tomassasovsky/segno-hardware/hardware/kicad/README.md

<!-- cspell:words Omron -->
# Board generators

<!-- cspell:words XHP SXH -->

SKiDL scripts that emit KiCad netlists. One per board:

| script | board |
|---|---|
| `ring_board.py` | encoder + LED ring + XIAO RP2350, behind the faceplate (4-way link, #987) |
| `console_board.py` | console v3.2 — Pico 2 on the Pi's GPIO (#747); v3 adds the 4-way ring link (#987) and the CTRL ring sense; v3.1 moves MODE from GP5 to GP12 (#1388); v3.2 adds a clamp and a 1 kΩ series resistor to every footswitch input (#1391) |

The ring carrier now uses **white solder mask and black silkscreen** for LED
reflections. See [ring order and assembly notes](RING_ASSEMBLY.md) for the
September 24 hole allowances, order settings and USB programming connection.

Current console CTRL headers J20/J21 connect T / R / S / **RN** to the
Neutrik NJ6FD-V jacks; pin 4 uses ring-normal, leaving tip-normal and
sleeve-normal open. This keeps the presence pull-down off the ADC tip.
R11/R12 use the console Pico's `+3V3_PICO` supply so the AUX-powered ring
UART remains biased high while the Pi is off. See the
[connector wiring](../segno_wiring.md).

## Console connection to the screen-power board

**Revision P** removes two obsolete ground-fill exclusions beside screen-board
mounting hole H1. It retains all routes, pads and placements and uses five-pin XH plugs for all four USB touch/data cable tails.
The fifth contact terminates each shield to PCB GND, so the whole cable
disconnects with one plug. The separate drain solder pads are removed, with
local placement changes for the longer headers. The Omron power relay,
replaceable 8 A input fuse, four soldered branch fuses, AUX-powered USB coils
and independent host detection remain. The board is still two layers and
68 × 76 mm. See the [screen design and wiring](screen_power/README.md).

Use the archives identified by the
[manufacturing record](https://github.com/tomassasovsky/segno/blob/claude/segno-integration/docs/reviews/pcb-finish-all-three-1072/manufacturing-zips.json)
and its matching review evidence. Console copper is unchanged. The white
ring board retains its tracks, pads, rear ground and full-white capacity;
two small dead-end front-ground fingers have been removed. No pre-PCB prototype or additional
owner measurement is required by this change.

Use **J25**, the two-pin through-hole JST XH connector beside the Pi ribbon
connector. It is already included in the console source, routed PCB and BOM
under #1072. The top-side label reads `SCREEN`; the pin map is documented below.
PD J23, RING J6, screen-control J25 and PI PWR J9 share the same horizontal
connector row. J9 sits immediately beside the Pi ribbon connector; it carries
the floating power-button pair, not a supply rail. PWR BTN J8 remains on the
rear-panel connector row.

| Console J25 | Screen-power J2 | Signal |
| --- | --- | --- |
| Pin 1 | Pin 1 | BCM GPIO17, from Pi ribbon J2 physical pin 11 |
| Pin 2 | Pin 2 | Ground |

The connector is JST **B2B-XH-A(LF)(SN)**, 2.50 mm pitch. Use one short
two-wire 22 AWG cable with an XHP-2 housing and two SXH-001T-P0.6 contacts at
each end. Check numbered pin continuity before connecting it; cable colors
and mirrored views do not establish polarity.

The existing Pi-to-console ribbon remains direct. The dedicated AUX buck
feeds screen-power J1 separately; no screen load passes through console J3
or J25. No extra USB or power connector is needed on the console for this
interface. See the [screen-board wiring](screen_power/README.md) and
[console connector verification](https://github.com/tomassasovsky/segno/blob/claude/segno-integration/docs/reviews/console-screen-connector-1072/verification.md).
The latest [placement verification](https://github.com/tomassasovsky/segno/blob/claude/segno-integration/docs/reviews/console-pi-power-placement-1072/verification.md)
covers the PI PWR move and retained PD alignment. The subsequent
[top-label verification](https://github.com/tomassasovsky/segno/blob/claude/segno-integration/docs/reviews/console-screen-label-1072/verification.md)
covers the `SCREEN` text change and current exports.

The screen planning load is **4.25 A shared**, including both main outputs,
both touch outputs. Add 60 mA for the bleeder and 150 mA for coils/control,
for a **4.46 A** screen-board input allowance. The old 6 A expansion allowance is
retired. The 3 A main and 500 mA touch lead ceilings are not additive or
simultaneous guarantees. The selected 35-pixel ring uses a separate direct
AUX branch and does not pass through console power copper or the screen-power relay. See the
[screen-board assessment](screen_power/README.md#circuit-and-limits).

The ring's power is budgeted for **40 LEDs at unrestricted full white**, five
more than the 35 fitted. Follow the
[ring assembly guide](RING_ASSEMBLY.md): console J6 pins 3/4 carry UART only,
with cavities 1/2 empty. Supply strip power and ring J1 pins 1/2 from separate
short pairs at the near-ring AUX split; ring J2 pin 3 carries DIN only, with
pins 1/2/4 unconnected. The budget is 2.4 A for LED channels, 40 mA idle and
200 mA for the ring controller. The retained console/carrier power routes do
not replace this harness's voltage-margin requirement. Genuine XH contacts
use 22 AWG pigtails; do not crimp the 16 AWG trunk into them.
Use one external strip, or one direct-mount 24/16-LED module. A second ring is
outside this budget. See the [JST rating](https://www.jst-mfg.com/product/pdf/eng/eXH.pdf).

## Running them

```bash
python3.12 -m venv .venv && ./.venv/bin/pip install -r requirements.txt
cd hardware/kicad && ./.venv/bin/python console_board.py
```

**Run from `hardware/kicad/`.** `generate_netlist()` writes `<script>.net` into the
current working directory, so running from the repo root silently drops the netlist
in the wrong place while reporting success.

The routing pipelines finish unlocked signal bends with `round_routes.py`
after setting trace widths and before refilling copper. It uses KiCad's native
pad and track geometry to preserve connections and clearance. Locked power
routes and the screen's paired USB traces are rounded by their own generators.
Run `test_round_routes.py` with KiCad's Python to exercise the native contact,
keepout, small-radius and repeat-run regression cases without changing a board.

## Two things that will mislead you

**A netlist diff is not a design change.** SKiDL assigns a *random* `SKiDL Tag` to
every `Part` without an explicit `tag=`, and component `tstamps` derive from it. Two
runs of the **same** version on unchanged source differ by ~190 lines — all tags,
timestamps and the tool version string, with **zero** net changes. Pinning skidl does
not fix this. Judge a run by `0 errors found while running ERC` and the `(net ...)`
blocks, not by `git diff`.

**Prefer upstream footprints.** `segno.pretty/` exists for parts KiCad does not ship
(the NeoPixel Ring 24, the Same Sky ACZ11BR1E-20FD1-20C encoder, the module mount-pad and wire-pad
helpers). It is not a place to re-draw something that already exists. The Pico 2, for instance, is KiCad's own
`Module:RaspberryPi_Pico_Common_THT` — its description explicitly says it supports
Pico 2, and it is maintained upstream.
