tomassasovsky/segno-hardware/hardware/kicad/screen_power/models/README.md

<!-- cspell:words Fuseholder IRLZ NPBF Omron Schurter -->
<!-- cspell:words EEUFR DPDT AXICOM dshapes -->
# Screen-power assembly models

Each populated footprint uses a project-relative STEP model. F1's model
combines the holder and removable cartridge; both are separately listed in
the purchasing BOM. M3 holes have no separate body.
Screws, mating plugs, wire bends and the enclosure are not included.

## Custom models

These eight models are generated by `model_geometry.py` with CadQuery 2.8.
They are simplified original assembly geometry under the repository's
CERN-OHL-S-2.0 licence, not manufacturer CAD. Dimensions are nominal unless marked
maximum. Use the linked drawings and the checked footprint dimensions for
mechanical qualification; a realistic preview does not prove insertion fit.

| File stem | Geometry represented | Source |
| --- | --- | --- |
| Relay_DPDT_AXICOM_IMSeries_Pitch5.08mm | 10 × 6 × 5.65 mm seated envelope; 0.25 mm standoff; eight 0.4 × 0.2 mm leads; 5.08 mm row spacing | [TE IM02TS, drawing 1462037-4](https://www.te.com/en/product-1-1462037-3.html) |
| Relay_Omron_G6C-1117P-US | Maximum 20 × 15 × 10 mm body; 0.3 mm standoff; 0.9 × 0.5 mm terminals with 3.5 mm projection | [Omron G6C](https://components.omron.com/us-en/system/files/2026-03/datasheet_pdf/K018-E1.pdf) |
| Fuseholder_Schurter_OGN_0031.8201 | 25 × 9.6 mm body; 10.8 mm installation width; 22.5 mm terminal pitch; holder plus cartridge reaches 11.5 mm above board | [Schurter OGN](https://www.schurter.com/en/datasheet/typ_ogn.pdf) and [SPT cartridge](https://www.schurter.com/pdf/english/typ_SPT_5x20.pdf) |
| Fuse_Bel_0697H_P5.08mm | Maximum 8.65 × 4.30 × 8.10 mm body; 5.08 mm pitch; maximum 0.70 mm leads | [Bel 0697H](https://www.belfuse.com/media/datasheets/products/circuit-protection/ds-cp-0697h-series.pdf) |
| JST_VH_B2P-VH_1x02_P3.96mm_Vertical | 7.86 × 8.5 × 10.9 mm header; 3.96 mm pitch | [JST VH](https://www.jst-mfg.com/product/pdf/eng/eVH.pdf) |
| Panasonic_EEUFR1A221 | Nominal diameter 6.3 × height 11.2 mm; 2.5 mm pitch; 0.5 mm leads | [Panasonic FR-A](https://industrial.panasonic.com/cdbs/www-data/pdf/RDF0000/ABA0000C1259.pdf) |
| Panasonic_EEUFR1A151 | Nominal diameter 5.0 × height 11.0 mm; 2.0 mm pitch; 0.5 mm leads | [Panasonic FR-A](https://industrial.panasonic.com/cdbs/www-data/pdf/RDF0000/ABA0000C1259.pdf) |
| Vishay_PR01_P10.16mm | Maximum 6.5 mm body, 8.0 mm coating extent, diameter 2.5 mm and 0.63 mm leads; 10.16 mm formed pitch; 0.5 mm standoff | [Vishay PR01](https://www.vishay.com/docs/28729/pr010203.pdf) |

The G6C model and footprint convert the manufacturer's bottom-view pin map
to KiCad top view. Pin 1 is coil negative, pin 8 coil positive, and 3/4 the
normally open contact. The orientation mark is on the pin 1/8 end. The OGN
footprint has only its two electrical terminal holes; no invented center
mounting hole is included. Reserve access above F1 for cartridge removal
with power disconnected. No optional protective cover is selected.

Panasonic models seat the body at the PCB surface, mark negative pin 2 and
show leads trimmed to 3 mm below the top surface. Fit checks must reserve
maximum 6.8 × 12.7 mm (C2) and 5.5 × 12.5 mm (C102/C202), including the
published +0.5 mm diameter and +1.5 mm length tolerances. Bel models use the
maximum body/lead envelope; their stock -02 leads require trimming.

R8's end coating uses the full 2.5 mm diameter as a conservative envelope.
Its separate body/coating solids and simplified lead bends do not represent
an exact manufacturer surface. Relay markings and connector latches are
likewise simplified. Models alone do not qualify plug engagement, latch
access, hand-solder access or worst-case component tolerances.

## KiCad models and attribution

Other STEP files are copied from the KiCad library. Their original headers
and available directory credits remain in `licenses/`. They use CC-BY-SA 4.0
with KiCad's library exception, reproduced in
[LIBRARY_LICENSE.txt](../LIBRARY_LICENSE.txt), except `C_Disc*`, whose header
grants GPL-3.0-or-later. They are not covered by the repository's licence; see
[THIRD_PARTY.md](../../../../THIRD_PARTY.md). Sources are the matching
[KiCad 3D libraries](https://gitlab.com/kicad/libraries/kicad-packages3D).

| File pattern | Upstream library |
| --- | --- |
| C_Disc* | Capacitor_THT.3dshapes |
| D_DO-* | Diode_THT.3dshapes |
| JST_XH* | Connector_JST.3dshapes |
| R_Axial* | Resistor_THT.3dshapes |
| TO-220*, TO-92* | Package_TO_SOT_THT.3dshapes |

Q5 uses a generic TO-220 preview and a project footprint checked against the
selected IRLZ44NPBF lead drawing. The ceramic capacitor preview uses the
selected 7.5 mm diameter / 4.4 mm thickness / 5 mm lead-pitch envelope.
Neither generic model replaces the exact part's insertion-hole review.
Removed charge-pump, optocoupler and film/bipolar capacitor models are not
part of Revision N.

`check.py` rejects missing, disabled, unresolved or incorrectly assigned
models. Native STEP export, populated renders and independent solid parsing
provide further verification. Model-assignment checks alone do not validate
STEP geometry or final enclosure fit.
