tomassasovsky/segno-hardware/hardware/pill_light_mask/simulator.html

# Eight-LED pill simulator

Compare breathing, steady light and off. The middle two LEDs share the peak; the ends taper down. Diffusion is a visual approximation, not a prediction of printed PLA brightness.

8 LEDs · 144/m 6.94 mm pitch · enlarged view

Breathing On Off Pause

Bare strip55.6 mm · relative levels (%)

Eight evenly spaced LEDs.

Through the diffuser60 × 6 mm window

A rounded diffuser blending eight light sources.

Breathing · all 8 LEDs Centre 0% · ends 0%

Peak brightness 75% Breathing cycle 2.4 s

Diffusion Medium Ends relative to centre 15%

LED color
