tomassasovsky/segno-hardware/hardware/enclosure/reference/als_1564/section_A.png

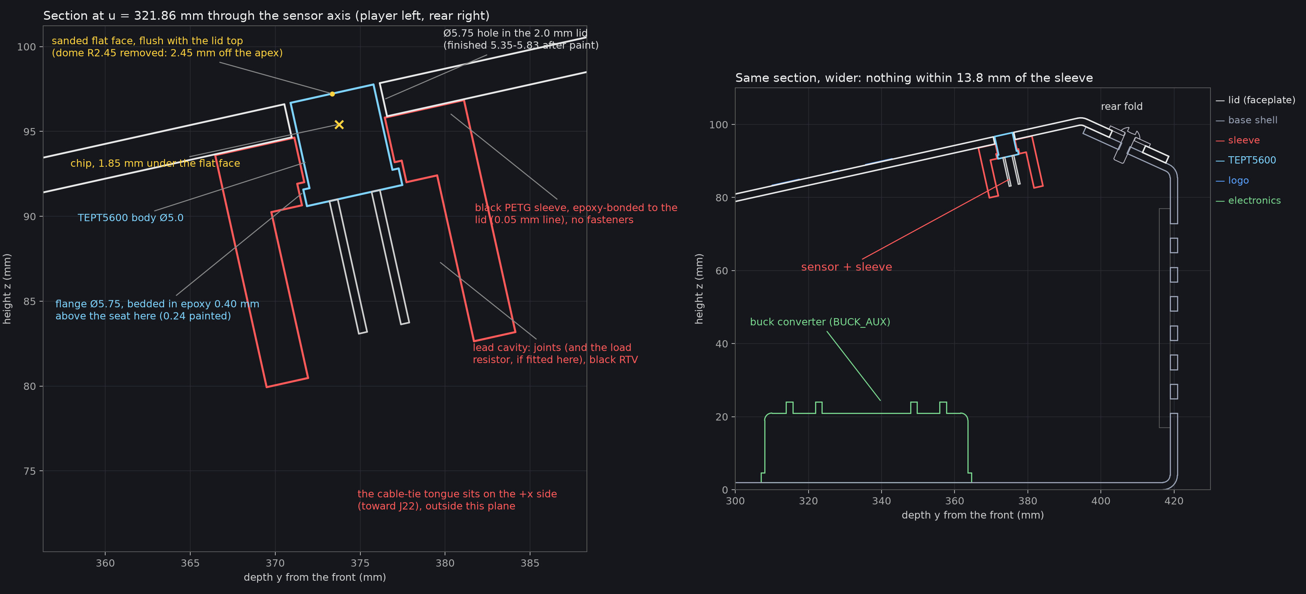
hardware/enclosure/reference/als_1564/section_A.png
