tomassasovsky/segno-hardware/hardware/enclosure/reference/als_1564/sleeve_alone.png

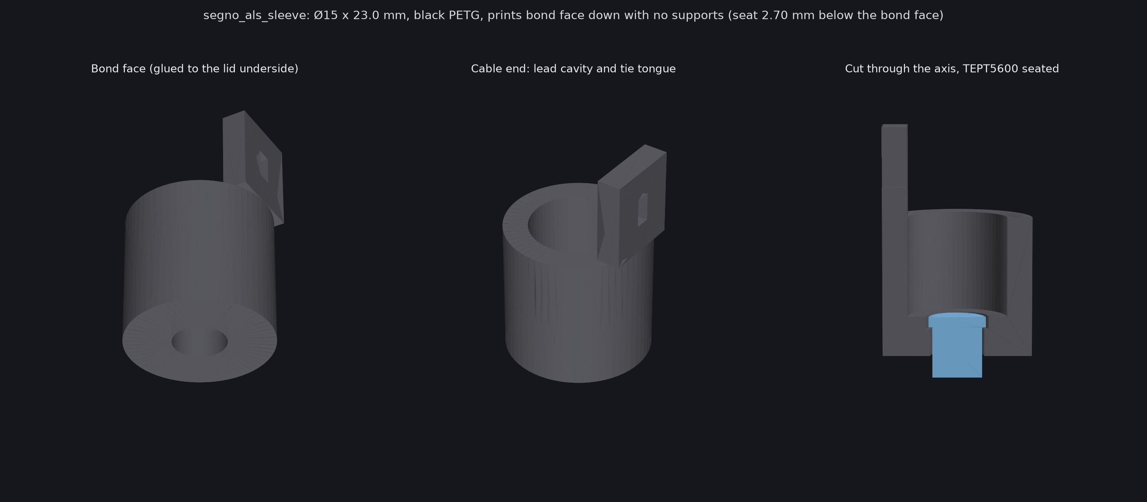
hardware/enclosure/reference/als_1564/sleeve_alone.png
