tomassasovsky/segno-hardware/hardware/enclosure/reference/als_1564/top_view_context.png

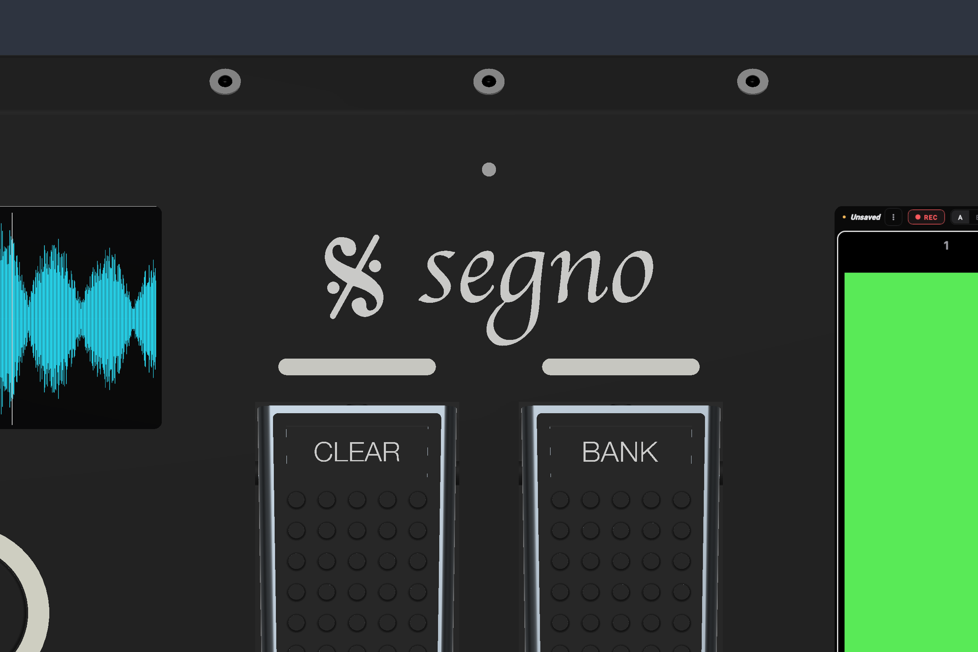
hardware/enclosure/reference/als_1564/top_view_context.png
