tomassasovsky/segno-hardware/hardware/enclosure/reference/buck_dimensions.png

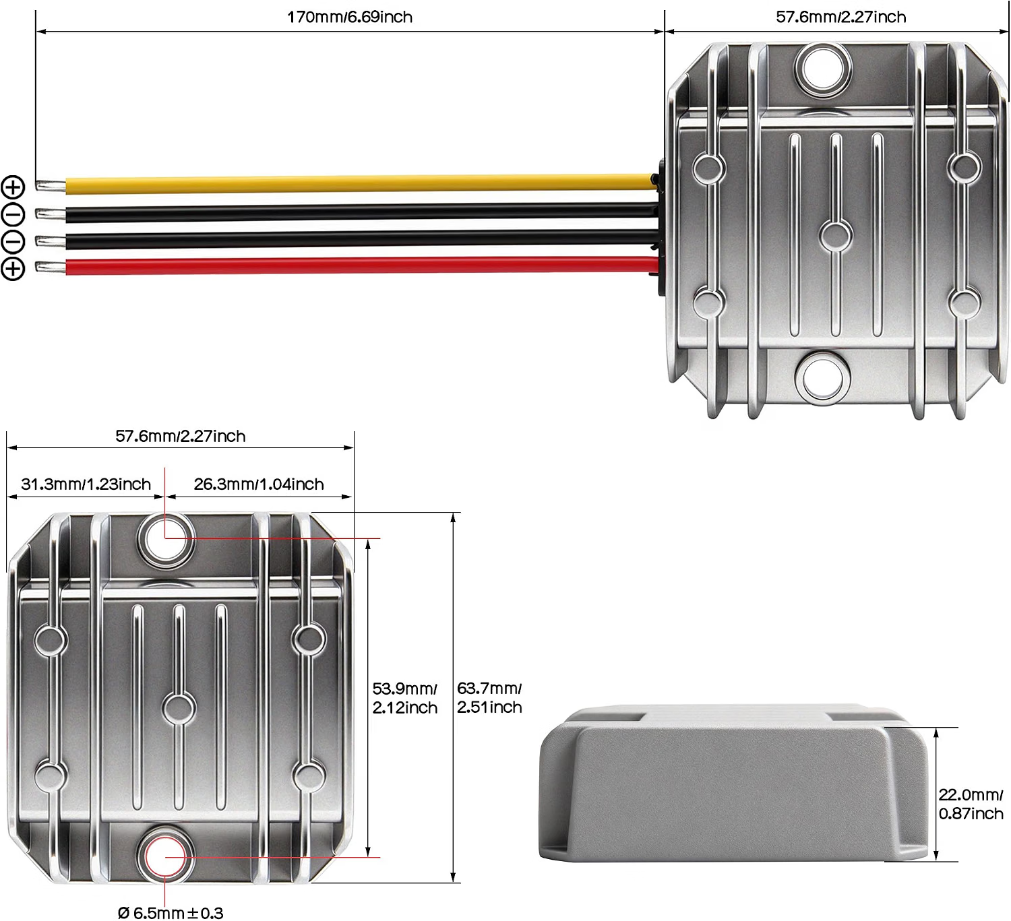
hardware/enclosure/reference/buck_dimensions.png
