tomassasovsky/segno-hardware/hardware/enclosure/reference/usb3_dimensions.png

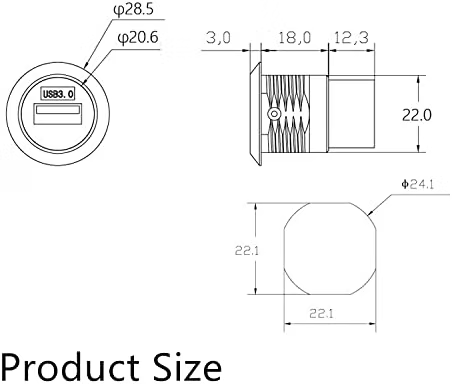
hardware/enclosure/reference/usb3_dimensions.png
