tomassasovsky/segno-hardware/hardware/led_strip/out/board_top.png

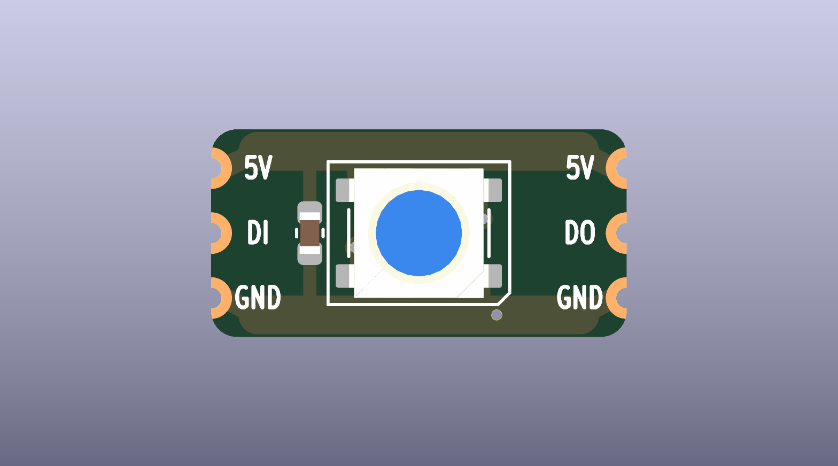
hardware/led_strip/out/board_top.png
