tomassasovsky/segno-hardware/hardware/enclosure/formed/segno_faceplate.step

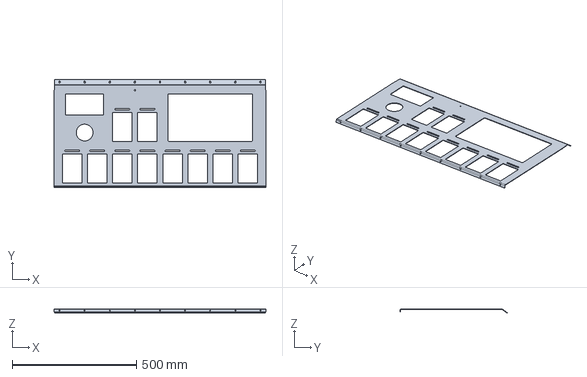
[picture p7: CAD file, 2026-11-03]
hardware/enclosure/formed/segno_faceplate.step
853.8 x 433.3 x 17.2 mm
