tomassasovsky/segno-hardware/hardware/enclosure/out/segno_post.dxf

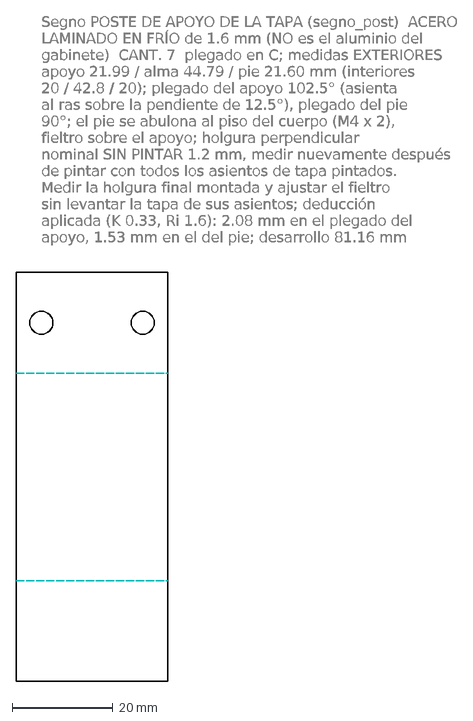
[picture p8: CAD file, 2026-09-10]
hardware/enclosure/out/segno_post.dxf
Segno POSTE DE APOYO DE LA TAPA (segno_post) ACERO
LAMINADO EN FRÍO de 1.6 mm (NO es el aluminio del
gabinete) CANT. 7 plegado en C; medidas EXTERIORES
apoyo 21.99 / alma 44.79 / pie 21.60 mm (interiores
20 / 42.8 / 20); plegado del apoyo 102.5° (asienta
al ras sobre la pendiente de 12.5°), plegado del pie
90°; el pie se abulona al piso del cuerpo (M4 x 2),
fieltro sobre el apoyo; holgura perpendicular
nominal SIN PINTAR 1.2 mm, medir nuevamente después
de pintar con todos los asientos de tapa pintados.
Medir la holgura final montada y ajustar el fieltro
sin levantar la tapa de sus asientos; deducción
aplicada (K 0.33, Ri 1.6): 2.08 mm en el plegado del
apoyo, 1.53 mm en el del pie; desarrollo 81.16 mm
