tomassasovsky/segno-hardware/hardware/enclosure/ref/screen7_module_measured.step

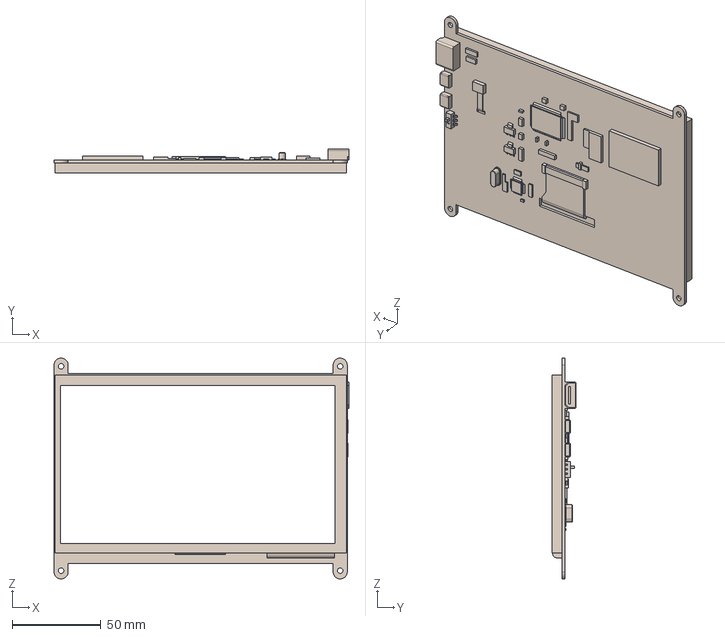
[picture p9: CAD file, 2026-08-20]
hardware/enclosure/ref/screen7_module_measured.step
166.1 x 13.7 x 124.3 mm
