tomassasovsky/segno-hardware/hardware/kicad/out_console/segno_console_board.step

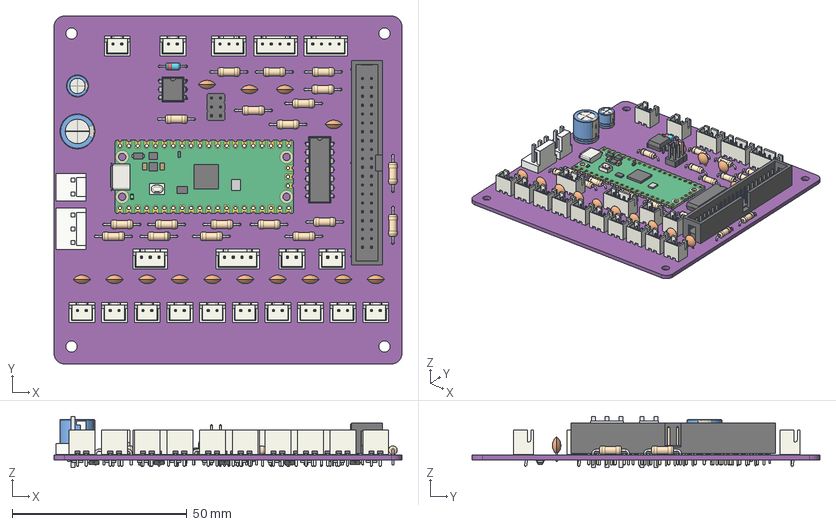
[picture p10: CAD file, 2026-10-26]
hardware/kicad/out_console/segno_console_board.step
99.5 x 99.5 x 14.6 mm
JST_B2B_XH_A x 14
R_Axial_DIN0207_L63mm_D25mm_P1016mm_Horizontal x 19
C_Disc_D50mm_W25mm_P250mm x 14
CP_Radial_D63mm_P250mm
IDC_Header_2x20_P254mm_Vertical
RaspberryPi_Pico_Module_KiCad
JST_B3B_XH_A x 2
JST_B4B_XH_A x 3
DIP-14_W7.62mm
DIP-6_W7.62mm
D_DO-35_SOD27_P7.62mm_Horizontal
PinHeader_2x03_P254mm_Vertical
CP_Radial_D100mm_P500mm
housing x 2
posts x 2
R_1206_3216Metric x 10
SOT-23 x 5
segno_console_board_PCB
