tomassasovsky/segno-hardware/hardware/kicad/out_ring/segno_ring_board.step

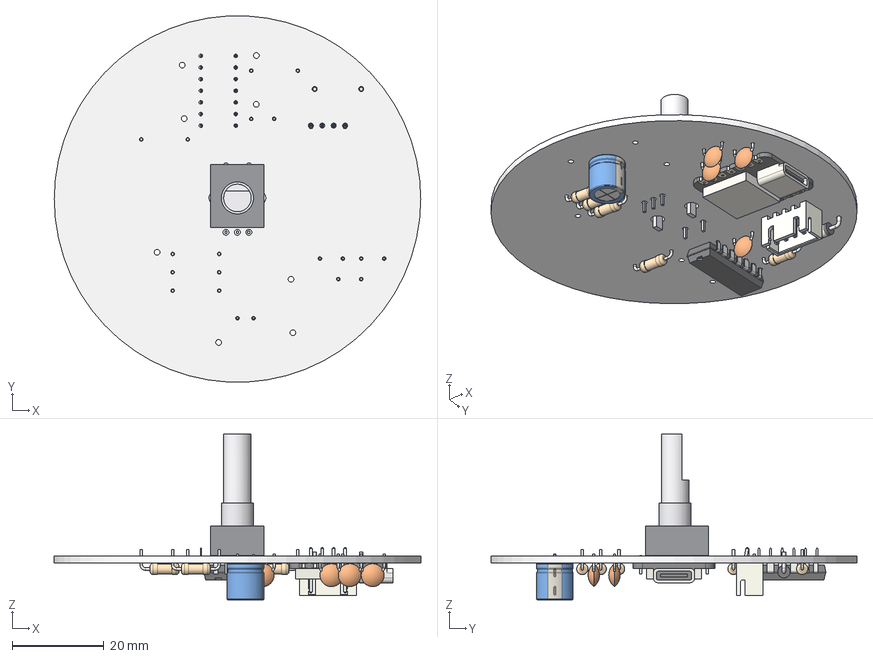
[picture p11: CAD file, 2026-10-20]
hardware/kicad/out_ring/segno_ring_board.step
80.0 x 79.9 x 36.2 mm
body_envelope
M7_bushing_envelope
D_shaft
A
C
B
S1
S2
MP1
MP2
C_Disc_D50mm_W25mm_P500mm x 4
R_Axial_DIN0207_L63mm_D25mm_P1016mm_Horizontal x 5
DIP-14_W7.62mm
CP_Radial_D80mm_P350mm
Seeeduino Xiao v1
JST_B4B_XH_A
D_DO-41_SOD81_P10.16mm_Horizontal
segno_pedal_ring_PCB
