tomassasovsky/segno-hardware/hardware/kicad/screen_power/models/Relay_Omron_G6C-1117P-US.step

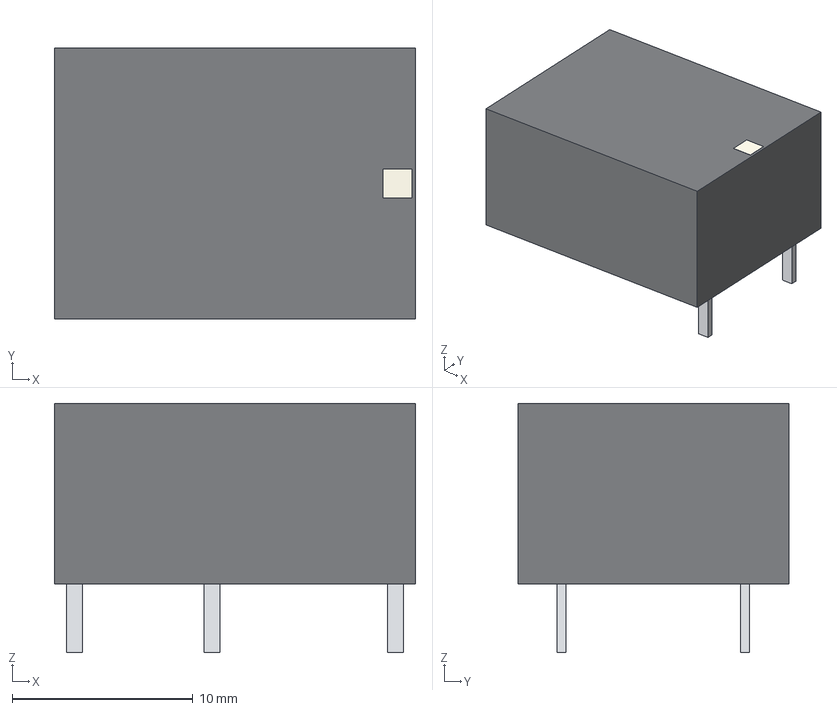
[picture p12: CAD file, 2026-10-20]
hardware/kicad/screen_power/models/Relay_Omron_G6C-1117P-US.step
20.0 x 15.0 x 13.8 mm
orientation_mark
terminal_coil_minus_1
terminal_coil_plus_8
terminal_contact_3
terminal_contact_4
