tomassasovsky/segno-hardware/hardware/pill_light_mask/reference/platform_front.step

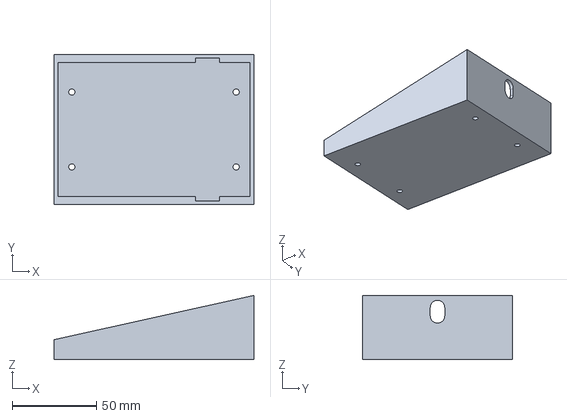
[picture p13: CAD file, 2026-10-20]
hardware/pill_light_mask/reference/platform_front.step
118.5 x 88.8 x 38.0 mm
