tomassasovsky/segno-hardware/hardware/switch_mount/switch_platform.step

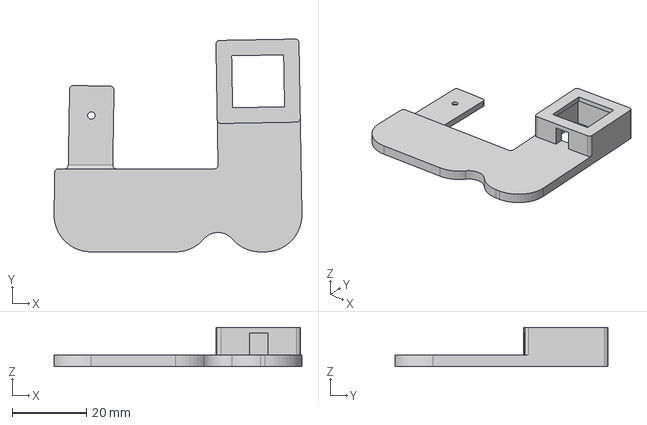
[picture p14: CAD file, 2026-08-21]
hardware/switch_mount/switch_platform.step
66.8 x 57.4 x 10.6 mm
