tomassasovsky/segno-hardware/hardware/enclosure/formed/segno_faceplate_flat.dxf

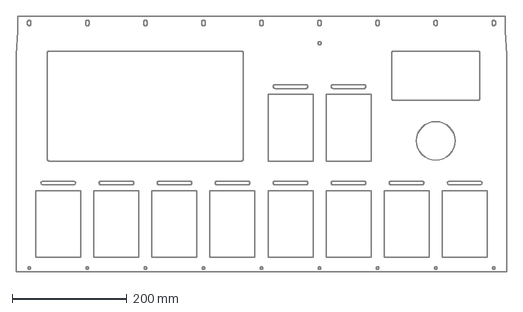
[picture p15: CAD file, 2026-11-03]
hardware/enclosure/formed/segno_faceplate_flat.dxf
853.8 x 445.2 mm
