tomassasovsky/segno-hardware/hardware/kicad/screen_power/models/Fuse_Bel_0697H_P5.08mm.step

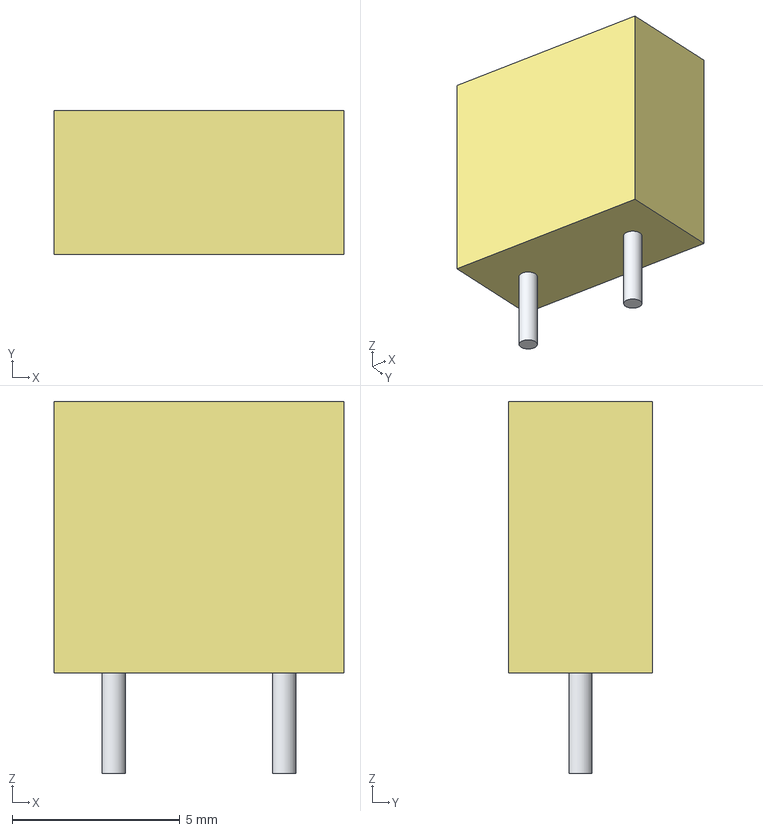
[picture p16: CAD file, 2026-10-20]
hardware/kicad/screen_power/models/Fuse_Bel_0697H_P5.08mm.step
8.65 x 4.30 x 11.1 mm
lead_0
lead_1
