tomassasovsky/segno-hardware/hardware/pill_light_mask/reference/platform_mid.step

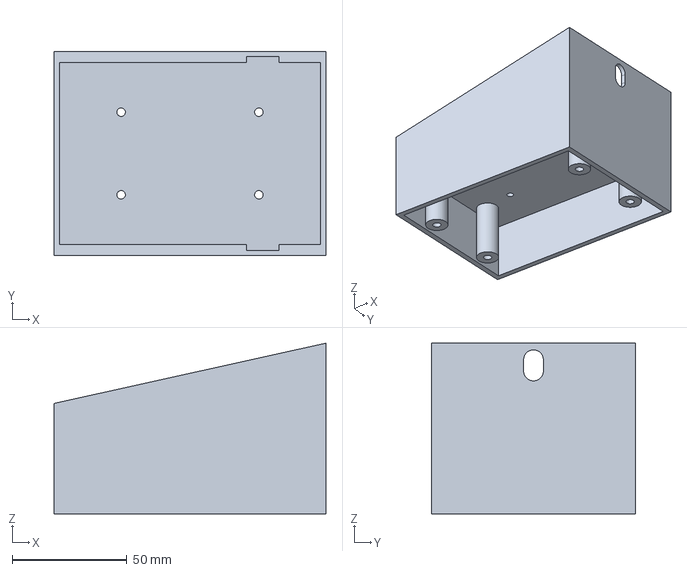
[picture p17: CAD file, 2026-10-20]
hardware/pill_light_mask/reference/platform_mid.step
118.5 x 88.8 x 74.3 mm
