tomassasovsky/segno-hardware/hardware/enclosure/formed/segno_base_flat.dxf

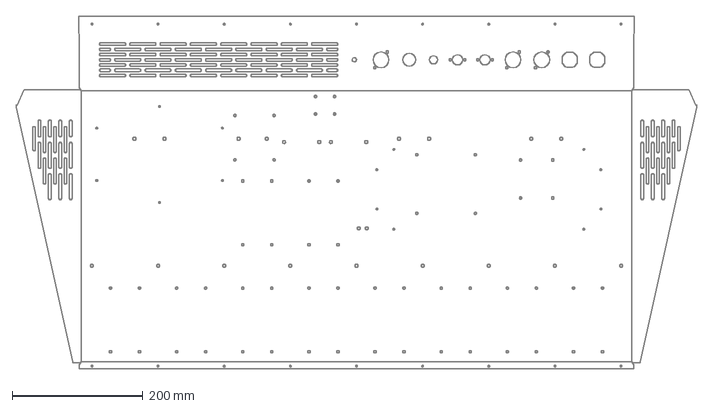
[picture p18: CAD file, 2026-10-08]
hardware/enclosure/formed/segno_base_flat.dxf
1041.3 x 538.6 mm
