tomassasovsky/segno-hardware/hardware/enclosure/out/segno_overlay.dxf

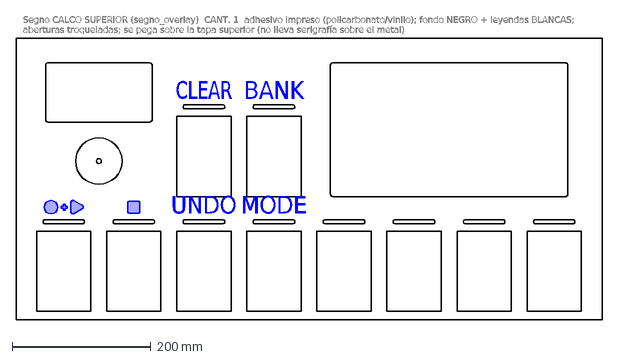
[picture p19: CAD file, 2026-09-04]
hardware/enclosure/out/segno_overlay.dxf
UNDO
MODE
CLEAR
BANK
Segno CALCO SUPERIOR (segno_overlay) CANT. 1 adhesivo impreso (policarbonato/vinilo); fondo NEGRO + leyendas BLANCAS;
aberturas troqueladas; se pega sobre la tapa superior (no lleva serigrafía sobre el metal)
