tomassasovsky/segno-hardware/hardware/kicad/screen_power/models/C_Disc_D7.5mm_W4.4mm_P5.00mm.step

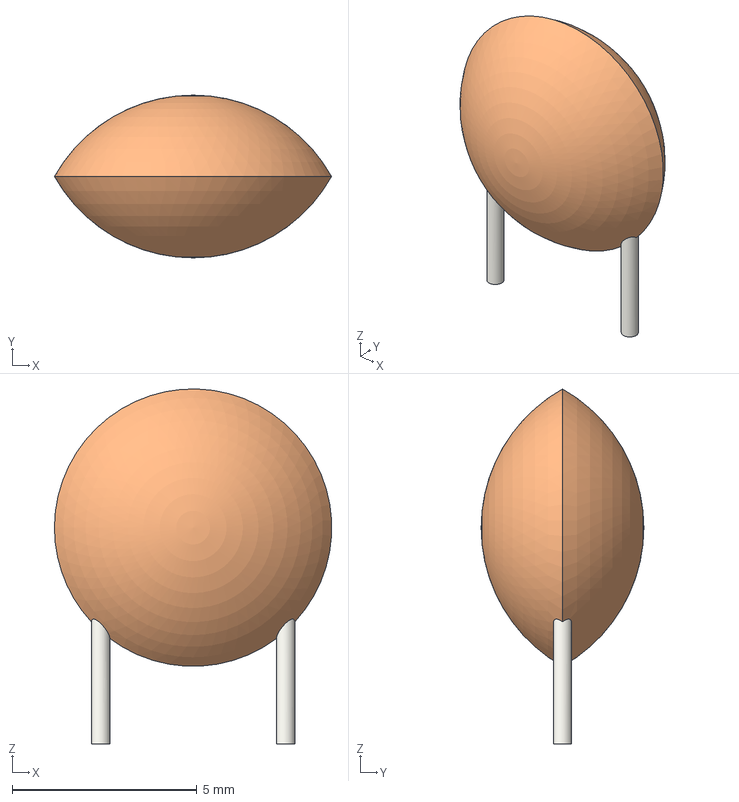
[picture p20: CAD file, 2026-10-20]
hardware/kicad/screen_power/models/C_Disc_D7.5mm_W4.4mm_P5.00mm.step
7.49 x 4.40 x 9.60 mm
