tomassasovsky/segno-hardware/hardware/enclosure/formed/segno_base.step

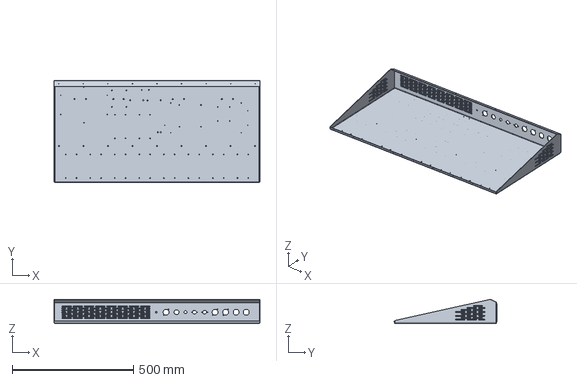
[picture p21: CAD file, 2026-10-08]
hardware/enclosure/formed/segno_base.step
849.8 x 422.8 x 99.5 mm
