tomassasovsky/segno-hardware/hardware/kicad/screen_power/models/TO-220-3_Vertical.step

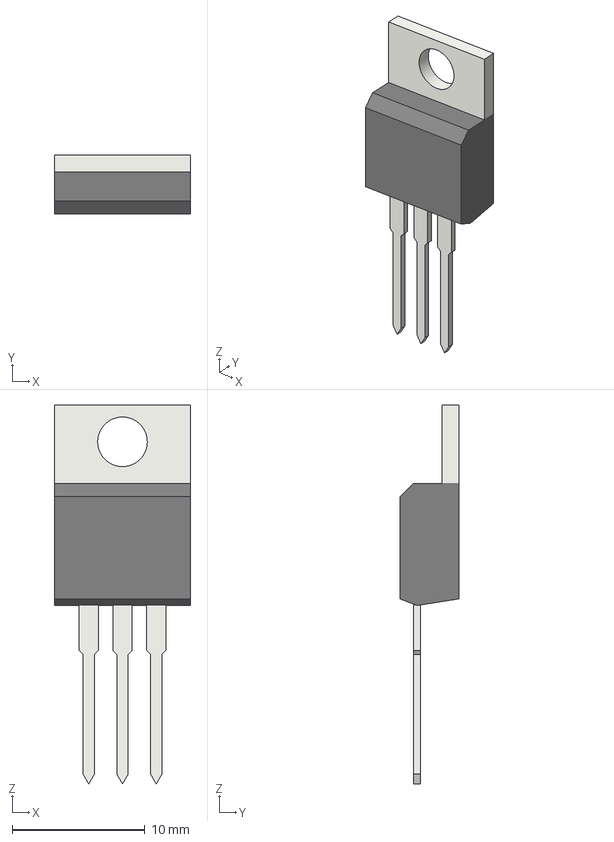
[picture p22: CAD file, 2026-10-20]
hardware/kicad/screen_power/models/TO-220-3_Vertical.step
10.2 x 4.46 x 28.5 mm
