tomassasovsky/segno-hardware/hardware/kicad/screen_power/models/Fuseholder_Schurter_OGN_0031.8201.step

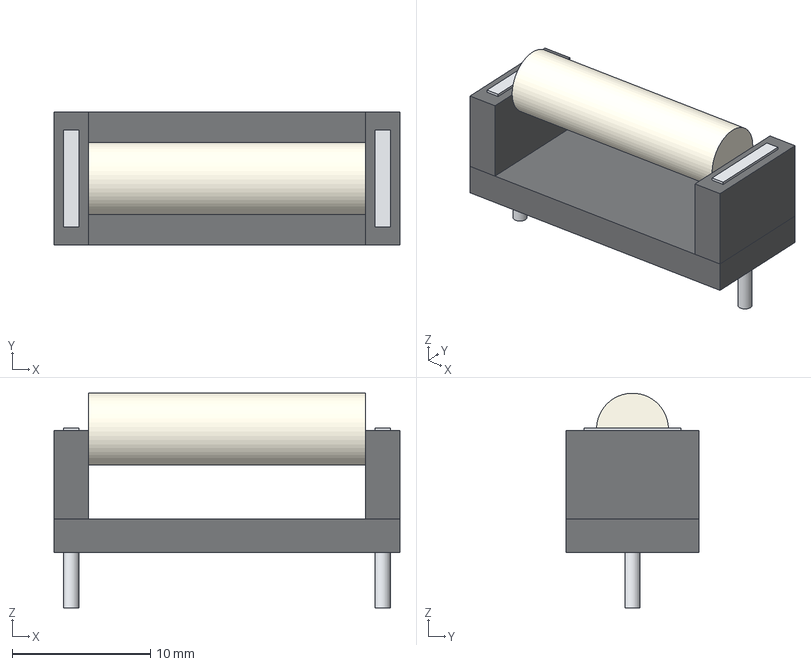
[picture p23: CAD file, 2026-10-20]
hardware/kicad/screen_power/models/Fuseholder_Schurter_OGN_0031.8201.step
25.0 x 9.60 x 15.5 mm
base
end_wall_0
contact_0
lead_0
end_wall_1
contact_1
lead_1
cartridge_body
cartridge_cap_0
cartridge_cap_1
