tomassasovsky/segno-hardware/hardware/kicad/screen_power/models/D_DO-15_P10.16mm_Horizontal.step

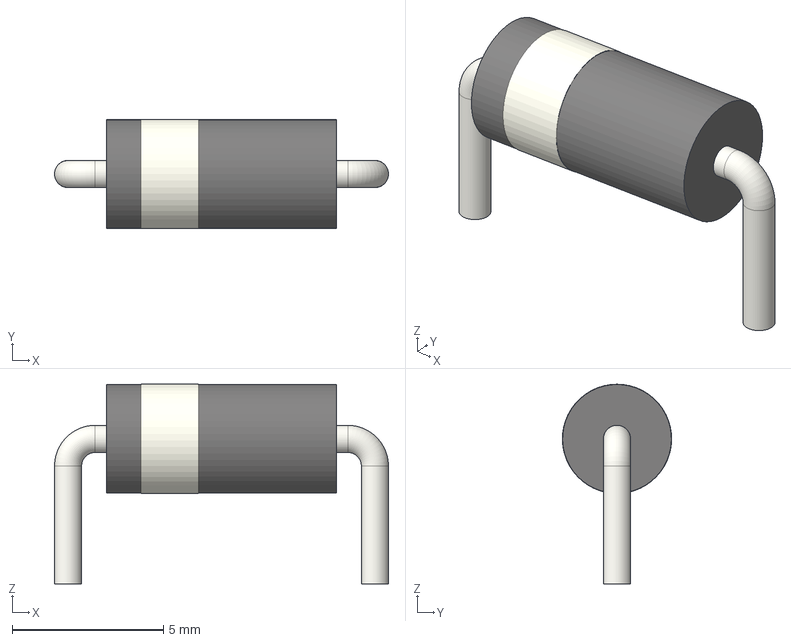
[picture p24: CAD file, 2026-10-20]
hardware/kicad/screen_power/models/D_DO-15_P10.16mm_Horizontal.step
11.1 x 3.62 x 6.61 mm
