tomassasovsky/segno-hardware/hardware/kicad/screen_power/models/TO-92_Inline_Wide.step

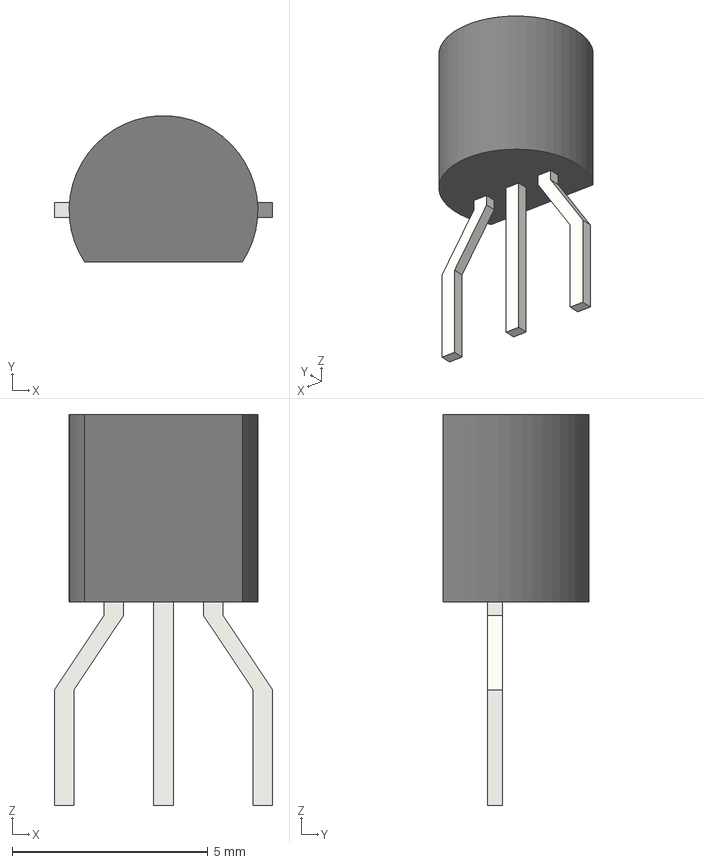
[picture p25: CAD file, 2026-10-20]
hardware/kicad/screen_power/models/TO-92_Inline_Wide.step
5.58 x 3.74 x 10.0 mm
