tomassasovsky/segno-hardware/hardware/kicad/screen_power/models/D_DO-41_SOD81_P10.16mm_Horizontal.step

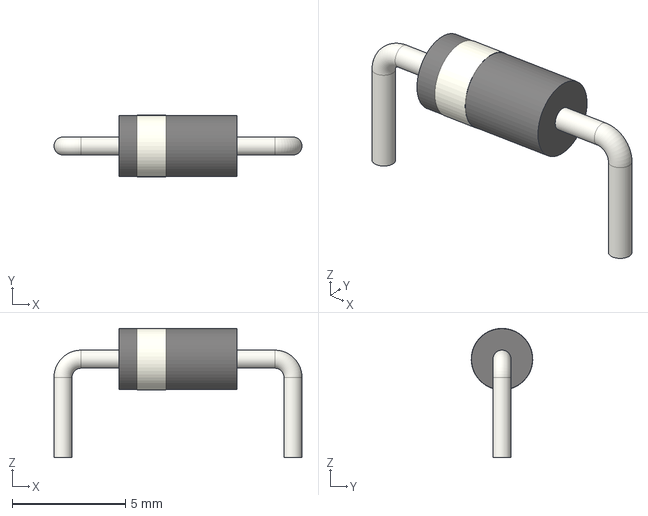
[picture p26: CAD file, 2026-10-20]
hardware/kicad/screen_power/models/D_DO-41_SOD81_P10.16mm_Horizontal.step
11.0 x 2.72 x 5.71 mm
