tomassasovsky/segno-hardware/hardware/kicad/screen_power/models/Vishay_PR01_P10.16mm.step

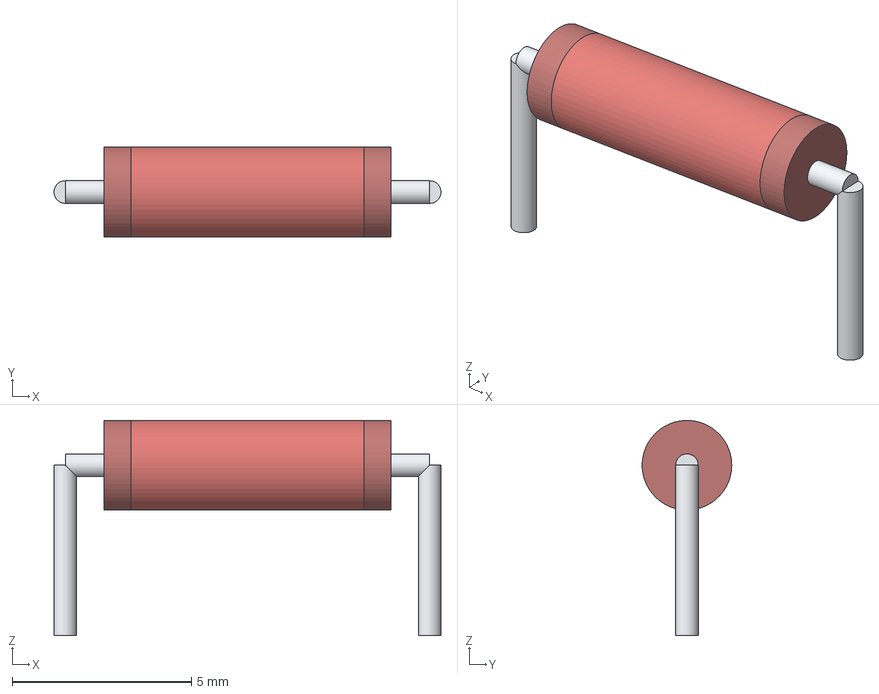
[picture p27: CAD file, 2026-10-20]
hardware/kicad/screen_power/models/Vishay_PR01_P10.16mm.step
10.8 x 2.50 x 6.00 mm
coating_left
main_body
coating_right
wire_0
wire_1
lead_0
lead_1
