tomassasovsky/segno-hardware/hardware/kicad/screen_power/models/JST_XH_B5B-XH-A_1x05_P2.50mm_Vertical.step

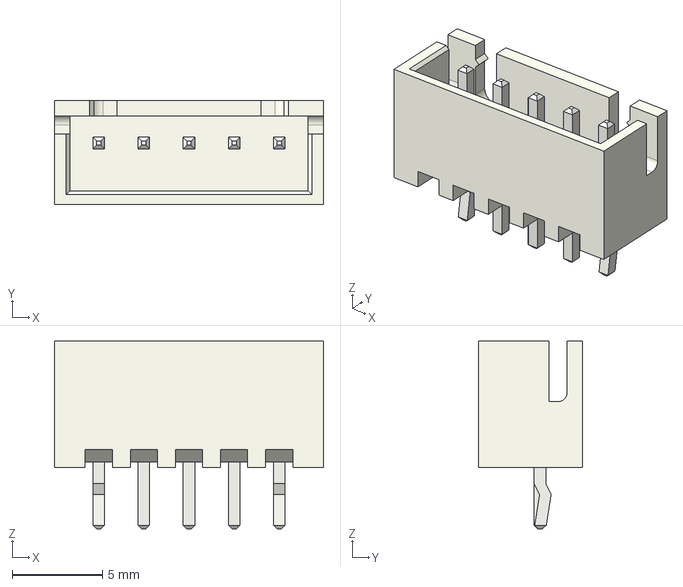
[picture p28: CAD file, 2026-10-20]
hardware/kicad/screen_power/models/JST_XH_B5B-XH-A_1x05_P2.50mm_Vertical.step
14.9 x 5.75 x 10.4 mm
