tomassasovsky/segno-hardware/hardware/kicad/screen_power/models/Relay_DPDT_AXICOM_IMSeries_Pitch5.08mm.step

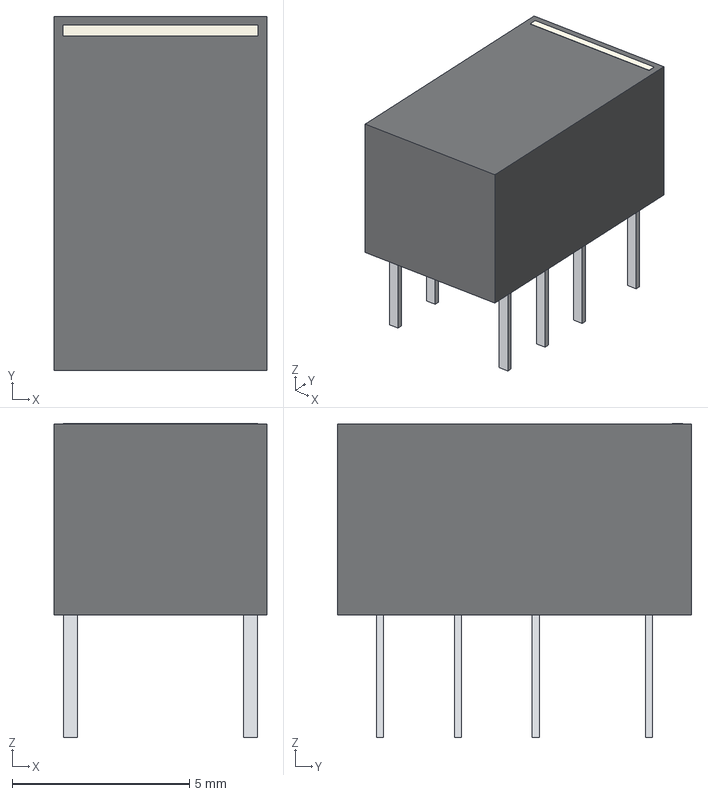
[picture p29: CAD file, 2026-10-20]
hardware/kicad/screen_power/models/Relay_DPDT_AXICOM_IMSeries_Pitch5.08mm.step
6.00 x 10.0 x 8.86 mm
direction_mark
pin_0_0
pin_0_1
pin_0_2
pin_0_3
pin_1_0
pin_1_1
pin_1_2
pin_1_3
