tomassasovsky/segno-hardware/hardware/kicad/screen_power/models/Panasonic_EEUFR1A151.step

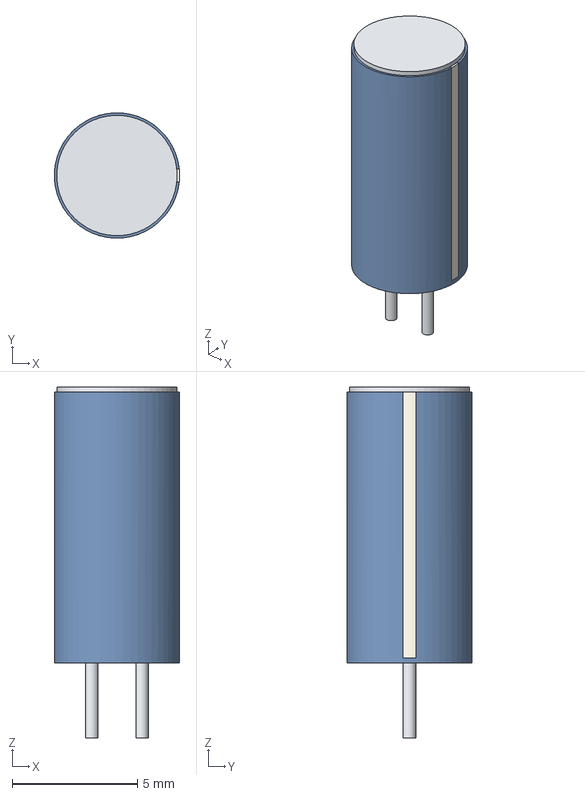
[picture p30: CAD file, 2026-10-20]
hardware/kicad/screen_power/models/Panasonic_EEUFR1A151.step
5.00 x 5.00 x 14.0 mm
sleeve
negative_stripe
top
lead_0
lead_1
