tomassasovsky/segno-hardware/hardware/kicad/screen_power/models/R_Axial_DIN0207_L6.3mm_D2.5mm_P10.16mm_Horizontal.step

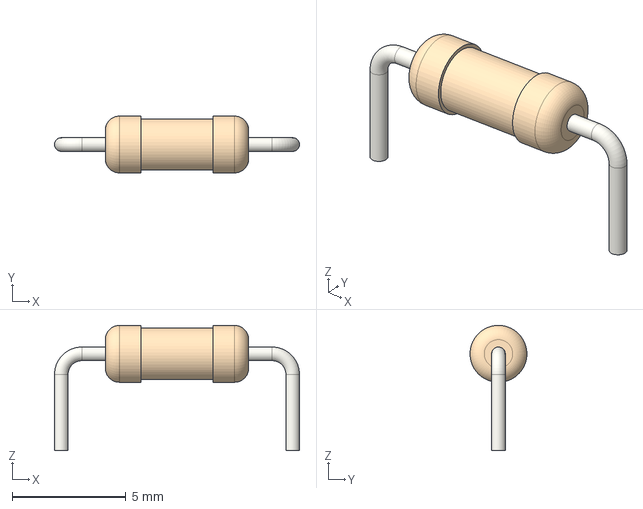
[picture p31: CAD file, 2026-10-20]
hardware/kicad/screen_power/models/R_Axial_DIN0207_L6.3mm_D2.5mm_P10.16mm_Horizontal.step
10.8 x 2.50 x 5.50 mm
