tomassasovsky/segno-hardware/hardware/kicad/screen_power/models/JST_VH_B2P-VH_1x02_P3.96mm_Vertical.step

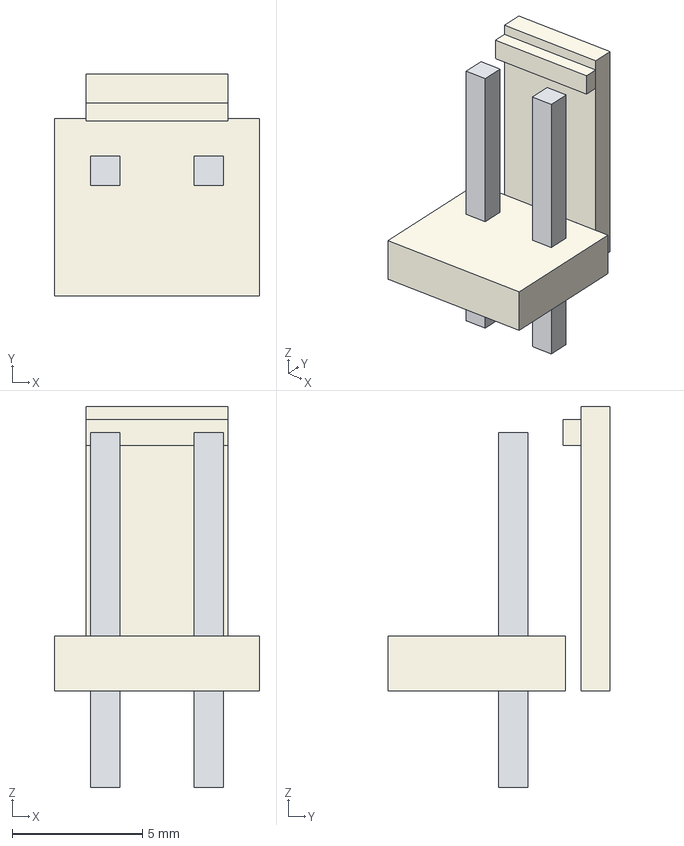
[picture p32: CAD file, 2026-10-20]
hardware/kicad/screen_power/models/JST_VH_B2P-VH_1x02_P3.96mm_Vertical.step
7.86 x 8.50 x 14.6 mm
base
latch
latch_lip
pin_0
pin_1
