tomassasovsky/segno-hardware/hardware/kicad/screen_power/models/Panasonic_EEUFR1A221.step

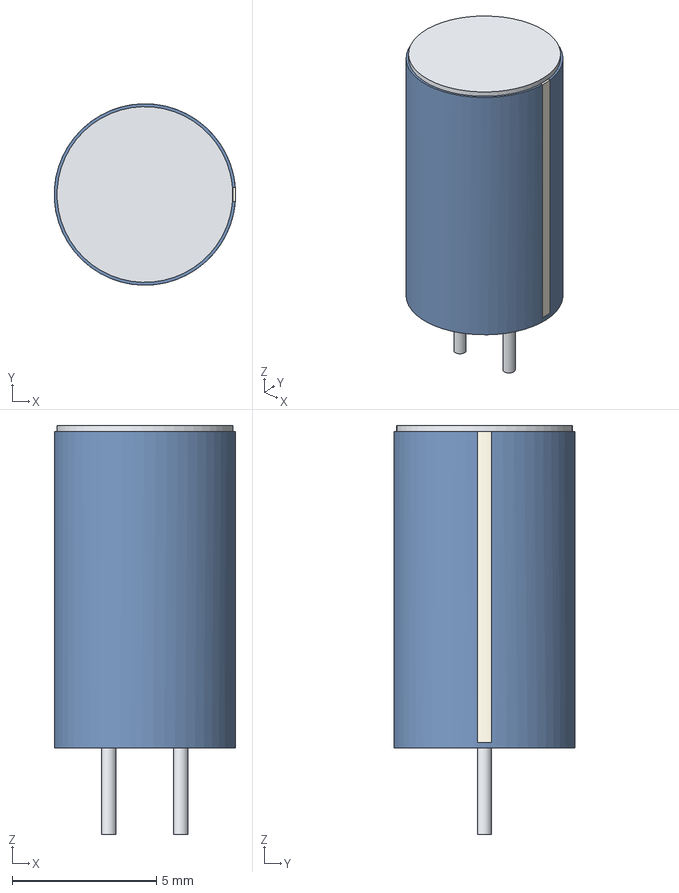
[picture p33: CAD file, 2026-10-20]
hardware/kicad/screen_power/models/Panasonic_EEUFR1A221.step
6.29 x 6.30 x 14.2 mm
sleeve
negative_stripe
top
lead_0
lead_1
