tomassasovsky/segno-hardware/hardware/kicad/screen_power/models/JST_XH_B2B-XH-A_1x02_P2.50mm_Vertical.step

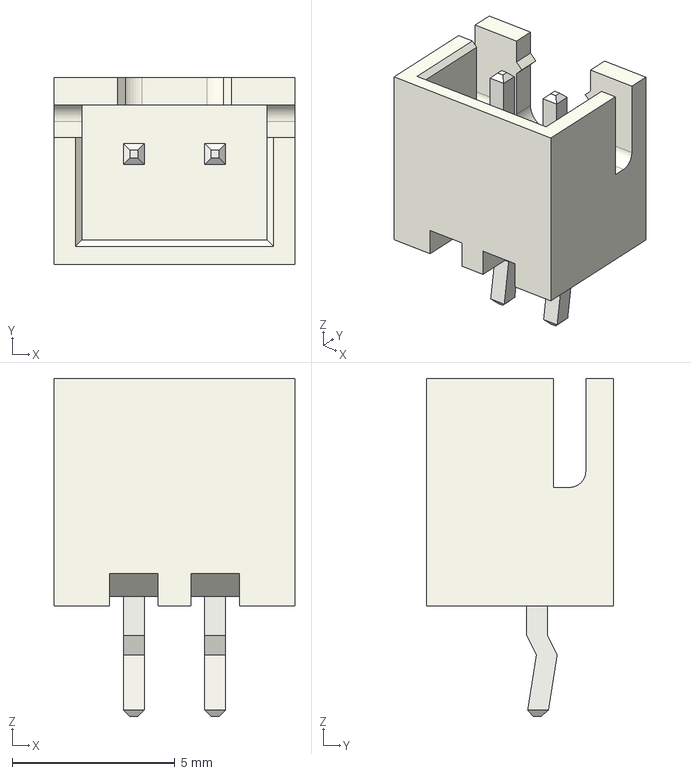
[picture p34: CAD file, 2026-10-20]
hardware/kicad/screen_power/models/JST_XH_B2B-XH-A_1x02_P2.50mm_Vertical.step
7.40 x 5.75 x 10.4 mm
