tomassasovsky/segno-hardware/(list of files, cad)

Other CAD files:
hardware/enclosure/fusion/Segno_console_populated.f3d
hardware/enclosure/out/segno_lid_washer_reference.step
hardware/switch_mount/switch_platform.stl
