tomassasovsky/segno-hardware/hardware/segno_wiring.md

<!-- cspell:words Qwiic VREG EEUFR Schurter -->
<!-- cspell:words fanout -->
<!-- cspell:words derating unswitched Reterminate Littelfuse PXCN FHAC -->
# Segno console — system wiring plan

How the console's subsystems connect: the **console board v3** (Pico 2 / RP2350,
`hardware/kicad/console_board.py`, #747), the **ring board** (`segno_pedal_ring`),
the **Raspberry Pi 5**, the two touchscreens, the external audio interface,
power (#754), and the rear panel.

The console is the only product. It stopped sharing a board with the retired
standalone pedal when #747 gave it a board of its own, so the constraint this file
used to open with ("the main board is in production — it is NOT modified") no
longer applies to anything.

---

## 1. Block diagram

```
   POWER (#754)
     USB-C PD inlet -- rear panel, D punch, QIANRENON coupler (all 24 ways wired)
              |   STUSB4500 trigger: ONE 20 V contract, at the source's full current (3-5 A)
              |   fuse, T5A slow-blow, in series with the 20 V feed
              +--> BUCK_PI  (20->5 V) --> Pi 5 via its USB-C  --> Pi USB + NVMe
              +--> BUCK_AUX (20->5 V) --+--> console J3 --> pills
                                       +--> near-ring split --> strip power + ring J1 power
                                       +--> short 16 AWG pair --> screen-power J1
                                                                  | F1 (8 A) -> K1 -> switched rail
                                                                  +--> J103/J203 --> screen power
                                                                  +--> J102/J202 --> touch VBUS

   DATA / CONTROL
     console board <---- keyed 2x20 ribbon, ~10 cm ----> Pi 40-pin header
        link  Pico uart0 (GP16/17) <-> Pi uart3 (GPIO8/9), TX 10k / RX 6.8k
        MIDI  DIN IN -> H11L1 (at 3V3) -> Pi uart0 RX (GPIO15)
              Pi uart0 TX (GPIO14) -> 74AHCT125 -> 220R loop -> DIN OUT
        SWD   Pi GPIO24/25 -> the Pico's debug pads (cold flashing)
     console board <-- footswitches x10 | ring board (two UART wires) | CTRL TRS x2
     Pi --HDMI x2--> 7" + 15.6" screens
     Pi USB2 x2 --> screen J101/J201 --> relays --> J102/J202 --> screen touch
     Pi GPIO17 --> ribbon --> console J25 --> screen J2 (GPIO17 + GND)
     Pi's other 2 USB --> internal leads to the rear USB couplers
                          (the audio interface plugs in there, outside the box)
     power button --J8 -> board -> J9 flying lead--> the Pi 5's own J2 pads
                          (PMIC wake -- no GPIO can wake a Pi 5)

   GND: single common ground -- the scheme, the earth-stud rules and the bench
        audit are Section 6's
```

---

## 2. Power distribution (#754)

**20 V in, 5 V made next to the loads.** Local bucks keep the high-current
5 V wiring short. The current design allowances total **64.09 W** at their
outputs: 25 W for the Pi rail and 39.09 W for AUX. At an illustrative 85–90%
buck efficiency, that needs approximately **71.2–75.4 W**, or **3.56–3.77 A at
20 V**. These efficiencies are planning assumptions, not measurements of the
retained bucks. The 20 V / 5 A / 100 W contract accommodates this model; it
does not establish enclosed thermal capacity or startup response.

Normal screen-board operation is assessed at **4.75–5.25 V at J1**, before
onboard F1 and its holder, including warm relay pickup. Revision N uses a
power relay and a low-side coil driver; it has no negative gate supply. Use
the existing nominal 5 V buck. This input envelope is a coil-drive condition,
not a guarantee of minimum voltage at either screen. Keep screen leads short
and within the documented wire and connector ratings. The
[relay-drive and startup assessments](kicad/screen_power/README.md#circuit-and-limits)
state the remaining engineering assumptions.

- **Inlet:** panel-mount USB-C coupler on a D punch (QIANRENON B0CQ4VD2N2,
  100 W, 10 Gbps). The 10 Gbps matters only because it means **all 24 ways are
  wired**, so CC reaches the trigger and PD can negotiate — a charge-only
  coupler drops CC and nothing powers up.
- **Trigger:** SparkFun STUSB4500 board, programmed by the console board over
  J23 (`firmware/console_board/pd_trigger.c`, #1352) with two 20 V PDOs, 5 A
  and 3 A, and `REQ_SRC_CURRENT` set: it takes 20 V
  from any source that offers at least 3 A there, and requests all the current
  the source offers at 20 V rather than the matched PDO's own. Without that bit
  a 20 V / 4.7 A brick misses the 5 A PDO, matches the 3 A one, and contracts
  only 3 A (60 W, against the console's ~59 W worst case; measured on the bench
  unit, 2026-10-17). Its shipped default asks 20 V at only 1.0 A (20 W). The
  console board writes the profile at its first boot and the app asks for one
  unplug, after which every power-up negotiates the full current. A trigger
  left unusable (power cut during that write) no longer powers the console;
  reprogram it out of band with `hardware/console/stusb4500_pdo` from an
  Arduino UNO over Qwiic.
- **What did it actually get?** The chip is I2C-readable: its RDO
  (`0x91`–`0x94`) carries the requested operating current, the source's maximum
  and the source PDO it matched, plus a capability mismatch bit; `0x21` holds
  the negotiated voltage in 100 mV steps. Mismatch is set only when no sink PDO
  is met, so on its own it does not flag a short grant: read the operating
  current. A 65 W brick gives 20 V / 3.25 A: everything boots, and the console
  browns out only when 26 WS2812s go white under two lit screens. Console board **v3** has a 3-way
  JST-XH for it, **J23 `PD`** (GND, SDA, SCL on the Pico's GP0/GP1, I2C0),
  under the module's left end next to `5V IN`. Three wires on purpose: leave the
  trigger's external VDD and Qwiic VCC unconnected. Its 2.2 kΩ I2C pull-ups use
  the low-voltage VDD net fed from VREG_2V7 through D4/BAT60A, as shown in the
  [SparkFun schematic](https://cdn.sparkfun.com/assets/9/2/6/8/6/SparkFun_PowerDeliveryBoardSchematic.pdf),
  separate from VIN/VBUS and the STUSB4500 chip's VDD pin. The console's 3V3 is
  downstream of the contract being measured, so it must not feed the trigger. ~250 mm unshielded past two bucks: 100 kHz,
  twisted with the ground wire. On a v2 board the same read works from J22's
  GP20/GP21 (I2C0) unless those pads carry the CTRL ring wires. Console
  firmware 2.3 reads it once a second and reports it up the pedal link
  (`PD_STATUS`); the Controller firmware page shows the contract.
- **Fuse:** 5×20 **T5A slow-blow** in the 20 V feed, ahead of both bucks.
  The revised planning load is approximately 3.6–3.8 A at 20 V before startup
  transients; the PD contract ceiling is 5 A. The exact fuse/holder and its
  ambient derating must support that duty. This existing fuse choice has no
  documented part-specific coordination with buck inrush/current limiting;
  do not treat its 5 A marking as an active current limit or guaranteed clearing
  time for a fault on the 5 V side.
- **Two bucks (B0GGHN97TK ×2), split BY RAIL, never paralleled.** Two outputs
  tied together have no current sharing: one hogs the load until it limits,
  then they hunt.
- **Screen branch fuse:** onboard F1 is a Schurter **0001.2513**, 8 A
  time-delay cartridge, in an **OGN 0031.8201** holder. All screen-board
  loads are downstream of F1. Connect the AUX positive split directly to
  screen J1 pin 1 and ground to pin 2 using a very short 16 AWG pair, with a
  15 cm one-way design target. **F1 does not protect this incoming pair or
  the J1-to-F1 copper**; insulate, secure and protect that section from
  abrasion. No separate inline holder is included. Keep the console/ring
  branch separate. The [current harness specification](kicad/screen_power/README.md#required-aux-branch-protection)
  records protection limits and the retained upstream 20 V fuse.

| Buck | Loads | Design figure |
| --- | --- | --- |
| **BUCK_PI** | Pi 5, its USB devices and NVMe | 5.0 A / 25 W device budget |
| **BUCK_AUX** | Both screens, console, 80 pill LEDs and 40 ring LEDs | 7.818 A / 39.09 W for a full-white ring with normal pill indications and the allowances below |

The selected ring is a **40-pixel strip**, giving 120 LEDs with the ten
8-pixel pills. The updated v3 console/carrier copper supports the ring at
unrestricted RGB white. Its electrical design no longer depends on the ring
firmware's brightness limit. The old v2 console on the current pedal is not
upgraded by changing the new PCB files.

Use 60 mA per RGB-white LED as the conservative planning model from
[Adafruit's power guide](https://learn.adafruit.com/adafruit-neopixel-uberguide/powering-neopixels).
Add 1 mA per pixel as a separate idle allowance. These are design assumptions,
not measurements or a guaranteed rating of a particular LED batch.

The v3 firmware preserved in PR #1082 still uses brightness 128 and the pill
weights `38, 92, 201, 255, 255, 201, 92, 38`. Its normal indications have at most
nine single-channel pills and one amber REC/PLAY pill. With its actual integer
scaling and gamma table, their maximum channel-current estimate is 0.498 A.
This PCB change does not alter those animations or command a full-white mode.

| AUX load allowance | Current |
| --- | ---: |
| Both screen main feeds and both touch feeds | 4.250 A |
| Screen-board bleeder, separately counted | 0.060 A |
| Screen-board relay coils and control circuitry | 0.150 A |
| 40 ring pixels, all RGB channels at 255 | 2.40 A |
| All ten pills displaying their brightest normal indications | 0.498 A |
| Idle allowance for 120 pixels | 0.120 A |
| Console logic | 0.140 A |
| Additional XIAO ring controller and buffer | 0.200 A |
| **Planning total** | **7.818 A** |

The nominal 10 A buck has approximately 2.18 A headroom against this model.
That is not a guarantee of transient response, capacity at high temperature
or screen current; physical validation remains part of the first assembled build.
The 60 mA bleeder allowance is separate from the 4.25 A screen allowance.
Coils/control add 150 mA, making the screen-board input allowance 4.46 A
and the power-contact load 4.31 A. Host USB VBUS
only supplies the low-current presence detectors. The 3 A main and 0.5 A touch branch
ceilings cannot all be used simultaneously: their sum exceeds the shared 4.25 A
planning allowance before the bleeder is counted.

Allowing **all 80 pill LEDs as well as the ring** to display flat unrestricted
white is a different requirement: 7.2 A of LED channels plus the screens and
allowances above totals **12.12 A**. That exceeds the retained 10 A AUX
supply. The ring PCB upgrade does not authorize that simultaneous system load.
Normal pill rendering remains within the modeled budget with a full-white ring.

See the [40-pixel power-path verification](https://github.com/tomassasovsky/segno/blob/claude/segno-integration/docs/reviews/ring40-full-white-1072/verification.md)
for conductor widths, connector limits and the source-pinned runtime arithmetic.

**The old v2 board and new v3 board have different power paths (#1062).** On
v2, the LEDs share the console's 0.6 mm +5 V track, estimated at 1.65 A by the
project's IPC-2221 calculation. That approximately 1.6 A path limit remains
relevant even with a 10 A buck. It is not a measured cutoff or a fuse rating.
V3 sends pill power through a copper bar instead:

- **J3** is a JST VH (~10 A per contact), carrying the LEDs and console logic.
- **J24**, a 3-way JST VH stacked under J3 at the board's left edge, is the pills'
  one connector: pin 1 GND, pin 2 data, pin 3 +5 V. J3's +5 V pad and J24's face
  each other across a bar poured on both copper layers, bypassing the narrow
  routed track. The 80 pill LEDs have a 4.8 A uncapped RGB-white channel
  budget (about 4.88 A including the idle allowance). The data line crosses
  the board to J24 from the buffer, ~87 mm. J7 is gone.
- The retained console ring feed is a dedicated **1.7 mm** route to J6, with four
  parallel 0.5 mm drilled power vias. The carrier has a **1.5 mm** direct feed
  from J1 to J2 and three parallel ground vias at the strip wire pad. Console
  input, pill-output and ring-output ground connections have wider thermal spokes.
  Lower-current logic and alternative 24/16-pixel module branches retain their
  existing tracks. The routing/export guards preserve this separation. For the
  selected full-white strip, use the direct AUX star harness below rather than
  sending LED current through the console and both XH connectors.

The conductor estimates use **IPC-2221, 10 °C rise, 1 oz external copper**,
including a 20% negative width tolerance for the new high-current feeds.
They take no credit for adjacent ground copper as a heat spreader. These
calculations support the design; they are not a measured thermal qualification.

**Testing the existing ten-pill chain on v2:** use a temporary diagnostic that
keeps the ring dark and lights only one eight-pixel pill at a time, with one
colour channel capped at 32/255. Its channel-current estimate is
`8 × 20 mA × 32/255 = 20.1 mA`, plus the already connected pixels' idle draw.
This checks addressing, colours and pixel direction at low current. It does
not qualify maximum brightness or the new v3 board. The diagnostic starts and
finishes dark, then the installed v2 firmware is restored; normal v3 firmware
must not be flashed onto the old board.

- **The Pi is fed through its USB-C, not the header.** Ribbon pins 2/4 are
  deliberately not connected (`PI_POWER` gate): tying them would put BUCK_PI in
  hard parallel with the Pi's PMIC rail and land the WS2812 load on the Pi's
  5 V pin.
- A plain 5 V feed is not a PD source, so the Pi caps its downstream USB at
  600 mA unless **`usb_max_current_enable=1`** is set in `config.txt`. Required
  for the existing peripheral budget: the audio interface and rear USB ports
  use Pi USB power. After the screen switch is fitted, each touch cable draws
  only approximately 50 µA of host-presence sensing load from Pi VBUS;
  relay coils use AUX and screen touch power comes from switched AUX.
- The console board takes 5 V from **BUCK_AUX on J3**, a 2-way **JST VH**
  (~10 A per contact) since #1062; it was a 4-way XH with doubled pins (~6 A). The
  pills' 5 V leaves on **J24**, the JST VH beside it, and their harness is a **5 V
  bus with a tap to each pill**, not a daisy chain through the strips: 4.8 A in
  series through the strip copper would drop enough to shift the far pills'
  colour. Use 16 AWG for the pill bus and **16 AWG for J3's input feed**, with
  SVH-41T-P1.1 contacts for the latter. The selected standard VH connector's
  10 A rating is specified with 16 AWG. The data line and its GND ride the
  same J24 plug (pins 2 and 1). See `kicad/console_board_pcb.py`
  (`_pill_power_bar`, the `PILL_POWER` gate).
- **Screen evidence (owner report, 25 September 2026):** the UPERFECT ran at
  full brightness on a 5 V supply, showing about 1.3–1.4 A and up to 9 W in the
  pattern sweep, with no startup reading above 10 W. APROTII showed about
  0.8 A, up to 4 W at startup and 6 W in the sweep. The current and power fields
  disagree, so they are not a precise simultaneous-current measurement. The
  current fields imply 2.2 A combined; the steady power maxima imply 3.0 A at
  5 V. Using 10 W plus 6 W gives a conservative 3.2 A screen allowance before
  any separately counted touch current. Adding up to 1 A for both touch paths
  gives 4.2 A, rounded up to a **4.25 A shared screen allowance**. A separate
  60 mA bleeder and 150 mA controls/coil allowance bring this board to
  **4.46 A**, or **7.818 A AUX** with a full-white ring and normal pills.
  This does not qualify the buck, actual new-board voltage drop, thermal
  behavior or inrush.

### Screen power and touch harness

Both main-power leads and both touch leads pass through the screen-power
board. Keep the existing HDMI connections. A direct Pi-to-screen touch cable
or unswitched AUX-to-screen power lead would bypass the cutoff and must not
remain connected in parallel.

| Connection | Pin map and harness |
| --- | --- |
| AUX buck → screen J1 → onboard F1 | Positive split directly to J1 pin 1; ground to J1 pin 2. Dedicated 16 AWG pair, 15 cm one-way target, with VHR-2N housing and SVH-41T-P1.1 contacts. The incoming pair is upstream of F1: insulate, secure and protect it from abrasion. Console/ring stay on their separate branch. |
| Console J25 → screen J2 | Pin 1 GPIO17, pin 2 GND, straight pin-for-pin; one short 22 AWG XH2 lead. |
| Pi USB 2.0 ports → J101/J201 | Two USB-A male-to-XH5 leads: 1 VBUS, 2 D−, 3 D+, 4 GND, 5 shield. Host VBUS feeds only its low-current presence detector. |
| J102 → UPERFECT touch | XH5-to-USB-C male: 1 fused switched VBUS, 2 D−, 3 D+, 4 GND, 5 shield. Preserve the source-role CC resistor in the plug. |
| J202 → APROTII touch | XH5-to-Micro-B male, same five-pin map. |
| J103 → UPERFECT power | Pin 1 fused switched +5 V, pin 2 GND; separate main-power lead retaining the working USB-C screen termination. |
| J203 → APROTII power | Pin 1 fused switched +5 V, pin 2 GND; separate main-power lead retaining the working Micro-B connection. Power pads are an alternative only after verifying their polarity and layout. |

The two main-power leads must each be **no more than 30 cm**, with **20 AWG or
larger copper conductors for both positive and return** and **3 A-rated
terminations**. At the PCB use VHR-2N housings and SVH-41T-P1.1 contacts, which
accept 20–16 AWG; match the specified insulation diameter. Reterminate the
source end of the known-working screen power connection, preserving the
screen-side USB-C/Micro-B plug and any CC/attachment electronics. The exact
existing lead gauge has not been recorded: reuse is conditional on these
requirements, not an assertion that any existing cable meets them. An
unspecified charge-only cable or a 28 AWG USB data lead is not a
substitute. [JST VH specifications](https://www.jst-mfg.com/product/pdf/eng/eVH.pdf).

Revision P retains each USB shield drain on pin 5 of its XHP-5 plug, bonded to
PCB GND. There is no separate soldered drain tether: unplugging the housing
disconnects the complete cable. Keep the shield and data-pair twist intact
to a short fanout, insulate the drain termination and provide jacket strain
relief. Select contacts for the actual wire and insulation dimensions. The
[current harness specification](kicad/screen_power/README.md#xh-usb-cable-contract)
defines the donor-cable, pinout and length requirements. The owner confirmed
that the available cables physically reach; donor conductor size, insulation
diameter, shielding and completed USB operation remain to be verified.

The XH5 leads are for touch/data only, with a 500 mA design allocation and
actual donor wire dimensions still to be established. Both screen ports may join
internally, so the 800 mA touch fuse does not force screen current into the
main lead or limit it actively to 500 mA. Keep the main leads connected and
their ground returns intact. Pi USB ground and GPIO ground are signal
references, not substitutes for the screen power-return pair. The board and
all equipment still share ground; it is not galvanically isolated.

The GPIO owner enables the board before Weston starts and requests off before
normal HDMI shutdown, with a provisional five-second discharge wait. A powered
but halted Pi needs those software hooks; the PCB does not detect missing HDMI.
The owner confirmed both screens go fully dark when power and touch are
removed while HDMI stays attached. Actual GPIO-controlled timing, touch
enumeration and warm operation remain first-assembly checks. See the
[connector and power acceptance matrix](https://github.com/tomassasovsky/segno/blob/claude/segno-integration/docs/reviews/screen-power-rev-k-1072/wiring-and-power.md)
and the [board instructions](kicad/screen_power/README.md).

---

## 3. The console board's two internal data cables

### Console board ↔ Pi: the ribbon

One **keyed 2×20 IDC ribbon, ~10 cm** — both boards sit under the 16" screen
and the Pi is ~30 mm from the board (`board_mounts()` in `segno_enclosure.py`).
J2 is rotated so both connectors' pin-1 ends face the front: pin 1 meets pin 1
with no fold in the cable. 17 of the 40 ways carry something;
`console_board.py`'s `PI_HDR` is the authority:

| Pi pins | signal |
|---|---|
| 1, 17 | 3V3 — the board's 3V3 rail (opto + pull-up bias, ~15 mA) |
| 6, 9, 14, 20, 25, 30, 34, 39 | GND |
| 8 / 10 | uart0 TX / RX = MIDI OUT / MIDI IN (GPIO14/15) |
| 11 | GPIO17 = screen-power enable, through J25 pin 1 |
| 21 / 24 | uart3 RX / TX = pedal link (GPIO9/8, `dtoverlay=uart3-pi5`); R17 **10 kΩ** Pico→Pi, R18 **6.8 kΩ** Pi→Pico |
| 18 / 22 | GPIO24/25 = SWD to the Pico's debug pads (flashing only) |
| 2, 4 | 5 V — deliberately **not connected** (`PI_POWER`) |

**J25 is the two-wire screen-power control connector:** pin 1 is GPIO17
(physical pin 11 on J2), and pin 2 is GND. Connect it pin-for-pin to J2 on the
[screen-power board](kicad/screen_power/README.md). The existing Pi ribbon stays
between the Pi and console board. Screen power comes from BUCK_AUX to J1
and then through onboard F1; J25 carries no 5 V. The new board provides
the enable pull-down.

For console Pico USB programming, program the module before fitting it, or
first disconnect console J3 (AUX), J6 (ring) and J24 (pills). Remove the USB
cable before reconnecting those headers. Pico USB can feed its VSYS rail
through the module's diode; the console connects VSYS directly to AUX, so
leaving those loads attached can power them from USB and feed current back into the buck.
Normal in-place programming uses the existing Pi SWD connection. The ring
XIAO has its own [USB isolation rule](kicad/RING_ASSEMBLY.md#programming).

The link needs **no level shifting**: RP2350 and Pi are both 3.3 V. The old
1k8/3k3 divider and the AHCT gate on this path were the retired 5 V board's needs
and died with it. Fit **R17 = 10 kΩ** from Pico TX to Pi RX and **R18 = 6.8 kΩ,
1%** from Pi TX to Pico RX. The lower R18 satisfies the RP2350 A2 E9 maximum
low-drive impedance; the sampled presence-input firmware workaround cannot be
used on hardware UART RX. Both resistors limit fault current. RP1 and these
Pico digital pads are 3.3 V-failsafe when unpowered, so a supply-clamp-induced
UART break is not a valid Pi-off detector. See R17/R18 in `console_board.py` and
[RP2350 E9](https://datasheets.raspberrypi.com/rp2350/rp2350-datasheet.pdf).

The **74AHCT125** drives MIDI OUT's current loop and the indicator chain.
The ring carrier has its own XIAO and level shifter; console gate B is disabled,
and the former ring-data path is removed. **MIDI IN's H11L1 runs at 3.3 V** and
feeds the Pi directly. GPIO4 (pin 7) is reserved for the GeeekPi N07 NVMe board.

### Console board ↔ ring board and the full-white power harness

The ring board carries its own **XIAO RP2350**, which owns the encoder and
generates the WS2812 timing locally. For the selected 40-pixel strip, supply
its LED current directly from AUX through a near-ring split. This avoids the
voltage loss of the long console-to-ring power path while preserving full
white output. The PCB's high-current copper remains unchanged.

| Destination | Connect to |
| --- | --- |
| Near-ring positive/ground split | AUX output posts through a dedicated pair, at most 600 mm one-way, 16 AWG copper or larger |
| Strip +5 V / GND | That split through a separate pair, at most 50 mm one-way, 22 AWG copper or larger |
| Strip-entry bulk capacitor | Panasonic EEUFR1A102, 1000 µF / 10 V, positive to strip +5 V and striped negative to strip GND; short leads with separately sleeved joints |
| Ring J1 pins 1 / 2 | That split through its own pair, at most 50 mm one-way, **22 AWG** with genuine XH contacts |
| Ring J1 pin 3 | Console J6 pin 3: console TX to ring RX |
| Ring J1 pin 4 | Console J6 pin 4: ring TX to console RX |
| Strip DIN | Ring J2 pin 3, at most 100 mm, routed beside the local ground leads |

Leave console J6 cavities **1/2 empty**. Leave ring J2 **1/2/4 unconnected**;
only DIN uses J2 in this selected assembly. J3/J4 remain empty. Do not add a
second console-to-ring power pair or a parallel strip-return wire through
J2. Both boards share ground through their AUX supply returns.

Secure the strip-entry capacitor body beside the harness, outside the optical
area, with its pressure vent clear. Allow its 10 × 16 mm envelope. Leave carrier
C1 fitted as well. This local reservoir buffers load changes; it does not limit
startup current. Wire only with AUX off. The carrier copper guard covers the
retained PCB rail, not the selected external strip's harness or capacitor.

Use insulated, strain-relieved soldered or correctly crimped branch joints.
Do not force 16 AWG into XH contacts: the short 22 AWG pigtails are intentional.
The complete common positive/return termination resistance allocation is
10 mΩ; each branch's complete joint allocation is another 10 mΩ.

At a defined **4.75 V minimum at the loaded AUX output posts**, the 60 °C wire,
aged-contact and hot-copper calculation gives at least **4.632 V at the strip**
and **4.620 V at the AHCT buffer**, above its 4.5 V minimum. The fixed buck is
nominally 5 V; its actual regulation floor is not established by a manufacturer
specification. These are explicit design bounds, not measured assembled
voltages. See the [final voltage review](https://github.com/tomassasovsky/segno/blob/claude/segno-integration/docs/reviews/production-final-1072/ring-voltage-margin.md).

The link is full duplex at 115200 baud. The console uses a PIO UART because
its hardware UART is already assigned to the Pi link on GP16/GP17. This map
applies to the new v3 console and independent ring carrier only.

The PCB pin assignments remain defined by `RING_PINMAP` in
`console_board.py`, checked against `ring_board.net` by `RING_CONTRACT`. The
selected harness above deliberately separates power from the two UART wires.

Notes that are load-bearing:

- Ground is pin 2, between the supply and the two link signals.
- The two 10 kΩ link pull-ups R11/R12 connect J6 pins 3/4 to the console
  Pico's `+3V3_PICO` rail. They retain UART idle high while AUX is powered
  and the Pi's independent rail is off.
  The ring has no link pull-ups to its separate 3V3 rail. `RING_LEVELS` and
  `LINK_BARE` check that boundary.
- Use the console and ring firmware from
  [runtime PR #1082](https://github.com/tomassasovsky/segno/pull/1082), currently
  `53828fc4eae1c18af45abfc3ea7c31f19f9799d7`. It includes the RP2350 A2 E9
  presence-input workaround and PD status reader. The hardware branch's older
  firmware snapshot does not. This runtime is still a separate integration
  draft; board fabrication does not make it deployed or production qualified.
- **The specified star harness supports the 40-pixel strip without a brightness restriction.**
  The design budget is 2.4 A LED channels, 40 mA pixel idle and 200 mA ring
  controller. Only that 200 mA controller allocation passes through J1 in the
  selected harness; the strip current bypasses it. XH remains rated for 3 A
  with 22 AWG. Its 85 °C
  upper operating temperature includes the rise caused by current; it is
  not an 85 °C ambient rating at full current.
  The retained console 1.7 mm feed and carrier J2 1.5 mm feed with three
  ground-return vias serve the alternative module wiring. They do not supply
  the selected strip, whose power follows the direct AUX harness above.
  Firmware still chooses its display brightness, but that setting is not
  the hardware's current limit.
- **Only one ring or strip is supported.** Use J2 for the 40-pixel strip, J3
  for one 24-pixel module, or J4 for one 16-pixel module. Do not populate the
  alternatives together or chain an additional ring from DOUT. Extra LEDs
  require a new connector, copper and whole-system power assessment.

### Console board J22 ↔ the light sensor (#1564)

An optional ambient light sensor lets the app set the pills' and the ring's
brightness from the room. It sits at spot A on the faceplate (plate u 321.9,
v 385.0 mm: on the logo's centreline, 25 mm above it, 21.6 mm in front of the
rear fold), and its lead runs to the board's spare header **J22**. Without it,
or with J22 empty, the console behaves exactly as before: the firmware sees
nothing on the pin and the app offers no automatic brightness.

**Circuit.** A Vishay **TEPT5600** NPN phototransistor, wired as an emitter
follower into a load resistor:

```
J22 pin 1 (+3V3) ── R_S 100 Ω ── collector ─┐
                                            │ TEPT5600   (in the faceplate)
J22 pin 5 (GP28) ──┬─────────── emitter ────┘
                   │   ~520 mm of lead
                  ┌┴┐                         (R_S, R_L, C_F at the J22 end)
             R_L  │ │ 2.2 kΩ    ═╤═ C_F 100 nF
                  └┬┘            │
J22 pin 6 (GND) ───┴─────────────┘
```

The photocurrent through **R_L** is the voltage GP28 (ADC2) reads. **C_F**
sits across R_L, so the RC (0.22 ms with 2.2 kΩ) takes out RF and the 800 kHz
LED data the lead picks up on its way past the strips, and the ADC's sampling
capacitor charges from a stiff node. Mains flicker and LED dimmer PWM are left
to the firmware: it reads at random 7-13 ms intervals, so 100 Hz lamp flicker
(50 Hz mains) is caught at every phase, and averages a second of readings at
a time. **R_S** limits the current if the lead's +3V3 wire or the collector
joint ever touches the chassis-bonded faceplate: J22 pin 1 is the Pi's 3V3
rail, which also feeds the MIDI front end, and 100 Ω holds a short to 33 mA.
It costs the reading nothing: at most about 1.3 mA flows, a 0.13 V drop.

**Why R_S, R_L and C_F are at the board end, not at the sensor.** The
phototransistor is a current source, so the lead's noise behaves the same with
the resistor at either end; what differs is access. At the board end:

- the faceplate end is only the glued sensor, with nothing to fit or protect
  behind the plate;
- the resistor can be swapped after measuring (below) without touching the
  plate;
- a lead unplugged from J22 takes the resistor with it, so J22 is open and the
  firmware reports no sensor. A pin with the resistor on it and no sensor would
  read as a sensor in a dark room.

**The load resistor and where it saturates.** The sensor's gain after its
lens is sanded flat is not known. With its lens the TEPT5600 gives
630 µA at 100 lx (typical) and Vishay's bins span 25-227 µA at 20 lx, about
9x; flattening the dome widens the angle and loses an unmeasured share. The
firmware calls **3500 counts (2.82 V)** the top of the range. The collector
runs from the Pi's 3V3 through R_S while the ADC reads against the Pico's own
3V3, and the transistor needs a few tenths of a volt across it, so a
saturated sensor reads from about 2.9 V up; 2.82 V leaves room for the Pi's
rail to sit 0.1 V low. With **R_L = 2.2 kΩ** that top is 1.28 mA:

| Sensitivity after sanding | Top of the range at | Dark stage, 2 lx |
|---|---|---|
| 6.3 µA/lx (the lensed typical, no loss) | 200 lx | 34 counts |
| 2.1 µA/lx (a third of it) | 610 lx | 11 counts |
| 1.0 µA/lx (a sixth) | 1300 lx | 5 counts |
| 0.63 µA/lx (bin A's minimum, half lost) | 2000 lx | 3 counts |

A bright room is 300-500 lx. 2.2 kΩ is the middle of the plausible range: a
sensor that kept a third of its lensed gain still reaches a bright room, and
one that lost five sixths still resolves a dark stage after the firmware's
averaging. The firmware reports the raw ADC reading (on a log scale, in steps
of about 4 %) and the app calibrates it, so any value from **1 kΩ to 22 kΩ**
works without a code change. Below 1 kΩ the board's "no sensor" probe can
mistake a fitted sensor in the dark for a pin shorted to ground.

**Measure, then keep or swap R_L.** This needs controller firmware 2.7 or
later, which the image carries with the app that has the page. Read the value
on the console, in Settings > Displays > Console LEDs (the Light sensor
panel's Reading row, out of 4095). After the light changes, give it 10 s to
settle; the board moves the reading only after a change of about 19 %.

1. In the brightest room you play in, with the lights on: aim for
   **1500-2500**. Under **500**: fit a larger R_L. Over **3000**: fit a smaller
   one. If the page says the sensor is at the top of its range, the reading
   says nothing about how far over it is: halve R_L and measure again.
2. Otherwise the new value is `R_L × 2000 / reading`, rounded to the nearest
   E12 value (1.0, 1.2, 1.5, 1.8, 2.2, 2.7, 3.3, 3.9, 4.7, 5.6, 6.8, 8.2,
   10 kΩ...). Example: 3000 with 2.2 kΩ → 1.5 kΩ; 400 → 10 kΩ.
3. In a dark room with the lights as on stage, the reading should be clearly
   above zero (5 or more). If the bright room is right and the dark one still
   reads 0-2, the sensor cannot see a stage that dark; the curve then holds
   the LEDs at their dark level there, which is what it would do anyway.

**Calibrate in the app.** On the same page: in the dark room, wait 10 s and
tap **Dark room**; in the bright room, wait and tap **Bright room**. Dark room
is available only at half the Bright room reading or less, and Bright room
only at twice the Dark room reading or more; with a sensor whose dark room
reads above the default bright point, set Bright room first. Then choose
**Automatic**. The app maps brightness between the two readings: about a
third as bright to the eye in the dark (about a tenth of the LEDs' drive),
full in the bright room. The Brighter or darker slider shifts the whole
curve. Calibrate again after swapping R_L.

**Lead.** About 520 mm from spot A to J22 (the enclosure's route plus 150 mm
of lid slack). Three conductors, 26-28 AWG stranded, twisted together:
+3V3 (J22 pin 1, through R_S) to the collector, signal (pin 5) to the
emitter, and GND (pin 6), which carries no current: connect it at J22 only, and cut it back and
insulate it at the sensor. Keep the lead away from the pill data line (J24)
and the ring harness where it can, and do not bundle it with the buck outputs.

**At J22.** Solder the 2×3 header (J22, pin 1 top-left; see the
[solder order](v3_soldering/README.md)). The lead ends in a **2×3 Dupont
housing** with contacts in cavities 1, 5 and 6. Key it: pull **pin 3** out of
the header (it is NC on v3.2) and block **cavity 3** of the housing for good
(a cut-off header pin glued in, or the cavity filled with glue; a loose pin
falls out), so the housing only goes on one way. Turned round, it would put
the collector wire on ground and the signal wire on +5V (pin 2), driving the
sensor backwards from 5 V. Seat it fully over all five pins, with no overhang
past the header's edge. R_S goes in line in the pin 1 wire, and R_L and C_F
both between the pin 5 and pin 6 wires, just behind the housing, soldered and
sleeved with heat shrink, then one larger sleeve over the three wires and the
parts. On a reworked v3 board whose MODE jumper
lands on the J22 pin 3 pad, pulling pin 3 also leaves that wire alone.

**At the sensor.** The enclosure part (#1564) glues it in a Ø5.2 mm hole with
its sanded dome flush and lightly frosted. Solder the lead to its legs,
trimmed short, with heat shrink on each joint so the two cannot touch. Mark
the collector before trimming, from the package drawing in the
[datasheet](https://www.vishay.com/docs/84768/tept5600.pdf), which labels C
and E. Check it before the first power-up. Wired backwards, the reading barely
moves with light, and the sensor sits reverse-biased past its 1.5 V
emitter-collector rating; R_S and R_L hold the current to about 1.4 mA, which
it is likely to survive for a moment, but power it down and swap the two
wires.

**Check.** With controller firmware 2.7 or later and the lead plugged in, the
page's Sensor row reads Fitted within a few seconds of boot (Not reported
means the board's firmware predates the sensor); a hand over the sensor drops the Reading within about
5-10 s, and a phone torch pushes it up. Unplugged, it reads Not fitted within
a few seconds.

---

## 4. Raspberry Pi connections

- **Power** — BUCK_PI into the Pi's USB-C. Not the header, not BUCK_AUX.
- **USB** — the four ports are exactly consumed: 2× screen touch through the
  screen-power board, 2× internal A-to-A leads to the rear-panel couplers.
  No separate hub or HAT is added; the UPERFECT has its own internal USB hub.
  The audio interface
  plugs into a rear coupler from outside the box.
- **Screens** — 2× micro-HDMI out; touch comes back over USB through the
  screen-power board's switched data paths.
- **Storage** — NVMe on the N07 board under the Pi (PCIe — no GPIO use beyond
  the GPIO4 claim noted above).
- **Position** — under the 16" screen (#743, #753). Its own ports face inward
  and are serviceable only with the case open, by intent; everything the build
  needs comes back out through the rear stations.

---

## 5. Rear panel mapping

Nine stations plus the earth stud, on one centreline. The list is generated:
the enclosure writes `rear_io_stations.json` and the board's `REAR_IO_COVER`
gate checks its connector set against it, so this table is commentary, not a
source of truth.

| station | wiring note |
|---|---|
| USB-C PD inlet (`PD_IN`) | D punch; coupler → STUSB4500 → fuse → both bucks. Never touches the console board |
| power button (`POWER`) | momentary, **unlit** → J8, through the board to J9 → the Pi 5's own J2 solder pads. Two wires, and neither end has a polarity: J8 and J9 are wired pin to pin as a floating pair that never touches the board's ground (#1062), so the lead works on the Pi's pads either way round. No 5 V run to the rear panel. The machine has no power indicator — the screens are the indicator |
| fuse (`FUSE`) | 5×20 screw-cap holder — value and placement are §2's (T5A slow-blow, in the 20 V feed) |
| MIDI DIN-5 ×2 (`MIDI_IN`/`MIDI_OUT`) | IN is opto-isolated **on the board** — the socket alone is not enough. IN's pin 2 stays unbonded (that isolation is the point) |
| Neutrik NJ6FD-V ×2 (`CTRL_1`/`CTRL_2`) | 6-pole switching 1/4" jack, fitted in a MEIRIYFA D-size flange plate that screws to the rear wall's D punch (#1088). Vertical PCB pins, no lugs. On v2 connect T / R / S and leave TN / RN / SN open. An expression pedal OR footswitch on the same jack, auto-detected (tip → ADC with pull-up, ring → 3V3 through 1 k). A two-switch pedal on one TRS plug (BOSS FS-6 A&B) puts its B switch on the ring, which firmware ≥ 1.1 reads on GP20/GP21: a trace through 4.7 kΩ on board v3 (R19/R20); on v2 one wire from each jack's ring pin (J20/J21 pin 2) to J22's GP20/GP21 pads. Without either, use the pedal's separate A and B mono jacks, one per CTRL. **v3 jacks are Neutrik NJ6FD-V** (switched): a fourth lead, the **ring-normal (RN)** contact, tells the board whether anything is plugged in (J20/J21 pin 4 → R21/R22 → GP19/GP22). Leave TN and SN open. RN is connected to R while empty and opens on insertion, leaving the ADC tip free of the presence pull-down. Identify RN from the component-side terminal view in [Neutrik's drawing](https://www.neutrik.com/media/8599/download/nj6fd-v-2.pdf?v=1); do not mirror that view |
| USB 3.0 coupler ×2 (`USB3_1`/`USB3_2`) | internal A-to-A leads to two Pi ports |
| M6 earth stud | centred between the vent block and PD_IN; rules in the grounding doc |

---

## 6. Grounding & ventilation

Single common ground; DIN **IN** opto-isolated; exactly **one** hard chassis
bond, at the board's H1. The full scheme — what goes on the earth stud, what
deliberately does not, and the bench audit to run before trusting any of it —
lives in [`console/grounding-and-bonding.md`](console/grounding-and-bonding.md) (#751). Vents: intake
in the bottom plate, exhaust in the rear wall; air crosses the boards and the
Pi's active cooler.
