tomassasovsky/segno-hardware/hardware/MANUFACTURING.md

<!-- cspell:words EEUFR -->
# Segno console — manufacturing package

Current revision: 2026-09-30 integration of #1088 (base, rear I/O in the wall,
power group, rail prints), #1070 (screen mounts) and the #1075 console strip
ring. The digital preparation is complete and matches the parts the owner has
already printed: the mirrored 15.6-inch stands, the closed-deck 7-inch tower
(no reprint: the ring moved down the slope instead, #1090), the 2.4 mm-wall front collars, the solid
CLEAR/BANK collars and the tall eight-LED pills of #1074 (PR #1084).

Matías welds all four base corners and closes all corner reliefs, including the
two indicated upper edges, with his chosen 5356 filler. There is no spot
welding anywhere. Exterior welds finish flush without thinning the parent sheet.

The populated Fusion clone ("VAMP console (populated) - 1067 tabs + seat
flanges") holds this revision; the full generator and 154 enclosure tests pass
against its formed base. Fabrication release remains on hold for Dinacut's
tooling acceptance and the independent #1019 structural/load assessment. Use
[the release review](enclosure/RELEASE_REVIEW.md) for the evidence and the
open items.

[Internal supplier drafts](enclosure/SHOP_REVIEW.md) cover Dinacut, a separate
welder and a separate painter. Dinacut drills every deferred hole after folding
and before welding (owner call 2026-09-30, #1090). No supplier message or cutting authorization is implied here.

CAD, drawings and vendor archives come from
[segno_enclosure.py](enclosure/segno_enclosure.py). For an authorized order,
regenerate and verify the complete package, then freeze the exact files sent
by pushing a `fab-*` tag (for example `fab-2026-10-27-metal`): CI rebuilds the
outputs from that commit and attaches them to a GitHub release, which is the
order's release record. Generated files, ZIPs included, are not tracked source.
A partial run retains earlier metal archives; those are not the new revision.

## 1. Metal fabrication and separate finishing

The metal handoff is **one `enclosure/out/segno_sheetmetal.zip`**, containing
exactly **12 files: STEP, DXF and individual PDF for each of four parts**.
Shipping filenames include material, bare thickness and quantity. They retain
these canonical part stems:

| Part | Qty | Material | Notes |
|---|---|---|---|
| `segno_base` | 1 | 2.0 mm 1100-H14 aluminium | One folded blank; weld all four corners and close all corner reliefs, including the two indicated upper edges, after forming. Every rear connector is cut straight into its rear wall (#1088). |
| `segno_faceplate` | 1 | 2.0 mm 1100-H14 aluminium | Removable sloped lid, 853.8 mm wide (2 mm past each side wall) along the slope; over the last 40 mm before the rear bend it narrows to 849.8 mm, so the rear lap is flush with the rear wall. Nine front clearances (laser pilot, drilled out after folding) and nine rear CUT slots. |
| `segno_ring_disc` | 1 | 2.0 mm 1100-H14 aluminium | Flat centre disc, Ø51.0, coated with the lid; straight laser bore, no chamfer. Since #1090 it is glued on the strip ring's printed centre cap so the centre matches the lid; two Ø8.0 holes over the cap's M3 screws (under the knob) let the cap come out. |
| `segno_beam` | 1 | **1.6 mm cold-rolled steel** | Support beam, 839.8 mm, a plain C with two long folds and square ends about 3 mm short of each side wall (no wall ears since #1090); nine floor fixings on the lid's front screw stations; grade to confirm. |

`PART_SPECS` supplies these quantities and materials to the drawings and
archive manifest. The 2.0 mm material identification follows the Alcast
1100-H14 certificate, lot 26E0269; confirm the job stock. The certificate does
not identify the steel grade. There is no separate rear I/O panel since #1088.

There are no rear corner brackets or their ten base rivet holes. The metal
archive excludes assembly, README, drafts, purchased hardware, printed parts
and removed brackets/posts. Purchased shims and front/rear washer references
remain internal assembly aids. Labels stay on individual pedal tiles.

### Work sequence

1. **Dinacut:** cut, fold (conventional press brake, ±0.7 across a fold),
   drill and deburr, without chamfering, tapping or painting. The nine front
   stations on the lid are cut as Ø1.0 laser pilots only, because they sit
   inside the V12 die zone and a full-size hole would distort in the fold; the
   body's front wall has no pilots. After folding, and before the base goes to
   the welder, Dinacut clamps the body square, seats the lid on it with a 1 mm
   spacer in the front gap, drills Ø2.5 through each lid pilot into the wall,
   and then opens the lid's nine holes to Ø4.5.
   Confirm stock, tool access, inside radii and bend development before final
   files. The source uses K=0.33, R2 for aluminium and R1.6 for the steel beam;
   follow each part's fold order and drawn-face orientation. Confirm tool access,
   fold sequence and the sharp developed profile of the revised angular corner
   reliefs before cutting. Preserve the #1019 beam, rails, prop and fixing layout.
2. **Matías, separate welder:** weld all four base corners and close all their
   reliefs, including the two indicated upper edges, using the accepted 5356
   filler. Finish the exterior flush without reducing parent-sheet thickness;
   retain squareness and free lid seating. The lid remains removable and is
   not welded. The former 0.00–0.10 mm riveted-seam requirement is retired.
   This accepted scope does not constitute a qualified weld procedure or load
   assessment.
3. **Bare fit check after welding (owner, before paint):** seat the lid
   freely on the welded base and check face alignment, the 0.70–1.50 mm front
   gap and that all nine front screws start without forcing. Correct the metal
   before coating; nothing is drilled at this step. Run the #1019 first-article
   proof test (release review) at the same time.
4. **Separate painter:** coat the welded base and the other parts separately,
   smooth matte black RAL 9005, without texture. Coat all faces, seats, edges,
   holes and slots, with 0.06–0.10 mm local film per face. Protect only identified
   electrical-bond contacts. Remove electronics, printed parts, shims, felt and
   adhesives before treatment.
5. **Owner after coating:** clean paint-narrowed body pilots back to their
   existing Ø2.5 metal bore without moving the axes, then tap **32 M3 threads:
   18 lid and 14 screen-support threads**. Fit shims, felt and hardware to the
   measured coated assembly. No new drilling, clearance enlargement or
   corrective seat machining is planned after paint.

### Four-corner preparation being synchronized

Follow the supplied joint example: 0.5 mm nominal bare joint gap, 1.0 mm overlap
and angular corner relief, developed with Ri2 mm and K0.33. These are joint
geometry targets, not a new tight production tolerance. The rear web width is
847.821682 mm; the return width remains 849.8 mm. Confine their transition to
the bend band, retaining the return's full width outside that band. Verify the
actual folded result and lid seating in both native models and the resulting
flat-pattern parity; a nominal sketch alone does not establish the preparation.

The welding scope and filler choice are settled. Dinacut's acceptance of tool
access, fold sequence and the sharp developed profile remains pending before
cutting. Do not issue the previous two-corner archive as this four-corner revision.

### Drawings and tolerances

Shop-facing instructions and title blocks are Spanish. Part stems and layer
names remain the identifiers used in the matching files. `CUT` and `VENT` both
cut through; the floor has no vents, while side/rear openings remain. `DRILL`
is the finished diameter, drilled after folding and before welding; on the lid
the laser cuts only the Ø1.0 pilot at the same centre, on `CUT`, and the body's
front-wall `DRILL` circles have no pilot (drilled through the lid). `BEND` is reference only: do not
cut, score or engrave it. `MASK` identifies electrical-bond coating protection,
never a cutting contour.

The general block is Dinacut's stated capability and nothing tighter (owner
call 2026-09-30, #1090: tighter tolerances cost far more): hole position and
hole or slot size ±0.20 mm, bend angle ±1°, flat exterior size ±0.30 mm and
dimensions across one fold ±0.70 mm. That last row is their **conventional**
bending (owner call 2026-10-08, quote 4470): the ±0.50 the drawings asked for
before was priced as precision forming, at more than twice the July quote
(4462: US$375 against 4470: US$171). Every fit that crosses a fold absorbs
±0.7: the lid's rear slots, the felt-selected beam and prop, the welded
corners, and the front holes, which are drilled through the seated lid. The design carries the margin instead:
every opening below still passes its part at −0.20 with the full coating, and
the generator gates that. Fuse and MIDI were opened and the D flanges trimmed
to Ø24.20 for it; at +0.20 on both holes the D-flange web to its M3 pair is
still 1.20 mm.

### Lid fit and front drilling

The source uses **1.10 mm nominal bare front clearance**. The **0.70–1.50 mm
bare acceptance band is measured after welding and any metal correction**;
it includes forming/fixture effects and is not guaranteed by generic bend
limits. Check one common, freely seated lid pose across all nine stations.
Correct face alignment before coating: parallel shim packs cannot correct a
wedge between the lip and wall.

Only the **nine front lid clearances and nine matching body holes** are
`DRILL`. Each lid station has a Ø1.0 laser pilot on `CUT` at its centre; the
body's front wall has none. The drawing stations (A at the bare floor
underside, B at the bare left-wall interior) are for checking. Nominal front
axis height is 6.455 mm above A. After folding and before welding, the parts
are drilled **as a fitted pair**: body clamped square, lid seated with a 1 mm
spacer in the front gap, Ø2.5 through each lid pilot into the wall, then the
lid's nine passages opened to **Ø4.50 ±0.20**. Drilled separately, three
conventional folds (wall, side-wall seat, lid lip) could put the two holes
~1.2–2 mm apart, beyond what the 12 mm lip has room for. The Ø4.5 is still
needed after the pair is drilled: coating the seats lifts the lid 0.3–0.5 mm
and it re-seats within its rear slots each time it goes back on.
Leave all body pilots untapped. The nine rear body pilots remain CUT; the
lid's rear openings are **10 ×6 mm CUT slots, length along lap depth**, each
dimension ±0.20 mm. Do not transfer-drill the retired rear round-hole pattern.

Use nine front M3 OD7 washers. The rear reference is nine **OD12 / ID3.2 /
1.0 mm M3 washers**, with procurement limits and actual seating still to
confirm. The [fit calculation](https://github.com/tomassasovsky/segno/blob/claude/segno-integration/docs/reviews/dinacut-fit-calculations.md)
checks slot passage under simultaneous axial/transverse offsets and coating;
it does not qualify angular washer bearing, clamp torque or screw engagement.
The rear washer may leave part of the slot visible. Verify the actual bearing
and lid removal before releasing this fastening detail.

From the accepted bare band, coating alone predicts **0.357–1.488 mm** front
shim space. Fit nine deburred solid stainless packs, OD6.90–7.00 / ID4.0–4.2 mm,
to the actual cured gaps without pulling the faces together. The nominal
1.10 mm STEP pack is not an order thickness. Verify bearing and parallelism,
number packs 1–9 and retain only outside their bearing faces and bores. Fit
felt/seals to measured gaps without lifting the lid off its seats. No shim or
adhesive enters the coating oven.

### Functional openings

All dimensions are mm. Finished ranges assume the stated local film on each
opposed wall. They do not establish positional fit of a complete screw pattern.
Keep connector centres and purchased fixing pitches fixed. Retained functional callouts override the general block.

| Opening | Before painting (all ±0.20) | Predicted finished range | Must pass |
|---|---:|---:|---|
| Metal M3 clearances, except front lid | Ø3.60 | 3.20–3.68 | M3 3.0 |
| Nine front lid clearances (drilled) | Ø4.50 | 4.10–4.58 | M3 3.0 |
| Nine rear lid slots, length ×width | 10.00 ×6.00 | 9.60–10.08 ×5.60–6.08 | M3 + float |
| Metal M4 clearances | Ø4.60 | 4.20–4.68 | M4 4.0 |
| Ø4.80 floor clearances where called out | Ø4.80 | 4.40–4.88 | M4 4.0 |
| Pill lens apertures | 60.40 ×6.40, R3.20 | 60.00–60.48 ×6.00–6.48 | lens 59.80 ×5.80 |
| Ring lens aperture | Ø67.40 | 67.00–67.48 | lens Ø66.80 |
| Fuse | Ø12.50 | 12.10–12.58 | 12.0 aperture |
| Power switch | Ø19.80 | 19.40–19.88 | M19 thread |
| MIDI NYS325 | Ø15.70 | 15.30–15.78 | 15.1 body |
| PD coupler and two CTRL D-flange sockets | Ø24.20 | 23.80–24.28 | 23.6 barrel |
| USB four flats | 22.80 ×22.80 | 22.40–22.88 across each pair | 22.1 flats |
| Same USB concentric circle | Ø24.80 | 24.40–24.88 | 24.1 thread circle |
| Disc outside diameter | Ø51.00 | 50.92–51.40 | lens bore Ø51.70 |
| Disc straight bore | Ø8.70 | 8.30–8.78 | shaft/bushing |
| Ambient light sensor window (#1564) | Ø5.75 | 5.35–5.83 | TEPT5600 body 5.15 max |

The USB contour is the intersection of the four flats and concentric circle.
PD/CTRL/MIDI local ligaments must measure at least **1.20 mm bare**, including
actual hole-position error; qualify the complete barrel/fixing pattern and local
cutting process on the 2.0 mm rear wall. Check these connector fits with the
actual parts and a representative painted coupon. This is not an
electronics-equipped enclosure trial.

All connectors are cut straight into the 2.0 mm rear wall (#1088); there is no
separate I/O panel. The two CTRL jacks stay Neutrik NJ6FD-V, each fitted in the
D-size zinc flange plate from the MEIRIYFA listing (Amazon B0G5FZNH49): Ø24
hole, flange 26 × 31 mm, two Ø3.4 fixings at ±9.5 / ±12 mm, top-left and
bottom-right seen from the front. The wall is cut to that diagonal, and the PD
coupler takes the same one (owner check against the part, 2026-09-30). The plate screws on from outside, so
the 2.0 mm wall does not limit the NJ6FD-V's 1.20–1.50 mm clamp range.
Verify the selected power/fuse hardware and all complete M3/M4 mounting
patterns after coating; a screw fitting one bare hole is insufficient.

The disc is laser-cut and deburred without a chamfer, coated on every surface;
its bore centre has ±0.20 mm X/Y tolerance relative to the outside-circle
centre. The owner's EC11 washer measures ID7.25 / OD11.85 mm. Let the disc
settle in the printed holder before tightening the original washer/nut, and
verify actual printed clearance, retention, push-button action and knob rotation.
The bore is a clearance fit, not a locating feature.

The steel beam retains its 1.2 mm nominal normal bare lid gap, nine
depth-slotted floor fixings (the lid's front screw stations, #1090). It has no
wall ears (#1090): its square ends stop about 3 mm short of each side wall, so
it drops in at any tolerance stack, and nothing fixes to the side walls.
Fit it after separate coating, then select felt from the measured finished gap.
Preserve the #1019 rails, central prop and support heights; earlier numerical
load estimates are not a rating of the current welded assembly.

### Digital package checks

Follow [FUSION_MODELS.md](enclosure/FUSION_MODELS.md) for both native documents.
Base and lid formed exports must match the current complete CUT/VENT/DRILL
geometry, with saved/reopened geometry and occurrence checks. The beam, rear
panel and disc also need source/native agreement. Run the full generator and
applicable tests, inspect changed PDFs, and verify exact archive membership
and file contents before recording completion. The packager requires both
STEP and PDF output and rejects missing, empty or stale artifacts; failed
staging preserves the previous archive. Old metal archives are retired only
after the complete replacement succeeds.

`segno_assembly.step` and purchased shim/front-washer/rear-washer STEPs are
internal references. Printing, pedal-tile and painting archives remain separate.
The painter's handoff is `enclosure/out/segno_pintura.zip`; do not send a closed
assembly to the coating process. Digital checks do not release the outstanding
stock/tooling, welded-fit, coating, hardware or #1019 structural gates.

## 2. 3D printing (FDM)

Send **`enclosure/out/segno_3dprint.zip`** (STEP + STL for each part).

The fully coated console uses 0.15 mm normal relief on the collar hard rims
and the sled's outer rim, plus 0.20 mm additional screen setback. Floor fixing
axes remain fixed. Print the revised collars and matching sled variants,
seven-inch tower and both large-screen stands from one matching revision;
previous bare-fit prints are
not qualified against the newly coated seats. The separate mini-console is
unchanged by these console paint allowances.

**Every printed part is BLACK PETG at ≥40% infill.** One filament, so a reprint of any part matches the rest; ASA is no longer offered as an alternative. Three parts are exceptions and all three are optical, not a second material preference: the ten pedal-LED diffusers and the encoder ring diffuser are WHITE translucent because they are the lenses the LEDs shine through, and the ten pedal tiles are a black body with white lettering printed in one filament change, because an all-black tile has no legend.

| Part | Qty | Material | Notes |
|---|---|---|---|
| `segno_platform_front_ring` | 8 | **BLACK PETG**, ≥40% infill | Front-row collar, paired with the separate sled below. Four chassis screws clamp collar, sled and base together. |
| `segno_platform_mid_ring` | 2 | **BLACK PETG**, ≥40% infill | Taller CLEAR/BANK collar. Four bottom inserts anchor it to the base; four separate deck screws retain its dedicated mid sled. |
| `segno_platform_sled` | 8 | **BLACK PETG**, ≥40% infill | Front-row sled. Bolt the pedal to it on the bench, then lower the complete unit into the front collar. |
| `segno_platform_mid_sled` | 2 | **BLACK PETG**, ≥40% infill | CLEAR/BANK sled with a separate 60 ×36 mm lower insert pattern; use only with the matching short-screw mid collar. |
| `tall_pill_base` + `tall_pill_diffuser` (#1074, PR #1084, `hardware/pill_light_mask/`) | 10 each | carrier **BLACK PLA**, lens **WHITE PLA** | The pill diffusers the owner printed: an eight-LED 144/m strip on a full 2 mm glue bed, 5 mm of air, a 0.8 mm white roof. The lens nose enters the unchanged 60 × 6 mm faceplate slot from inside and ends flush; four 0.2 mm pads set the glue line under the sheet; the carrier reaches 8.13 mm below the sheet underside. Checked in the populated Fusion clone at all ten stations: nothing touches the beam, its felt or the collars. Remove the temporary bench collar before fitting under the metal. The older `segno_led_diffuser` is superseded; do not mix parts from the two sets. |
| `segno_pedal_tile_*` | 10 | **BLACK PETG body + WHITE lettering**, one filament change (exception to the all-black rule: an all-black tile has no legend) | Pedal name tiles, one per pedal, dropping into the WTB-006 top pad's window. **TRAPEZOID**, 54.36 (back) / 53.76 (toe) × 19.90 × 2.20 — the pad is a wedge in plan, and the window keeps a 5 mm wall each side at every station, so the tile's sides run parallel to the pad's. Both widths are derived from the pad measured in the Cherub Fusion doc (window 54.46 / 53.86, less 0.05/side). **Fit the WIDE edge toward the cable end**; it carries the top of the glyphs, so the wrong way round reads upside down. The pad is a uniform 2.2 slab on a case top tilted to match, so the window is a parallel-sided pocket in depth and the tile is flat in Z. **Print FACE-DOWN with a filament change at z = 0.4**: the glyphs stand proud of the body, so face-down they are the first 0.4 mm off the bed — print that in white, swap to black, flip. One extruder. The letters finish flush with the pad and the black field sits 0.4 mm below it, out of the scuff line. Text is generated from the same `PEDALS`/`SILK_SYMBOLS` pedal-label schedule, so REC/PLAY and STOP carry the dot+plus+triangle and square rather than words. |
| `segno_floor_rail_front_a_*` / `segno_floor_rail_front_b_*` | 8 | **BLACK PETG**, ≥40% infill | Front floor rails (issue #1019), 201.79 mm, four screws. **Every segment of a rail is the same part** — eight of this one; the rear rail has two exceptions, below — because the rail span comes from the pedal pitch, so each segment is exactly two pedals wide and the screw pattern repeats. **Print flat, channel side up**: the channel needs no support and the floor face is the bed face. Each carries a 19.05 × 3.2 mm self-adhesive SOLID neoprene strip (3/4" × 1/8") pressed into its 18.85 × 1.5 mm channel — 0.2 mm under size on purpose, so the walls hold it and the adhesive is not in the load path. **Not grit tape**: this gets dragged across floors. The strip stands 1.7 mm proud and is the only thing touching the ground. Ends are **square** with a 1 mm corner break and the segments **butt**, so the strip is a plain scissors cut that fills the channel corner to corner. **Fit the rails first, then press the strip in** — the M3 heads sink into counterbores inside the PETG, above the channel roof, so the strip runs over them unbroken and never needs punching. 2,385 mm of strip for the set. |
| `segno_floor_rail_rear_1` / `_4` | 2 | as above | Rear floor rails, 201.79 mm, two screws at 64.75 and 110.75 mm from the low-u end, so both go on the same way round. The rail sits at v 343.25; at 21 mm wide it clears the screen-stand pilots by 3.5 mm each side. |
| `segno_floor_rail_rear_2` / `_3` | 1 each | as above | **Their own prints** (#1088): the power group stands on the rail between them. Segment 2 has its screws at 21.75 and 64.75 mm from the low-u end, ahead of BUCK_AUX, and three blind Ø8.4 × 2.6 mm pockets in its floor face at 91.24, 145.14 and 162.94 mm; segment 3 keeps the standard screws and has one pocket at 14.55 mm. The pockets take the buck bolts' M4 button heads. **Bolt the bucks before fitting these two segments**, heads from below. Print floor face down, like the others; the pockets need no support. |
| `segno_lid_prop` | 1 | **BLACK PETG**, ≥40% infill | Mid-field lid prop (issue #1019). A pure compression column, which is why it is printed rather than another shop part number. It stands in the one clear lane between BANK's pedestal and the 16in module body — 31.5 mm wide, so the 24 mm column has 3.7 mm each side and there is no room to improvise on the bench. Two M4 into the floor through the tongue; the top face is already cut to the 12.5° slope, so print it **tongue-down, flat on the bed** and let the sloped face be the top surface. Fit felt on that face to the measured gap after coating, the same rule as the steel beam. Its load qualification remains part of the independent #1019 hold. |
| `segno_als_sleeve` | 1 | **BLACK PETG**, ≥40% infill | Ambient light sensor sleeve (#1564): a Ø15 body, 17 mm across its cable-tie tongue, 23.0 mm long. It is bonded to the lid underside around the sensor window and the TEPT5600's flange beds in epoxy on a seat 2.70 mm below its bond face (bores Ø5.45 and Ø6.3; ream to these if the sensor does not slide in). Its bore hides the sensor body from the LED strips and screen backlights inside the console, and a 2.5 mm cable tie through its tongue holds the lead. **Print it bond face down** with no supports: every bore steps outward going up, and the tie hole is a 1.6 mm bridge. The print check passes on every count (98% bed contact). |
| `segno_ring_diffuser` | 1 | **WHITE translucent** (exception to the all-black rule: it is a lens) | Ø67-window lens and disc holder for the selected PR #990 Ring 24 on its 2.54 mm pin strip. The open-bottom cavity has eight 1.2 mm ribs in verified component gaps, a 0.25 mm shelf and a 1.05 mm lens roof. Nominal minimum PCB clearance is **0.135 mm**, LED clearance 0.332 mm; qualify one actual print and its light diffusion before ordering a set. Orient and dry-fit it as described below before gluing. |
| `console_ring_{diffuser,cup,encoder_retainer,encoder_spacer,centre_cap}` (#1075, `hardware/strip_ring/out_console/`) | 1 each | diffuser and cup **WHITE PLA**, the rest **BLACK** | **The selected ring** (owner, 2026-10-13; final count 35 LEDs, 2026-10-19, #1075), replacing `segno_ring_diffuser`. A 35-LED strip on the cup wall, LEDs facing in; the cup's roof is glued to the faceplate underside and the lens sits flush in the unchanged Ø67 window. Three snap arms on the cup click under the Ø80 carrier's edge (0.6 mm overlap, 0.3 mm play; the encoder nut still sets its height), so the carrier needs no screws (#1090). The cup prints roof-down, so the arms stand up with their layers across the way they bend; the first print's thin arms snapped coming off the bed. The arms are now 8 mm wide and taper from 1.8 mm at the root to 1.0 mm at the catch, with a chamfered root, and a full flex strains the root about 0.45 %. Release the part by flexing the bed, not by levering against the arms. A 0.48 mm-deep relief pocket behind each arm keeps it from printing fused to the wall; fully flexed, the arms stay 17 mm clear of the printed 7-inch tower. The v3 carrier hangs 7 mm deeper than with the Ring 24 (J3 unfitted, strip on J2); since the ring moved to v 215.0 (#1090) it clears the printed 7-inch tower with 1.5 mm of air. The aluminium `segno_ring_disc` is glued on its printed centre cap (the cap sits 2 mm lower for it), so the centre matches the lid's coating; order the disc. The carrier hangs from its Same Sky ACZ11 encoder, whose shoulder measured 6.39 mm above the board, so the encoder spacer is 1.695 mm thick (the 3.5 mm one assumed an EC11). Push the knob on until its underside is 1.0 mm above the face, so a full press of the switch (0.8 mm) never bottoms it; the shaft then enters 9.4 mm of the knob's bore. The cup is drawn for 34 LEDs (`COUNT` in `console_ring.py`), and a 35-LED strip fits it as printed: the first and last LEDs overlap slightly at the seam (owner, bench fit, 2026-10-23), so the cup stays as drawn. |
| `segno_screen7_tower` | 1 | **BLACK PETG**, ≥40% infill | 7-inch screen support tower (#762, closed deck #1070). One piece, closed wedge box, six M3 to the floor through Ø5.5 float holes. The deck is closed: four internal front-to-back ribs carry it, and each cell's ceiling is a 45° gable, so **print it flange-down with no support** (there is no way to get support out of a closed box). The openings are the connector notch on the edge facing the console centre, where the module's HDMI, micro-USB and backlight switch are. The strip-ring notch of #1075 is gone again: the ring moved 14.16 mm down the slope (#1090), so **the tower already printed is the current part**; a generator gate keeps the carrier clear of it. |
| `segno_screen16_stand_L` | 1 | **BLACK PETG**, ≥40% infill | Left 15.6-inch stand (#1070). |
| `segno_screen16_stand_R` | 1 | **BLACK PETG**, ≥40% infill | Right 15.6-inch stand: **the exact mirror of `_L`** (either print `_R`, or print `_L` mirrored in the slicer). The halves butt at the screen centre and the splice below joins them. |
| `segno_screen16_splice` | 1 | **BLACK PETG**, ≥40% infill | Flat plate between the deck ribs at the 15.6-inch screen centre. Four M3×12 up into heat-set inserts, two in each half. |
| `segno_screen7_shim_{0p2,0p4,0p8,1p6}` | 1 each | **BLACK PETG**, 100% infill | Height shims under the 7-inch tower: the tower's whole underside (flange ring and rib feet) with the same float holes. The kit is binary, so any stack from 0 to 3.0 mm in 0.2 mm steps is available. **Nominal is 0.2 + 0.8 = 1.0 mm**: the tower is built 1.0 mm short of the lid, so the stack trims it -1.0 to +2.0 mm. Print the 0.2 as a single first layer and check it with calipers; a first layer squashed to 0.15 is a 0.05 mm height error. |
| `segno_screen16_shim_{0p2,0p4,0p8,1p6}` | 2 each | **BLACK PETG**, 100% infill | The same kit for the 15.6-inch stands, one set per stand. The flange outline is not symmetric; for the right stand **turn each shim over**. |

**Ambient light sensor (#1564).** A Vishay TEPT5600 sits in the Ø5.75
window at lid (u 321.86, v 385.0), on the logo's centre line 25 mm above it.
Its dome is sanded off flat and the flat face is the window: there is no light
pipe. The sensor goes in after painting.

1. **Sand only the dome.** The dome is an R2.45 sphere on the Ø5.0 body, and
   the chip sits 4.3 mm below its apex. Measure the apex to the flange's top
   face with calipers first (7.45–7.75 mm). Sand on a flat sheet with the body
   held square, check the face for flatness as you go, and stop as soon as the
   face reaches the cylinder's full Ø5.0, about 2.45 mm down. **Accept the
   part only if the flat face to the flange's top face measures 4.95 mm or
   more**. Below that the sleeve no longer lets the face reach flush, and the
   epoxy over the chip (about the face height minus 3.3 mm, 1.85 mm when the
   face is 5.15) gets thin. Finish with fine grit so the face stays lightly
   frosted, not polished.
2. **Check the sleeve and wire the sensor.** The sensor must slide into the
   printed sleeve freely, flat face first, until the flange meets the seat; if
   it does not, ream the bore to Ø5.45 and the flange pocket to Ø6.3. Cut the
   sensor's leads to about 6 mm below the flange so the joints sit inside the
   lead cavity, solder the lead and sleeve the joints. The load resistor goes
   where the wiring puts it: at the board end of the lead, or here at the
   sensor, where the cavity (Ø10 × 10 mm) also takes a sleeved 0207 resistor
   beside the joints.
3. **Bond it face down.** Lay the painted lid face down on a flat sheet
   covered with release film (packing tape on glass works), weighted near the
   window so it lies flat there. Put black epoxy on the sleeve's seat and on
   the outer half of its bond face only, keeping it away from the bore so none
   reaches the window. Seat the sensor in the sleeve, lower the sleeve onto the
   lid with the sensor through the window, and drop an M5 nut over the leads
   onto the back of the flange so the face stays pressed on the film while the
   epoxy cures. The face lands on the sheet, which sets it flush, and the
   sleeve lands on the lid. The seat is sized for the shortest accepted sensor
   in the thickest painted lid, so the flange never holds the face off the
   sheet: it stands 0–0.45 mm above the seat (0.24 nominal), bedded in the
   epoxy there.
4. Once cured, take the nut off, pull a 2.5 mm cable tie through the tongue
   around the lead, and fill the lead cavity with black neutral-cure RTV (not
   acetoxy, which corrodes the joints). The RTV backs the flange and stops
   light reaching the sensor from behind. Then turn the lid face up, put a
   5 mm tape dot on the sensor face, and fill the 0.1–0.5 mm ring between the
   body and the window with black epoxy from a fine needle; pull the tape
   before the epoxy cures.
5. **Lead route, about 520 mm to J22 on console board v3.** The lead has two
   or three wires, depending on where the load resistor sits. J22's pin map is
   pin 1 +3V3, pin 5 GP28, pin 6 GND (#1564); keep the sensor off pin 2, which
   is +5 V. The resistor value comes with the board-side change for #1564 in
   [`segno_wiring.md`](segno_wiring.md). J22 is unpopulated by default and its
   header is not keyed: fit the 2×3 header first, and mark pin 1 on both the
   header and the plug. Leave about 150 mm of free lead between the tongue and
   the first tie point so the lid can be lifted and set down before J22 is
   unplugged. Then drop the lead behind the rear edge of the BUCK_AUX
   converter (it sits under the sensor, ahead of the PD board) and run it
   along the floor beside the BUCK_AUX feed to the console board.

**Setting the screen height.** Fit each stand on the nominal 0.2 + 0.8 stack,
close the lid and check the glass against the lid underside around the aperture.
Add shims under a stand whose glass sits low, and take them out under one that
holds the lid off its seats. The 15.6-inch stand has one stack per tower, so
left and right can be set separately to level the panel. In-plane, every floor
screw has ±1.25 mm of float (M3 in a Ø5.5 hole under a Ø9 washer): centre
the image in the aperture before torquing. The 15.6-inch monitor is screwed
FIXED to its stands (Ø4.8 clearance for M4); join the two halves with the splice
first, then move the whole platform.

**Ring-holder orientation and fit.** The ribs make this part rotationally
indexed. Use the [top-view alignment reference](enclosure/reference/ring24_orientation.svg):
holder +X points toward the 15.6-inch screen, with the PCB/encoder in the
selected Fusion orientation. The view from underneath is mirrored. Present the
complete Ring 24 board upward from below before gluing the holder; all eight
ribs must enter unoccupied gaps between LEDs and small components. Do not glue
the holder at an arbitrary rotation or force the PCB against its shelf. Fit the
finished 50.62–51.10 mm disc, verify the real header stack and unobstructed
insertion/removal, then check nut clamping, holder retention and light diffusion.
The minimum nominal PCB gap is small enough that printer and purchased-part
variation must be checked on the actual assembly; CAD alone does not qualify it.

Console collar update, September 9: the front and rear light-baffle walls are
2.4 mm thick, growing outward to an overall depth of 118.47 mm. The sled bore,
pedal seating heights and metal-base fixing positions retain their previous
dimensions. The front collar and front sled keep their existing mounting.
The tall CLEAR/BANK collar now has four blind Ø4.5 ×6 mm insert pockets opening
at its bottom face, at local X = ±48.685 mm, Y = ±22.1875 mm. Four
separate Ø3.7 mm deck holes at X = ±30 mm, Y = ±18 mm connect it to the dedicated
mid sled. The metal holes and mini-console are unchanged.

Console collar update, September 12 (issue #1037), integrated September 15:
the CLEAR/BANK collar is solid between its floor and its deck. It replaces
the 3 mm shell and open underside cavity with material that the slicer fills
at the selected infill. Four Ø12 mm driver bores remain, open at the floor
and ending at the deck underside. Each accepts the Ø6 ×3 mm screw head and
Ø8 mm straight driver. CAD volume increases from 165.9 to 420.9 cm³ per
collar; use the slicer's estimate for filament consumption.

Console cable-slot update, September 9: the measured cable feature is
7.6 mm wide ×11.45 mm high. The rear opening is centred and 8.6 mm wide,
with 0.5 mm clearance on each side. Its lower edge sits 6.95 mm above the
bare pedal underside (the sled top). The approximate 6 mm top and 8.5 mm
bottom measurements imply positions 1.05 mm apart on the 24.9 mm case;
the hole clears both with at least 0.5 mm around an assumed stadium-shaped
fitting. The opening is a closed vertical stadium, 8.6 ×13.5 mm overall,
with R4.3 mm ends and 4.9 mm straight sides. Thread the cable end through
before lowering the pedal/sled. Square fitting corners are not qualified by
this profile; check the actual cable/strain relief in the first print before
batching. The mini retains its existing cable notch.

Conditional connector check: a standard JST XHP-2 female housing envelope
7.3 ×5.7 mm, centred while threaded through the hole, clears by 0.628 mm in
both collars. Dimensions come from [JST's XH drawing](https://www.jst-mfg.com/product/pdf/eng/eXH.pdf#page=4).
The owner's description does not uniquely identify the housing; check the
actual plug, latch and cable routing before printing a batch.

PETG starting profile for these collars and sleds: 0.20 mm layers, 40% gyroid,
six perimeters with a 0.4 mm nozzle, and six top/bottom solid layers. Print
collars base-down and sleds flat-bottom-down. The tall CLEAR/BANK collar has
four Ø12 mm driver-bore roofs to bridge instead of a large underside ceiling.
Inspect and avoid unnecessary support inside those bores and the collars'
or sleds' blind insert pockets. Keep a brim optional
according to actual corner adhesion. The first-print archive,
`enclosure/out/segno_first_prints_STL.zip`, contains four STLs: one front collar,
one mid collar, one front sled and one mid sled. Print one of each at 100% scale
and test both assemblies with the actual M3 Ø5 ×5 mm inserts, screws and cable
before batching. These settings and CAD clearance checks do not establish an
assembled stomp-load rating.

For CLEAR/BANK, install the inserts, bolt the pedal to its sled on the bench
and close the pedal case. Thread the cable through the closed stadium opening,
seat the sled, then drive four M3×12 screws upward through the 8 mm deck via
the four Ø12 mm driver bores. Use a straight driver long enough to reach
through the 30.3 mm bores, with the screw held on its tip. Mount that complete
module to the bottom metal base with four separate M3 screws, using the
confirmed rail-inclusive length from the hardware schedule below. To service
the sled joint, release the base screws and remove the complete module first;
the deck screws are not
accessible while the module is attached to the base. This replaces the long
through-screw arrangement without adding faceplate fixings.

The Cherub WTB-006 uses side through-screws. Install these on the bench before
putting the pedal/sled assembly in the collar; the enclosure does not provide
clearance to withdraw the full-width screw sideways after assembly.

FDM tiles stay the prototype / fit-check path. Production nameplates are the
2-ply pack in the next section.

## 2b. 2-ply engraved plastic (pedal name tiles)

Send **`enclosure/out/segno_pedal_tiles.pdf`** to a 2-ply laser shop
(1:1, red cut / black fill). The zip also carries the DXF if they ask for
CAM. **Not metal, not vinyl, not a 3D print.**

| Part | Qty | Material | Notes |
|---|---|---|---|
| `segno_pedal_tiles` | 10 | **2.0 mm 2-ply** (black cap / white core) | Same trapezoid as the FDM tiles: 54.36 (back) / 53.76 (toe) × 19.90. 2.0 mm is the closest standard stock to the 2.2 mm pad pocket — the tile sits 0.2 mm recessed. **CUT** = outline (through-cut). **ENGRAVE** = filled glyphs (burns the black cap so the white core reads). Glyphs are geometry, never TEXT — do not substitute a font. **Fit the WIDE edge toward the cable end**; it carries the top of the glyphs. REC/PLAY and STOP use the transport symbols engraved on the pedal tiles. Dimensions are nominal: the 0.05 mm per-side clearance is already in the part; the shop applies kerf compensation and must not enlarge the outline. |

Regenerate with `segno_enclosure.py` (or `--tiles-only`). The zip is a
per-quote artifact, same freshness gate as the other vendor packs (#236).

## 2c. Transfer-cut vinyl decals

Send **`decals/out/segno_decals_cut_sheet.pdf`** (or its `.dxf`/`.svg`) to a
vinyl-cutting shop: **white matte cast vinyl** (e.g. Oracal 851/951), one
colour, cut 1:1, weeded, on clear transfer tape. Generated by
`decals/decals.py`; every outline stays a curve end to end (Beziers in PDF/SVG, splines in the DXF) and every stroke and gap is checked at ≥ 0.6 mm. A 15 KB `segno_decals_cut_sheet_compact.pdf` exists for email.

| Decal | Size | Where | Notes |
|---|---|---|---|
| `segno_decal_logo` | 125.9 × 42.6 mm | Lid, above CLEAR/BANK (lid u 258.9–384.8, v 317.4–360.0) | The segno glyph and wordmark as true curves from the type itself (the brand glyph SVG and Apple Chancery), each part placed exactly on the Fusion clone's `segno_logo` body (`decals/reference/segno_logo_lid.json`) and checked against it. Place with `segno_decal_logo_placement.pdf` printed 1:1 on A4: line its red outlines up with the CLEAR/BANK light slots. |
| `segno_decal_rear` | 382.8 × 10.0 mm, one strip | Rear wall, labels on one row (baseline 63 mm above the floor top), above every connector's flange | USB-C PD IN, POWER, FUSE T5A, MIDI IN, MIDI OUT, CTRL 1, CTRL 2, USB, USB, and the protective-earth symbol over the earth stud. Helvetica Neue Bold, 4.5 mm caps (the tiles' Light would be too thin to cut). Laid out as seen from behind; positions follow `rear_io_layout()`. Place with `segno_decal_rear_placement.pdf` (1:1, 404 mm long: A3 or two A4 taped). |

Apply after the powder coat has fully cured, on a clean, degreased surface.
The rear labels can go on with the connectors fitted: they clear every flange
by 2 mm.

## 3. PCBs

| Board | Files | Qty | Notes |
|---|---|---|---|
| **Console board v3.2** | `kicad/fab/segno_console_v3_2_gerbers.zip` + `kicad/fab/segno_console_board_bom.csv` | 1 | **Owner review required before ordering (#1388, #1391).** 99.5 × 99.5 mm, two layers, 1.6 mm FR4, 1 oz, purple mask / white silk, lead-free HASL. Solder Pico 2 by its castellations as specified in the assembly guide. Hand-solder the 15 surface-mount protection parts on the back (D2–D6, R23–R32) first. Use the runtime that reads MODE on GP12. |
| **Encoder ring carrier** | `kicad/fab/segno_pedal_ring_gerbers.zip` + `kicad/fab/segno_combined_bom_lcsc.csv` | 1 | Ø80 mm with the Same Sky ACZ11BR1E-20FD1-20C encoder (measured on the assembled board, 2026-10-16), two layers, 1.6 mm FR4, 1 oz, white mask / black silk, lead-free HASL. Selected assembly: the #1075 console strip ring, one 35-LED strip with DIN at J2.3 and direct AUX power; J3/J4 empty (owner, 2026-10-19). The Ring 24 (J3) and 24/16-module footprints remain on the board as alternatives. The populated Fusion console carries this board (`ring_board_v3`). See [assembly](kicad/RING_ASSEMBLY.md). |
| **Screen power Rev P** | `kicad/fab/segno_screen_power_rev_p_gerbers.zip` + `kicad/screen_power/hand/bom.csv` + `kicad/screen_power/external_bom.csv` | 1 | 68 × 76 mm, R3 corners, two layers, 1.6 mm FR4, 1 oz, purple mask / white silk, ENIG. Hand-soldered components. Four five-pin XH USB plugs include the shield on pin 5. F1 uses one replaceable 8 A cartridge in its onboard holder; four branch fuses are soldered. See [wiring and assembly](kicad/screen_power/README.md). |
| LED puck (single WS2812B) | `led_strip/segno_led_strip_gerbers.zip` | 0 | **NOT ORDERED for the console.** Owner call 2026-08-28: the indicators are eight-LED segments cut from a **144 LEDs/m bare IP20 strip**, and the diffuser channel is sized for that (**12 mm wide, 0.53 thick**, 56.96 long), not for this 16×8 board. The design is kept because it is finished and the footprint may suit another build — but ordering it will not fit the current diffuser. |

The quantities above are the one-unit assembly need; JLCPCB's order is five
individual copies of each board. Use only the ZIP hashes in the
[current manufacturing record](https://github.com/tomassasovsky/segno/blob/claude/segno-integration/docs/reviews/pcb-finish-all-three-1072/manufacturing-zips.json).
Older exports in other directories are superseded. The
[current adversarial review](https://github.com/tomassasovsky/segno/blob/claude/segno-integration/docs/reviews/screen-power-ground-cleanup-1072/review.md)
records the completed corrections, review coverage and verification. No stencil or factory
component assembly is required. The selected 35-LED strip uses the direct AUX
star harness in [the ring assembly guide](kicad/RING_ASSEMBLY.md); J2 carries
DIN only. Do not reuse the superseded straight-through console/ring power wiring.

### Console v3.2: MODE on GP12 and protected footswitch inputs

Console v3.2 is v3 with two changes. Neither has been fabricated yet.

**MODE on GP12 (#1388).** The MODE footswitch moved from GP5 (Pico pin 7) to
GP12 (Pico pin 16). The first v3 console's Pico 2 has a dead GP5, and the
firmware now reads MODE on GP12 on every board. The MODE header J13 is the
rightmost footswitch header, J22 pin 3 (GP12 on v3) is unconnected, and GP5 is
not brought out.

**Protected footswitch inputs (#1391).** On v3 each footswitch header's pin 1
ran straight to its GPIO. GP5 most likely died from something arriving down
the MODE cable: ESD from a foot on the pedal, or a supply rail touching the
line. The RP2350's footswitch pins are rated 4 kV HBM, a component-handling
rating far below what a cable can deliver. Each input is now, from the cable
in: a clamp to GND at the connector, a 1 kΩ series resistor, then the existing
100 nF cap at the Pico pin.

- **Clamp, D2–D6:** Nexperia PESD5V2S2UT (LCSC C18441), two unidirectional
  TVS diodes with a common anode in SOT-23, so each part covers two
  neighbouring footswitches. Stand-off 5.2 V, leakage 1 µA maximum, IEC
  61000-4-2 level 4 (8 kV contact, 15 kV air), 330 W at 8/20 µs. A
  general-purpose 5 V TVS such as SMAJ5.0A leaks up to 800 µA and would hold
  a line low against the Pico's 32–86 kΩ pull-up, so do not substitute one.
- **Series resistor, R23–R32:** 1 kΩ 1206. With the cap on the Pico side it
  forms a 100 µs low-pass behind the clamp, so the clamp's residual moves the
  pin by about 20 mV.
- **Timing is unchanged.** A press reaches the pin in 0.14 ms and holds it at
  0.10 V or less. A release crosses the input-high threshold after 3–8 ms, as
  on v3. The firmware's 8 ms stable-edge debounce is unchanged.
- **What it covers.** ESD and a 5 V rail touching a line (the pins tolerate
  5.5 V while powered; the resistor limits current when they are not). A
  sustained short to the 20 V PD rail drives the clamp past its rating; it
  normally fails short, so that input reads pressed, while the resistor limits
  the pin's current to about 15 mA. Keep the 20 V wiring away from the
  footswitch harness.

The fifteen protection parts are surface-mount, on the back, between each
debounce cap's pin 1 and its header's pin 1. They are the only SMD parts on
the board, sized for an iron (1206 and SOT-23 on hand-solder pads). Fit them
before the through-hole parts, while the board lies flat. The silk reads
`SEGNO CONSOLE v3.2`.

The board was re-routed in full by `kicad/route_console_board.sh`, so every
track differs from v3. The 40-LED ring supply's hand-routed back path now
runs straight down the left edge and changes layer between the TRK1 and TRK2
columns (x 39.4 instead of 41.8), clear of the new parts. Its archive,
`kicad/fab/segno_console_v3_2_gerbers.zip` (SHA-256 `4ee0091d5773fc834b965d0adbf15a9e7c4e2c51a483da941e84e53d29fd0b90`), is not in
the manufacturing record above, and it needs the owner's review before anyone
orders it. It replaces the v3.1 archive of #1388, which was never ordered. The
v3 archive that record names, `kicad/fab/segno_console_v3_gerbers.zip`, stays
unchanged as the record of the built v3 boards; do not order it again. Built
v3 boards keep unprotected inputs; the MODE rework below is still required.

**Rework for a built v3 board** (silk `SEGNO CONSOLE v3`). Do this before
running the firmware that reads MODE on GP12, or MODE never registers. Every
built v3 board needs it, not only one with a dead GP5, because the firmware
reads MODE on GP12 on every board. It is the rework done on the owner's unit.

1. Power off and unplug the console. If the Pico 2 is socketed, lift it out.
2. Isolate Pico pin 7 (GP5) from the board. On a socketed module, clip that
   pin's header pin flush with the module, or pull the matching contact out of
   the socket strip, so pin 7 no longer reaches the board. On a module
   soldered by its castellations, unsolder pad 7 and keep it lifted with
   Kapton tape.
3. On the underside, solder an insulated jumper (30 AWG wire-wrap wire is
   enough) from socket pin 7 to socket pin 16. Pin 7 is SW_MODE (J13 pin 1
   and C4); pin 16 is GP12.
4. Leave J22 pin 3 unconnected. On v3 it is wired to GP12, so after the
   rework it carries MODE.
5. Keep C4 fitted. The owner's unit had one C4 lead cut during the
   diagnosis; MODE works without it but loses its 100 nF debounce, so
   resolder it.
6. Check before refitting the Pico. Console off: J13 pin 1 to socket pin 16
   is continuous; J13 pin 1 to ground is open. Refit the Pico, then confirm
   module pin 7 has no continuity to J13 pin 1. With the GP12 firmware
   installed and the console on, MODE released: socket pin 16 reads about
   3.3 V. Pressed: 0 V.

Console CTRL J20/J21 use four wires: T / R / S / **RN**, with the Neutrik
NJ6FD-V's ring-normal terminal on pin 4. Leave TN/SN unconnected. This leaves
the ADC tip unloaded while the jack is empty. R11/R12 bias the UART pair from
the console Pico's own `+3V3_PICO`, retaining idle high with the Pi off. Follow
the [current jack and ring wiring](segno_wiring.md).

The new console and carrier runtime is in
[PR #1082](https://github.com/tomassasovsky/segno/pull/1082), published at
`53828fc4eae1c18af45abfc3ea7c31f19f9799d7`. It includes the A2 Pico E9 workaround,
ring link and PD reader; the hardware branch's old firmware snapshot does not.
Program the Pico before fitting it, or disconnect console J3/J6/J24 before
connecting its USB cable; remove USB before reconnecting those headers. Use
SWD for normal in-place programming. For XIAO USB programming, turn AUX off
and unplug ring J1; keep the strip off until USB is removed and J1 is restored.

The runtime remains an integration draft. Fabricating these boards does not complete
runtime integration, device qualification or the enclosure work below.

The enclosure (#1088) places this board behind CLEAR/BANK on M3 × 10
standoffs at its four Revision P holes; see
[the enclosure release review](enclosure/RELEASE_REVIEW.md). The original
placement proposal is in
[the enclosure clearance assessment](https://github.com/tomassasovsky/segno/blob/claude/segno-integration/docs/reviews/pcb-completion-1072/screen-power-placement.md).
The bare PCB outline and mounting centers are fixed.

## 4. Pedal labels

The individual pedal tiles carry every pedal label. No full-face adhesive
overlay or separate overlay supplier package is required; the only decals are
the logo and the rear connector labels (section 2c).

## 5. Purchased parts

Full list with links: **`segno_console_shopping_list.md`**; the console board's
parts are `kicad/fab/segno_console_board_bom.csv`. Headlines:

- 10× Cherub WTB-006 footswitches; 15.6" 5V USB-C touch panel; APROTII 7" monitor
- Raspberry Pi 5 + Active Cooler
- Same Sky **ACZ11BR1E-20FD1-20C** encoder and separately sourced
  **SJ5-43502PM-nut**, no washer; [ring fit contract](kicad/RING_ENCODER.md)
- 5V bucks: **eleUniverse 8–36V→5V 10A IP67** (Amazon B0GGHN97TK) **×2** —
  BUCK_PI + BUCK_AUX, fed 20 V from the USB-C PD inlet (#754); the 9 V brick
  is gone
- 1× **encoder knob, Ø50 × 18, Ø6 bore, black aluminium, plain (un-knurled) barrel** —
  the ring window and `segno_ring_diffuser` are sized around this Ø50. `out/segno_encoder_knob.step`
  is a REFERENCE model of it for the assembly, deliberately **not** in the 3D-print pack.
  Check one thing with calipers before the faceplate is cut: the model assumes a Ø22 × 4.5
  underside relief clearing the encoder's M7 nut. If the real knob's underside is solid it will sit
  ~3 mm proud of where the model puts it.
- 1× fitted **35-LED WS2812B strip** (owner, 2026-10-19, #1075), connected to
  carrier J2 in its separate
  [strip housing design](https://github.com/tomassasovsky/segno/pull/1083).
  The older `segno_ring_diffuser` and enclosure window described above are the
  24-LED alternative, not the selected strip ring.
- 1× **Panasonic EEUFR1A102**, 1000 µF / 10 V, fitted across the strip's
  own power entry with insulated lead joints; allow its 10 × 16 mm body
  beside the harness. See [polarity and assembly](kicad/RING_ASSEMBLY.md).
- Ambient light sensor (#1564): 1× **Vishay TEPT5600** (genuine; Amazon
  B06X3VS2HS, pack of 10); the J22 2×3 header (Würth 61300621121, optional
  in the shopping list, required here) and a matching 2×3 2.54 mm socket
  housing with crimp contacts; about 520 mm of two- or three-core lead; one
  2.5 mm cable tie; one M5 nut as a curing weight; black two-part epoxy; and
  black **neutral-cure** RTV silicone (acetoxy corrodes the joints). The load
  resistor comes with the board-side change in `segno_wiring.md`.
- Cabling per **`segno_wiring.md`** (HDMI ×2, USB, the 20 V PD feed + 5 V buck
  runs, the 2×20 keyed ribbon, JST looms)

### Console hardware schedule — one ten-pedal console

Quantities below cover the current collar-and-sled assembly. Screw lengths are
measured under the head. A nominal length is not a substitute for checking the
finished stack, actual insert depth and screw-tip clearance. Rows marked
**measure before ordering** have no released screw length.

| Joint | Quantity and hardware | Length / assembly requirement |
|---|---|---|
| Pedal sled inserts | **80 M3 heat-set inserts**, 5.0 mm long ×5.0 mm OD | Eight front sleds and two dedicated mid sleds, each with four inserts from above and four from below. Printed pilots are Ø4.5 ×6.0 mm deep; fit-test the selected insert in the printed material. The two sled variants have different lower patterns. |
| CLEAR/BANK collar inserts | **8 M3 heat-set inserts**, 5.0 mm long ×5.0 mm OD | Four from below per tall collar, in Ø4.5 ×6.0 mm blind pockets in its solid floor. These are additional to the 80 sled inserts, giving 88 inserts across the console's pedal platforms and sleds. |
| Front-row collars and sleds → base | **32 M3 screws; confirm length before ordering** | Four per pedal, driven upward from under the base. Include any shared floor-rail bearing stack, coating, washer and insert recess in the length check. The earlier M3×8 estimate excluded the rail stack; verify engagement and head clearance on the current assembly. |
| CLEAR/BANK collars → base | **8 M3 screws; confirm length before ordering** | Four per collar into its bottom inserts. Include the actual floor-rail/metal/coating stack where present. The earlier M3×6 estimate is not a released length for the revised support arrangement; check engagement and blind screw-tip clearance. |
| CLEAR/BANK sleds → collars | **8 M3×12 screws**, nominal | Four per sled on a 60 ×36 mm pattern, driven upward through the 8 mm deck before mounting the module to the base. Nominal insertion is 4.0 mm before any washer or insert recess. Each screw head and straight driver fit inside a Ø12 mm bore, 30.3 mm deep; use a long driver with the screw held on its tip. Check the actual hardware and remove the complete module for service. |
| Pedals → sleds | **40 M3 screws; measure before ordering** | Four per pedal, driven from inside the opened pedal into the sled's top inserts. Remove the lower rubber pad. Measure the real pedal base thickness, head-bearing surface and permitted insertion; close the supplied pedal case on the bench before lowering it into the collar. Reuse the pedal's original case fasteners. |
| Lid → base | **18 M3 ISO 7380-1 button-head screws, 9 front OD7 washers and 9 rear OD12 / ID3.2 / 1 mm washer references** | Nine front plus nine rear, into owner-tapped M3 pilots. M3×8 is a nominal reference; confirm length, engagement and screw-tip clearance against the revised shim/washer stack. Rear washer procurement and angular seating remain conditional. No clinch nuts. |
| Front lid lip → base, between painted bearing faces | **9 fitted solid-metal shim packs**, layer quantity depends on finished gaps | Stainless, OD6.90–7.00 / ID4.0–4.2 mm. Fit after coating with the lid freely seated; nominal 1.10 mm STEP thickness is reference only. Check face alignment and bearing, then record thicknesses and stations 1–9. Use edge-only retention, without coating removal or adhesive in the bearing stack. |
| Support-beam foot → base | **9 M4 screws, 9 nuts and washer sets; measure before ordering** | The beam's foot, through depth-slotted holes, one at each of the lid's nine front screw stations (#1090): each interior pedal gap plus one outboard of each end pedal. Bare metal stack is **3.6 mm**; add both parts' coating, washers and the selected nut. Nuts are under the floor. Check that the ends and hardware remain above the neoprene floor-contact plane. |
| Screen stands → base | **14 M3 screws and 14 M3 DIN 9021 washers (Ø9); confirm length before ordering** | Six for the 7-inch tower and four for each 15.6-inch stand. Each passes a Ø9 washer, **5 mm of printed flange, 0–3.0 mm of shims** (1.0 nominal) and the 2 mm base's M3 threads. The flange holes are Ø5.5 float holes, so the washer is what bears. M3×10 covers the full shim range; verify engagement and tip clearance after coating. |
| 15.6-inch stand splice | **4 M3×12 screws and 4 M3 heat-set inserts** (the sleds' 5.0 mm long ×5.0 mm OD) | Two per half, up through the 6 mm splice plate into Ø4.5 ×6.0 mm blind pilots in the 10 mm deck. Blind from below on purpose: the deck's top face sits 0.3 mm off the monitor, with no room for a head. |
| 15.6-inch monitor → stands | **2 M4×16 screws and 2 M4 DIN 125 washers (4.3 × 9 × 0.8); measure the thread depth before ordering** | One horizontal pair at 75 mm pitch, up from under the deck. The holes are **fixed** Ø4.8 clearance (#1070); the monitor no longer adjusts on the stand. The spliced stand pair moves as one platform on its ±1.25 mm floor float holes instead. Stack under the monitor: washer 0.8 + deck 10 + gap 0.3 = 11.1 mm, so M4×16 engages about 4.9 mm. The reference model's 6 mm blind holes were not measured, so check the monitor's real thread depth first. |
| 7-inch monitor → tower | **4 M3×8 screws and 4 M3 heat-set inserts** (5.0 mm long ×5.0 mm OD, the sleds' insert) | One per tab, through the module's Ø3.1 tabs (1.7 mm) into Ø4.5 ×6.0 mm pilots in Ø10.5 bosses (#1070). Below the insert there is a Ø3.4 clearance, so a longer screw passes rather than self-tapping. Set each insert flush with the boss top: a proud insert holds the glass off the lid. |
| Console board → base | **4 M3 female/female standoffs, 15 mm body length, plus 8 M3 screws; measure screw lengths before ordering** | Four floor-side and four board-side screws. Include any washers in the length check and preserve the specified H1 electrical bond. If the supplied standoffs are male/female, replace the four floor-side screws with the matching nuts instead; the installed height stays 15 mm. |
| N07 / Raspberry Pi → base | **4 M2.5 female/female standoffs, 12 mm body length; 4 M2.5 male/female extenders, 6 mm body length; 8 M2.5 screws** | Four screws secure the lower standoffs from below and four secure the Pi from above. The extenders pass through the N07 board into the lower standoffs. Confirm the supplied kit's thread lengths and avoid bottoming in its blind threads. **35.3 mm risers are not used.** Retain the N07 kit's separate SSD-retaining hardware. |
| Buck converters → base | **4 M4 ISO 7380 button-head screws (in from below), 4 nuts, 4 Ø12 mm ear washers; measure before ordering** | Two fixing points per converter, through its Ø6.5 ±0.3 ears. The heads sit under the floor inside the rear rail's pockets (#1088), so nothing else may stack under them. Measure actual ear thickness, washer-bearing area, insulation if required and tool access. The approximate housing STEP does not qualify these washers. Check the completed underside stack against the fitted rails and neoprene. |
| PD, CTRL and MIDI connectors → rear wall | **10 M3 fixing sets**, each screw plus matching nut as required by the purchased part | Two for the PD coupler, two for each CTRL D-flange socket and two for each MIDI socket, through the 2.0 mm painted rear wall. Confirm the real flange thickness, screw-head style, washers and whether matching fasteners are supplied before choosing lengths. |
| Other rear connectors | **2 USB bulkhead retaining nuts; 1 power-button nut; 1 fuse-holder nut** | Use the matching hardware supplied for each purchased connector. The USB apertures must follow the owner's verified four-flat profile; verify all finished openings against the purchased parts. |
| Floor rails → base | **Fixings for 12 printed rail segments; lengths and bearing stacks to confirm** | Preserve shared pedestal fixing stations and the rear rail's eight dedicated anchors from the matching source/native revision. Keep heads within the printed counterbores and all hardware above the neoprene floor-contact plane. Fit rails before the strips; check actual fastener retention and access. The former 15 rubber feet are not ordered. |
| Central lid prop → base | **2 M4 fixing sets; measure before ordering** | Use the existing two floor stations. Include printed tongue thickness, coating, washers and nut in the stack; verify underside clearance. Fit top felt after measuring the finished lid gap. |
| Encoder / ring assembly | **1 matching EC11 bushing nut and washer; supplied knob retaining hardware** | The EC11 nut clamps the centre disc into the holder; the holder's outer land is glued to the faceplate underside. Verify this assembled retention and the knob's underside relief. Fusion deliberately uses the owner's PR #990 Ø80 board without mounting holes, as recorded in `enclosure/FUSION_MODELS.md`; the checked-in Ø68/three-hole PCB is a different revision. Reconcile the electronics order with that chosen revision; no three-M3-screw set is implied for the native assembly. |
| Chassis bonding | **1 M6 stud fixing set**, with the nuts, locking washers, lugs and straps required by the agreed bonding arrangement | Select the complete stack and its length against the actual lug arrangement and verify continuity. The connector shells sit on the painted rear wall and reach chassis ground through the board (H1); there is no rear-panel bond since #1088. Do not add parallel grounding connections by assumption. |

The split CLEAR/BANK joints add eight screws and eight inserts to the previous
console mounting arrangement. No long through-screws are required.

Before releasing the remaining lengths, measure the front chassis, mid chassis
and mid deck screw stacks, pedal bases, monitor threads, 7-inch tower insert
fit, converter ears, floor rails and
selected standoff threads. Confirm the ring-board retention and chassis-bonding
hardware as assembled. All hardware below the base must clear the supporting
surface with the actual rails and neoprene fitted.

**Mini-console hardware is a separate order.** None of its inserts, sled
retention screws or lid screws is included in the ten-pedal console quantities
above. Derive that order from its own current tray/sled/lid revision; the old
combined “8 pedestal inserts +3 lid inserts” allowance is not a console BOM.

For the current two-pedal mini, print **one tray, one lid and two sleds** from
the same revision. Each sled now has **two retention screws**, 60 mm apart on
its depth centre-line; an old central-hole tray does not match the new sled.
The assembled reference includes both sleds. Keep its order separate:

| Mini joint | Quantity | Fit requirement |
|---|---|---|
| Pedal → sled | **8 M3 screws and 8 M3 heat-set inserts** | Four from above per pedal. Remove the lower pad; confirm the actual pedal-base thickness and screw-head clearance before ordering screw length. |
| Sled → tray | **4 M3 retention screws and 4 M3 heat-set inserts** | Two from below per sled at local depth ±30 mm, width 0. Printed insert pilots are Ø4.5 ×6.0 mm, leaving a 1.0 mm roof. Use/test 5.0 mm-long ×5.0 mm-OD inserts. M3×10 is nominal: the 6.176 mm head-seat stack leaves 3.824 mm insertion without an extra washer; measure actual grip and blind clearance. |
| Lid → tray | **3 M3 screws and 3 M3 heat-set inserts** | Two rear and one front anchor. Confirm each actual screw reach and the tilted insert fit; do not use the sled screw length for the taller lid anchors. |

That is **15 inserts total** for the mini, with its screw lengths qualified
by joint. Its two Ø8.5 recessed head/driver pockets per sled remain accessible
from below and keep the screw heads above the table. Remove both retention
screws before lifting a sled; do not force a rod into its blind insert. Verify
simultaneous screw fit, seating, anti-rotation and repeated removal on one
printed pair before printing or ordering the full mini set.
The sled's toe relief is required to clear the sloped lid; retain all six blind
insert pilots and their opposite-face roofs. The current lid has its two rear
registration tabs between the diffusers and 8.5 mm-wide rear insert bosses at
the unchanged anchor axes. A Ø5 insert leaves 1.75 mm of material on each side
of those bosses: qualify insertion and tightening in the chosen print material.
Check both pill diffusers against the lid tabs/bosses and the actual electronics
before gluing. The old lid and unrelieved sled are not interchangeable with this
verified assembly.

## 6. Reference (do not send to vendors)

- `enclosure/out/segno_assembly.step` — full folded assembly
- `segno_enclosure_design.md`, `segno_wiring.md` — design + wiring
- Fusion cloud docs: "VAMP sheet metal" (native sheet-metal validation) and
  "VAMP console (populated)" (full visual assembly)
