tomassasovsky/segno-hardware/hardware/kicad/RING_ASSEMBLY.md

<!-- cspell:words EEUFR -->
<!-- cspell:words XIAO NeoPixel Seeed VBUS castellations HASL UF2 Taiyo -->
# Ring carrier — first fabrication

This is the new XIAO ring/encoder carrier. J3 and J4 are alternative direct
footprints for purchased 24-LED and 16-LED modules; J2 exposes +5 V, GND, DIN
and DOUT for the selected external 35-LED strip in its own housing. The current
old console drives its strip through a passive encoder assembly instead.
Keep those hardware generations and their firmware pin maps separate.

The ring carrier is an 80 mm circular, two-layer FR4 board, 1.6 mm thick with
1 oz copper. Order **white solder mask and black silkscreen**, lead-free HASL,
tented vias and five individual boards. No stencil, assembly, controlled
impedance, edge plating or castellated-hole service is needed.

White replaces the earlier purple finish to reduce coloured reflections
around the LEDs. The purchased NeoPixel module retains its own board colour.
See [Taiyo's discussion of white masks for LEDs](https://www.taiyo-america.com/index.php/media-resources/news/solder-mask-led-applications-formulation-101/).

The September 25 export supersedes the September 24 ZIP. It adds
a retained 1.5 mm power feed to J2 and three parallel ground-return vias,
retaining the two-layer, 1 oz construction and all component positions.
The console feed was upgraded with it. This carrier copper supports the
module alternatives; the selected 40-pixel strip now uses the direct AUX
harness below, so passing carrier power checks does not verify that harness. See the
[40-pixel verification](https://github.com/tomassasovsky/segno/blob/claude/segno-integration/docs/reviews/ring40-full-white-1072/verification.md).

The September 26 copper-finish export supersedes those earlier ZIPs.
It rounds the main feed and signal bends while retaining the two straight
C5/U2 power taps with rounded bases. The 1.5 mm feed, three ground-return
vias and component positions remain. Use the archive in the
[current manufacturing record](https://github.com/tomassasovsky/segno/blob/claude/segno-integration/docs/reviews/pcb-finish-all-three-1072/manufacturing-zips.json),
verified by the [three-board audit](https://github.com/tomassasovsky/segno/blob/claude/segno-integration/docs/reviews/pcb-finish-all-three-1072/audit.md).
The retained hole allowances include 1.10 mm
holes for J1's JST XH pins and 1.25 mm holes at J3/J4 for the loose module
support pins. Keep these allowances when updating footprints.

## Assembly

- Connect the selected 35-LED strip **DIN to J2 pin 3 only**. Leave J2
  pins 1/2/4 unconnected. Feed strip +5 V/GND directly from the near-ring AUX
  split described below; this preserves full-white voltage margin.
  Alternatively fit one 24-LED module at J3 or one 16-LED module at J4, with
  firmware matching that LED count. Populate only one LED option.
- Match the loose support pins to the purchased ring's own holes. Its holes
  still constrain the pin stock even though the carrier now has more allowance.
- Solder the XIAO RP2350 module to U1's castellated pads. Discrete parts are
  through-hole. The encoder is **Same Sky ACZ11BR1E-20FD1-20C**, with a 20 mm D shaft,
  M7×0.75 threaded bushing, push switch and 20 detents. Use this exact part:
  similarly named EC11 parts have different mounting tabs and detent phases.
  Hand solder its terminals at at most 350 °C for at most 3 seconds. See the
  [encoder drawing and fit contract](RING_ENCODER.md). Clamp the 2 mm disc
  with the separately sourced SJ5-43502PM-nut and no washer. The level shifter is a
  74AHCT125 in DIP-14. Observe diode and electrolytic polarity.
- Ring J1 pins 1/2 take +5 V/GND from the same near-ring AUX split through
  their own short 22 AWG pair. J1 pins 3/4 connect to console J6 pins 3/4.
  Leave console J6 cavities 1/2 empty. This is **not a straight-through power
  cable** in the selected 40-pixel assembly.
- Run at most 600 mm of 16 AWG copper supply/return from AUX to the insulated
  split, then separate pairs at most 50 mm long to the strip and J1. Use
  22 AWG XH pigtails; do not crimp the thicker trunk into XH. Keep DIN at most
  100 mm and beside the local ground leads. Add strain relief. See the exact
  [wiring and voltage bounds](../segno_wiring.md#console-board--ring-board-and-the-full-white-power-harness).
- Fit a separate **Panasonic EEUFR1A102, 1000 µF / 10 V** radial capacitor
  directly across the strip's power entry: positive lead to +5 V and striped
  negative lead to GND. Keep leads short, sleeve each soldered joint separately
  and secure the body with strain relief outside the optical area, leaving its
  pressure vent unobstructed. The part is 10 mm diameter × 16 mm long; allow
  this space in the harness, not on the carrier. Its
  [manufacturer specification](https://industrial.panasonic.com/ww/products/pt/aluminum-cap-lead/models/EEUFR1A102)
  gives at most 28 mΩ impedance at 100 kHz. Carrier C1 remains fitted but
  is not the local strip-entry capacitor. This follows the
  [NeoPixel supply-entry recommendation](https://learn.adafruit.com/adafruit-neopixel-uberguide/best-practices).
  Assemble with power disconnected; the capacitor buffers load changes and
  is not an inrush limiter or permission to hot-plug the strip.
- Fit C2/C3/C4 as **10 nF Vishay K103K10X7RF53H5**. C5 remains 100 nF.
  Both ground pours now use through-hole thermal relief for hand soldering;
  observe the encoder's 350 °C / 3 s terminal limit.
- The carrier snap-mounts; it has no screw mounting holes.

The 40-pixel full-white design budget is 2.4 A for LED channels plus a 40 mA
idle allowance. The ring controller has a further 200 mA allowance, supplied separately
from the same local split. The long console power route carries none of the
selected strip current. Existing firmware brightness and animations are unchanged; the PCB
does not depend on their limit. The shared 10 A AUX supply is not sized for
all 120 LEDs and both screens at their simultaneous maximum. See the
[system power budget](../segno_wiring.md).

## Programming

**Turn AUX power off**, then unplug **J1 before connecting the XIAO USB cable**.
Keep the separately powered strip off while programming, so its DIN input is
not left floating on a powered strip. Remove USB and reconnect J1 before
restoring AUX power. D1 prevents USB from powering the AUX harness, but it does not prevent live
AUX power from reaching a connected USB host. See the
[Seeed schematic](https://files.seeedstudio.com/wiki/XIAO-RP2350/res/Seeed-Studio-XIAO-RP2350-v1.0.pdf).

Install the separate ring UF2 using XIAO BOOTSEL. Use `firmware/ring_board` from
[runtime PR #1082](https://github.com/tomassasovsky/segno/pull/1082), published
at `53828fc4eae1c18af45abfc3ea7c31f19f9799d7`, together with its matching console
firmware. The firmware snapshot on the hardware branch is not the completed
v3 runtime. The console's SWD updater does not program this module.
No USB cable is needed on the ring during normal operation.

The electrical checks, firmware pin map and KiCad DRC pass. Actual encoder,
LED and assembled-system behavior will be checked on the first assembled board.
No further owner measurements are required before bare-PCB fabrication.
