tomassasovsky/segno-hardware/hardware/kicad/screen_power/hand/screen_power_hand.kicad_pcb

## KiCad design hardware/kicad/screen_power/hand/screen_power_hand.kicad_pcb (2026-10-20)

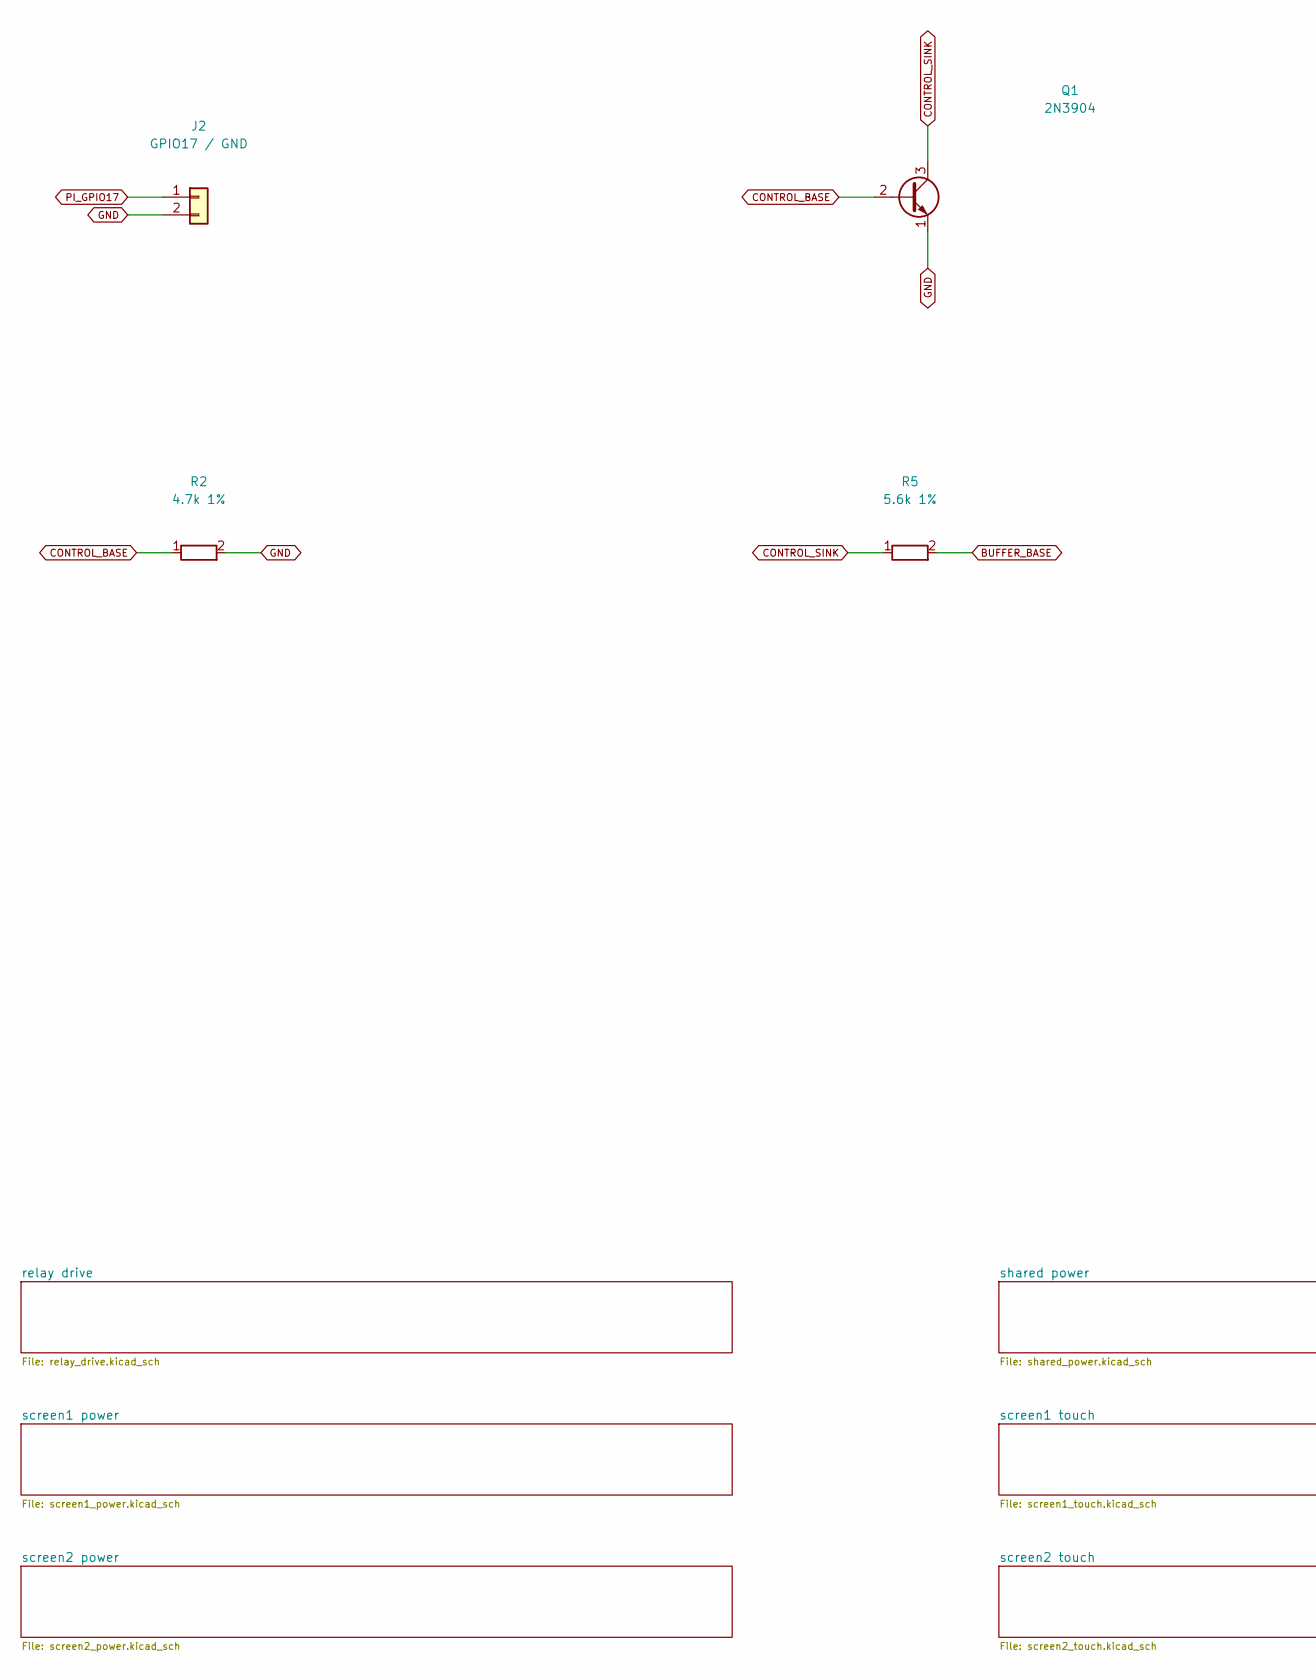
[picture p45: schematic screen_power_hand.kicad_sch, Segno screen power / hand / control, part in row 1, column 1]

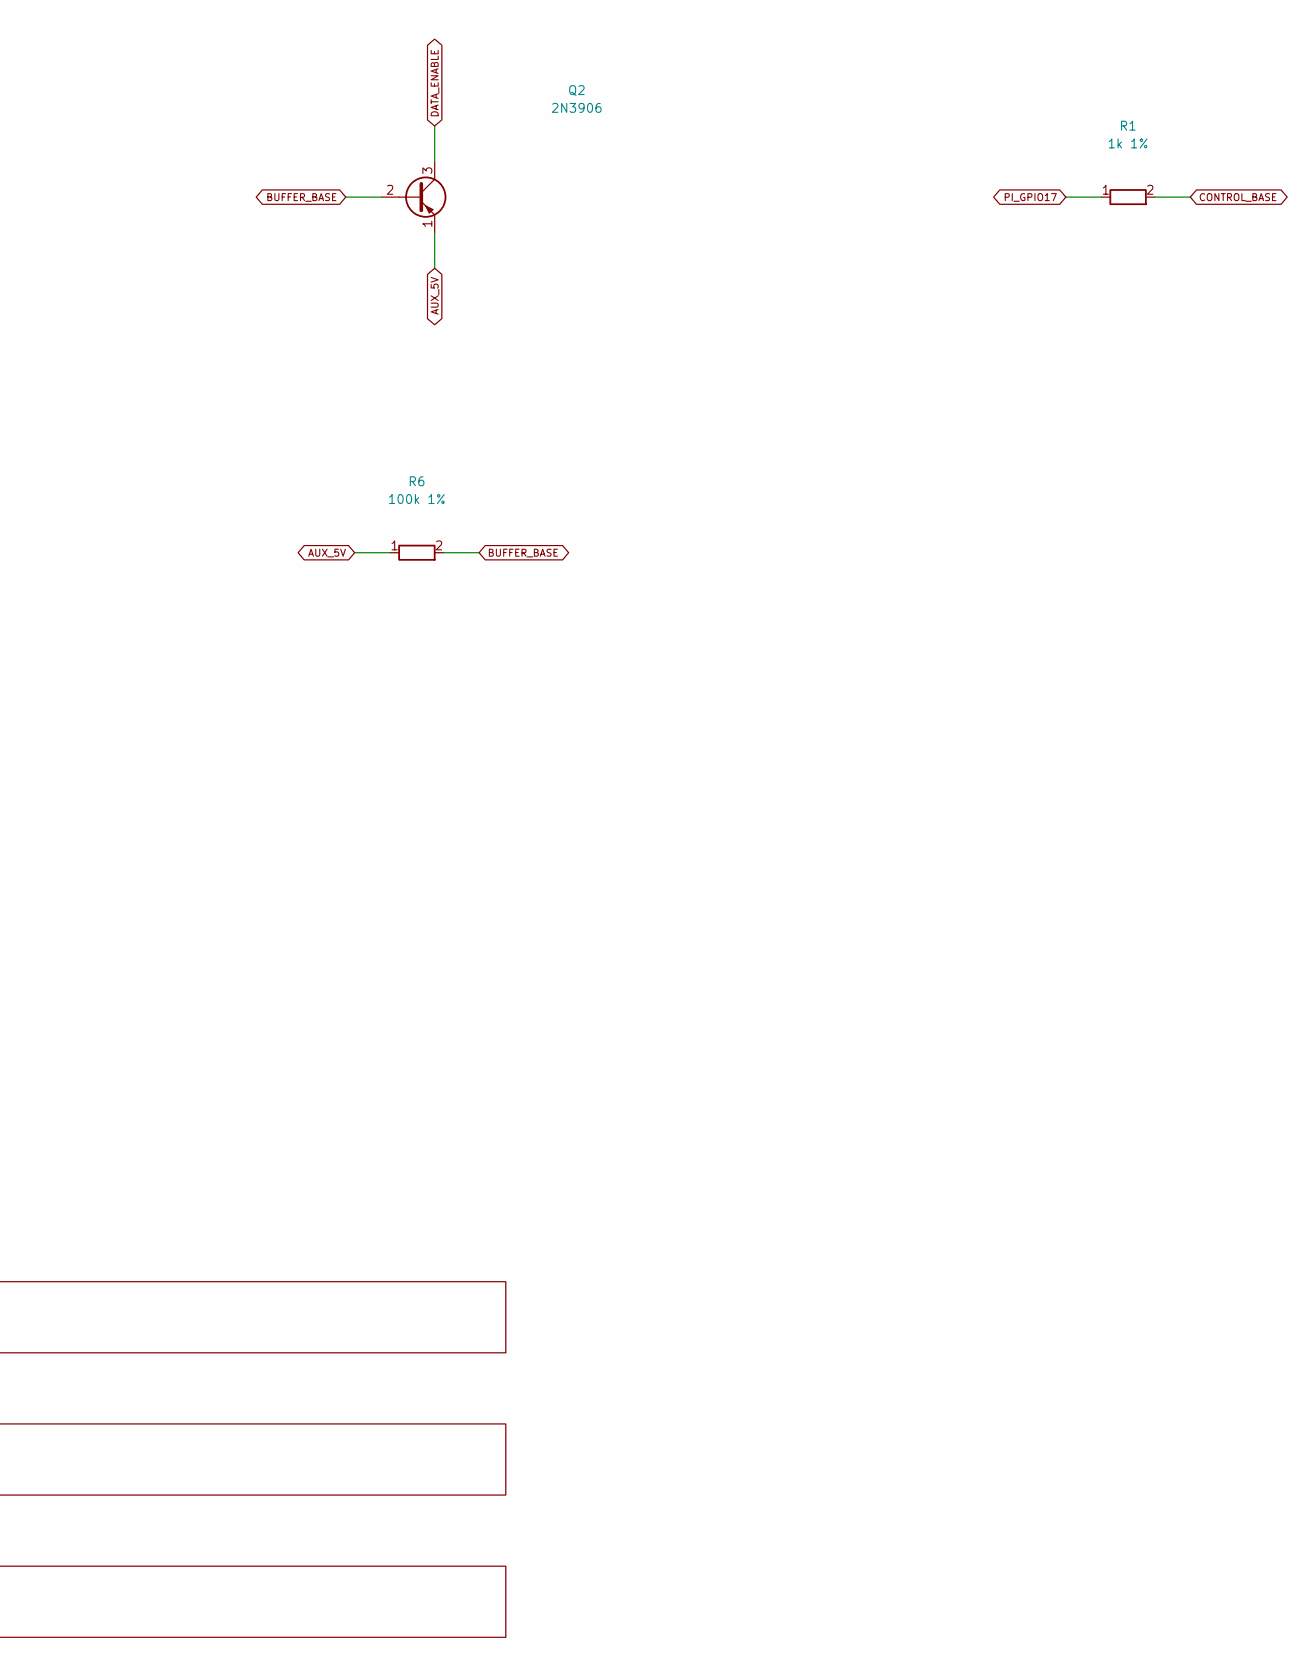
[picture p46: schematic screen_power_hand.kicad_sch, Segno screen power / hand / control, part in row 1, column 2]

Parts:
J2: GPIO17 / GND; JST_XH_B2B-XH-A_1x02_P2.50mm_Vertical; MPN B2B-XH-A(LF)(SN)
Q1: 2N3904; TO-92_Inline_Wide; MPN 2N3904BU
Q2: 2N3906; TO-92_Inline_Wide; MPN 2N3906BU
R1: 1k 1%; R_Axial_DIN0207_L6.3mm_D2.5mm_P10.16mm_Horizontal; MPN MFR-25FBF52-1K
R2: 4.7k 1%; R_Axial_DIN0207_L6.3mm_D2.5mm_P10.16mm_Horizontal; MPN MFR-25FBF52-4K7
R5: 5.6k 1%; R_Axial_DIN0207_L6.3mm_D2.5mm_P10.16mm_Horizontal; MPN MFR-25FBF52-5K6
R6: 100k 1%; R_Axial_DIN0207_L6.3mm_D2.5mm_P10.16mm_Horizontal; MPN MFR-25FBF52-100K

Connections:
AUX_5V: Q2.1 (E), R6.1; also elsewhere on the board
BUFFER_BASE: Q2.2 (B), R5.2, R6.2
CONTROL_BASE: Q1.2 (B), R1.2, R2.1
CONTROL_SINK: Q1.3 (C), R5.1
DATA_ENABLE: Q2.3 (C); also elsewhere on the board
GND: J2.2, Q1.1 (E), R2.2; also elsewhere on the board
PI_GPIO17: J2.1, R1.1

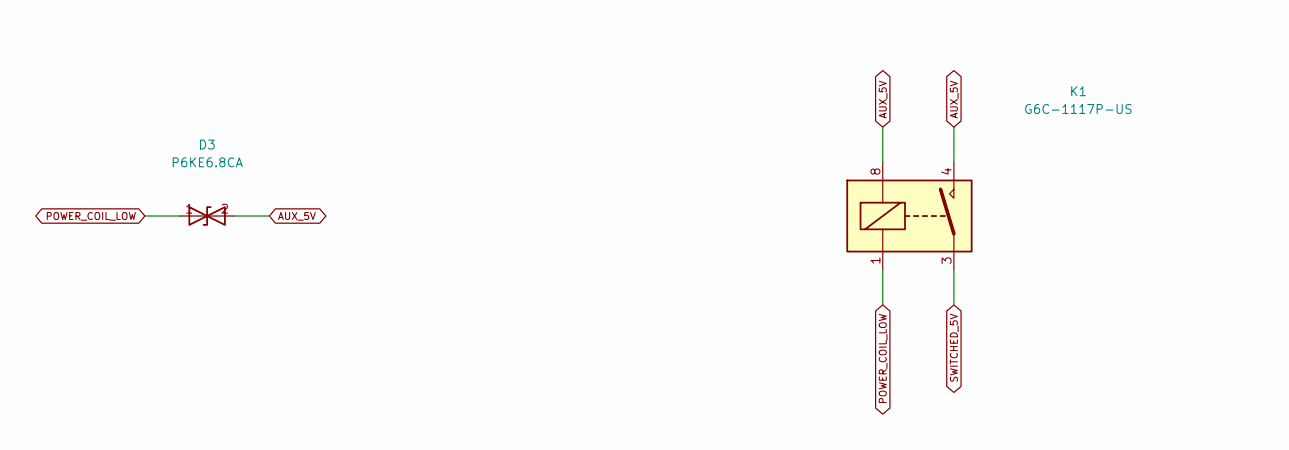
[picture p47: schematic relay_drive.kicad_sch, Segno screen power / hand / relay drive, part in row 1, column 1]

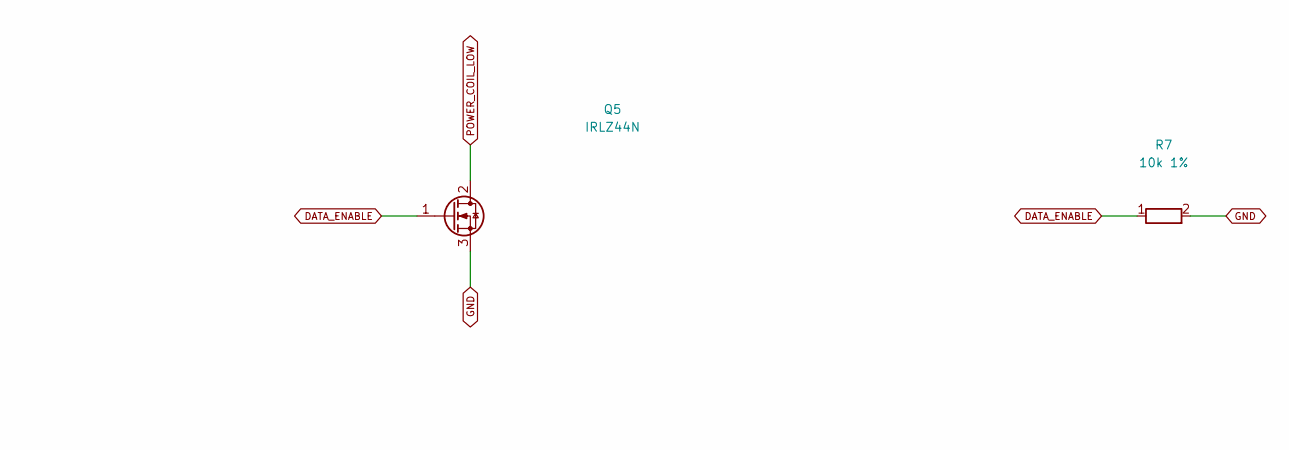
[picture p48: schematic relay_drive.kicad_sch, Segno screen power / hand / relay drive, part in row 1, column 2]

Parts:
D3: P6KE6.8CA; D_DO-15_P10.16mm_Horizontal; MPN P6KE6.8CA
K1: G6C-1117P-US; Relay_Omron_G6C-1117P-US; MPN G6C-1117P-US DC5
Q5: IRLZ44N; TO-220-3_IRLZ44N; MPN IRLZ44NPBF
R7: 10k 1%; R_Axial_DIN0207_L6.3mm_D2.5mm_P10.16mm_Horizontal; MPN MFR-25FBF52-10K

Connections:
AUX_5V: D3.2 (A2), K1.4 (NO), K1.8 (COIL+); also elsewhere on the board
DATA_ENABLE: Q5.1 (G), R7.1; also elsewhere on the board
GND: Q5.3 (S), R7.2; also elsewhere on the board
POWER_COIL_LOW: D3.1 (A1), K1.1 (COIL-), Q5.2 (D)
SWITCHED_5V: K1.3 (NO); also elsewhere on the board

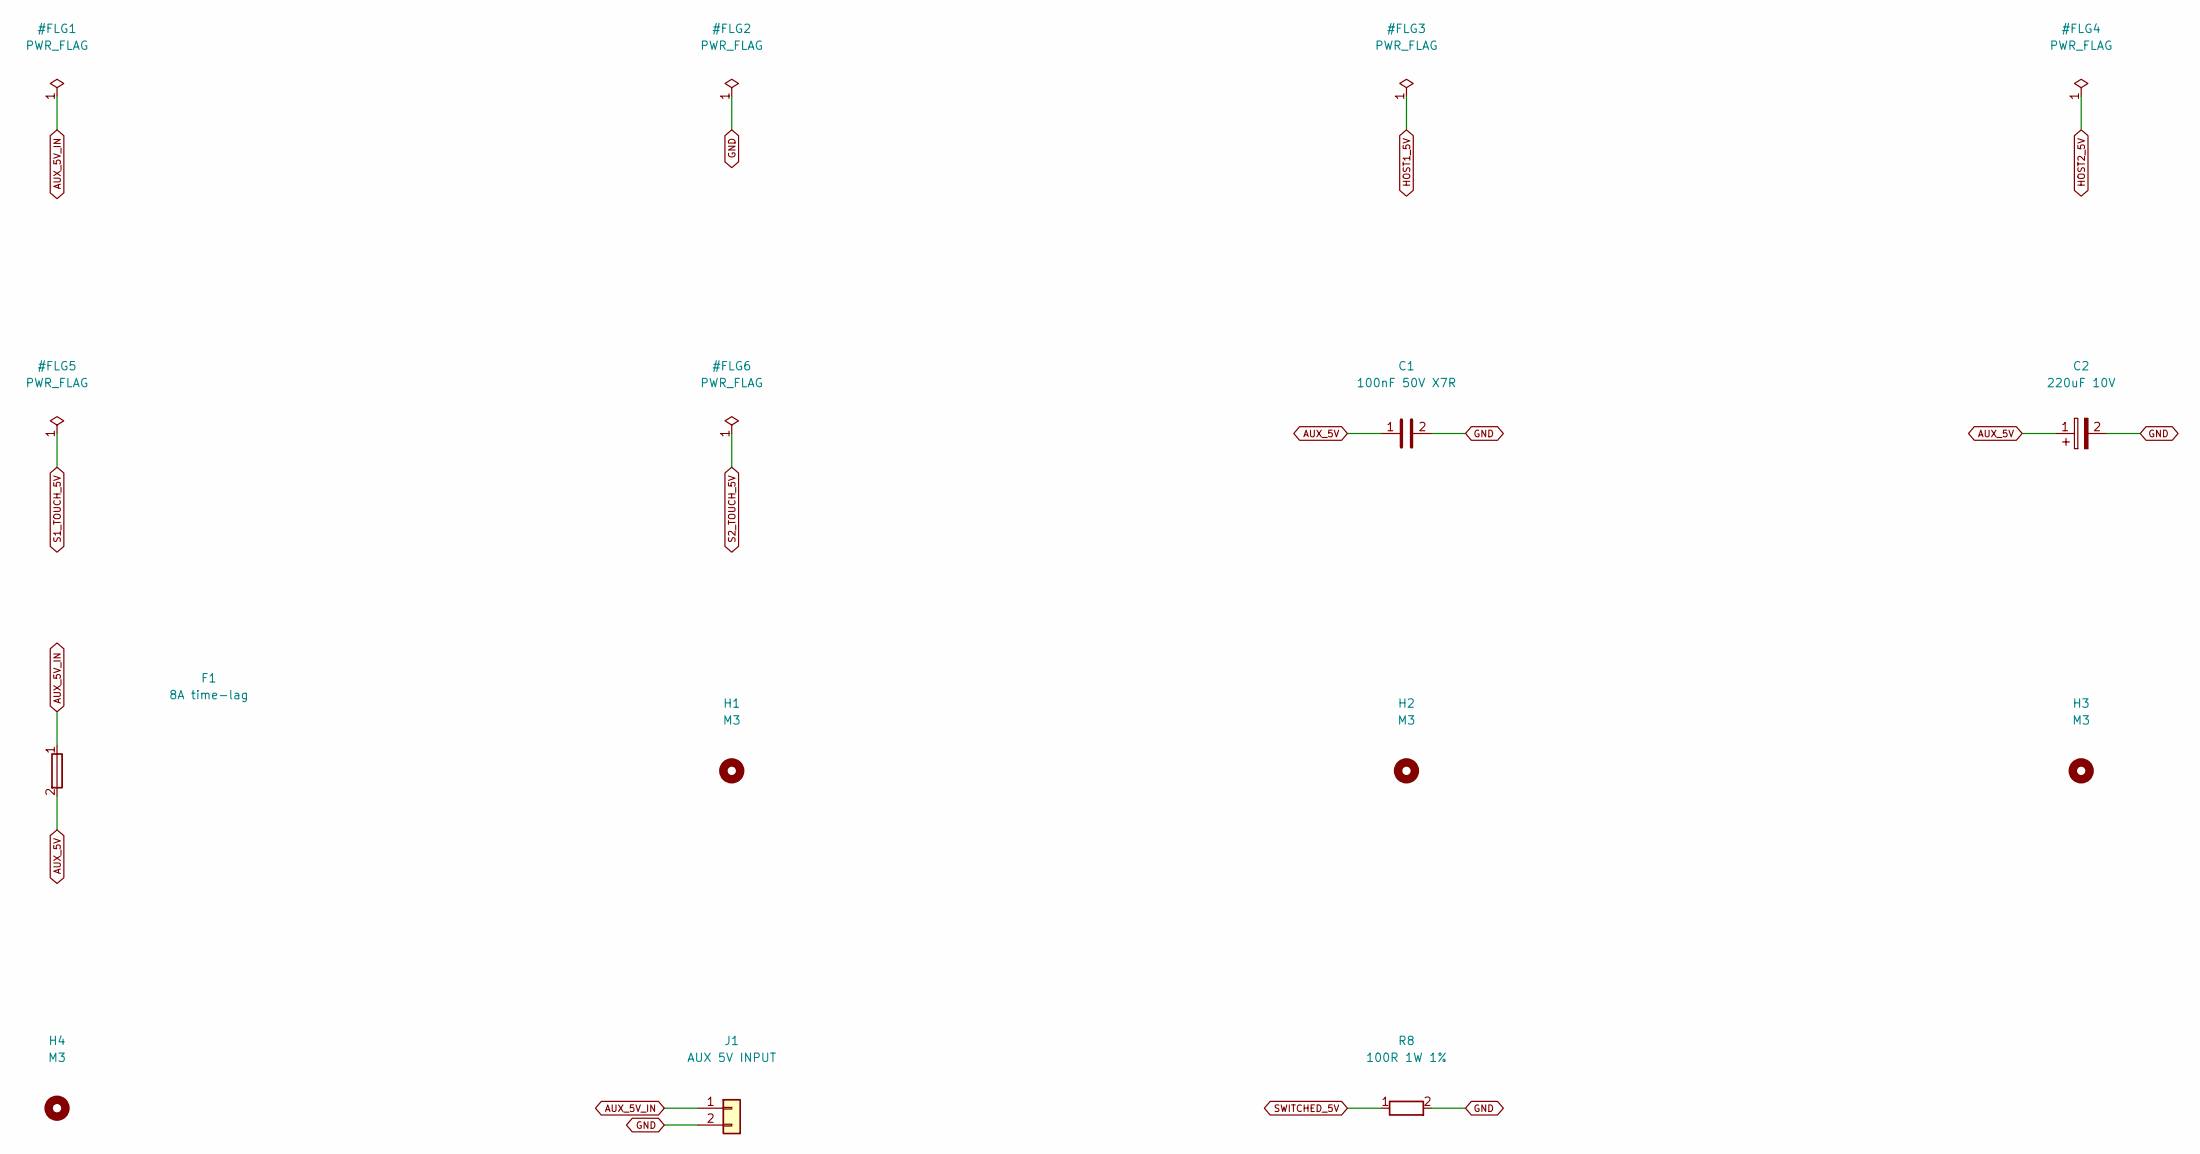
[picture p49: schematic shared_power.kicad_sch, Segno screen power / hand / shared power]

Parts:
C1: 100nF 50V X7R; C_Disc_D7.5mm_W4.4mm_P5.00mm; MPN K104K10X7RF53H5
C2: 220uF 10V; CP_Radial_D6.3mm_P2.50mm; MPN EEU-FR1A221
F1: 8A time-lag; Fuseholder_Schurter_OGN_0031.8201; MPN 0001.2513
H1, H2, H3, H4: M3; MountingHole_3.5mm; MPN NPTH
J1: AUX 5V INPUT; JST_VH_B2P-VH_1x02_P3.96mm_Vertical; MPN B2P-VH(LF)(SN)
R8: 100R 1W 1%; R_Axial_DIN0207_L6.3mm_D2.5mm_P10.16mm_Horizontal; MPN PR01000101000FA100

Connections:
AUX_5V: C1.1, C2.1, F1.2; also elsewhere on the board
AUX_5V_IN: F1.1, J1.1
GND: C1.2, C2.2, J1.2, R8.2; also elsewhere on the board
SWITCHED_5V: R8.1; also elsewhere on the board

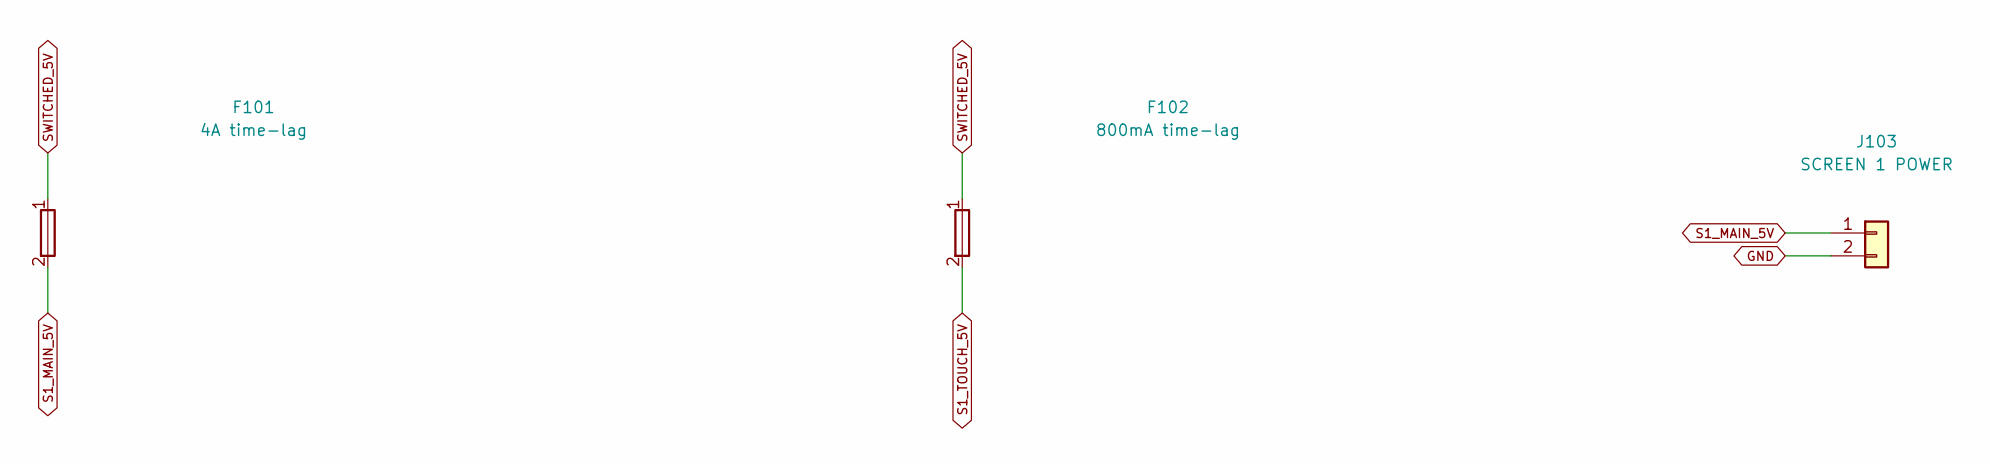
[picture p50: schematic screen1_power.kicad_sch, Segno screen power / hand / screen1 power]

Parts:
F101: 4A time-lag; Fuse_Bel_0697H_P5.08mm; MPN 0697H4000-02
F102: 800mA time-lag; Fuse_Bel_0697H_P5.08mm; MPN 0697H0800-02
J103: SCREEN 1 POWER; JST_VH_B2P-VH_1x02_P3.96mm_Vertical; MPN B2P-VH(LF)(SN)

Connections:
GND: J103.2; also elsewhere on the board
S1_MAIN_5V: F101.2, J103.1
S1_TOUCH_5V: F102.2; also elsewhere on the board
SWITCHED_5V: F101.1, F102.1; also elsewhere on the board

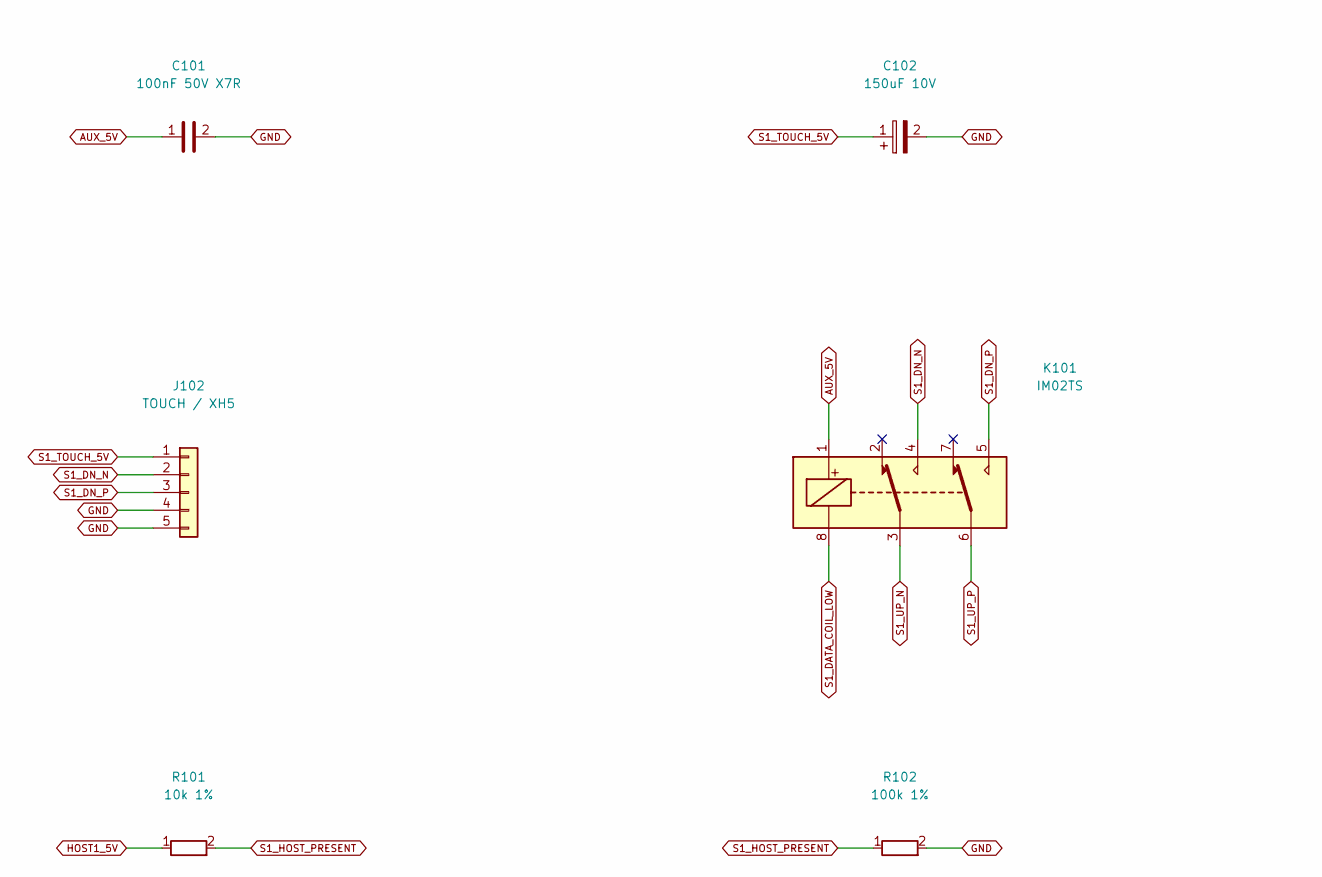
[picture p51: schematic screen1_touch.kicad_sch, Segno screen power / hand / screen1 touch, part in row 1, column 1]

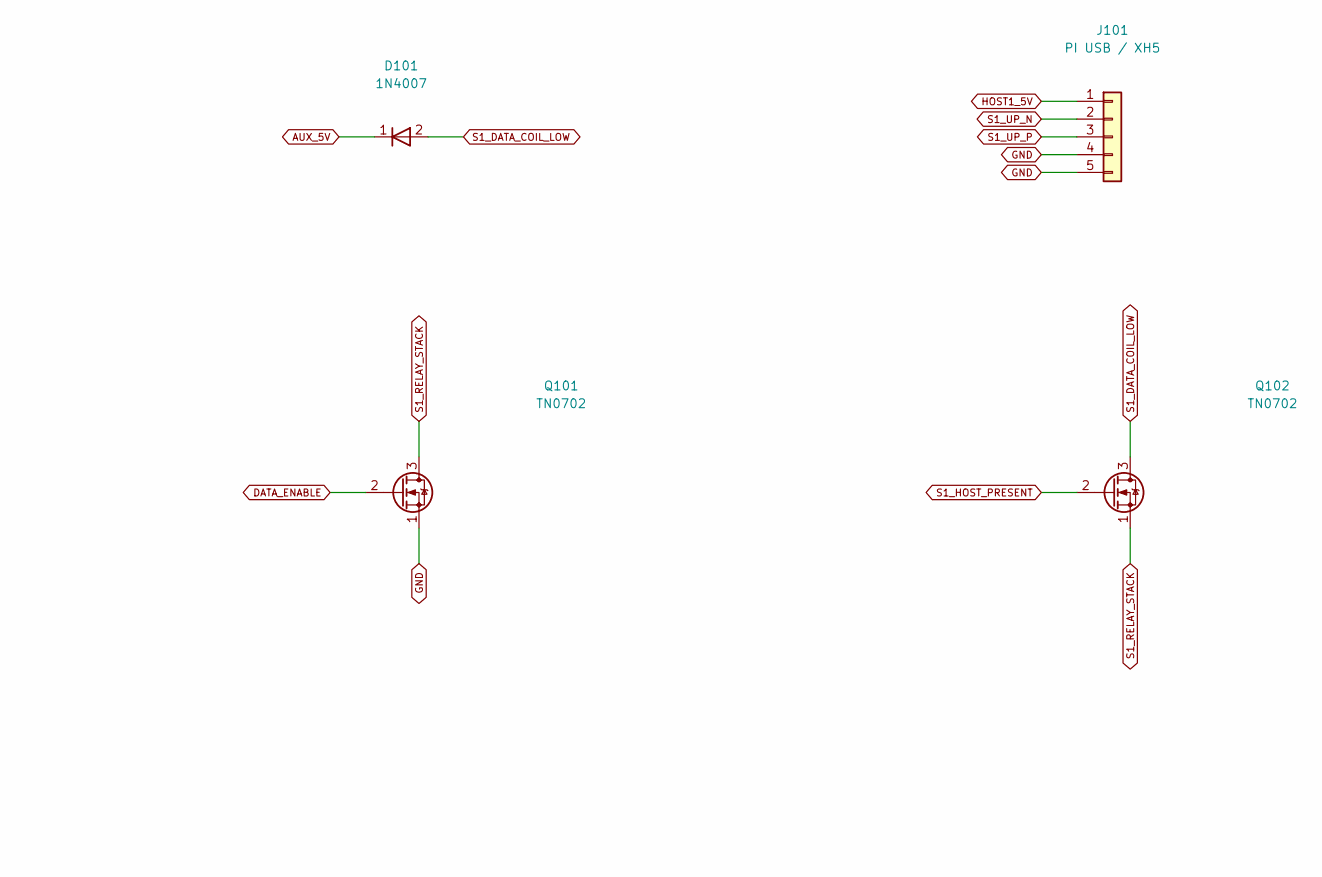
[picture p52: schematic screen1_touch.kicad_sch, Segno screen power / hand / screen1 touch, part in row 1, column 2]

Parts:
C101: 100nF 50V X7R; C_Disc_D7.5mm_W4.4mm_P5.00mm; MPN K104K10X7RF53H5
C102: 150uF 10V; CP_Radial_D5.0mm_P2.00mm; MPN EEU-FR1A151
D101: 1N4007; D_DO-41_SOD81_P10.16mm_Horizontal; MPN 1N4007G
J101: PI USB / XH5; JST_XH_B5B-XH-A_1x05_P2.50mm_Vertical; MPN B5B-XH-A(LF)(SN)
J102: TOUCH / XH5; JST_XH_B5B-XH-A_1x05_P2.50mm_Vertical; MPN B5B-XH-A(LF)(SN)
K101: IM02TS; Relay_DPDT_AXICOM_IMSeries_Pitch5.08mm_D0.90mm; MPN 1-1462037-3
Q101, Q102: TN0702; TO-92_Inline_Wide; MPN TN0702N3-G
R101: 10k 1%; R_Axial_DIN0207_L6.3mm_D2.5mm_P10.16mm_Horizontal; MPN MFR-25FBF52-10K
R102: 100k 1%; R_Axial_DIN0207_L6.3mm_D2.5mm_P10.16mm_Horizontal; MPN MFR-25FBF52-100K

Connections:
AUX_5V: C101.1, D101.1 (K), K101.1; also elsewhere on the board
DATA_ENABLE: Q101.2 (G); also elsewhere on the board
GND: C101.2, C102.2, J101.4, J101.5, J102.4, J102.5, Q101.1 (S), R102.2; also elsewhere on the board
HOST1_5V: J101.1, R101.1
S1_DATA_COIL_LOW: D101.2 (A), K101.8, Q102.3 (D)
S1_DN_N: J102.2, K101.4
S1_DN_P: J102.3, K101.5
S1_HOST_PRESENT: Q102.2 (G), R101.2, R102.1
S1_RELAY_STACK: Q101.3 (D), Q102.1 (S)
S1_TOUCH_5V: C102.1, J102.1; also elsewhere on the board
S1_UP_N: J101.2, K101.3
S1_UP_P: J101.3, K101.6

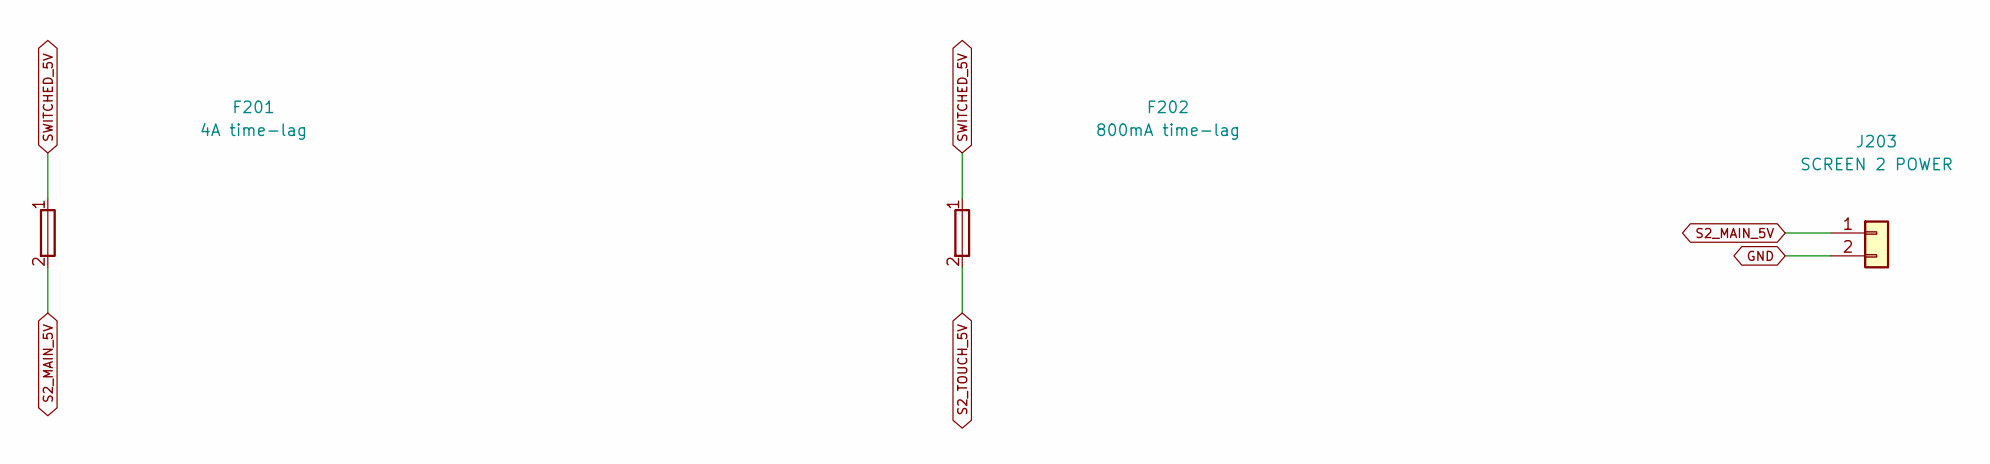
[picture p53: schematic screen2_power.kicad_sch, Segno screen power / hand / screen2 power]

Parts:
F201: 4A time-lag; Fuse_Bel_0697H_P5.08mm; MPN 0697H4000-02
F202: 800mA time-lag; Fuse_Bel_0697H_P5.08mm; MPN 0697H0800-02
J203: SCREEN 2 POWER; JST_VH_B2P-VH_1x02_P3.96mm_Vertical; MPN B2P-VH(LF)(SN)

Connections:
GND: J203.2; also elsewhere on the board
S2_MAIN_5V: F201.2, J203.1
S2_TOUCH_5V: F202.2; also elsewhere on the board
SWITCHED_5V: F201.1, F202.1; also elsewhere on the board

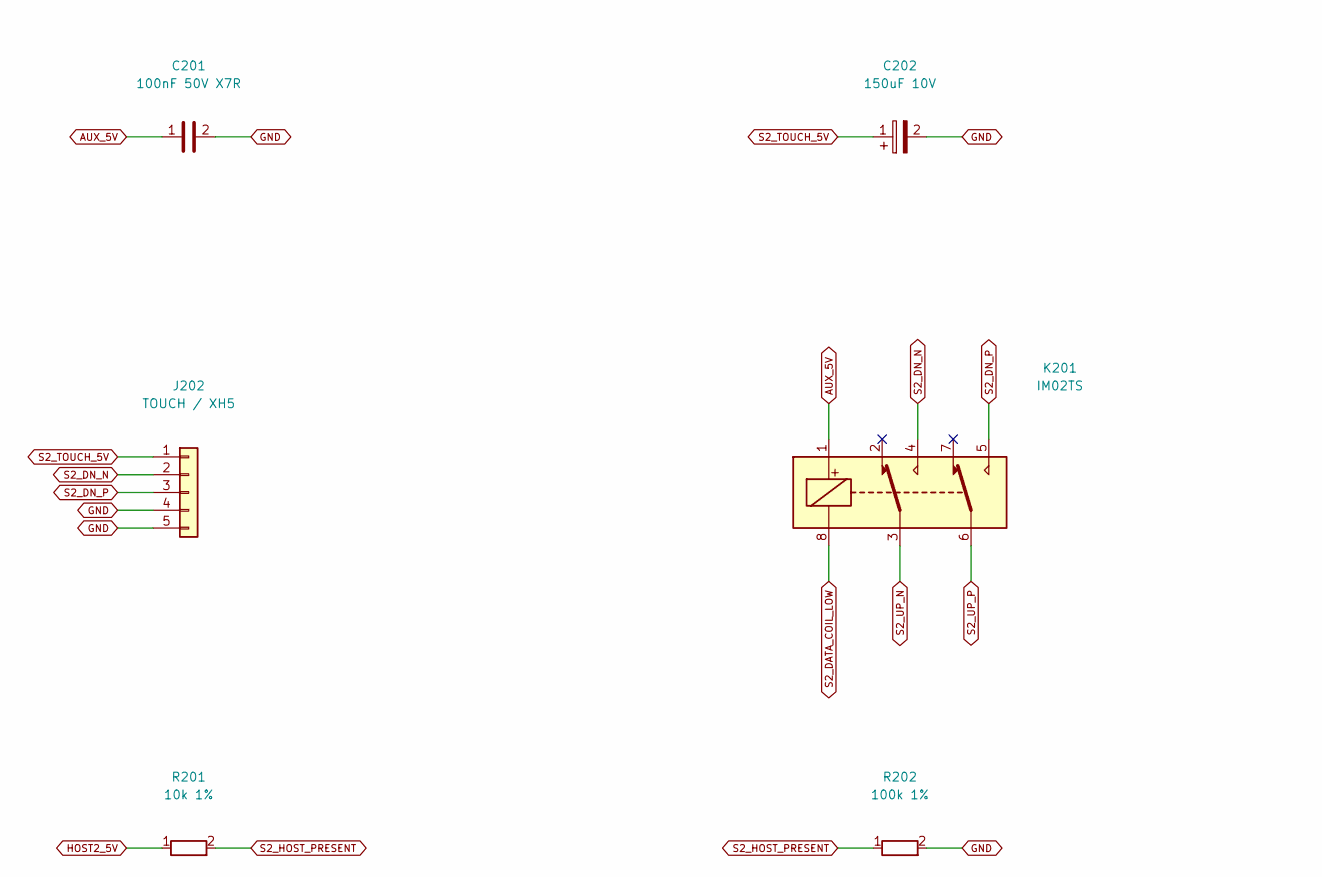
[picture p54: schematic screen2_touch.kicad_sch, Segno screen power / hand / screen2 touch, part in row 1, column 1]

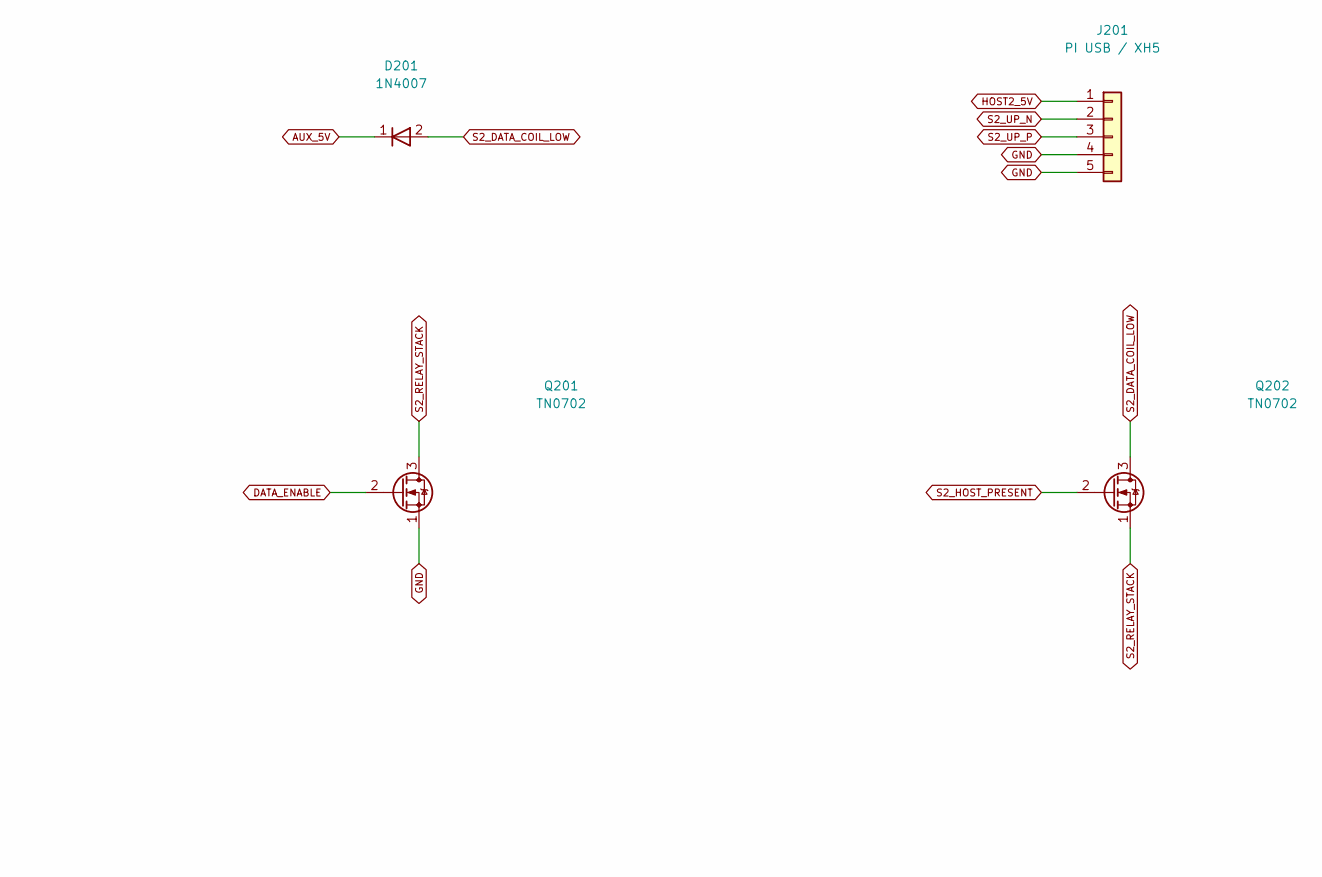
[picture p55: schematic screen2_touch.kicad_sch, Segno screen power / hand / screen2 touch, part in row 1, column 2]

Parts:
C201: 100nF 50V X7R; C_Disc_D7.5mm_W4.4mm_P5.00mm; MPN K104K10X7RF53H5
C202: 150uF 10V; CP_Radial_D5.0mm_P2.00mm; MPN EEU-FR1A151
D201: 1N4007; D_DO-41_SOD81_P10.16mm_Horizontal; MPN 1N4007G
J201: PI USB / XH5; JST_XH_B5B-XH-A_1x05_P2.50mm_Vertical; MPN B5B-XH-A(LF)(SN)
J202: TOUCH / XH5; JST_XH_B5B-XH-A_1x05_P2.50mm_Vertical; MPN B5B-XH-A(LF)(SN)
K201: IM02TS; Relay_DPDT_AXICOM_IMSeries_Pitch5.08mm_D0.90mm; MPN 1-1462037-3
Q201, Q202: TN0702; TO-92_Inline_Wide; MPN TN0702N3-G
R201: 10k 1%; R_Axial_DIN0207_L6.3mm_D2.5mm_P10.16mm_Horizontal; MPN MFR-25FBF52-10K
R202: 100k 1%; R_Axial_DIN0207_L6.3mm_D2.5mm_P10.16mm_Horizontal; MPN MFR-25FBF52-100K

Connections:
AUX_5V: C201.1, D201.1 (K), K201.1; also elsewhere on the board
DATA_ENABLE: Q201.2 (G); also elsewhere on the board
GND: C201.2, C202.2, J201.4, J201.5, J202.4, J202.5, Q201.1 (S), R202.2; also elsewhere on the board
HOST2_5V: J201.1, R201.1
S2_DATA_COIL_LOW: D201.2 (A), K201.8, Q202.3 (D)
S2_DN_N: J202.2, K201.4
S2_DN_P: J202.3, K201.5
S2_HOST_PRESENT: Q202.2 (G), R201.2, R202.1
S2_RELAY_STACK: Q201.3 (D), Q202.1 (S)
S2_TOUCH_5V: C202.1, J202.1; also elsewhere on the board
S2_UP_N: J201.2, K201.3
S2_UP_P: J201.3, K201.6

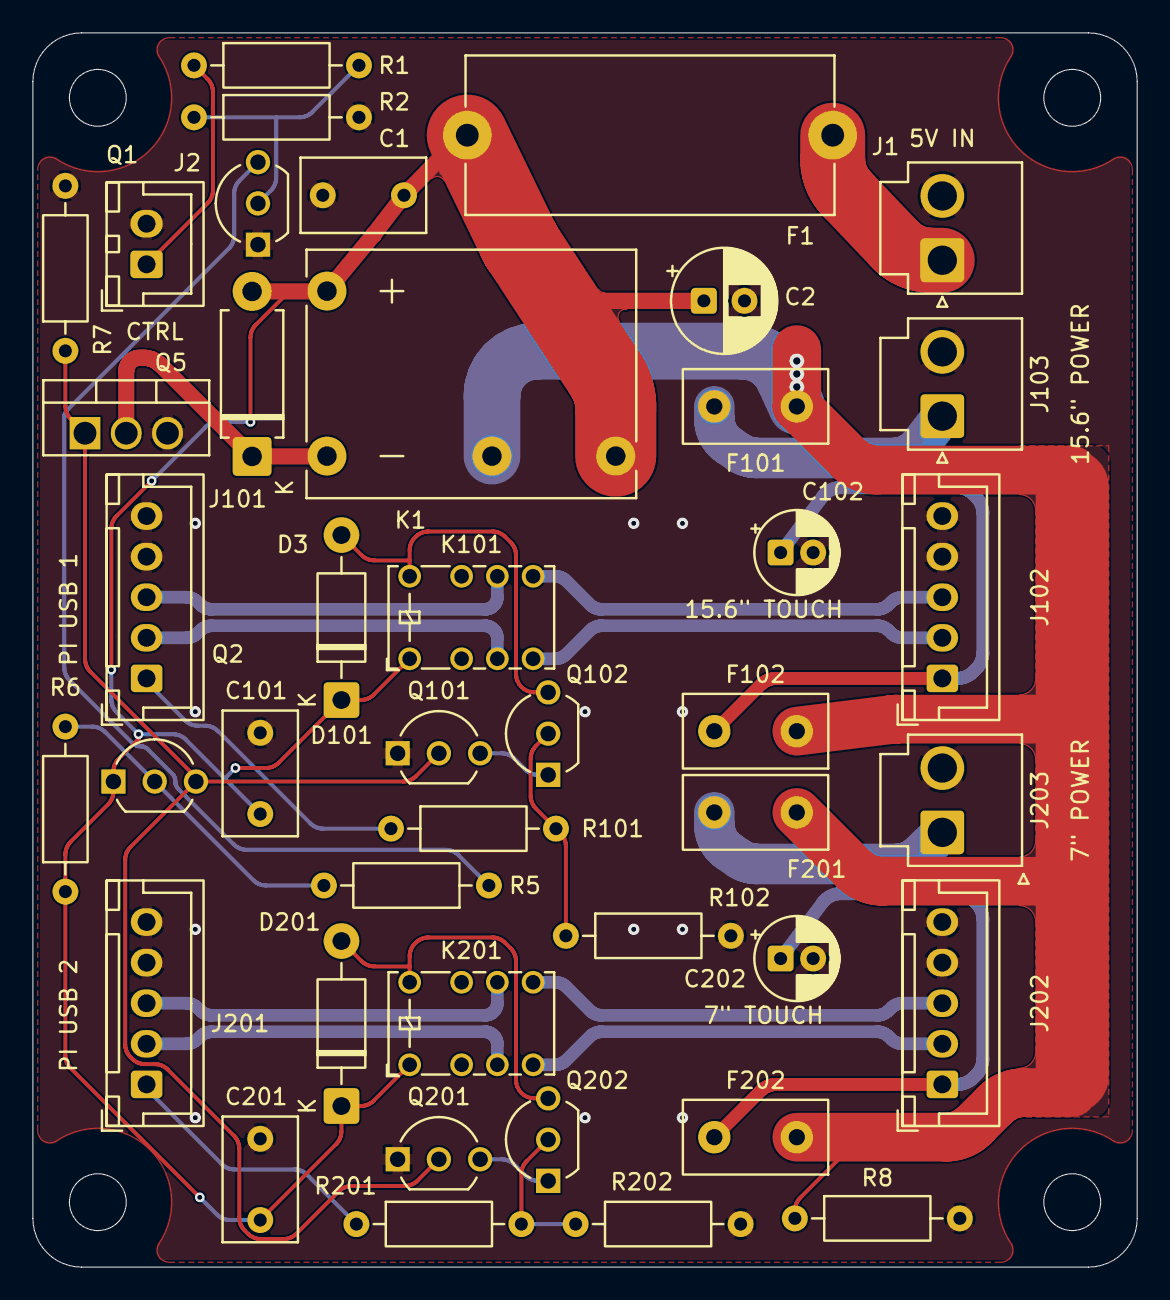
[picture p56: board screen_power_hand.kicad_pcb from above]

Board: 2 copper layers, 68.0 x 76.0 mm, 46 parts (0 on the bottom side), 30 nets.
