tomassasovsky/segno-hardware/hardware/kicad/out_console/segno_console_board.kicad_pcb

## KiCad design hardware/kicad/out_console/segno_console_board.kicad_pcb (2026-10-26)

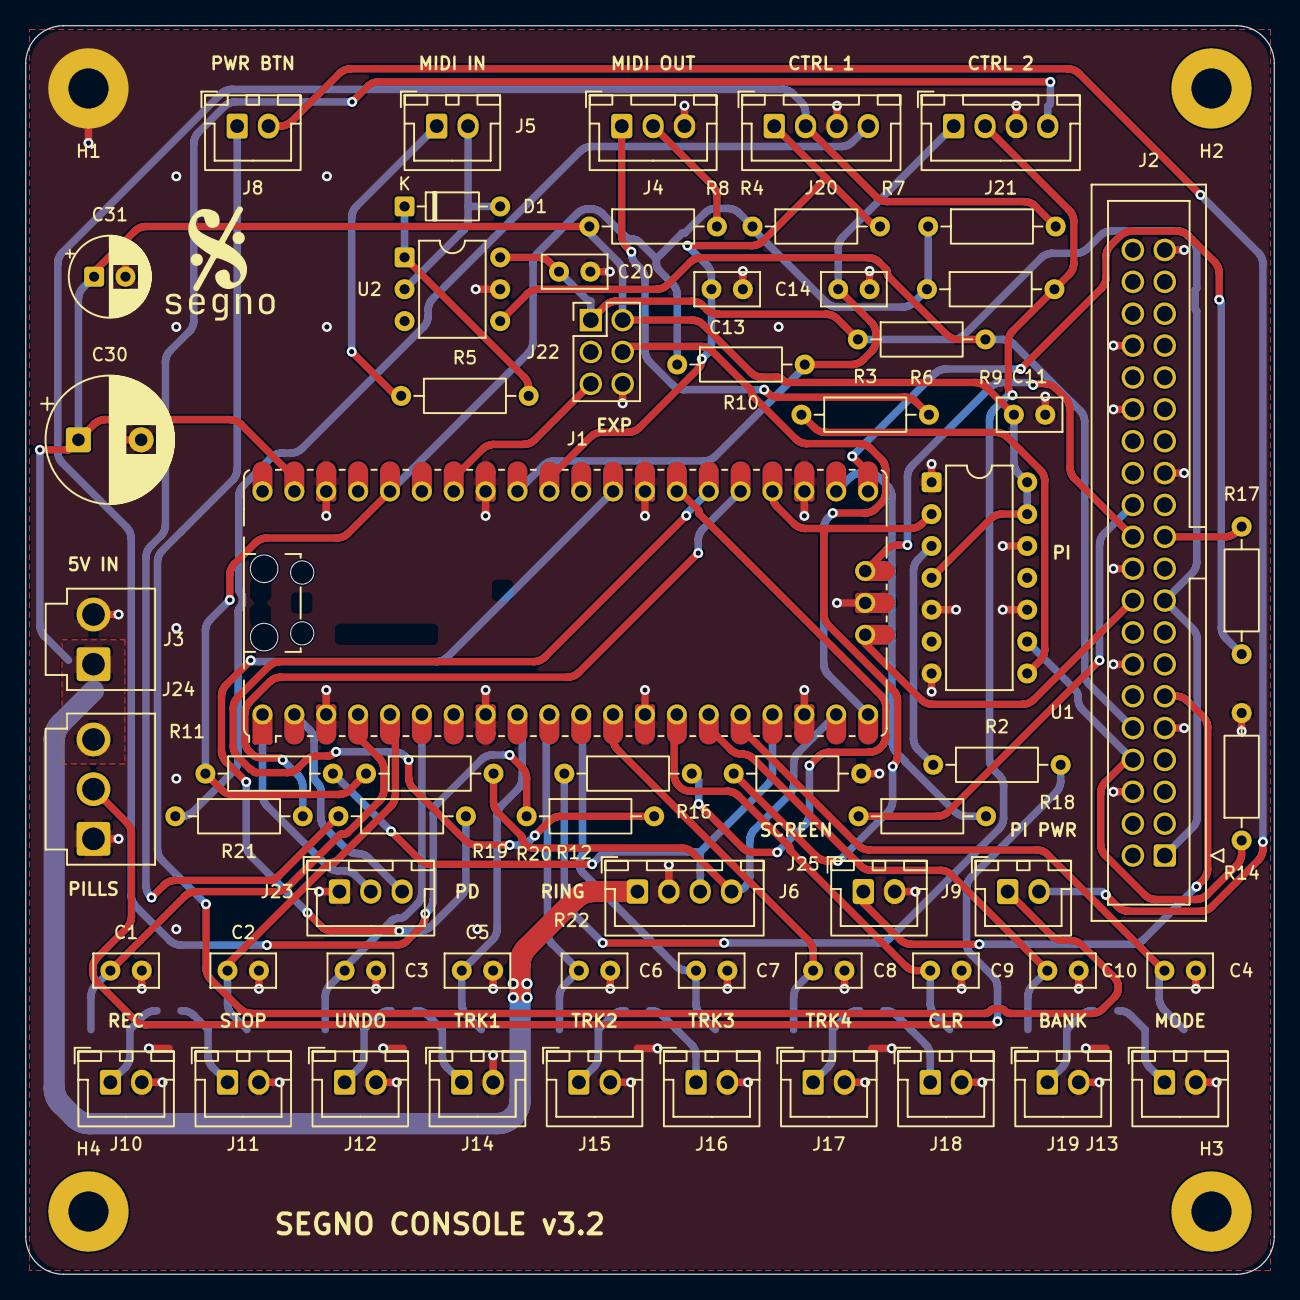
[picture p57: board segno_console_board.kicad_pcb from above]

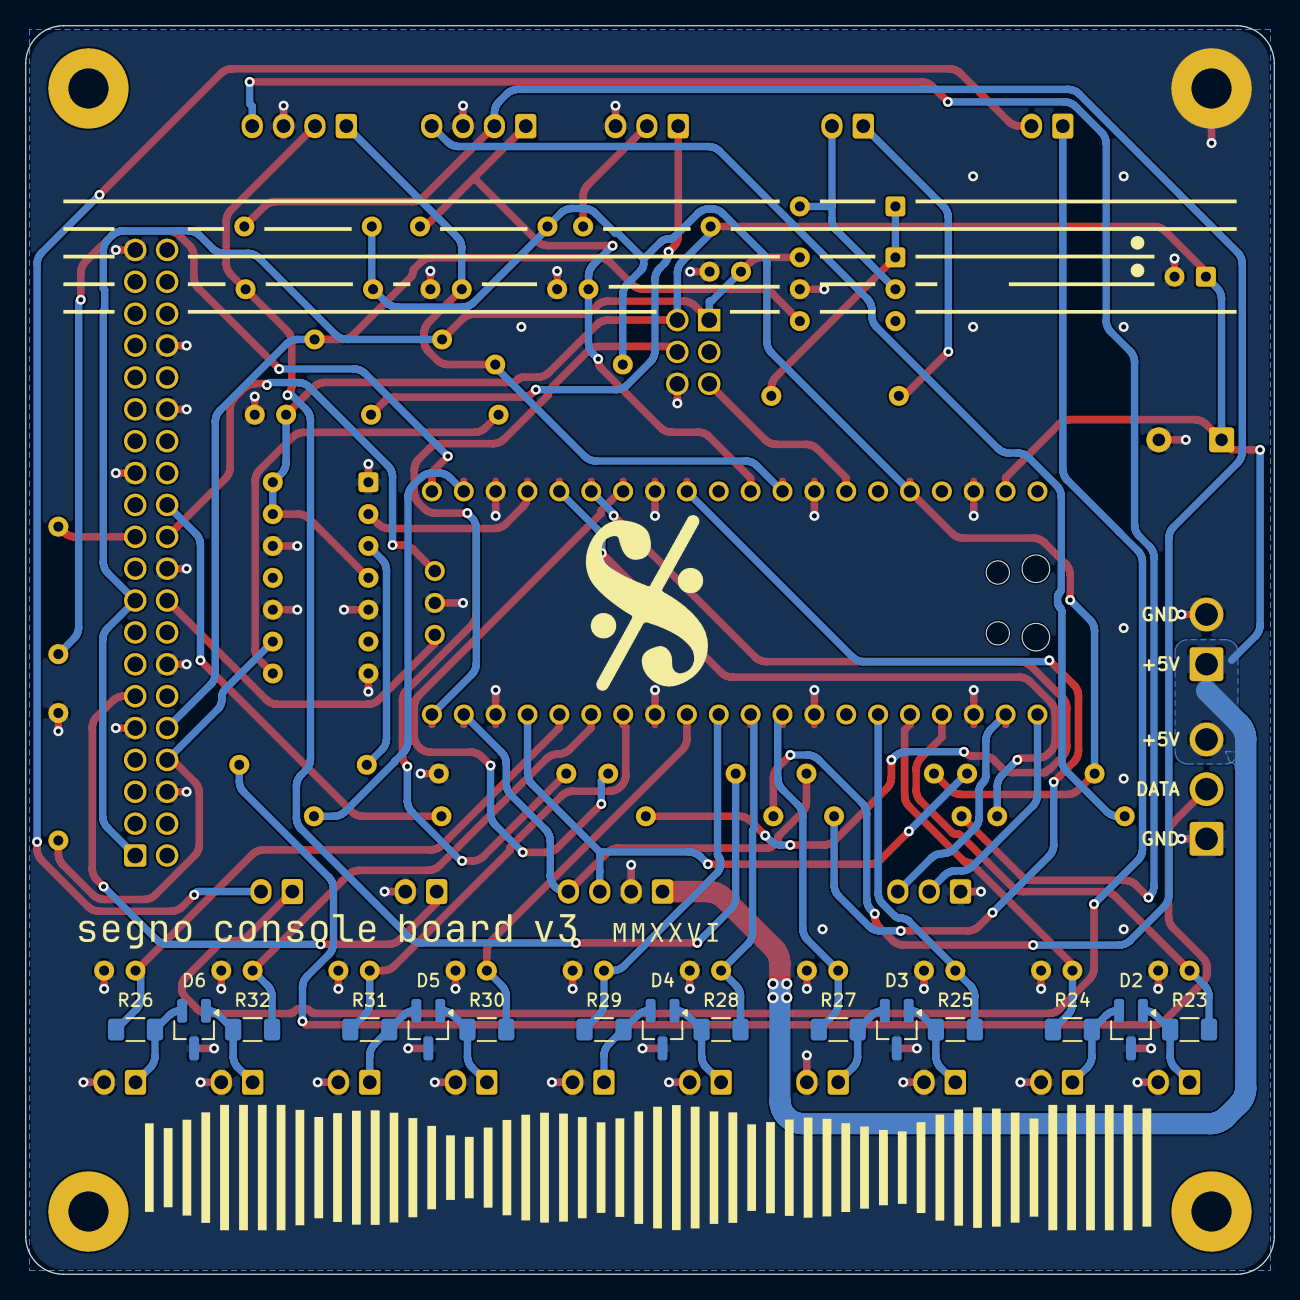
[picture p58: board segno_console_board.kicad_pcb from below]

Board: 2 copper layers, 99.5 x 99.5 mm, 81 parts (15 on the bottom side), 60 nets.

Parts:
C1, C2, C3, C4, C5, C6, C7, C8, C9, C10, C11, C13, C14, C20: C_Disc_D5.0mm_W2.5mm_P2.50mm
C30: CP_Radial_D10.0mm_P5.00mm
C31: CP_Radial_D6.3mm_P2.50mm
D1: D_DO-35_SOD27_P7.62mm_Horizontal
D2, D3, D4, D5, D6: SOT-23_Handsoldering
H1, H2, H3, H4: MountingHole_3.2mm_M3_Pad
J1: RaspberryPi_Pico_SMD_HandSolder; RaspberryPi_Pico_SMD_or_THT_Debug
J2: IDC-Header_2x20_P2.54mm_Vertical
J3: JST_VH_B2P-VH_1x02_P3.96mm_Vertical
J4, J23: JST_XH_B3B-XH-A_1x03_P2.50mm_Vertical
J5, J8, J9, J10, J11, J12, J13, J14, J15, J16, J17, J18, J19, J25: JST_XH_B2B-XH-A_1x02_P2.50mm_Vertical
J6, J20, J21: JST_XH_B4B-XH-A_1x04_P2.50mm_Vertical
J22: PinHeader_2x03_P2.54mm_Vertical
J24: JST_VH_B3P-VH_1x03_P3.96mm_Vertical
R2, R3, R4, R5, R6, R7, R8, R9, R10, R11, R12, R14, R16, R17, R19, R20, R21, R22: R_Axial_DIN0207_L6.3mm_D2.5mm_P10.16mm_Horizontal
R18: 6.8k; R_Axial_DIN0207_L6.3mm_D2.5mm_P10.16mm_Horizontal
R23, R24, R25, R26, R27, R28, R29, R30, R31, R32: R_1206_3216Metric_Pad1.30x1.75mm_HandSolder
U1: DIP-14_W7.62mm
U2: DIP-6_W7.62mm

Connections:
+3V3: C20.1, J2.1, J2.17, J22.1, R6.1, U2.6
+3V3_PICO: J1.36, R7.1, R8.1, R9.1, R10.1, R11.1, R12.1
+5V: C11.1, C30.1, C31.1, J1.39, J3.1, J6.1, J22.2, J24.3, R4.1, U1.4, U1.13, U1.14
CTRL1_PRESENT: J1.25, R21.2
CTRL1_RING: J1.26, R19.2
CTRL1_TIP: C13.1, J1.31, J20.1, R8.2
CTRL2_PRESENT: J1.29, R22.2
CTRL2_RING: J1.27, R20.2
CTRL2_TIP: C14.1, J1.32, J21.1, R10.2
EXP_GP15: J1.20, J22.4
EXP_GP28: J1.34, J22.5
GND: C1.2, C2.2, C3.2, C4.2, C5.2, C6.2, C7.2, C8.2, C9.2, C10.2, C11.2, C13.2, C14.2, C20.2, C30.2, C31.2, D2.3, D3.3, D4.3, D5.3, D6.3, H1.1, J1.3, J1.8, J1.13, J1.18, J1.23, J1.28, J1.33, J1.38, J1.D2, J2.6, J2.9, J2.14, J2.20, J2.25, J2.30, J2.34, J2.39, J3.2, J4.3, J6.2, J10.2, J11.2, J12.2, J13.2, J14.2, J15.2, J16.2, J17.2, J18.2, J19.2, J20.3, J21.3, J22.6, J23.1, J24.1, J25.2, R14.2, R16.2, U1.1, U1.5, U1.7, U1.10, U1.12, U2.5
IND_DATA: J1.24, R16.1, U1.2
IND_DATA_BUF: R2.1, U1.3
IND_DATA_OUT: J24.2, R2.2
J20_REF: J20.2, R7.2, R19.1
J20_RN: J20.4, R21.1
J21_REF: J21.2, R9.2, R20.1
J21_RN: J21.4, R22.1
LINK_RX: J1.22, R18.2
LINK_RX_PI: J2.24, R18.1
LINK_TO_CONSOLE: J1.19, J6.4, R12.2
LINK_TO_RING: J1.17, J6.3, R11.2
LINK_TX: J1.21, R17.1
LINK_TX_PI: J2.21, R17.2
MIDI_OUT_BUF: R3.1, U1.8
MIDI_RX: J2.10, R6.2, U2.4
MIDI_TX: J2.8, R14.1, U1.9
unnamed: J4.1, R3.2
unnamed: J4.2, R4.2
unnamed: J5.1, R5.1
unnamed: D1.1, R5.2, U2.1
unnamed: D1.2, J5.2, U2.2
PD_SCL: J1.2, J23.3
PD_SDA: J1.1, J23.2
PI_GPIO17: J2.11, J25.1
PWR_BTN: J8.1, J9.1
PWR_BTN_RET: J8.2, J9.2
SWCLK: J1.D1, J2.18
SWDIO: J1.D3, J2.22
SW_BANK: C10.1, J1.15, R32.2
SW_BANK_EXT: D6.1, J19.1, R32.1
SW_CLEAR: C9.1, J1.14, R31.2
SW_CLEAR_EXT: D5.2, J18.1, R31.1
SW_MODE: C4.1, J1.16, R26.2
SW_MODE_EXT: D6.2, J13.1, R26.1
SW_RECPLAY: C1.1, J1.4, R23.2
SW_RECPLAY_EXT: D2.1, J10.1, R23.1
SW_STOP: C2.1, J1.5, R24.2
SW_STOP_EXT: D2.2, J11.1, R24.1
SW_TRACK1: C5.1, J1.9, R27.2
SW_TRACK1_EXT: D3.2, J14.1, R27.1
SW_TRACK2: C6.1, J1.10, R28.2
SW_TRACK2_EXT: D4.1, J15.1, R28.1
SW_TRACK3: C7.1, J1.11, R29.2
SW_TRACK3_EXT: D4.2, J16.1, R29.1
SW_TRACK4: C8.1, J1.12, R30.2
SW_TRACK4_EXT: D5.1, J17.1, R30.1
SW_UNDO: C3.1, J1.6, R25.2
SW_UNDO_EXT: D3.1, J12.1, R25.1
