tomassasovsky/segno-hardware/hardware/kicad/segno_pedal_ring.kicad_pcb

## KiCad design hardware/kicad/segno_pedal_ring.kicad_pcb (2026-10-20)

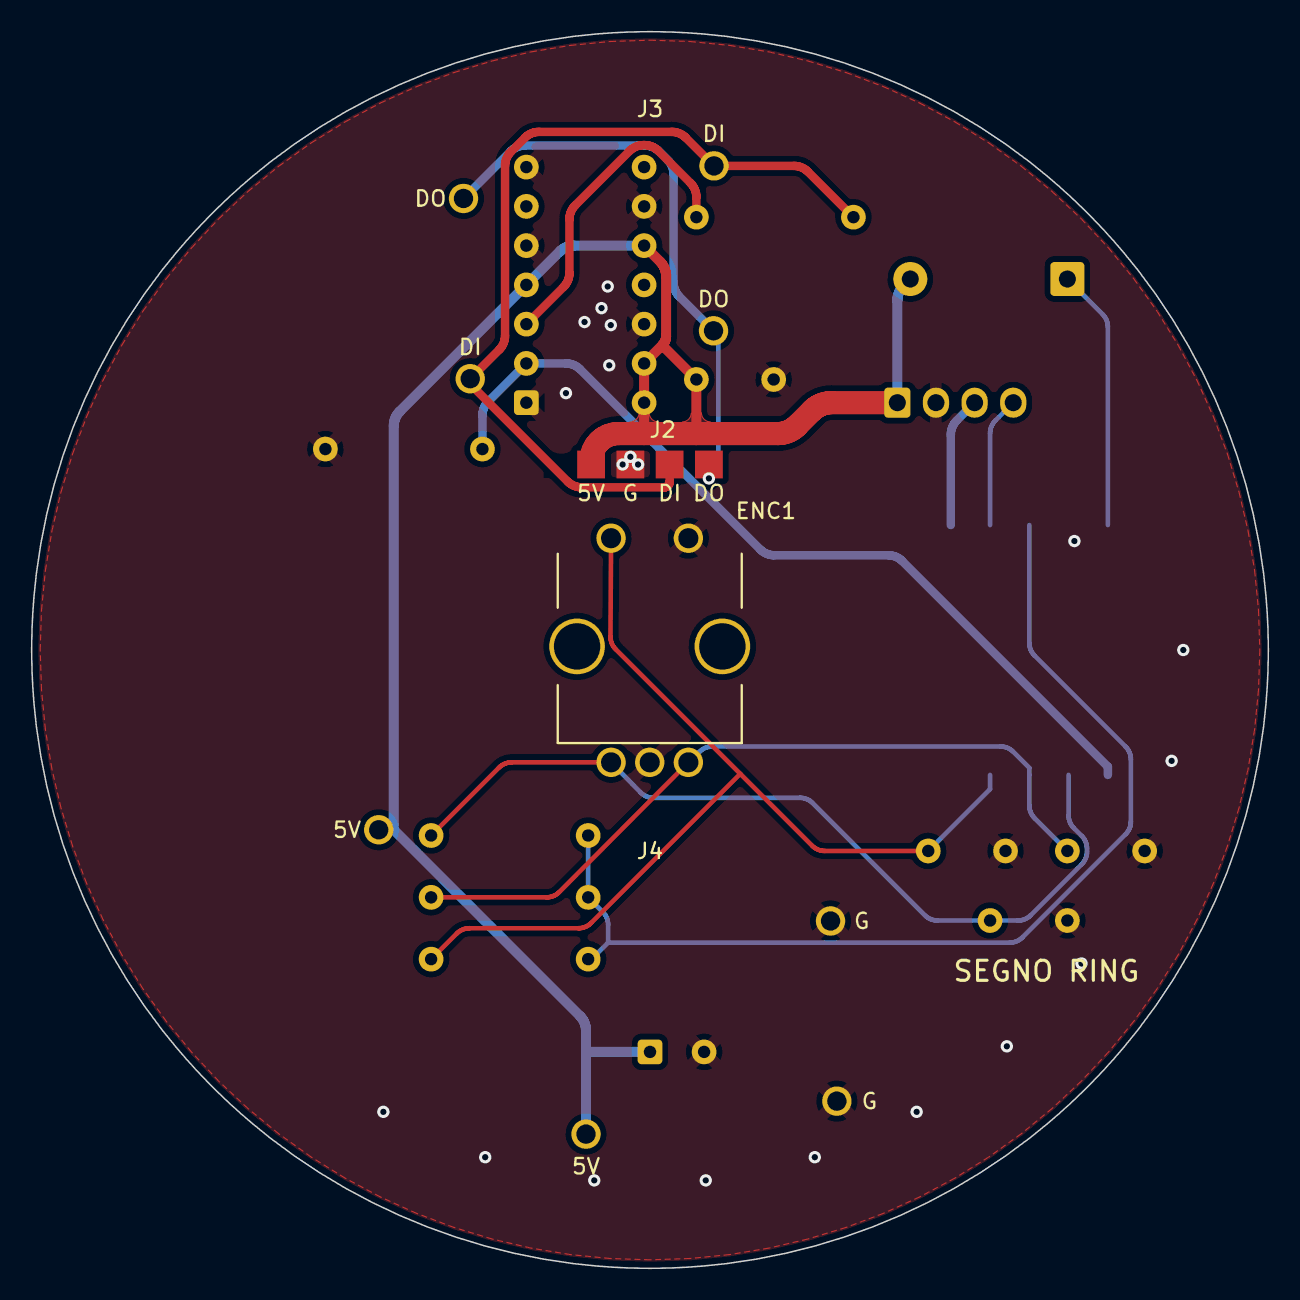
[picture p59: board segno_pedal_ring.kicad_pcb from above]

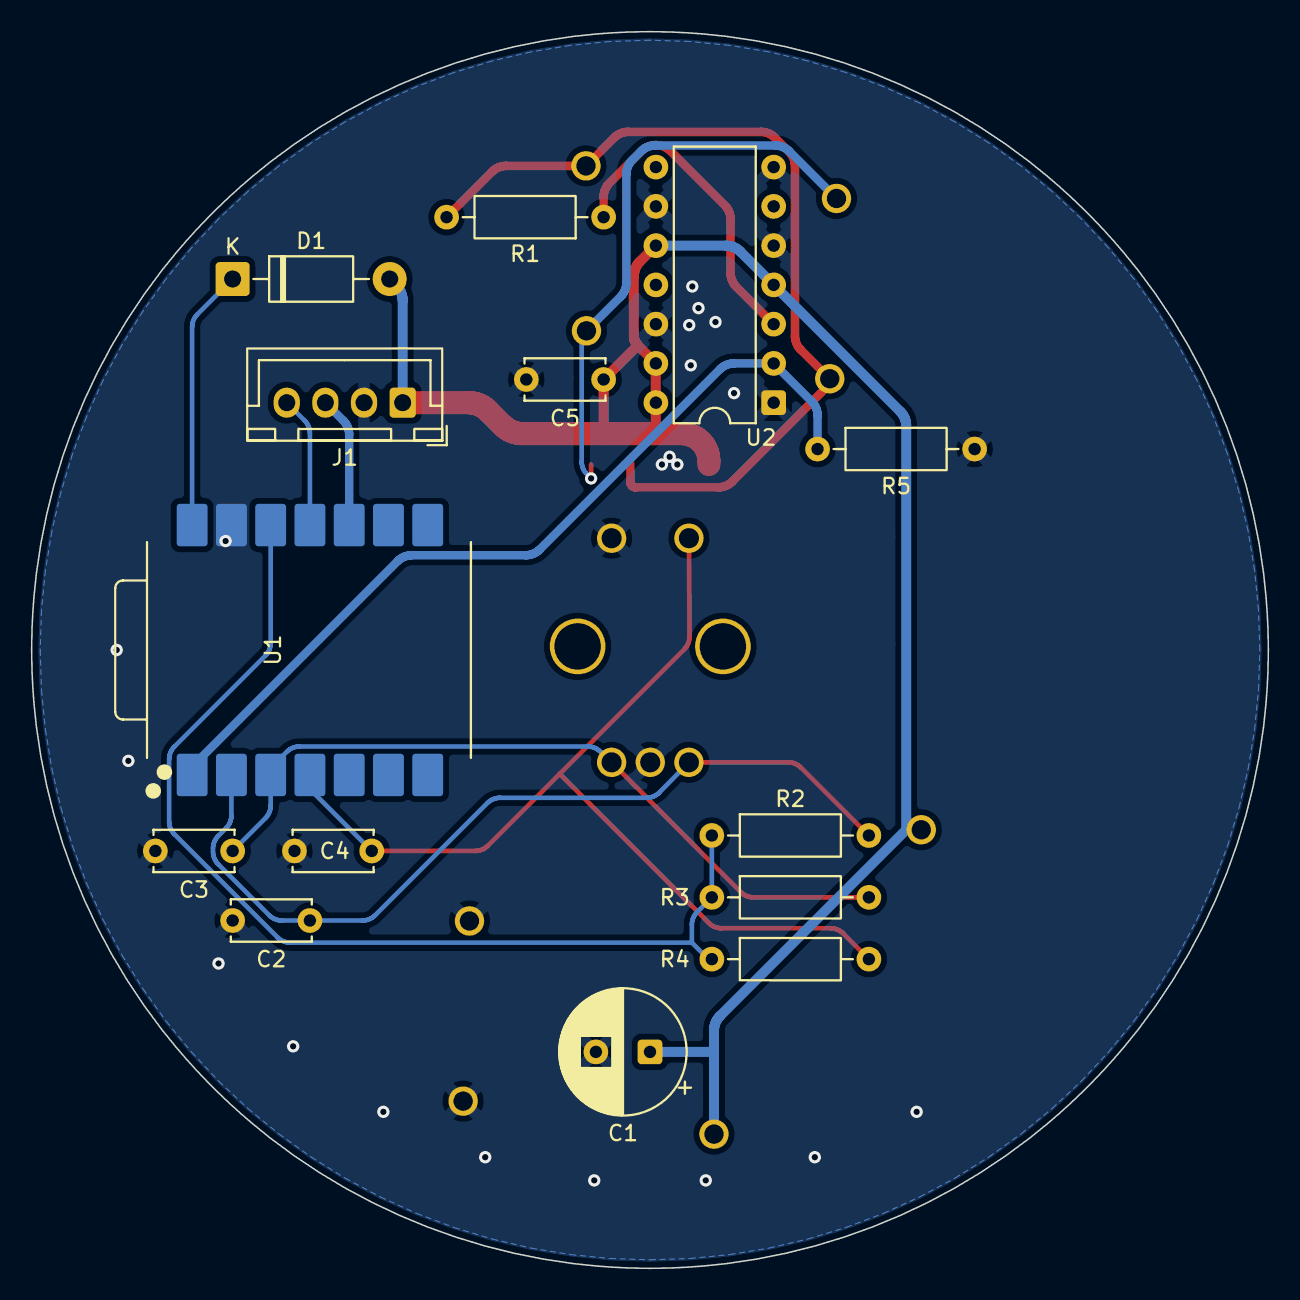
[picture p60: board segno_pedal_ring.kicad_pcb from below]

Board: 2 copper layers, 80.0 x 80.0 mm, 19 parts (14 on the bottom side), 13 nets.

Parts:
C1: 470uF 16V low-ESR <=0.15R; CP_Radial_D8.0mm_P3.50mm
C2, C3, C4: 10nF; C_Disc_D5.0mm_W2.5mm_P5.00mm
C5: 100nF; C_Disc_D5.0mm_W2.5mm_P5.00mm
D1: 1N5819; D_DO-41_SOD81_P10.16mm_Horizontal
ENC1: ACZ11BR1E-20FD1-20C; RotaryEncoder_SameSky_ACZ11BR1E-20FD1-20C
J1: Conn_01x04; JST_XH_B4B-XH-A_1x04_P2.50mm_Vertical
J2: NEOPIXEL; WirePads_1x04
J3: RINGPINS24; ModuleMountPads_Ring24
J4: RINGPINS16; ModuleMountPads_4
R1: 330; R_Axial_DIN0207_L6.3mm_D2.5mm_P10.16mm_Horizontal
R2, R3, R4: 10k; R_Axial_DIN0207_L6.3mm_D2.5mm_P10.16mm_Horizontal
R5: 100k; R_Axial_DIN0207_L6.3mm_D2.5mm_P10.16mm_Horizontal
RING1: NeoPixel24; NeoPixel_Ring24
U1: XIAO-RP2350; XIAO_RP2350_SMD
U2: 74AHCT125N; DIP-14_W7.62mm

Connections:
+3V3: R2.1, R3.1, R4.1, U1.12
+5V_LED: C1.1, C5.1, D1.2, J1.1, J2.1, J3.2, J4.2, U2.4, U2.10, U2.13, U2.14
+5V_MCU: D1.1, U1.14
ENC_A: C2.1, ENC1.A, R2.2, U1.2
ENC_B: C3.1, ENC1.B, R3.2, U1.3
ENC_SW: C4.1, ENC1.S1, R4.2, U1.4
GND: C1.2, C2.2, C3.2, C4.2, C5.2, ENC1.C, ENC1.S2, J1.2, J2.2, J3.3, J4.3, R5.2, U1.13, U2.1, U2.5, U2.7, U2.9, U2.12
LINK_TO_CONSOLE: J1.4, U1.11
LINK_TO_RING: J1.3, U1.10
RING_DATA: J2.3, J3.1, J4.1, R1.2
RING_DATA_3V3: R5.1, U1.1, U2.2
RING_DATA_5V: R1.1, U2.3
RING_DOUT: J2.4, J3.4, J4.4
