tomassasovsky/segno-hardware/hardware/led_strip/out/segno_led_strip.kicad_pcb

## KiCad design hardware/led_strip/out/segno_led_strip.kicad_pcb (2026-07-22)

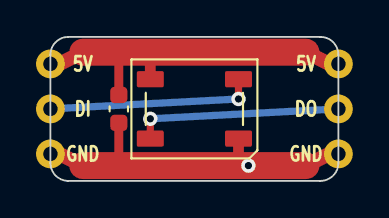
[picture p61: board segno_led_strip.kicad_pcb from above]

Board: 2 copper layers, 16.0 x 8.0 mm, 4 parts (0 on the bottom side), 4 nets.

Parts:
C1: C_0603_1608Metric
D1: LED_WS2812B_PLCC4_5.0x5.0mm_P3.2mm
J1, J2: castellated_edge

Connections:
+5V: C1.2, D1.1, J1.1, J2.1
DIN: D1.4, J1.2
DOUT: D1.2, J2.2
GND: C1.1, D1.3, J1.3, J2.3
