tomassasovsky/segno-hardware/hardware/kicad/console_board_pcb.py

"""pcbnew layout generator for the Segno CONSOLE board v3 (issue #747; v3: #987 ring link, CTRL ring sense; v3.1: #1388 MODE on GP12; v3.2: #1391 footswitch input protection).

Consumes `console_board.net` -- the SKiDL netlist is the single source of truth for
what connects to what -- and emits a placed, routed, poured, DRC-clean board plus a
JLCPCB-ready gerber zip.

Run (from hardware/kicad/, with KiCad's own Python, which is the one that has pcbnew):
    /Applications/KiCad/KiCad.app/Contents/Frameworks/Python.framework/Versions/Current/bin/python3 console_board_pcb.py

Modelled on hardware/led_strip/ledstrip_pcb.py, which already does the
place -> pour -> DRC -> kicad-cli -> zip pipeline for the LED strip.

PLACEMENT DRIVES ROUTING
------------------------
No autorouter. The board is laid out so routing is nearly trivial: every connector
sits in the SAME left-to-right order as the Pico pads it serves, so each fan-out
diverges without crossing and routes on one layer. Ordering is a gate, not a hope --
_check() proves no signal net has to cross another before a single track is drawn.

GND is not routed at all: it is a pour on both layers, and every GND pad gets its
own via BESIDE it -- never on it, since a via on a plated hole is a second drill hit
at the same coordinate and a via in an SMD pad starves the joint.
"""
import json
import math
import os
import shutil
import subprocess
import sys

import pcbnew
from silkscreen import finish_footprint, mask_clearance_problems

import console_ring_power
from netlist import parse_netlist

FromMM, ToMM = pcbnew.FromMM, pcbnew.ToMM
HERE = os.path.dirname(os.path.abspath(__file__))
NETLIST = os.path.join(HERE, "console_board.net")
OUT = os.path.join(HERE, "out_console")
BOARD_PATH = os.path.join(OUT, "segno_console_board.kicad_pcb")   # ROUTED: the
# deliverable, written only by the routing pipeline. build() does NOT touch it --
# it writes PLACED_PATH, and route_console_board.sh copies that over BOARD_PATH
# before importing the session. Placement used to write the deliverable directly,
# so running the generator on its own quietly replaced a routed, DRC-clean board
# with an unrouted one, and the next thing to read it (a fab check, a commit) was
# looking at a different board than the one that passed.
PLACED_PATH = os.path.join(OUT, "console.placed.kicad_pcb")       # PLACED only
KICAD_CLI = "/Applications/KiCad/KiCad.app/Contents/MacOS/kicad-cli"
KICAD_FP = "/Applications/KiCad/KiCad.app/Contents/SharedSupport/footprints"
LOCAL_FP = os.path.join(HERE, "segno.pretty")

ORIGIN = (100.0, 60.0)          # board origin on the KiCad page
# 99.5 square, and the number is the whole point: every prototype fab prices
# 2-layer boards in a cheap tier that stops at 100 x 100 mm, and 115 mm of width was
# over it for no structural reason -- the enclosure bay is 342 x 193, so nothing
# mechanical wanted those 15 mm.
#
# 99.5 rather than 100.0 because Edge.Cuts is drawn with a 0.1 mm line, so a 100.0
# outline measures 100.1 across the OUTSIDE of it. Most fabs quote from the line
# centre and would not care; the half millimetre costs nothing here and means no
# CAM operator has to make that call on our behalf.
#
# The width is now set by ONE thing: the footswitch row. Ten JST XH at an 8.5 mm
# courtyard plus the 0.8 mm keepout is 92.2 mm of the 100, which is why the pitch
# below is at its floor and why the row is the first thing to check if this board
# ever has to get smaller again. (It cannot, without giving up one connector per
# pedal.) Everything else fits inside that with room: the widest other row is
# J3 + the module + U1 + the ribbon, at 80.5 mm.
BW, BH = 99.5, 99.5             # see FLOORPLAN below
EDGE_R = 3.0                    # corner radius
MOUNT_INSET = 5.0               # mounting-hole centres, in from each corner.
# The holes are NOT synthesised here any more: H1..H4 come out of the netlist like
# every other part, because one of them carries GND. A chassis bond is a connection,
# so it belongs in the netlist, and placing them from PLACEMENT below means the
# auto-placer sees them before it looks for slots -- which is what stopped a passive
# landing on H2 back when they were added afterwards.

# Widths per the pcb-layout skill: ~1.0 mm for power/ground, ~0.6 mm for signal.
# The first cut used 0.35/0.8, which is under-sized on both counts -- the +5V rail
# feeds the whole WS2812 chain as well as logic.
# ONE width, 0.6 mm, and it is what the board actually gets: Freerouting takes the
# width from the DSN netclass, so this constant only reaches copper via the GND
# stubs. There used to be a TRACK_PWR = 1.0 beside it "for +5V/+3V3" -- it was read
# by _route(), the straight-line router that was retired when Freerouting took over,
# so the rails have been 0.6 mm all along while a constant said otherwise.
#
# 0.6 mm is what the ROUTER is given, and this is the arithmetic rather than a
# shrug. ONE standard, IPC-2221, 10 degC rise, 1 oz external -- the conservative
# one. This file used to quote IPC-2152 (~2 A for 0.6 mm) while route_ring_board.sh
# quoted IPC-2221 (1.65 A for the same copper), which is how the two boards came to
# report different margins for the same rail. 2152 is the newer and more generous
# standard and it would credit the pour either side as a heat spreader; the numbers
# below do not take that credit.
#
# This board was sized against 26 WS2812s flat out (16 ring + 10 single-LED
# indicators) at 60 mA = 1.56 A plus ~60 mA of logic, and 81 mV of IR drop over the
# ~60 mm from J3 to J6/J7.
#
# Ten 8-LED pills and one 40-LED strip draw up to 7.2 A at full white.
# The pills' 4.8 A enters on J3 and leaves on J24 across a 5 mm bar on both
# copper layers. console_ring_power installs a separate 1.7 mm hand-routed
# supply for 2.4 A LED channels, 0.04 A idle and 0.2 A controller before signal
# autorouting. Four parallel 0.5 mm drill vias carry its layer transition.
# The remaining 0.70 mm +5V tracks supply only console logic. The critical
# supply and ground ties are checked again on the actual board before export.
TRACK_W = 0.6                   # what the router is asked for, signal and rail alike
VIA_D, VIA_DRILL = 0.8, 0.4
# Local zone spacing and placement/via keepouts; this is not the routed-track
# minimum. The native project permits 0.20 mm copper clearance, while the DSN
# router uses 0.30 mm to leave rounding headroom (route_console_board.sh).
CLEARANCE = 0.25

# JLCPCB's published legend minima: 1 mm text, 0.15 mm strokes and clearance.
FAB_MIN_SILK_STROKE = 0.15
FAB_MIN_SILK_HEIGHT = 1.0
SILK_STROKE_RATIO = 1.0 / 5.0

# How the ground pours meet a pad. THERMAL, for the reason spelled out in
# _pour_gnd(); it is a named constant so --selftest can put it back to FULL and
# prove the gate that forbids that still bites.
PAD_CONNECTION = pcbnew.ZONE_CONNECTION_THERMAL

# MIDI IN's opto barrier: the DIN side of U2 must not share copper or a pour with
# anything else, or the isolation the H11L1 exists for is undone.
ISOLATION_GAP = 2.0


def P(x, y):
    return pcbnew.VECTOR2I(FromMM(ORIGIN[0] + x), FromMM(ORIGIN[1] + y))


# ---- FLOORPLAN --------------------------------------------------------------
# Two rules decide this layout, and neither is "make it look tidy".
#
# 1. THE PIN MAP IS HALF THE FLOORPLAN. The module's pads 1..20 are one physical
#    row and 21..40 the other, so console_board.py's GPIO choice decides which side
#    of the module a connector can sit on. Row B (up) carries CTRL, LINK, IND and
#    the expansion pins; row A (down) carries the ten footswitches and the ring.
#
# 2. CONNECTORS ARE GROUPED BY WHERE THEIR CABLE GOES, not by what they do
#    electrically. Five headers -- POWER, MIDI IN, MIDI OUT, CTRL 1, CTRL 2 -- all
#    terminate on the rear panel, so they sit together along the top edge IN THE
#    PANEL'S OWN LEFT-TO-RIGHT ORDER (gated below against rear_io_stations.json).
#    One harness, one edge, no crossings. Before this they were split between the
#    top band and the right column, so the rear-panel loom left the board twice.
#
#   y  8   J8 PWR  J5 MIDI-IN  J4 MIDI-OUT  J20 CTRL1  J21 CTRL2
#   y 14   D1, in the opto pocket between J5 and U2 -- it clamps U2's LED
#   y 21   (the rest of their passives; J22 EXP beside U2). Shoulder to shoulder at
#          99.5 mm wide: R5, R10 and D1 are all hand-placed, because the spiral
#          cannot find 12.3 mm of axial anywhere in range once the band is this full
#   y 46      | [======== PICO (rot 90) ========]  U1  | J2 (Pi ribbon, right edge,
#   y 57   J3 5V IN (VH, left edge, under the USB corridor)
#   y 59   resistor row; R2 below U1, horizontal
#   y 61   J24 PILLS (VH, under J3: 5V/DATA/GND, +5V pads bridged)
#   y 69   J23 PD       J6 RING     J25 SCREEN     J9 PI PWR beside the ribbon
#   y 76   [=========== debounce caps ===========]  (kept HIGH: they are the middle
#          hop of every switch net, and pushing them down with the headers below put
#          SW_BANK over the 42 mm hop limit exactly. 76.1, not 75: the row came
#          down 1.1 mm to clear J24's end, so C1 stays in it, #1062)
#   y 85   [======== ten footswitch headers ======]
#   y 95   title block, between the two bottom mounting holes
REAR_PANEL_ORDER = ["J8", "J5", "J4", "J20", "J21"]   # = the panel's own order

# The module's CENTRE, not its origin: _load_fp places by extent centre, which is
# what lets the THT footprint (origin at pin 1) sit exactly where the SMD one
# (origin at the centre) did -- pads x 18.87..67.13, y 37.11..54.89.
PICO_X, PICO_Y = 43.0, 46.0
PLACEMENT = {
    "J1":  (PICO_X, PICO_Y, 90),   # Pico 2, rot 90 so the pad rows lie horizontal.
                                   # x 43 is pinned from the RIGHT, not chosen: U1 is
                                   # 9.8 mm wide and has to fit between this module
                                   # and the ribbon's 10 mm column, which leaves the
                                   # module's right edge at 70. That costs SW_BANK
                                   # its margin -- 40.7 mm of the 42 mm hop limit --
                                   # and it is the tightest number on the board.
                                   # Its USB end points LEFT and nothing is reserved
                                   # for a cable: VSYS takes +5V from J3, the Pi
                                   # flashes it cold over SWD (J9), and control is
                                   # the UART on GP16/17. USB is bench-only.

    # top edge: the rear-panel loom, in the panel's order, on an even 16 mm pitch.
    # The row stops at x 83.5 rather than running to the edge: the ribbon's column
    # starts at 84.5 and comes up to y 10.2, so the last two headers would sit on
    # top of it. The corner mounting holes cap the other end the same way.
    "J8":  (18.1, 8.0, 0),
    "J25": (68.0, 69.0, 0),       # GPIO17 / GND to screen-power daughterboard
    "J23": (27.5, 69.0, 0),        # same connector row as RING J6 and SCREEN J25
                                   # I2C to the PD trigger, under the module's
                                   # left end between 5V IN and EXP: GP0/GP1 are
                                   # pads 1/2, a 12 mm hop up. x 27.5, not 16.5
                                   # (#1062): J24 took the left edge beside it,
                                   # and its PILLS 5V label needs the strip J23
                                   # vacated.
    "J9":  (79.5, 69.0, 0),        # Pi button lead exits beside the GPIO ribbon
                                   # (NOT a header pin -- no GPIO wakes a Pi 5;
                                   # see PWR_BTN in console_board.py)
    "J5":  (34.0, 8.0, 0),         # MIDI IN  -- 2 leads: DIN pins 4 and 5 only.
                                   # Pin 2 is left OFF at a receiver by MIDI 1.0;
                                   # bonding the shield here would short out the
                                   # isolation U2 exists to provide.
    "J4":  (50.0, 8.0, 0),         # MIDI OUT -- 3 leads: DIN pins 4, 5 and 2.
    # 4-way since v3 (tip, ring, sleeve, ring-normal for presence): 2.5 mm
    # wider each, so the pair slides left to keep 0.8 mm to MIDI OUT on one
    # side and to the ribbon's column on the other.
    "J20": (63.4, 8.0, 0),         # CTRL 1, over GP26 = pad 31
    "J21": (77.7, 8.0, 0),         # CTRL 2, over GP27 = pad 32
    "U2":  (34.0, 21.0, 0),        # H11L1, directly under its own jack, in its own
                                   # ISOLATION_GAP pocket

    # CTRL divider + anti-alias, hand-placed under their own two jacks. All five
    # anchor within a few mm of each other, so the spiral packs the first ones in
    # and leaves the last with no legal slot -- and these are signal-path parts, so
    # they should hug the pins they serve rather than land wherever there is room.
    "R8":  (63.0, 16.0, 0), "R7": (77.0, 16.0, 0),
    # The two MIDI OUT series resistors, likewise by hand. R3 spans U1's gate-C
    # output to the jack -- a 46 mm reach -- so anchored to either end it is 48 mm
    # from the other. A series part belongs BETWEEN its endpoints, not beside one.
    "R3":  (66.9, 31.0, 0), "R4": (50.0, 16.0, 0),
    "R6":  (71.4, 25.0, 0),
    "C13": (55.9, 21.0, 0), "C14": (66.0, 21.0, 0), "R9": (76.9, 21.0, 0),
    # R10 and R5 are hand-placed for the same reason the rest of this band is: at
    # 100 mm wide the band is full, and the spiral cannot find 12.3 mm of axial
    # anywhere within its search radius. They are the two MIDI IN parts, so they
    # belong beside U2 and its jack rather than wherever a gap happened to be.
    "R10": (57.0, 27.0, 0), "R5": (35.0, 29.5, 0),
    # D1 clamps the opto's LED, so it is a MIDI IN part and belongs in the pocket
    # with U2, R5 and J5 -- between the DIN jack and the opto. Left to the spiral it
    # landed 15 mm away, straight across the only lane from J8 down to J9, and the
    # router could not get PWR_BTN through at all. The isolation gate could not
    # object: D1 shares the DIN-side nets, so it is exempt by construction.
    "D1":  (34.0, 14.4, 0),

    # left edge: power in, the pills' power out, and the reservoir.
    # J3 and J24 are JST VH (#1062), stacked, BOTH rot 90: a VH header's latch wall
    # is on one side of its posts, and rot 90 turns that wall to the board edge, so
    # both housings latch the same way and both latches are reachable from outside.
    # Rot 90 puts J3's pin 1 (+5V) at its bottom and J24's pin 3 (+5V) at its top,
    # face to face across the poured bar (_pill_bar_rects). J3 starts below the USB
    # corridor (y 40..52); J24, the 3-way, runs to y 74.3, so the cap row sits at
    # CAP_Y 76.1 to clear it.
    # x 5.4: the 9.6 mm-wide pair spans x 0.6..10.2, 0.6 clear of R21.
    # Both moved up 8 mm (#1062, owner call) into what used to be the USB
    # corridor: the module is socketed now, so reaching its USB means lifting it
    # out, not threading a cable past these. The logo ends up partly under the
    # two housings, which costs nothing but paint.
    "J3":  (5.4, 48.9, 90),       # AUX: 7.2 A full-white LEDs plus controllers
    "J24": (5.4, 60.84, 90),     # the pills: 5V/DATA/GND, 4.8 A at full white.
                                  # 1.0 mm below its first spot (#1062, owner
                                  # call): the two plugs now clear by ~2.1 mm
                                  # instead of 1.1, per JST's own housing
                                  # lengths (VHR-2N 7.86, VHR-3N 11.82). Not
                                  # 1.5: that puts the back DATA legend on
                                  # R21's pad, and PIN_LEGEND refuses it.
                                  # Courtyard touching J3's: that is 1 mm between the
                                  # two bodies, and a VH housing is no longer than
                                  # its header, so both plugs still seat. It is what
                                  # lets C1 stay in the cap row under J24.
    "C31": (6.7, 20.0, 0),        # 100uF  on +5V
    "C30": (6.7, 33.0, 0),        # 470uF bulk on +5V (the WS2812 reservoir)

    # right: the buffer, then the ribbon on the edge itself
    "U1":  (76.0, 44.0, 0),        # 74AHCT125, sat LOW on purpose. Its ring input is
                                   # pin 5; RING_DATA comes off the module's row A
                                   # (the bottom row), so with U1 up at y 34 that one
                                   # net had to climb 18 mm THROUGH the link / IND /
                                   # EXP / CTRL bundle that crosses the same gap, and
                                   # it was the only net that would never route. At
                                   # y 44 pin 5 comes down to meet it. Pin 2 (IND,
                                   # from row B) is still within 2 mm of its own row.
    "J2":  (89.5, 42.0, 180),      # Pi ribbon, ON THE EDGE, and rotated 180 so its
                                   # PIN 1 is at the FRONT end (-v in the enclosure).
                                   # The Pi's header has pin 1 at its SD-card end,
                                   # which the enclosure puts at -v as well: two
                                   # vertical headers facing each other across a gap
                                   # need pin 1 at the SAME end, or the ribbon has to
                                   # fold back on itself to mate -- and that fold is
                                   # what drapes it over the Pi's cooler intake.
                                   # A 40-way ribbon leaving
                                   # mid-board folds straight back over everything;
                                   # here the cable clears the board immediately.
    "J22": (46.3, 26.0, 0),        # expansion, 2x3: GP15/28, pin 3 unconnected
                                   # since GP12 became MODE (#1388; GP19-22 left
                                   # it in v3 for the jacks). Where it was on
                                   # v2 -- the bench preferred it here. Not on
                                   # the top edge: its GP28 pin is pad 34, near
                                   # the module's LEFT end, while GP15 is pad 20
                                   # at the right -- from the top-right corner
                                   # that ADC lead ran 61 mm. Sat here it
                                   # reaches both ends of its span.

    # Buffer support parts stay beside U1. R2 lies horizontally below it to
    # leave the internal connector row free for the Pi button lead at J9.
    "C11": (80.0, 31.0, 0),        # +5V decoupling for U1
    # Decoupling beside U2's supply pin, on the logic side. The native routed
    # branch from pin 6 to C20 is 5.16 mm, versus 17.5 mm at the old location.
    # Courtyard gaps are 2.045 mm to U2, 0.510 mm to R4 and 0.500 mm to J22;
    # the existing 2 mm isolation guard stays in force. Its ground stitch goes
    # east, clear of the locally rerouted +3V3 and Pico supply branches.
    "C20": (43.75, 19.6, 0),        # +3V3 decoupling for U2
    # The ring link's two pull-ups, on the Pico's own 3V3 (they used to live on
    # ring_board.py tied to its 5 V rail, 1.4 V over the RP2350's absolute
    # maximum). R13, R1 and R15 -- the third pull-up, the ring-data series part
    # and its pull-down -- retired with the ring-data path in v3 (#987); their
    # slots stay open and their designators stay unused.
    # On the slim band under the module's row A with R20/R16 (they were at
    # y 63): the row below is then R21/R22's and the row below that J23's.
    "R11": (19.4, 59.6, 0), "R12": (32.2, 59.6, 0),
    # The CTRL rings' sense resistors (v3), in the row R13 and R15 left empty
    # when the ring-data path went. 50-60 mm from the jacks they serve, and
    # exempt from the hop gate for it (SLOW_SENSE_NETS); the column beside U2
    # that would have put them under the jacks is the expansion header's.
    "R19": (45.0, 63.0, 0), "R20": (48.0, 59.6, 0),
    # The presence series parts (v3, switched jacks), same reasoning and the
    # same exemption: the row under R11/R12, left of R19.
    "R21": (17.0, 63.0, 0), "R22": (30.0, 63.0, 0),
    "R2":  (77.4, 58.9, 0),         # 330R below U1; clears J9 beside the ribbon

    # The five review-fix resistors. ALL hand-placed: the passive bands were
    # already at capacity (R5/R10/D1 above went by hand for the same reason) and
    # the spiral found no slot for the first of these it tried. Slot geography,
    # learned the expensive way: the SE field sits under the footswitch labels'
    # fixed row at y 80.1, which prints across anything parked there (the row is
    # a placement keepout in build() now, so the spiral at least knows); the
    # U1-south pocket must keep its x 69..73 column open or the search-placed
    # 'LEDS' label loses the one window it can print in (above J7, reached at
    # d~5.5); and the channel east of the ribbon fits three uprights, of which
    # R14 and R17 stand there today. Assignment is by spur cost -- each part
    # sits nearest its OWN net, because the RATSNEST budget below counts every
    # millimetre of these.
    "R14": (96.9, 59.85, 90),      # 100k midi_tx pull-DOWN, upright east of the
                                   # ribbon, level with J2 pin 8: 11 mm from it;
                                   # the GND leg lands in the pour
    "R17": (96.9, 45.0, 90),       # 10k link_tx series, upright east of the
                                   # ribbon: 11 mm from J2 pin 21, 29 mm from
                                   # the Pico's GP16 pad
    "R18": (71.45, 63.0, 0),       # 6.8k link_rx; clears the PI PWR label at right
                                   # both legs within 28 mm
    "R16": (61.5, 59.6, 0),        # 100k ind_data pulldown, in the slim band
                                   # the same band: 22 mm from U1 pin 2; its GND
                                   # leg lands in the pour
    "J6":  (52.5, 69.0, 0),        # ring link (4-way since v3), under pads 19/20

    # The four M3 holes, one per corner. H1 is the chassis bond (see console_board.py):
    # top-left, the corner nearest the rear-panel loom and diagonally away from the
    # ribbon, so an ESD strike on a footswitch lead reaches the case rather than
    # travelling the 40-way into the Pi.
    "H1":  (MOUNT_INSET, MOUNT_INSET, 0),
    "H2":  (BW - MOUNT_INSET, MOUNT_INSET, 0),
    "H3":  (BW - MOUNT_INSET, BH - MOUNT_INSET, 0),
    "H4":  (MOUNT_INSET, BH - MOUNT_INSET, 0),
}
# footswitches J10..J19 along the bottom, left-to-right in PICO PAD order --
# that ordering is what keeps the fan-out from crossing (gated in _check). It is
# no longer designator order: MODE moved to GP12 (#1388), pad 16, the right end
# of the run, so its header J13 (still MODE's designator, with C4 its debounce
# cap, as on v3) takes the rightmost slot and TRK1..BANK each shift one slot
# left. Pad 7 in the middle of the run is GP5, left unconnected (SPARE_GPIO in
# console_board.py says why it does not go to J22).
FSW_SLOTS = ["J10", "J11", "J12", "J14", "J15", "J16", "J17", "J18", "J19", "J13"]
#
# 84.2, not 85.0, since the module was socketed (#1062). Its through-holes sit
# 0.8 mm inboard of the hand-solder pads they replace, so every hop from the
# module's bottom row to this one grew by that, and SW_BANK -- the worst one,
# already at 97% of MAX_HOP_MM -- went over. MAX_HOP_MM's own note says the next
# millimetre comes from the floorplan rather than from the limit, so this row
# gives it back. Below it there is room: the labels sit at 80.1 and the bottom
# strip at 95.5.
FSW_Y = 84.2
FSW_X0, FSW_X1 = 8.0, 92.0     # THE constraint on the board's width. An 84 mm span
                               # of centres is the floor -- ten 8.5 mm JSTs plus the
                               # 0.8 mm keepout is 92.2 mm of outline, and the row is
                               # centred in the 100, leaving 3.75 mm each side. The
                               # row cannot shrink without giving up one connector
                               # per pedal, so a smaller board means a different
                               # bench story, not a tighter layout.
                               # y 85 on the 99.5 board: the row's courtyard bottom
                               # lands at ~88.4 and the corner holes' 6.4 mm pads
                               # start at 91.3 -- 2.9 mm clear, which DRC checks.
# Per-cap overrides of the row. Empty: C1 once sat out of the row beside J24,
# and the row moved down 1.1 mm instead so every cap stays over its own switch.
CAP_AT = {}
CAP_Y = 75.3   # 0.8 up with the socketed module (#1062): the debounce cap, not
               # the footswitch, is the nearest pad on each SW_ net, so it is the
               # cap row that MAX_HOP_MM actually measures against                   # the debounce cap row, one cap directly above its
                               # own switch -- see _place_debounce_caps(). 76.1
                               # clears J24, the 3-way pill header at the left edge
                               # (#1062); the row was at 75


def fsw_x(i):
    return FSW_X0 + (FSW_X1 - FSW_X0) * i / 9.0


# ---- footswitch input protection (#1391), on the BACK -----------------------
# console_board.py puts a 1k (R23..R32) and a clamp (D2..D6, one dual part per
# two inputs) between every footswitch header and its GPIO. The front has no
# room for twenty more parts: the strip between the debounce caps and the
# headers holds the function labels, and every gap in the cap row holds a
# designator. The back of that strip is empty. Each column has one THT pad above
# (the cap's pin 1, y 75.3) and one below (the header's pin 1, y 84.2), both at
# the same x, and the circuit is exactly "cap pin 1 -- 1k -- header pin 1", so
# the parts go there as surface-mount: hand-solderable 1206 and SOT-23, and
# the only SMD parts on the board. Seen from the top, one pair of columns:
#
#        cap a pin 1              cap b pin 1               (THT, y 75.3)
#     R_a ref          D ref           R_b ref               (back silk)
#   [2  R_a  1]      K1   K2        [1  R_b  2]              (y 80.0 / 78.5)
#                       A                                    (y 81.5)
#    header a pin 1   pin 2 (GND)  header b pin 1            (THT, y 84.2)
#
# Each resistor's cable-side pad 1 faces the clamp between the two columns, and
# the clamp's anode lands beside header a's GND pin, so a strike on either cable
# returns to a ground pin a few millimetres from where it arrived (TI SLVA680:
# the TVS at the connector, its ground short).
FSW_SERIES_Y = 80.0
FSW_TVS_Y = 80.0
FSW_TVS_ROT = 270      # on the back: K1 upper left, K2 upper right, anode below
BACK_SILK_GAP = 0.3    # back designator to its own part's courtyard


def _input_protection(fps, nets):
    """-> {ref: (x, y, rot)}: each footswitch's series resistor and its clamp.

    Paired off the netlist, like _debounce_caps(): the resistor and the clamp are
    whatever sits on the net of that header's pin 1. Positions come from the
    placed header's own pin 1, and columns are taken left to right as placed,
    so they follow the headers wherever they go.
    """
    out = {}
    columns = sorted(FSW_SLOTS, key=lambda r: _pad_xy(fps[r], "1")[0])
    assert len(columns) % 2 == 0, (
        f"PROTECT: {len(columns)} footswitch headers; each dual clamp serves two "
        "neighbours, so one header would be left without one")
    for i, j in enumerate(columns):
        ext = [n for n, nodes in nets.items() if (j, "1") in nodes]
        assert len(ext) == 1, f"PROTECT: {j} pin 1 is on {ext}, expected one net"
        refs = {r for r, _p in nets[ext[0]]}
        rs = sorted(r for r in refs if r.startswith("R"))
        ds = sorted(r for r in refs if r.startswith("D"))
        assert len(rs) == 1 and len(ds) == 1, (
            f"PROTECT: {ext[0]} carries {sorted(refs)}, expected one resistor and "
            "one clamp beside the header")
        x1, _y1 = _pad_xy(fps[j], "1")
        # Pad 1 is the cable side; it faces the clamp between the pair's columns.
        out[rs[0]] = (x1, FSW_SERIES_Y, 180 if i % 2 == 0 else 0)
        if i % 2 == 0:
            partner = columns[i + 1]
            assert any(r == ds[0] for r, _p in
                       next(nodes for n, nodes in nets.items()
                            if (partner, "1") in nodes)), (
                f"PROTECT: {ds[0]} clamps {j} but not its neighbour {partner} -- a "
                "dual clamp has to serve two ADJACENT headers, or one of its "
                "traces crosses a column")
            out[ds[0]] = ((x1 + _pad_xy(fps[partner], "1")[0]) / 2.0,
                          FSW_TVS_Y, FSW_TVS_ROT)
    want = len(columns) + len(columns) // 2
    assert len(out) == want, f"PROTECT: placed {len(out)} protection parts, expected {want}"
    return out


def _on_back(fp):
    """A surface-mount part on the back: its copper and its body are under the
    board, where only the THT pads of the parts above can collide with it."""
    return fp.IsFlipped() and not any(p.GetAttribute() == pcbnew.PAD_ATTRIB_PTH
                                      for p in fp.Pads())


def _tht_pad_boxes(fp):
    """Boxes, board-local mm, of a footprint's plated through-hole pads."""
    out = []
    for p in fp.Pads():
        if p.GetAttribute() not in (pcbnew.PAD_ATTRIB_PTH, pcbnew.PAD_ATTRIB_NPTH):
            continue
        b = p.GetBoundingBox()
        out.append((ToMM(b.GetLeft()) - ORIGIN[0], ToMM(b.GetTop()) - ORIGIN[1],
                    ToMM(b.GetRight()) - ORIGIN[0], ToMM(b.GetBottom()) - ORIGIN[1]))
    return out


for _i, _ref in enumerate(FSW_SLOTS):
    PLACEMENT[_ref] = (fsw_x(_i), FSW_Y, 0)

PWR_NETS = {"+5V", "+3V3", "+3V3_PICO"}
# The FLOOR, which is the routed width: a rail under this means the netclass in
# route_console_board.sh did not reach the copper, which is a real fault.
MIN_RAIL_TRACK_W = {"+5V": 0.60, "+3V3": 0.60, "+3V3_PICO": 0.60}
# What widen_power.py aims +5V at afterwards. Reported, NOT enforced, and the
# distinction cost a fab run to learn: this was briefly a 0.70 floor, and when a
# re-route came back with no clearance headroom the widening correctly did
# nothing and the gate then failed the board for it -- a stop with no action
# behind it, on copper that was fine. What the router hands back is not ours to
# promise. The floor is the promise; this is the goal, and missing it prints the
# reason widen_power.py gave rather than halting.
RAIL_TARGET_W = {"+5V": 0.70}
# Copper, mask, paste, silk, outline -- the layers a fab needs and nothing else.
# Paste is in the list because the boards that were actually manufactured were
# built from a set that carried it (43 front stencil apertures); leaving it out
# here made the script emit a set the committed gerbers did not match.
FAB_LAYERS = ("F.Cu,B.Cu,F.Mask,B.Mask,F.Paste,B.Paste,"
              "F.Silkscreen,B.Silkscreen,Edge.Cuts")
# The board's own via geometry. Router-inserted vias are checked against it because
# they arrive from Freerouting, not from _via(), and defaulted to 0.6/0.3 once.
MIN_VIA_D, MIN_VIA_DRILL = 0.8, 0.4
POUR_NET = "GND"


# Passives are NOT in the table above. Hand-placing 26 resistors and capacitors
# is a table that silently drifts from the netlist the first time a part is added.
# Instead they are placed BY the netlist: each one lands next to whichever placed
# part it shares the most nets with, in the nearest free slot. Deterministic
# (sorted iteration, first-fit outward spiral), and _check()'s overlap gate proves
# the result rather than trusting it.
KEEPOUT = 0.8                   # margin around every footprint, mm. Also covers
                                # the body overhanging its outermost pads.
GRID = 1.0                      # placement search step
STITCH_STEP = 12.0              # GND stitching via pitch


# ---- board -----------------------------------------------------------------

def _outline(board):
    pts = [(EDGE_R, 0), (BW - EDGE_R, 0), (BW, EDGE_R), (BW, BH - EDGE_R),
           (BW - EDGE_R, BH), (EDGE_R, BH), (0, BH - EDGE_R), (0, EDGE_R)]
    segs = [(pts[0], pts[1]), (pts[2], pts[3]), (pts[4], pts[5]), (pts[6], pts[7])]
    for a, b in segs:
        s = pcbnew.PCB_SHAPE(board, pcbnew.SHAPE_T_SEGMENT)
        s.SetStart(P(*a)); s.SetEnd(P(*b))
        s.SetLayer(pcbnew.Edge_Cuts); s.SetWidth(FromMM(0.1))
        board.Add(s)
    for cx, cy, sa, ea in ((EDGE_R, EDGE_R, (0, EDGE_R), (EDGE_R, 0)),
                           (BW - EDGE_R, EDGE_R, (BW - EDGE_R, 0), (BW, EDGE_R)),
                           (BW - EDGE_R, BH - EDGE_R, (BW, BH - EDGE_R), (BW - EDGE_R, BH)),
                           (EDGE_R, BH - EDGE_R, (EDGE_R, BH), (0, BH - EDGE_R))):
        a = pcbnew.PCB_SHAPE(board, pcbnew.SHAPE_T_ARC)
        a.SetCenter(P(cx, cy)); a.SetStart(P(*sa)); a.SetEnd(P(*ea))
        a.SetLayer(pcbnew.Edge_Cuts); a.SetWidth(FromMM(0.1))
        board.Add(a)


def _load_fp(board, lib, name, ref, x, y, rot, by_centre=True, back=False):
    """Place a footprint so (x, y) is the CENTRE of its extent.

    A footprint's origin is wherever its author put it -- pad 1 on an axial
    resistor, a corner on the Pico (whose pads run 0..17.78 x 0..48.26). Placing
    by origin means every coordinate in PLACEMENT silently means something
    different, which is how the Pico ended up straddling the footswitch row.
    """
    path = LOCAL_FP if lib == "segno" else os.path.join(KICAD_FP, lib + ".pretty")
    fp = pcbnew.FootprintLoad(path, name)
    if fp is None:
        raise SystemExit(f"footprint not found: {lib}:{name} (looked in {path})")
    fp.SetReference(ref)
    # KiCad ships the JST VH footprints without a 3D model (Connector_JST.3dshapes
    # has none), so point them at the ones vh_models.py draws in segno.pretty.
    # KIPRJMOD is out_console/, where the board file lives.
    # Indexed, not iterated: `for model in fp.Models()` hands back copies, and
    # setting the path on a copy silently changes nothing.
    if name.startswith("JST_VH_"):
        models = fp.Models()
        for i in range(len(models)):
            models[i].m_Filename = "${KIPRJMOD}/../segno.pretty/" + name + ".step"
    board.Add(fp)
    fp.SetPosition(P(0.0, 0.0))
    if back:
        # Flipped BEFORE the rotation, so `rot` means the same thing for every
        # back part: the orientation as seen from the top of the board.
        fp.Flip(fp.GetPosition(), pcbnew.FLIP_DIRECTION_TOP_BOTTOM)
    if rot:
        fp.SetOrientationDegrees(rot)
    cw, ch = _courtyard_size(lib, name)
    if abs((rot % 180.0) - 90.0) < 1.0:
        cw, ch = ch, cw
    _SIZE[ref] = (cw, ch)
    # The VH headers stack end to end at the left edge (#1062), and KiCad's pin-1
    # arrow sits just past each one's end: J3's lands on J24's outline, J24's on
    # C1's. The outline already shows which side the latch wall is on, and the
    # housing only fits one way round, so the arrow carries nothing the outline
    # does not. It is the three short segments under 0.8 mm; the outline is not.
    if name.startswith("JST_VH_"):
        for g in list(fp.GraphicalItems()):
            if g.GetLayer() == pcbnew.F_SilkS and g.GetClass() == "PCB_SHAPE":
                bb = g.GetBoundingBox()
                if ToMM(bb.GetWidth()) < 0.8 and ToMM(bb.GetHeight()) < 0.8:
                    fp.Remove(g)
    if by_centre:
        off = _centre(fp)
        fp.SetPosition(P(x - off[0], y - off[1]))
    else:
        fp.SetPosition(P(x, y))
    _apply_connector_drills(fp)
    finish_footprint(fp)
    return fp


# JLCPCB finished PTH tolerance is +0.13/-0.08 mm. These sizes leave
# insertion room for the maximum square JST posts even at the minimum bore.
# Apply to this board's instances, preserving upstream library footprints.
CONNECTOR_DRILLS_MM = {
    "JST_XH_": 1.10, "JST_VH_": 1.80,
    # Exact purchase parts: Wurth 61204021621 and 61300621121 respectively.
    # 0.64 +/-0.15 mm square posts need >=1.117 mm diagonal insertion room.
    "IDC-Header_2x20_P2.54mm_Vertical": 1.25,
    "PinHeader_2x03_P2.54mm_Vertical": 1.25,
}


def _connector_drill(fp):
    name = fp.GetFPIDAsString().split(":")[-1]
    return next((diameter for prefix, diameter in CONNECTOR_DRILLS_MM.items()
                 if name.startswith(prefix)), None)


def _apply_connector_drills(fp):
    diameter = _connector_drill(fp)
    if diameter is not None:
        for pad in fp.Pads():
            if pad.GetAttribute() == pcbnew.PAD_ATTRIB_PTH:
                pad.SetDrillSize(pcbnew.VECTOR2I(FromMM(diameter), FromMM(diameter)))
                if diameter == 1.25:
                    size = pad.GetSize()
                    pad.SetSize(pcbnew.VECTOR2I(max(size.x, FromMM(1.80)),
                                               max(size.y, FromMM(1.80))))


def _check_connector_drills(board):
    for fp in board.GetFootprints():
        expected = _connector_drill(fp)
        if expected is None:
            continue
        for pad in fp.Pads():
            if pad.GetAttribute() != pcbnew.PAD_ATTRIB_PTH:
                continue
            actual = pad.GetDrillSize()
            assert actual.x == actual.y == FromMM(expected), (
                f"CONNECTOR_DRILL: {fp.GetReference()} pad {pad.GetNumber()} "
                f"requires {expected:.2f} mm finished drill")
            if expected == 1.25:
                size = pad.GetSize()
                assert min(size.x, size.y) >= FromMM(1.80), (
                    f"CONNECTOR_DRILL: {fp.GetReference()} pad {pad.GetNumber()} "
                    "requires at least 1.80 mm copper for its annulus")


def _pad(fp, padname):
    for p in fp.Pads():
        if p.GetNumber() == str(padname):
            return p
    return None


def _pad_xy(fp, padname):
    p = _pad(fp, padname)
    if p is None:
        return None
    pos = p.GetPosition()
    return (ToMM(pos.x) - ORIGIN[0], ToMM(pos.y) - ORIGIN[1])


VIA_KEEPOUT = VIA_D / 2.0 + CLEARANCE     # via centre -> anything else it must clear


def _drill_keepout(fps):
    """Every pad on the board as a box a via centre may not enter.

    Boxes come from the pad's own bounding box, which is in board coordinates and
    already accounts for the footprint's rotation -- GetSize() does not, and a
    rotated module's pads then read as keepouts of the wrong shape.
    """
    out = []
    for fp in fps.values():
        for p in fp.Pads():
            b = p.GetBoundingBox()
            out.append((ToMM(b.GetLeft()) - ORIGIN[0] - VIA_KEEPOUT,
                        ToMM(b.GetTop()) - ORIGIN[1] - VIA_KEEPOUT,
                        ToMM(b.GetRight()) - ORIGIN[0] + VIA_KEEPOUT,
                        ToMM(b.GetBottom()) - ORIGIN[1] + VIA_KEEPOUT))
    return out


def _via_free(x, y, boxes):
    if not (1.0 <= x <= BW - 1.0 and 1.0 <= y <= BH - 1.0):
        return False
    return not any(x0 <= x <= x1 and y0 <= y <= y1 for x0, y0, x1, y1 in boxes)


def _claim_via(x, y, boxes):
    """Reserve a via's own footprint so the next one cannot land on top of it."""
    r = VIA_D + CLEARANCE
    boxes.append((x - r, y - r, x + r, y + r))


def _track(board, net, layer, width, a, b):
    t = pcbnew.PCB_TRACK(board)
    t.SetStart(P(*a)); t.SetEnd(P(*b))
    t.SetWidth(FromMM(width)); t.SetLayer(layer)
    t.SetNet(net)
    board.Add(t)


def _via(board, net, x, y):
    v = pcbnew.PCB_VIA(board)
    v.SetPosition(P(x, y))
    v.SetWidth(FromMM(VIA_D)); v.SetDrill(FromMM(VIA_DRILL))
    v.SetViaType(pcbnew.VIATYPE_THROUGH)
    v.SetLayerPair(pcbnew.F_Cu, pcbnew.B_Cu)
    v.SetNet(net)
    board.Add(v)


def _stitch_grid(board, net, fps, boxes):
    """A coarse via grid tying the B.Cu pour together.

    Routing on B.Cu chops the pour into islands, and an island with no via back to
    the net reads as "unconnected" -- four of them did. Per-pad vias alone are not
    enough because they sit where the copper is busiest. Vias go in BEFORE the DSN
    export so Freerouting treats them as obstacles and routes around them.

    `boxes` carries the drill keepout: every pad, plus every via already placed. The
    lattice walks a fixed pitch with no idea what is under it, so without that it
    will happily drop a via down a plated hole.
    """
    keep = list(boxes) + [_bbox_mm(fp) for fp in fps.values()]
    n = 0
    y = STITCH_STEP
    while y < BH - STITCH_STEP / 2:
        x = STITCH_STEP
        while x < BW - STITCH_STEP / 2:
            if _via_free(x, y, keep):
                _via(board, net, x, y)
                _claim_via(x, y, keep)
                n += 1
            x += STITCH_STEP
        y += STITCH_STEP
    return n


# 12 mm, and deliberately no finer. The lattice is the COARSE half of the stitching:
# it ties the open areas, and _stitch_gnd() ties everything that matters near a pad,
# which is where a pour actually fragments. Tightening the lattice instead was tried
# -- 8 mm, 49 lattice vias -- and it is the wrong lever twice over: it cannot place a
# via near a connector anyway (every point inside a footprint is skipped), so it did
# not fix the starved thermals at J6, and the extra obstacles in the open middle cost
# the router SWCLK, which it then left unrouted. Ties belong beside the pads that
# need them, not spread evenly over the board.


def _pour_gnd(board, net, layer=pcbnew.B_Cu):
    z = pcbnew.ZONE(board)
    z.SetLayer(layer)
    z.SetNet(net)
    z.SetLocalClearance(FromMM(CLEARANCE))
    z.SetMinThickness(FromMM(0.2))
    # Thermal relief, NOT a solid tie. This was solid on the strength of "every
    # part here is through-hole and hand-soldered, so the usual wave/reflow thermal
    # argument is moot" -- which stopped being true the moment the Pico became a
    # surface-mount module. Its nine GND pads now sit in a plane on their own layer,
    # and a solid tie wicks the iron's heat straight into that plane: cold joints on
    # the one part that is painful to rework.
    #
    # The original reason for going solid was five "starved_thermal" errors from
    # spokes too narrow to form, which is a symptom of leaving the widths at their
    # defaults rather than a reason to abandon relief -- so they are set explicitly.
    z.SetPadConnection(PAD_CONNECTION)
    z.SetThermalReliefGap(FromMM(0.3))
    z.SetThermalReliefSpokeWidth(FromMM(0.4))
    z.SetIslandRemovalMode(pcbnew.ISLAND_REMOVAL_MODE_ALWAYS)
    # Delete every fragment not joined to the pour's main body. A dense 2-layer
    # F.Cu pour always breaks up around the routing, and raising a minimum-area
    # threshold only moves the complaint to the next pad -- it was chased from C14
    # to C5 to U1 that way. A fragment cannot carry a return current anywhere, and
    # nothing depends on it: _stitch_gnd() already drops a via on every GND pad, so
    # each one reaches the B.Cu plane on its own.
    o = z.Outline()
    o.NewOutline()
    for x, y in ((0.3, 0.3), (BW - 0.3, 0.3), (BW - 0.3, BH - 0.3), (0.3, BH - 0.3)):
        o.Append(P(x, y).x, P(x, y).y)
    z.SetIsFilled(False)
    board.Add(z)
    return z


# The pills' current path (#1062). J3 pin 1 and J24 pin 3 (both +5V) face each
# other a few mm apart in one column at the left edge; this pours a bar between
# them on BOTH copper layers so the 4.8 A of pills never has to find its way along
# a routed track. Priority over the GND pours, thermal relief because THERMALS
# forbids solid ties on a board with SMD parts, and spokes wide enough that relief
# is not the bottleneck: ~2.9 mm of spoke copper a layer round each pad.
PILL_SPOKE_W = 1.2
PILL_BAR_W = 5.0
PILL_PAD_R = 2.7 / 2.0
# The bar is the one piece of exposed power copper on this board, and a poured
# rectangle ends in four sharp corners. All four are convex, so KiCad's own
# corner smoothing rounds them with a true arc when it fills. 1 mm takes
# 0.86 mm2 in total off the ends of a 5 x 9.9 mm pour, none of it from the
# bar's width where the current runs or from either pad's reach.
PILL_BAR_R = 1.0


def _pill_pad(fps):
    """J24's +5V pad."""
    return next(p for p in fps["J24"].Pads() if p.GetNetname() == "+5V")


def _pill_bar_rects(fps):
    """-> [(x0, y0, x1, y1)] the bar, in board mm."""
    a = _pad_xy(fps["J3"], 1)
    pos = _pill_pad(fps).GetPosition()
    b = (ToMM(pos.x) - ORIGIN[0], ToMM(pos.y) - ORIGIN[1])
    x = (a[0] + b[0]) / 2.0
    y0, y1 = sorted((a[1], b[1]))
    reach = PILL_PAD_R + 0.6
    return [(x - PILL_BAR_W / 2, y0 - reach, x + PILL_BAR_W / 2, y1 + reach)]


def _pill_power_bar(board, fps, net):
    """Pour the +5V bar joining J3 pin 1 and J24's +5V pad on F.Cu and B.Cu."""
    (x0, y0, x1, y1), = _pill_bar_rects(fps)
    zones = []
    for layer in (pcbnew.F_Cu, pcbnew.B_Cu):
        z = pcbnew.ZONE(board)
        z.SetLayer(layer)
        z.SetNet(net)
        z.SetAssignedPriority(1)
        z.SetLocalClearance(FromMM(CLEARANCE))
        z.SetMinThickness(FromMM(0.2))
        z.SetPadConnection(pcbnew.ZONE_CONNECTION_THERMAL)
        z.SetThermalReliefGap(FromMM(0.3))
        z.SetThermalReliefSpokeWidth(FromMM(PILL_SPOKE_W))
        z.SetCornerSmoothingType(2)             # fillet, not chamfer
        z.SetCornerRadius(FromMM(PILL_BAR_R))
        o = z.Outline()
        o.NewOutline()
        if layer == pcbnew.B_Cu:
            # Explicit boundary survives a touching same-net overlay; KiCad's
            # zone-corner smoothing otherwise squares the bar at that union.
            z.SetCornerSmoothingType(0)
            z.SetCornerRadius(0)
            points = []
            for cx, cy, start in ((x1-PILL_BAR_R, y0+PILL_BAR_R, -90),
                                  (x1-PILL_BAR_R, y1-PILL_BAR_R, 0),
                                  (x0+PILL_BAR_R, y1-PILL_BAR_R, 90),
                                  (x0+PILL_BAR_R, y0+PILL_BAR_R, 180)):
                for i in range(13):
                    angle = math.radians(start + 90*i/12)
                    points.append((cx + PILL_BAR_R*math.cos(angle),
                                   cy + PILL_BAR_R*math.sin(angle)))
        else:
            points = ((x0, y0), (x1, y0), (x1, y1), (x0, y1))
        for px, py in points:
            o.Append(P(px, py).x, P(px, py).y)
        z.SetIsFilled(False)
        board.Add(z)
        zones.append(z)
    return zones


# Where the ring supply crosses back out over the busbar's west edge, the
# rounded corner and the supply's own edge meet at a shallow angle and leave a
# wedge of clearance pointing into the join - 39 degrees of it on the back.
# This is the fillet that takes it out. It has to be copper of its own: a
# union of tracks and a poured rectangle is bounded by convex arcs and
# straight lines only, so nothing about the two shapes can round a concave
# corner between them.
PILL_BLEND_R = 0.3
PILL_BLEND_OVERLAP = 0.2


def _pill_blend_outline(fps):
    """-> the blend polygon, or None when the supply clears the corner."""
    (x0, _y0, _x1, y1), = _pill_bar_rects(fps)
    edge = (console_ring_power.BACK_PATH[1][0] - ORIGIN[0]
            + console_ring_power.WIDTH / 2.0)
    if not x0 < edge < x0 + PILL_BAR_R:
        return None                     # nothing to blend: no shallow crossing
    r, R = PILL_BLEND_R, PILL_BAR_R
    cx, cy = x0 + R, y1 - R             # centre of the busbar's corner arc
    centre = (edge + r, cy + math.sqrt((R + r) ** 2 - (edge + r - cx) ** 2))
    scale = R / (R + r)
    touch = (cx + (centre[0] - cx) * scale, cy + (centre[1] - cy) * scale)
    inside = (cx, cy)  # bury closure through the rounded bar centre
    back = edge - PILL_BLEND_OVERLAP
    return (_blend_arc(centre, (edge, centre[1]), touch)
            + [inside, (back, inside[1]),
               (back, centre[1] + PILL_BLEND_OVERLAP),
               (edge, centre[1] + PILL_BLEND_OVERLAP)])


def _blend_arc(centre, frm, to, steps=12):
    radius = math.dist(centre, frm)
    first = math.atan2(frm[1] - centre[1], frm[0] - centre[0])
    last = math.atan2(to[1] - centre[1], to[0] - centre[0])
    if last - first > math.pi:
        last -= math.tau
    if first - last > math.pi:
        last += math.tau
    return [(centre[0] + radius * math.cos(first + (last - first) * i / steps),
             centre[1] + radius * math.sin(first + (last - first) * i / steps))
            for i in range(steps + 1)]


def _pill_bar_blend(board, fps, net):
    """Pour that fillet on the back, where the supply runs."""
    shape = _pill_blend_outline(fps)
    if shape is None:
        return None
    z = pcbnew.ZONE(board)
    z.SetLayer(pcbnew.B_Cu)
    z.SetNet(net)
    z.SetZoneName("POWER_FILLET")
    z.SetAssignedPriority(2)
    z.SetLocalClearance(FromMM(CLEARANCE))
    z.SetMinThickness(FromMM(0.05))
    z.SetIslandRemovalMode(pcbnew.ISLAND_REMOVAL_MODE_ALWAYS)
    z.SetLocked(True)
    o = z.Outline()
    o.NewOutline()
    for px, py in shape:
        o.Append(P(px, py).x, P(px, py).y)
    z.SetIsFilled(False)
    board.Add(z)
    return z


def _ref_key(ref):
    """J2 before J10, so the placement order does not depend on string sorting."""
    head = ref.rstrip("0123456789")
    return (head, int(ref[len(head):] or 0))


def _silk_items(board, fps):
    """-> [(item, text, (x0, y0, x1, y1))] for everything on the front silkscreen.

    Board drawings AND every footprint's own reference and value. The gate used to
    read GetDrawings() alone, which is the 21 labels this file draws and none of the
    58 designators the library footprints bring with them -- so "J1" sat across R3
    with every check green.
    """
    out = []
    items = [t for t in board.GetDrawings() if t.GetClass() == "PCB_TEXT"]
    for fp in fps.values():
        items += [fp.Reference(), fp.Value()]
    for t in items:
        if not t.IsOnLayer(pcbnew.F_SilkS) or not t.IsVisible():
            continue
        b = t.GetBoundingBox()
        out.append((t, t.GetText(),
                    (ToMM(b.GetLeft()) - ORIGIN[0], ToMM(b.GetTop()) - ORIGIN[1],
                     ToMM(b.GetRight()) - ORIGIN[0], ToMM(b.GetBottom()) - ORIGIN[1])))
    return out


# Where the FRONT mark goes now that J3 and J24 have taken its old corner (#1062,
# owner call). The open patch under the PWR BTN header: C31's body to the left,
# the PI PWR label to the right, J8's designator above. It is 9.8 x 9.1
# against the mark's 9.0 x 9.4, so the mark lands at ~96% of its drawn size --
# the corner below J24 it tried first only held it at 58%. The art is still
# scaled to fit the box rather than to a guessed size. The BACK mark is separate.
FRONT_ART_BOX = (10.6, 14.4, 20.4, 23.5)


def _fit_front_art(polys):
    """-> the same polygons, scaled about their own centre into FRONT_ART_BOX."""
    xs = [p[0] for outer, _h in polys for p in outer]
    ys = [p[1] for outer, _h in polys for p in outer]
    x0, y0, x1, y1 = min(xs), min(ys), max(xs), max(ys)
    bx0, by0, bx1, by1 = FRONT_ART_BOX
    k = min((bx1 - bx0) / (x1 - x0), (by1 - by0) / (y1 - y0))
    dx = (bx0 + bx1) / 2.0 - k * (x0 + x1) / 2.0
    dy = (by0 + by1) / 2.0 - k * (y0 + y1) / 2.0
    move = lambda pts: [(k * x + dx, k * y + dy) for x, y in pts]
    return [(move(outer), [move(h) for h in holes]) for outer, holes in polys]


def _silk_art(board):
    """The segno mark (Bravura, SMuFL U+E047) and JetBrains Mono legends as
    FILLED silkscreen polygons, front and back. The outlines live in
    silk_art.py (generated from the fonts -- see its docstring); this only
    turns them into PCB_SHAPE polys. The two art strips were chosen from a
    pad+silk occupancy scan of the finished board (>=1 mm clear of every pad
    on their own side), so they add no DRC noise. BACK_ART is mirrored about
    the board's x centre so it reads correctly looking AT the back."""
    from silk_art import FRONT_ART, BACK_ART

    def emit(polys, layer, mirror=False):
        for outer, holes in polys:
            sps = pcbnew.SHAPE_POLY_SET()
            def chain(pts):
                c = pcbnew.SHAPE_LINE_CHAIN()
                for x, y in pts:
                    xx = BW - x if mirror else x
                    c.Append(FromMM(ORIGIN[0] + xx), FromMM(ORIGIN[1] + y))
                c.SetClosed(True)
                return c
            oi = sps.AddOutline(chain(outer))
            for h in holes:
                sps.AddHole(chain(h), oi)
            sps.Fracture()
            sh = pcbnew.PCB_SHAPE(board)
            sh.SetShape(pcbnew.SHAPE_T_POLY)
            sh.SetPolyShape(sps)
            sh.SetFilled(True)
            sh.SetWidth(0)
            sh.SetLayer(layer)
            board.Add(sh)

    emit(_fit_front_art(FRONT_ART), pcbnew.F_SilkS)
    emit(BACK_ART, pcbnew.B_SilkS, mirror=True)


def _silk(board, text, x, y, h=1.2):
    t = pcbnew.PCB_TEXT(board)
    t.SetText(text)
    t.SetPosition(P(x, y))
    t.SetLayer(pcbnew.F_SilkS)
    t.SetTextSize(pcbnew.VECTOR2I(FromMM(h), FromMM(h)))
    t.SetTextThickness(FromMM(h * SILK_STROKE_RATIO))
    board.Add(t)
    return t


def _text_box(t):
    """(x0, y0, x1, y1) of a text item as RENDERED, in board-local mm.

    Character-count estimates are close enough to place by and not to check by:
    they put every footswitch label within 0.07 mm of its own designator, which
    reads as a comfortable gap here and as 14 silk_overlap errors in KiCad.
    """
    b = t.GetBoundingBox()
    return (ToMM(b.GetLeft()) - ORIGIN[0], ToMM(b.GetTop()) - ORIGIN[1],
            ToMM(b.GetRight()) - ORIGIN[0], ToMM(b.GetBottom()) - ORIGIN[1])


_CY = {}          # (lib, name) -> (w, h) of the UNROTATED courtyard, measured once
_SIZE = {}        # ref -> (w, h) after this instance's rotation


def _courtyard_size(lib, name):
    """Courtyard w/h of a pristine, unrotated, unplaced copy.

    Measured from its own fresh load rather than from the placed instance,
    because the cached courtyard polygon is INCONSISTENT: it follows
    SetOrientationDegrees() for some footprints (the Pico) and not others (the
    2x20 IDC). Reading it once at rotation 0 and rotating by hand is the only
    version that gives the same answer every time.
    """
    key = (lib, name)
    if key not in _CY:
        b = pcbnew.BOARD()
        path = LOCAL_FP if lib == "segno" else os.path.join(KICAD_FP, lib + ".pretty")
        fp = pcbnew.FootprintLoad(path, name)
        w = h = 0.0
        if fp is not None:
            b.Add(fp)
            fp.SetPosition(pcbnew.VECTOR2I(0, 0))
            try:
                cb = fp.GetCourtyard(pcbnew.F_CrtYd).BBox()
                w, h = ToMM(cb.GetWidth()), ToMM(cb.GetHeight())
            except Exception:
                pass
        _CY[key] = (w, h)
    return _CY[key]


def _extent(fp):
    """(x0, y0, x1, y1) in board-local mm -- the footprint's real keep-out area.

    Three traps, each of which yields plausible numbers:
      * GetBoundingBox() includes the reference and value TEXT -- a 5 mm disc cap
        measures 26.7 x 6.7 that way, a 10 mm axial resistor 43.2 x 6.4.
      * The cached COURTYARD follows rotation for some footprints and not others.
      * PADS follow rotation reliably but are smaller than the courtyard, and DRC
        judges courtyards -- so a pads-only gate passes boards DRC then rejects.

    So: pads give the CENTRE (always rotation-correct), a pristine load gives the
    courtyard SIZE, and the rotation is applied here. Gate and DRC now agree.
    """
    xs, ys = [], []
    for pad in fp.Pads():
        pos, sz = pad.GetPosition(), pad.GetSize()
        xs += [ToMM(pos.x - sz.x // 2) - ORIGIN[0], ToMM(pos.x + sz.x // 2) - ORIGIN[0]]
        ys += [ToMM(pos.y - sz.y // 2) - ORIGIN[1], ToMM(pos.y + sz.y // 2) - ORIGIN[1]]
    if not xs:
        pos = fp.GetPosition()
        c = (ToMM(pos.x) - ORIGIN[0], ToMM(pos.y) - ORIGIN[1])
        return (c[0], c[1], c[0], c[1])
    cx, cy = (min(xs) + max(xs)) / 2.0, (min(ys) + max(ys)) / 2.0
    w, h = max(xs) - min(xs), max(ys) - min(ys)
    cw, ch = _SIZE.get(fp.GetReference(), (0.0, 0.0))
    return (cx - max(w, cw) / 2.0, cy - max(h, ch) / 2.0,
            cx + max(w, cw) / 2.0, cy + max(h, ch) / 2.0)


def _centre(fp):
    x0, y0, x1, y1 = _extent(fp)
    return ((x0 + x1) / 2.0, (y0 + y1) / 2.0)


def _bbox_mm(fp):
    x0, y0, x1, y1 = _extent(fp)
    return (x0 - KEEPOUT, y0 - KEEPOUT, x1 + KEEPOUT, y1 + KEEPOUT)


def _fp_size_mm(fp):
    x0, y0, x1, y1 = _extent(fp)
    return (x1 - x0, y1 - y0)


def _best_anchor(ref, net_of, fps, nets):
    """Where a passive wants to be: on the pads of its most SPECIFIC net.

    Counting shared nets and taking the winner does not work -- GND, +3V3 and +5V
    touch nearly every part, so every passive ties on the rails and the tie breaks
    alphabetically, which is how R7 (the CTRL reference divider) ended up 80 mm from
    the two jacks it serves. A 2-pad signal net says far more about where a part
    belongs than a 40-pad rail, so nets are scored by 1/len and the anchor is the
    CENTROID OF THE PADS of the best one, not the centre of some whole footprint.
    """
    mine = net_of.get(ref, set()) - POURED_NETS
    best, best_score, pool = None, 0.0, []
    for name in sorted(mine):
        nodes = nets.get(name, ())
        placed = [(r, pd) for r, pd in nodes if r in fps]
        if not placed:
            continue
        score = 1.0 / len(nodes)
        if score < best_score - 1e-9:
            continue
        pts = []
        for r, pd in placed:
            for pad in fps[r].Pads():
                if pad.GetNumber() == str(pd):
                    pts.append((ToMM(pad.GetPosition().x) - ORIGIN[0],
                                ToMM(pad.GetPosition().y) - ORIGIN[1]))
        if not pts:
            continue
        # A series part (R1: U1 -> ring header) belongs BETWEEN its neighbours, so
        # equally-specific nets are pooled rather than decided alphabetically --
        # picking one put R1 hard against U1 and 51 mm from the J6 it feeds.
        if score > best_score + 1e-9:
            best_score, pool = score, []
        pool.append((sum(x for x, _ in pts) / len(pts),
                     sum(y for _, y in pts) / len(pts)))
        best = (sum(x for x, _ in pool) / len(pool),
                sum(y for _, y in pool) / len(pool))
    if best is None:                       # rails-only part (bulk caps): fall back
        for other, fp in sorted(fps.items()):
            if net_of.get(ref, set()) & net_of.get(other, set()):
                return _centre(fp)
        return (BW / 2.0, BH / 2.0)
    return best


# How far a passive may be pushed from its anchor before the placement is simply
# wrong. Unbounded, the spiral walks until it finds ANY hole: two footswitch
# debounce caps ended up 40 mm away on the far side of the Pi ribbon, which no gate
# caught because each was still within a hop of its own net. Failing loudly here is
# the point -- it means "make room", not "put it anywhere".
MAX_SLOT_R = 28.0


def _free_slot(anchor, w, h, boxes):
    """Nearest free position to `anchor`, searched as an outward square spiral."""
    ax, ay = anchor
    for radius in range(1, int(MAX_SLOT_R / GRID) + 1):
        cands = []
        for i in range(-radius, radius + 1):
            cands += [(ax + i * GRID, ay - radius * GRID),
                      (ax + i * GRID, ay + radius * GRID),
                      (ax - radius * GRID, ay + i * GRID),
                      (ax + radius * GRID, ay + i * GRID)]
        cands.sort(key=lambda c: (c[0] - ax) ** 2 + (c[1] - ay) ** 2)
        for cx, cy in cands:
            x0, y0 = cx - w / 2 - KEEPOUT, cy - h / 2 - KEEPOUT
            x1, y1 = cx + w / 2 + KEEPOUT, cy + h / 2 + KEEPOUT
            if x0 < 1.0 or y0 < 1.0 or x1 > BW - 1.0 or y1 > BH - 1.0:
                continue
            if any(not (x1 <= b[0] or b[2] <= x0 or y1 <= b[1] or b[3] <= y0) for b in boxes):
                continue
            return (cx, cy)
    return None


# ---- gates -----------------------------------------------------------------

# The ratsnest budget. Sum, over every routed net, of the minimum spanning tree
# through its pads -- i.e. the shortest total copper that could possibly connect
# the board as placed. It is the one number that says whether a floorplan is
# efficient or merely tidy, and it is why the pin map and this table have to move
# together. GND is excluded: it is a pour, not a net of tracks.
#
# Measured 1607 mm on the layout below (with the review-fix resistors
# R14..R18; it was 1458 before them). For scale, the same floorplan measured
# 1573 mm at 115x96 and the first one 2495 mm on 160x100 -- shrinking the
# outline SHORTENED the copper, because every fan-out got shorter.
#
# It is NOT the minimum achievable: packing the five rear-panel headers together in
# the panel's own order costs about 180 mm, most of it PWR_BTN, because POWER is
# leftmost on the panel while the Pi ribbon it lands on is at the right edge. That
# is a trade taken deliberately. The whole rear loom is then one flat bundle
# leaving one edge in one order, which is worth more on a hand-wired console than
# 180 mm of copper carrying a button press. Do not "optimise" it back.
#
# The budget is the measurement plus ~10%,
# so a placement that drifts back toward "connectors in neat rows regardless of
# which pad they serve" fails here rather than at the autorouter.
#
# Most of the growth from the five review-fix resistors is the two link series
# parts: the link's 25 mm diagonal crosses U1, so R17/R18 cannot sit on it and
# their legs detour around the package -- ~85 mm of minimum copper that is the
# price of bounding cross-domain current, not placement waste.
#
# ~500 mm of that total is the ten SW_* nets, and it is NOT a defect to be
# optimised away. The module's footswitch pads span 28 mm; ten 8.5 mm JSTs cannot
# span less than 84 mm side by side, so the fan-out is geometric. Staggering them
# into two rows would buy ~150 mm and cost the one property that matters on a
# hand-wired board: pedal 1..10 reading left to right, unambiguously, at the bench.
# These are debounced switch lines -- 60 mm of trace is electrically free. Keep the
# straight ordered row.
#
# v3 measured 1915 mm. The ~210 mm over v2 is the four CTRL sense nets (ring and
# presence, J20_REF/J21_REF/J20_RN/J21_RN and their GPIO ends): their series
# parts sit under the module, 50-60 mm from the jacks they serve, because the
# column beside U2 that would have put them under the jacks is the expansion
# header's. They are DC lines through 4.7k -- SLOW_SENSE_NETS, exempt from the
# hop gate for the same reason -- so that copper is a decision, not waste. The
# budget follows the measurement plus ~7%.
# J9 now exits beside the ribbon, as requested for the Pi harness. Its two
# floating button traces add ~128 mm of minimum copper compared with the
# former position beside the Pico. Preserve the existing routing headroom.
# v3.2 (#1391) measures 2116 mm: the footswitch protection parts sit on the back
# directly between each debounce cap and its header, so they add only the short
# cable-side nets and the clamps' hops across their column pairs.
MAX_RATSNEST_MM = 2180.0
POURED_NETS = {"GND"}

# The ratsnest total is a GLOBAL number, and --selftest proved it cannot see a
# single connector moving to the wrong end of the board: shifting J6 back across
# the module cost ~100 mm, which any sane budget absorbs. So there is a second,
# LOCAL gate. Every pad on a signal net must be within MAX_HOP_MM of the nearest
# other pad on that net -- i.e. no part is stranded away from what it wires to.
#
# Measured worst hops on the layout below: 40.7 mm (SW_BANK) and 34.7 mm
# (SW_CLEAR), both the geometric footswitch fan-out. 42 mm is NOT that plus 10%
# any more -- it is 3% over the worst case, because the 100 mm outline pins the
# module's x (see J1) and SW_BANK pays for it. The limit stays where it is rather
# than being relaxed to fit: a fan-out that grows past it is a real problem, and
# the next mm has to come from the floorplan. Rails are exempt: +5V and +3V3 touch
# parts at both ends of the board by definition, and are carried by wide traces
# and the pour.
MAX_HOP_MM = 42.0
RAIL_NETS = {"+3V3", "+5V", "+3V3_PICO"}
# The CTRL ring-sense nets are exempt too, by decision: a ring is 3V3 through 1k
# that a footswitch pulls to ground, read through 4.7k into a GPIO's pull-up --
# DC, and slow even by footswitch standards -- so the trace can be as long as
# the board. That bought back the column beside U2 for the expansion header,
# whose position the bench preferred, and put R19/R20 in the row R13 and R15
# left empty under the module.
# The pill data line (#1062): the buffer U1 sits at the board's right, and the pill
# connector at its left edge beside the 5 V inlet, so R2 -> J24 is ~75 mm. One
# 800 kHz WS2812 line driven through R2 at the buffer end is fine at that length;
# keeping the pills' power and data on ONE connector is the point of the placement.
LONG_DATA_NETS = {"IND_DATA_OUT"}
SLOW_SENSE_NETS = {"J20_REF", "J21_REF", "CTRL1_RING", "CTRL2_RING",
                   "J20_RN", "J21_RN", "CTRL1_PRESENT", "CTRL2_PRESENT",
                   # Passive, floating button pair between the rear-panel
                   # connector and the Pi harness exit beside the ribbon.
                   "PWR_BTN", "PWR_BTN_RET"}


def worst_hops(fps, nets):
    """-> [(distance_mm, net, ref, pad)] worst first, signal nets only."""
    pads = {}
    for ref, fp in fps.items():
        for pad in fp.Pads():
            pads[(ref, pad.GetNumber())] = (ToMM(pad.GetPosition().x),
                                            ToMM(pad.GetPosition().y))
    out = []
    for name, nodes in nets.items():
        if (name in POURED_NETS or name in RAIL_NETS or name in SLOW_SENSE_NETS
                or name in LONG_DATA_NETS):
            continue
        # Nets landing on J2 are exempt -- the WHOLE net, both ends; this
        # `continue` checks nothing about them. J2's position is not a routing
        # choice: a 40-way ribbon has to exit at a board edge, and no edge is
        # within 42 mm of the module wherever it sits. Every signal on it is slow
        # (MIDI is 31.25 kbaud, the link a UART, SWD a flashing port), so trace
        # length is not the binding constraint; where the cable
        # goes is. The cost, named honestly: parts whose nets are all either
        # rails or J2-landing (R14 is one) have NO distance gate at all -- their
        # placement comments carry the arithmetic instead.
        if any(r == "J2" for r, _p in nodes):
            continue
        here = {n: pads[n] for n in nodes if n in pads}
        if len(here) < 2:
            continue
        for node, pt in here.items():
            d = min(math.dist(pt, q) for m, q in here.items() if m != node)
            out.append((d, name, node[0], node[1]))
    out.sort(reverse=True)
    return out


def ratsnest_mm(fps, nets, per_net=False):
    """Total MST length over all routed nets, in mm."""
    pads = {}
    for ref, fp in fps.items():
        for pad in fp.Pads():
            pads.setdefault((ref, pad.GetNumber()), (ToMM(pad.GetPosition().x),
                                                     ToMM(pad.GetPosition().y)))
    out, total = {}, 0.0
    for name, nodes in nets.items():
        if name in POURED_NETS:
            continue
        pts = [pads[n] for n in nodes if n in pads]
        if len(pts) < 2:
            continue
        # Prim's, O(n^2) -- the biggest net here has 8 pads.
        reached, rest, length = [pts[0]], list(pts[1:]), 0.0
        while rest:
            d, i, j = min((math.dist(a, b), bi, ai)
                          for ai, a in enumerate(reached)
                          for bi, b in enumerate(rest))
            length += d
            reached.append(rest.pop(i))
        out[name] = length
        total += length
    return (total, out) if per_net else total


_QUIET = False


def _check_place(fps):
    """The pure-geometry placement gates: on the board, and not on each other.

    A function of its own so build() can run it the moment placement finishes --
    BEFORE _outline()/_labels() -- and a displaced part fails with its true
    identity instead of as the label-placement symptom it causes downstream.
    _check() runs it again; the asserts are idempotent and the double cost is nil.
    """
    # every placed footprint is inside the outline, with room for the edge
    for ref, fp in fps.items():
        x0, y0, x1, y1 = _extent(fp)
        assert 0.5 <= x0 and x1 <= BW - 0.5 and 0.5 <= y0 and y1 <= BH - 0.5, (
            f"PLACE: {ref} spans ({x0:.1f},{y0:.1f})..({x1:.1f},{y1:.1f}), outside "
            f"the {BW:.1f}x{BH:.1f} outline")

    # footprints must not overlap each other. A surface-mount part on the back
    # shares no space with a part on the front -- only with the front part's
    # through-hole pads, whose barrels and solder fillets come through.
    refs = sorted(fps)
    for i, a in enumerate(refs):
        for b in refs[i + 1:]:
            ax0, ay0, ax1, ay1 = _extent(fps[a])
            bx0, by0, bx1, by1 = _extent(fps[b])
            if _on_back(fps[a]) != _on_back(fps[b]):
                back, front = (a, b) if _on_back(fps[a]) else (b, a)
                x0, y0, x1, y1 = _extent(fps[back])
                for px0, py0, px1, py1 in _tht_pad_boxes(fps[front]):
                    if not (x1 <= px0 or px1 <= x0 or y1 <= py0 or py1 <= y0):
                        raise AssertionError(
                            f"PLACE: {back} on the back sits on a through-hole pad "
                            f"of {front} -- the pad's barrel and fillet come through")
                continue
            if not (ax1 <= bx0 or bx1 <= ax0 or ay1 <= by0 or by1 <= ay0):
                raise AssertionError(
                    f"PLACE: {a} and {b} overlap -- footprints cannot share copper area")


def _check(fps, nets, board=None):
    """Prove the layout is sane BEFORE any copper is drawn.

    The load-bearing one is CROSSING: this board has no autorouter, and routing is
    only trivial because every fan-out preserves left-to-right order. If an
    ordering ever breaks, two tracks cross on one layer and the board is quietly
    wrong -- so it is checked, not assumed.
    """
    # Placement geometry first -- via _check_place, which build() also runs the
    # moment placement finishes, BEFORE the silk stage. A displaced part must
    # fail as the placement error it is: _labels() runs early and its own
    # "nowhere to print" assert used to fire first, so a bad coordinate reported
    # as a silkscreen symptom and a selftest control once proved the wrong gate.
    _check_place(fps)

    # the footswitch fan-out must preserve order, or its tracks cross. Pin 1 is
    # on the cable side of the input's series resistor (#1391), so the Pico pad
    # it serves is found through that resistor.
    order = []
    for i in range(10):
        ref = "J%d" % (10 + i)
        pad = _pad_xy(fps[ref], "1")
        sig = [n for n, nodes in nets.items() if (ref, "1") in nodes]
        assert len(sig) == 1, f"CROSSING: {ref} pin 1 is on {sig}, expected exactly one net"
        series = [r for r, _p in nets[sig[0]] if r.startswith("R")]
        if series:
            sig = [n for n, nodes in nets.items() if n != sig[0]
                   and any(r == series[0] for r, _p in nodes)]
        pico_pad = [p for r, p in nets[sig[0]] if r == "J1"]
        assert len(pico_pad) == 1, f"CROSSING: {sig[0]} does not land on exactly one Pico pad"
        order.append((pad[0], _pad_xy(fps["J1"], pico_pad[0])[0], ref, sig[0]))
    order.sort()
    xs = [o[1] for o in order]
    assert xs == sorted(xs), (
        "CROSSING: the footswitch JSTs are not in the same left-to-right order as "
        "the Pico pads they serve, so their fan-out tracks cross on one layer. "
        "Order seen: " + ", ".join("%s->%.1f" % (o[2], o[1]) for o in order))

    # the opto's DIN side must be isolated: no other footprint within ISOLATION_GAP
    ux0, uy0, ux1, uy1 = _extent(fps["U2"])
    # Only parts that actually SHARE A NET with the opto or its jack belong inside
    # the barrier. Exempting every ref beginning R/C/D -- as this did -- waved
    # through every resistor and capacitor on the board, so the gate could not fail
    # for the most likely mistake there is: parking an unrelated passive in the moat.
    # The barrier is the DIN SIDE specifically: U2 pins 1 and 2, and J5. Not every
    # net U2 touches -- its pins 5 and 6 are GND and +3V3, i.e. the whole board, so
    # keying off "shares a net with U2" exempts everything and the gate dies.
    din_side = {("U2", "1"), ("U2", "2")}
    inside = {"U2", "J5"}
    for n, nodes in nets.items():
        if n in POURED_NETS or n in RAIL_NETS:
            continue
        if any(nd in din_side or nd[0] == "J5" for nd in nodes):
            inside.update(r for r, _p in nodes)
    for ref, fp in fps.items():
        if ref in inside:
            continue
        x0, y0, x1, y1 = _extent(fp)
        dx = max(ux0 - x1, x0 - ux1, 0.0)
        dy = max(uy0 - y1, y0 - uy1, 0.0)
        d = (dx * dx + dy * dy) ** 0.5
        assert d >= ISOLATION_GAP, (
            f"ISOLATION: {ref} is {d:.2f} mm from the opto U2, under the "
            f"{ISOLATION_GAP} mm barrier -- MIDI IN's isolation is the whole point of U2")
    # the placement must actually be efficient, not just legal
    total, per = ratsnest_mm(fps, nets, per_net=True)
    worst = sorted(per.items(), key=lambda kv: -kv[1])[:3]
    if not _QUIET:
        print("\n  ratsnest %.0f mm on %.1fx%.1f (%.0f cm2), budget %.0f mm ... "
              % (total, BW, BH, BW * BH / 100.0, MAX_RATSNEST_MM), end="")
    silk = _silk_items(board, fps) if board else []
    # ...and it has to be PRINTABLE, which is a fab limit, not a KiCad one. KiCad's
    # own minimum stroke is 0.08 mm, so its DRC passed a board whose 58 designators
    # were all stroked at 0.133 mm -- under JLCPCB's 0.15 mm floor, where lines thin,
    # break, or are dropped and you find out when the boards arrive.
    for item, text, _box in silk:
        stroke, height = ToMM(item.GetTextThickness()), ToMM(item.GetTextHeight())
        assert stroke >= FAB_MIN_SILK_STROKE - 1e-9, (
            f"SILK_FAB: '{text}' is stroked at {stroke:.3f} mm, under the "
            f"{FAB_MIN_SILK_STROKE} mm the fab can print -- it will come out thin, "
            "broken, or not at all")
        assert height >= FAB_MIN_SILK_HEIGHT - 1e-9, (
            f"SILK_FAB: '{text}' is {height:.3f} mm tall, under the "
            f"{FAB_MIN_SILK_HEIGHT} mm the fab can print")
    for item, text, (x0, y0, x1, y1) in silk:
        for ref, fp in fps.items():
            if _on_back(fp):
                continue           # front ink cannot land on a part under the board
            fx0, fy0, fx1, fy1 = _extent(fp)
            if not (x1 < fx0 or fx1 < x0 or y1 < fy0 or fy1 < y0):
                raise AssertionError(
                    f"SILK: '{text}' is printed across {ref} -- silkscreen "
                    "over a pad or a body is unreadable and can foul the solder mask")
        assert 0 <= x0 and x1 <= BW and 0 <= y0 and y1 <= BH, (
            f"SILK: '{text}' spans ({x0:.1f},{y0:.1f})..({x1:.1f},{y1:.1f}), "
            f"off the {BW:.0f}x{BH:.0f} outline -- it will not be printed")
    # ...and not over each other either, which is a rule KiCad has and this did not:
    # the function label and the designator of all ten footswitches were printed one
    # on top of the other, 0.07 mm apart, and only DRC ever said so.
    for i, (_ia, ta, (ax0, ay0, ax1, ay1)) in enumerate(silk):
        for _ib, tb, (bx0, by0, bx1, by1) in silk[i + 1:]:
            if not (ax1 < bx0 or bx1 < ax0 or ay1 < by0 or by1 < ay0):
                raise AssertionError(
                    f"SILK: '{ta}' and '{tb}' are printed on top of each other -- "
                    "neither can be read at the bench")

    if board:
        _back = _back_silk_problems(board, fps)
        assert not _back, _back[0]
        _legend = _pin_legend_problems(board)
        assert not _legend, _legend[0]

    xs = [(_extent(fps[r])[0] + _extent(fps[r])[2]) / 2.0
          for r in REAR_PANEL_ORDER if r in fps]
    assert xs == sorted(xs), (
        "REAR_ORDER: the rear-panel headers are not in the panel's own left-to-right "
        f"order {REAR_PANEL_ORDER} (they sit at {[round(x, 1) for x in xs]}) -- the "
        "loom would have to cross itself between the board and the panel")
    ys = [(_extent(fps[r])[1] + _extent(fps[r])[3]) / 2.0
          for r in REAR_PANEL_ORDER if r in fps]
    assert max(ys) - min(ys) < 2.0, (
        "REAR_ORDER: the rear-panel headers are not on one edge -- the whole point "
        "is that this loom leaves the board once, from one place")

    # A solid pad tie is defensible on an all-through-hole board and wrong the
    # moment anything is surface-mount: an SMD pad tied straight into a plane wicks
    # the iron's heat away and cold-joints. That transition is exactly what happened
    # here and nothing caught it, so it is checked rather than remembered.
    # Every part on this board is hand-soldered, through-hole since the Pico was
    # socketed (#1062), and a pad tied solid into a pour wicks the iron's heat
    # away whether it is SMD or THT. The gate used to run only when an SMD pad
    # existed; with none left that made it vacuous, which is worse than strict.
    if board:
        for z in board.Zones():
            assert z.GetPadConnection() != pcbnew.ZONE_CONNECTION_FULL, (
                f"THERMALS: the {z.GetNetname()} pour ties pads solid -- a pad "
                "with no thermal relief pulls the iron's heat into the plane and "
                "cold-joints, and every part here is soldered by hand")

    # USB_CLEAR is gone (owner call, #1062). It kept the strip in front of the
    # module's USB end empty so a cable could always be plugged in; J3 and J24
    # now sit in it. What paid for that is the socket: the module lifts out of
    # its pin sockets, and its USB is reachable in the hand. A gate that forbids
    # the placement the owner asked for is not a gate, and one kept "just in
    # case" while the layout violates it is worse -- so it goes, and the reason
    # lives here.

    # PILL_POWER (#1062): the pills' 4.8 A must go J3 -> J24 over the poured bar
    # and nowhere else. Both are JST VH, facing the same way, their +5V pads face
    # each other within reach of one bar, J24 is the pills' only connector (5V,
    # data, GND), and (with a board) the bar exists on both copper layers. A J24
    # drifting away from J3 would quietly put the pills' current back on a track.
    for ref in ("J3", "J24"):
        name = fps[ref].GetFPIDAsString()
        assert "JST_VH" in name, f"PILL_POWER: {ref} is {name}, not a JST VH header"
        paths = [m.m_Filename for m in fps[ref].Models()]
        assert paths and all("segno.pretty/JST_VH_" in x for x in paths), (
            f"PILL_POWER: {ref}'s 3D model is {paths} -- KiCad ships none for VH, "
            "so it has to point at the segno.pretty model vh_models.py draws")
    j24 = {n for n, nodes in nets.items() for r, _p in nodes if r == "J24"}
    assert j24 == {"+5V", "IND_DATA_OUT", "GND"}, (
        f"PILL_POWER: J24 carries {sorted(j24)}, not the pills' 5V, data and GND")
    others = sorted(r for r, _p in nets.get("IND_DATA_OUT", [])
                    if r.startswith("J") and r != "J24")
    assert not others, f"PILL_POWER: pill data also leaves on {others} -- one pill connector"
    a = _pad_xy(fps["J3"], 1)
    b = _pad_xy(fps["J24"], next(p.GetNumber() for p in fps["J24"].Pads()
                                 if any(r == "J24" and str(pad) == p.GetNumber()
                                        for r, pad in nets["+5V"])))
    gap = abs(a[1] - b[1])
    assert abs(a[0] - b[0]) < 1.0 and gap < 8.0, (
        f"PILL_POWER: J3 pin 1 {a} and J24's +5V pad {b} are not face to face "
        "-- the bar between them has to stay short")
    ra = fps["J3"].GetOrientationDegrees() % 360
    rb = fps["J24"].GetOrientationDegrees() % 360
    assert abs(ra - rb) < 1.0, (
        f"PILL_POWER: J3 is at {ra:.0f} deg and J24 at {rb:.0f} -- their latch walls "
        "face opposite ways, so one housing latches toward the board and one away")
    if board:
        bars = {z.GetLayer() for z in board.Zones() if z.GetNetname() == "+5V"}
        assert bars == {pcbnew.F_Cu, pcbnew.B_Cu}, (
            f"PILL_POWER: the +5V bar is on {bars}, not both copper layers")

    hops = worst_hops(fps, nets)
    if hops:
        d, name, ref, pad = hops[0]
        assert d <= MAX_HOP_MM, (
            f"HOP: {ref} pad {pad} is {d:.0f} mm from the nearest other pad on "
            f"{name} (limit {MAX_HOP_MM:.0f} mm) -- that part is placed away from "
            "what it wires to. Move it, or move the pin map.")
    assert total <= MAX_RATSNEST_MM, (
        f"RATSNEST: {total:.0f} mm of minimum copper, budget {MAX_RATSNEST_MM:.0f} mm. "
        f"The placement is wasting space -- longest nets: "
        + ", ".join(f"{n} {v:.0f}mm" for n, v in worst))

    if board:
        mask_problems = mask_clearance_problems(board)
        assert not mask_problems, "SILK_MASK: " + str(mask_problems[:3])
    return True


# ---- route -----------------------------------------------------------------

def _stitch_gnd(board, fps, nets, netmap, boxes):
    """Every GND pad gets a via into the pours -- BESIDE it, never on it.

    Never on it, for two different reasons depending on the pad:

    A plated through-hole pad already reaches both layers -- that is what the
    plating is -- so a via at its centre connects nothing and just puts a second
    drill hit on the same coordinate. That was all 102 holes_co_located: every one
    of them is a via sitting on a PTH pad centre, and CAM either holds the order or
    drills the spot twice and breaks bits.

    A via in the middle of a SURFACE-MOUNT pad wicks solder to the far side and
    starves the joint -- and on the Pico those pads sit UNDER the module, so the cold
    joint is invisible and unreachable. It also silently undoes the thermal relief:
    KiCad applies a zone's pad-connection setting to PADS only and always ties a via
    solid, so the nine GND pads the relief was added for would be tied solid through
    the via in their middle.

    Beside EVERY GND pad, though, including the through-hole ones -- which is not
    just belt and braces. The blind lattice cannot drop a via anywhere near a
    connector, so the pour around a dense header is exactly where it fragments, and
    the fill then deletes the fragment as an island: J6's two ground pins came back
    starved_thermal with their only spoke reaching copper that was about to vanish.
    A via one pad-width away ties that region to the other layer's plane, so it is
    not an island in the first place.
    """
    n = 0
    for ref, pad in sorted(nets.get(POUR_NET, [])):
        if ref not in fps:
            continue
        p = _pad(fps[ref], pad)
        if p is None:
            continue
        xy = _pad_xy(fps[ref], pad)
        bb = p.GetBoundingBox()
        reach = max(ToMM(bb.GetWidth()), ToMM(bb.GetHeight())) / 2.0 + VIA_KEEPOUT
        # INWARD first: toward the middle of the part the pad belongs to. A pad's
        # fan-out leaves the footprint outward, so a via on the outward side sits in
        # the one lane the net has -- SW_TRACK3 stopped routing at all when a Pico
        # ground via landed in the footswitch fan-out. Under the part's own body
        # nothing is trying to get past.
        fx0, fy0, fx1, fy1 = _extent(fps[ref])
        inward = ((fx0 + fx1) / 2.0 - xy[0], (fy0 + fy1) / 2.0 - xy[1])
        dirs = sorted(((0, -1), (0, 1), (1, 0), (-1, 0)),
                      key=lambda d: -(d[0] * inward[0] + d[1] * inward[1]))
        if ref == "C20":
            # Keep its stitch east of the capacitor, clear of the Pico rail.
            # Extra reach puts it strictly outside its own pad keepout.
            dirs = ((1, 0),)
            reach += 0.1
        spot = None
        for k in range(12):
            d = reach + k * 0.5
            for dx, dy in dirs:
                cand = (xy[0] + dx * d, xy[1] + dy * d)
                if _via_free(cand[0], cand[1], boxes):
                    spot = cand
                    break
            if spot:
                break
        if spot is None:
            raise SystemExit(
                f"STITCH: nowhere clear beside {ref} pad {pad} to land its GND via")
        _via(board, netmap[POUR_NET], spot[0], spot[1])
        # A stub from the pad to its via. The pour reaches the pad through thermal
        # spokes, but only where it actually fills; the stub is what makes the tie
        # unconditional, and it is on the pad's own layer so it never adds a
        # crossing.
        _track(board, netmap[POUR_NET], p.GetLayer(), TRACK_W, xy, spot)
        _claim_via(spot[0], spot[1], boxes)
        n += 1
    return n


# ---- build / export --------------------------------------------------------




# Function labels, the way the retired V1 board did it: every connector on that board
# says what it is (REC / STOP / TRK1 / RING / LEDS / MIDI OUT / 9V), because the
# thing that gets wired at the bench is a header, not a reference designator. Refs
# alone are useless with ten identical 2-pin JSTs in a row.
LABELS = {
    "J10": "REC",  "J11": "STOP", "J12": "UNDO", "J13": "MODE", "J14": "TRK1",
    "J15": "TRK2", "J16": "TRK3", "J17": "TRK4", "J18": "CLR",  "J19": "BANK",
    "J2":  "PI",     "J3":  "5V IN",    "J20": "CTRL 1", "J21": "CTRL 2",
    "J22": "EXP",    "J23": "PD",       "J4":  "MIDI OUT", "J5":  "MIDI IN",
    "J6":  "RING",   "J8":  "PWR BTN", "J9": "PI PWR",
    "J24": "PILLS", "J25": "SCREEN",
}
SILK_H = 1.0
REF_H = 1.0
REF_STROKE = 0.16
AUTOPLACE_REFS = True   # off = the designators stay where each library footprint
                        # left them, which is the board that shipped "J1" across R3
# Pinned label rows. A GROUP of labels reads as tidy only if it sits on one side at
# one y; left to the search below, the rear-panel row came out "above, right, above,
# right, right" and REC sat left of its header while its nine neighbours sat above.
# Each was individually legal and collectively a mess. The search stays as the
# fallback for the handful of one-off headers.
LABEL_ROW = dict(
    [(r, 3.0) for r in ("J8", "J5", "J4", "J20", "J21")]
    + [("J%d" % (10 + i), 79.3) for i in range(10)]   # follows FSW_Y up (#1062)
)
SILK_PAD = 0.5
# Pinned label CENTRES for connectors the four-sided search cannot serve. J3 sits
# at the left edge under the logo (#1062): above it is the art, to its right at
# its own height the Pico, to its left the edge. The corner pocket up and to the
# right of it is empty, but the search only tries the four sides. Still checked
# against everything already on the silk, so a bad coordinate fails as SILK.
# J24's label goes BESIDE the header's lower half rather than at its centre, so
# the strip under R21 stays free for R21's own designator.
# J3's and J24's labels were pinned when the two sat at the board's edge under
# the logo with nowhere for the four-sided search to go. Eight millimetres up,
# the search finds its own spots again, so they are back in its hands.
LABEL_AT = {"J22": (46.9, 31.855), "J9": (81.1, 64.1), "J25": (61.4, 64.1)}  # directly above its housing, clear of R18
# The same for designators. R11 is boxed in -- the module above, J3 left, R21
# below, R12 right -- and with J3 at the edge the search had only found a spot
# 19 mm away. The pocket above R11's left end, under the 5V IN label, is its own.
# Reviewed fixed reference positions; preserve them when text sizing changes.
REF_AT = {
    "C1": (8.0, 72.256199),
    "C2": (17.3333, 72.256199),
    "C3": (31.152652, 75.3),
    "C4": (96.866904, 75.3),
    "C5": (36.0, 72.256199),
    "C6": (49.819252, 75.3),
    "C7": (59.152652, 75.3),
    "C8": (68.485952, 75.3),
    "C9": (77.819285, 75.3),
    "C10": (87.152618, 75.3),
    "C11": (80.0, 27.9562),
    "C13": (55.899999, 24.0438),
    "C14": (61.133095, 21.0),
    "C20": (48.616904, 19.6),
    "C30": (6.7, 26.208698),
    "C31": (6.7, 15.053711),
    "D1": (40.595952, 14.4),
    "H1": (5.0, 9.996326),
    "H2": (94.5, 9.996326),
    "H3": (94.5, 89.503674),
    "H4": (5.0, 89.503674),
    "J1": (43.0, 32.9162),
    "J2": (89.5, 10.7262),
    "J3": (11.790714, 48.9),
    "J4": (50.0, 12.9188),
    "J5": (39.840714, 8.0),
    "J6": (60.840714, 69.0),
    "J8": (18.1, 12.9188),
    "J9": (73.75, 69.0),
    "J10": (8.0, 89.1188),
    "J11": (17.3333, 89.1188),
    "J12": (26.666699, 89.1188),
    "J13": (85.778333, 89.1188),
    "J14": (36.0, 89.1188),
    "J15": (45.333299, 89.1188),
    "J16": (54.6667, 89.1188),
    "J17": (64.0, 89.1188),
    "J18": (73.333299, 89.1188),
    "J19": (82.6667, 89.1188),
    "J20": (63.4, 12.9188),
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
}
# Per-pin legends for the two power headers, on the BACK silkscreen beside each pad.
# J3 is +5V/GND from pin 1 and J24 is GND/DATA/+5V, so the two headers read in
# opposite orders, and a harness crimped to the wrong one puts 5 V on the pill
# strip's GND. The FRONT has no room for them: J3's GND row is boxed in by its own
# label and R11's designator, and J24's +5V row by R21's courtyard, 0.08 mm from the
# header's. The back is clear from the pads to R11/R21's pads, and it is the side a
# harness is continuity-checked against anyway.
PIN_LEGEND_REFS = ("J3", "J24")
PIN_LEGEND_NAME = {"+5V": "+5V", "GND": "GND", "IND_DATA_OUT": "DATA"}
PIN_LEGEND_GAP = 0.6     # pad copper edge to the text's near edge, mm


def _labels(board, fps):
    """Put each label in the nearest free spot around its connector.

    Hand-tuned offsets do not survive: every time the floorplan moved, another
    label landed on a part, and the silk gate rejected the board. So the labels are
    placed the same way the passives are -- try the four sides at increasing
    distance, take the first gap that is actually empty.
    """
    taken = [_extent(fp) for fp in fps.values() if not _on_back(fp)]
    for t in board.GetDrawings():
        # Shapes as well as text: the silk art (the logo) is PCB_SHAPE polygons,
        # and a label searched past it landed on the glyphs the moment J3 moved
        # up under the logo (#1062). Text-only, the search could not see it.
        if t.GetClass() in ("PCB_TEXT", "PCB_SHAPE") and t.IsOnLayer(pcbnew.F_SilkS):
            bb = t.GetBoundingBox()
            taken.append((ToMM(bb.GetLeft()) - ORIGIN[0], ToMM(bb.GetTop()) - ORIGIN[1],
                          ToMM(bb.GetRight()) - ORIGIN[0], ToMM(bb.GetBottom()) - ORIGIN[1]))

    def free(x0, y0, x1, y1, gap=SILK_PAD):
        if x0 < 0.5 or y0 < 0.5 or x1 > BW - 0.5 or y1 > BH - 0.5:
            return False
        return all(x1 + gap < bx0 or bx1 + gap < x0 or
                   y1 + gap < by0 or by1 + gap < y0
                   for bx0, by0, bx1, by1 in taken)

    for ref in sorted(LABELS):
        if ref not in fps:
            continue
        text = LABELS[ref]
        # Drawn first, then measured, then moved. Its rendered width is the only
        # one worth searching with, and it is also what has to go into `taken`:
        # the pinned rows below skipped that entirely, so all ten footswitch
        # designators were later placed straight on top of their own labels.
        t = _silk(board, text, 0.0, 0.0, SILK_H)
        tx0, ty0, tx1, ty1 = _text_box(t)
        w, h = tx1 - tx0, ty1 - ty0
        px0, py0, px1, py1 = _extent(fps[ref])
        if ref in LABEL_ROW:
            spot = ((px0 + px1) / 2.0, LABEL_ROW[ref])
        elif ref in LABEL_AT:
            x, y = LABEL_AT[ref]
            assert free(x - w / 2, y - h / 2, x + w / 2, y + h / 2), (
                f"SILK: the pinned spot for '{text}' at {LABEL_AT[ref]} is not free")
            spot = (x, y)
        else:
            cx, cy = (px0 + px1) / 2.0, (py0 + py1) / 2.0
            spot = None
            for d in [i * 0.5 for i in range(2, 24)]:
                for x, y in ((cx, py0 - d), (cx, py1 + d), (px1 + d + w / 2, cy),
                             (px0 - d - w / 2, cy)):
                    if free(x - w / 2, y - h / 2, x + w / 2, y + h / 2):
                        spot = (x, y)
                        break
                if spot:
                    break
            assert spot, f"SILK: nowhere free to print '{text}' next to {ref}"
        t.SetPosition(P(*spot))
        taken.append(_text_box(t))

    # ...and the same treatment for the 58 reference designators, which the library
    # footprints drop wherever their author put them -- which is how "J1" came to be
    # printed across R3. They were invisible to every check here because the gate
    # walked board.GetDrawings() only, and a footprint's reference is not a drawing.
    for ref in sorted(fps, key=_ref_key) if AUTOPLACE_REFS else ():
        t = fps[ref].Reference()
        if not t.IsVisible() or not t.IsOnLayer(pcbnew.F_SilkS):
            continue
        # Level and shrunk. Rotation follows the footprint, so J1's designator was
        # standing on end beside a module whose own extent is 50 mm long.
        t.SetTextAngle(pcbnew.EDA_ANGLE(0, pcbnew.DEGREES_T))
        t.SetTextSize(pcbnew.VECTOR2I(FromMM(REF_H), FromMM(REF_H)))
        t.SetTextThickness(FromMM(REF_STROKE))
        tx0, ty0, tx1, ty1 = _text_box(t)
        w, h = tx1 - tx0, ty1 - ty0
        px0, py0, px1, py1 = _extent(fps[ref])
        cx, cy = (px0 + px1) / 2.0, (py0 + py1) / 2.0
        if ref in REF_AT:
            x, y = REF_AT[ref]
            # These reviewed positions already clear body courtyards; use the
            # actual ink/mask gate rather than adding another 0.5 mm margin.
            assert free(x - w / 2, y - h / 2, x + w / 2, y + h / 2, gap=0), (
                f"SILK: the pinned spot for the reference '{ref}' at {REF_AT[ref]} "
                "is not free")
            t.SetPosition(pcbnew.VECTOR2I(round((ORIGIN[0] + x) * 1e6),
                                         round((ORIGIN[1] + y) * 1e6)))
            taken.append(_text_box(t))
            continue
        # Four sides AND four corners. On a 115 mm board the sides were enough; at
        # 100 mm the passives band is shoulder to shoulder, and the only gaps left
        # are diagonal ones -- R8's designator had nowhere to go while the corner
        # above it was empty.
        spot = None
        for d in [i * 0.25 for i in range(2, 60)]:
            above, below = py0 - d - h / 2, py1 + d + h / 2
            right, left = px1 + d + w / 2, px0 - d - w / 2
            for x, y in ((cx, above), (cx, below), (right, cy), (left, cy),
                         (right, above), (left, above), (right, below), (left, below)):
                if free(x - w / 2, y - h / 2, x + w / 2, y + h / 2):
                    spot = (x, y)
                    break
            if spot:
                break
        assert spot, (
            f"SILK: nowhere free to print the reference '{ref}' -- the board is too "
            "tightly packed to be assembled by hand from its own silkscreen")
        t.SetPosition(P(*spot))
        taken.append(_text_box(t))


def _back_refs(fps):
    """Designators for the back parts, on the back, directly above each part.

    _labels() only places FRONT designators; a flipped footprint's reference is
    on B.Silkscreen, where the library left it -- across its own pads.
    """
    for ref, fp in sorted(fps.items()):
        if not _on_back(fp):
            continue
        t = fp.Reference()
        t.SetTextAngle(pcbnew.EDA_ANGLE(0, pcbnew.DEGREES_T))
        t.SetTextSize(pcbnew.VECTOR2I(FromMM(REF_H), FromMM(REF_H)))
        t.SetTextThickness(FromMM(REF_STROKE))
        x0, y0, x1, _y1 = _extent(fp)
        h = _text_box(t)[3] - _text_box(t)[1]
        t.SetPosition(P((x0 + x1) / 2.0, y0 - BACK_SILK_GAP - h / 2.0))


def _back_silk_problems(board, fps):
    """BACK_SILK: what _check's SILK gate asks of the front, asked of the back's
    designators -- on the board, off every part, off each other and the art."""
    texts, out = [], []
    for ref, fp in fps.items():
        t = fp.Reference()
        if t.IsVisible() and t.IsOnLayer(pcbnew.B_SilkS):
            texts.append((ref, _text_box(t)))
    art = [d for d in board.GetDrawings() if d.IsOnLayer(pcbnew.B_SilkS)
           and d.GetClass() == "PCB_SHAPE"]
    hit = lambda a, b: not (a[2] < b[0] or b[2] < a[0] or a[3] < b[1] or b[3] < a[1])
    for i, (ref, box) in enumerate(texts):
        if not (0 <= box[0] and box[2] <= BW and 0 <= box[1] and box[3] <= BH):
            out.append(f"BACK_SILK: '{ref}' is printed off the outline")
        for other, fp in fps.items():
            if _on_back(fp) and hit(box, _extent(fp)):
                out.append(f"BACK_SILK: '{ref}' is printed across {other} on the back")
            if any(hit(box, pad) for pad in _tht_pad_boxes(fp)):
                out.append(f"BACK_SILK: '{ref}' is printed across a pad of {other}")
        for other, obox in texts[i + 1:]:
            if hit(box, obox):
                out.append(f"BACK_SILK: '{ref}' and '{other}' are printed on top of "
                           "each other")
        for d in art:
            b = d.GetBoundingBox()
            if hit(box, (ToMM(b.GetLeft()) - ORIGIN[0], ToMM(b.GetTop()) - ORIGIN[1],
                         ToMM(b.GetRight()) - ORIGIN[0], ToMM(b.GetBottom()) - ORIGIN[1])):
                out.append(f"BACK_SILK: '{ref}' is printed across the back art")
                break
    return out


def _pin_legend(board, fps):
    """Name each pad of the power headers on B.Silkscreen, to the pad's right."""
    for ref in PIN_LEGEND_REFS:
        if ref not in fps:
            continue
        for pad in fps[ref].Pads():
            name = PIN_LEGEND_NAME[pad.GetNetname()]
            t = pcbnew.PCB_TEXT(board)
            t.SetText(name)
            t.SetLayer(pcbnew.B_SilkS)
            t.SetMirrored(True)
            t.SetTextSize(pcbnew.VECTOR2I(FromMM(SILK_H), FromMM(SILK_H)))
            t.SetTextThickness(FromMM(SILK_H * SILK_STROKE_RATIO))
            board.Add(t)
            px1 = ToMM(pad.GetBoundingBox().GetRight())
            w = ToMM(t.GetBoundingBox().GetWidth())
            t.SetPosition(pcbnew.VECTOR2I(FromMM(px1 + PIN_LEGEND_GAP + w / 2.0),
                                          pad.GetPosition().y))


def _pin_legend_problems(board):
    """PIN_LEGEND: every pad of every JST VH header -- the power headers -- has its
    net printed beside it on the back, in its own row, clear of every back pad."""
    texts = [t for t in board.GetDrawings()
             if t.GetClass() == "PCB_TEXT" and t.IsOnLayer(pcbnew.B_SilkS)]
    back_pads = [(fp.GetReference(), p) for fp in board.GetFootprints()
                 for p in fp.Pads() if p.IsOnLayer(pcbnew.B_Cu)]
    out = []
    for fp in board.GetFootprints():
        if "JST_VH" not in fp.GetFPIDAsString():
            continue
        for pad in fp.Pads():
            want = PIN_LEGEND_NAME.get(pad.GetNetname())
            if want is None:
                out.append(f"PIN_LEGEND: {fp.GetReference()} pad {pad.GetNumber()} "
                           f"carries {pad.GetNetname()!r}, which has no legend name")
                continue
            py, px1 = ToMM(pad.GetPosition().y), ToMM(pad.GetBoundingBox().GetRight())
            mine = [t for t in texts if t.GetText() == want
                    and abs(ToMM(t.GetBoundingBox().GetCenter().y) - py) < 0.5
                    and 0 < ToMM(t.GetBoundingBox().GetLeft()) - px1 < 2.0]
            if not mine:
                out.append(f"PIN_LEGEND: {fp.GetReference()} pad {pad.GetNumber()} "
                           f"({pad.GetNetname()}) has no '{want}' printed beside it "
                           "on the back -- the power headers read in opposite orders "
                           "and a harness crimped to the wrong one reverses 5 V")
                continue
            b = mine[0].GetBoundingBox()
            b.Inflate(FromMM(0.25))
            hit = [f"{r} pad {p.GetNumber()}" for r, p in back_pads
                   if b.Intersects(p.GetBoundingBox())]
            if hit:
                out.append(f"PIN_LEGEND: '{want}' beside {fp.GetReference()} pad "
                           f"{pad.GetNumber()} runs into {hit[0]} -- silk on a pad is "
                           "clipped by the mask opening and cannot be read")
    return out


def _debounce_caps(nets, fps):
    """-> {cap_ref: (x, y, rot)}, each 100nF sat directly above the switch it debounces.

    Left to the auto-placer these scattered: seven landed in the channel, C8 was
    pushed below the footswitch row entirely, and the row looked arbitrary because it
    was. The pairing comes from the netlist rather than from C-numbering, so it stays
    correct if console_board.py ever builds the switches in a different order.
    """
    out = {}
    for j in FSW_SLOTS:
        # The cap is on the Pico side of the input's series resistor (#1391): from
        # the header's pin-1 net, across the resistor, to the GPIO net.
        ext = next((n for n, nodes in nets.items() if (j, "1") in nodes), None)
        series = sorted(r for r, _p in nets.get(ext, ()) if r.startswith("R"))
        gpio = [n for n, nodes in nets.items() if n != ext and series
                and any(r == series[0] for r, _p in nodes)]
        assert len(series) == 1 and len(gpio) == 1, (
            f"DEBOUNCE: {j} pin 1 ({ext}) does not reach a GPIO net through one "
            f"series resistor (found {series})")
        caps = sorted(r for r, _p in nets[gpio[0]] if r.startswith("C"))
        assert len(caps) == 1, (
            f"DEBOUNCE: {gpio[0]} has {caps} on it, expected exactly one cap")
        # Over the PLACED header, as the protection parts below it are, so the
        # column stays one column wherever the header goes.
        hx0, _hy0, hx1, _hy1 = _extent(fps[j])
        out[caps[0]] = ((hx0 + hx1) / 2.0, CAP_Y, 0)
    assert len(out) == 10, f"DEBOUNCE: paired {len(out)} caps to switches, expected 10"
    return out


def _selftest():
    """Flip each layout gate and fail unless it bites. Same contract as
    console_board.py --selftest: a gate nobody has ever seen fail is a comment."""
    import copy
    saved = copy.deepcopy(PLACEMENT)
    # Each control names the gate it is meant to prove. A control that trips some
    # OTHER gate proves nothing about its own, and two of these silently did exactly
    # that after the floorplan moved -- so the expected message is checked, not read.
    # A case moves parts (the PLACEMENT dict) and/or overrides a module constant --
    # the two pours and the designator placement are decisions, not coordinates, and
    # they need controls just as much.
    cases = [
        ("indicator series resistor moved off its own net", "HOP:",
         {"R2": (12.0, 13.0, 90)}, {}),
        # J2 again, the representative case: only hand-PLACEMENT parts can ever
        # be off-board (the spiral bounds its own slots), and those are exactly
        # the labelled connectors. This control briefly became H3 because the
        # displaced J2's label assert fired before the outline gate; build() now
        # runs _check_place() ahead of the silk stage, so the true gate answers.
        ("part pushed off the outline", "outside the", {"J2": (112.0, 40.0, 0)}, {}),
        # Move a NON-isolated part up against the opto rather than moving the opto:
        # displacing U2 also displaces the anchors of its own passives, and the
        # placer then fails before the isolation gate is ever reached. Moving
        # C20 inward leaves less than the 2 mm barrier without an overlap --
        # a control that overlaps trips PLACE and proves nothing about ISOLATION.
        ("opto barrier inside ISOLATION_GAP", "ISOLATION:", {"C20": (42.5, 19.6, 0)}, {}),
        # the exact mistake that was shipped: the 5 V inlet parked in front of USB
        # Same spot, turned round -- the coordinates follow PLACEMENT, or the
        # control lands on the cap row and trips PLACE instead of its own gate.
        ("pill power header turned against J3", "PILL_POWER:", {"J24": (5.4, 60.84, 270)}, {}),
        # Two neighbours swapped, REC and STOP: they share a clamp (#1391), so the
        # protection parts still place and the fan-out order is what fails.
        ("footswitch fan-out out of order", "CROSSING:",
         {FSW_SLOTS[0]: (fsw_x(1), FSW_Y, 0), FSW_SLOTS[1]: (fsw_x(0), FSW_Y, 0)}, {}),
        # A clamp pushed down onto the header row it protects.
        ("footswitch clamp on a header pin", "PLACE:", {}, {"FSW_TVS_Y": 83.5}),
        # The back designators dropped onto their own parts.
        ("back designator printed across its part", "BACK_SILK:", {},
         {"BACK_SILK_GAP": -2.0}),
        # The pours tie SMD pads solid. This gate ran BEFORE the pours existed, so it
        # looped over an empty board.Zones() and could not fail; the ordering is what
        # makes the control below meaningful rather than the assertion text.
        ("ground pours tying SMD pads solid", "THERMALS:", {},
         {"PAD_CONNECTION": pcbnew.ZONE_CONNECTION_FULL}),
        # ...and the designators left exactly where the library footprints put them,
        # which is the board that shipped with "J1" printed across R3.
        ("designators left where the footprints put them", "SILK:", {},
         {"AUTOPLACE_REFS": False}),
        # Shrink the reference stroke without changing functional-label placement,
        # so this control reaches the printing gate rather than a packing gate.
        ("silkscreen stroked below the fab minimum", "SILK_FAB:", {},
         {"REF_STROKE": 0.1}),
        # A label on a PINNED row grows into its neighbour. The pinned rows are
        # placed at a fixed spot rather than searched for a free one, so nothing
        # about the placement can refuse them -- only the gate can.
        ("a pinned label overrunning its neighbour", "SILK:", {},
         {"LABELS": dict(LABELS, J20="CTRL 1 EXPRESSION PEDAL INPUT JACK")}),
        # One power header left without its pin names.
        ("pill header printed without pin names", "PIN_LEGEND:", {},
         {"PIN_LEGEND_REFS": ("J3",)}),
        # ...and the names nudged out into R21's pad (still beside their own pads).
        ("pin names pushed onto a neighbouring pad", "PIN_LEGEND:", {},
         {"PIN_LEGEND_GAP": 1.9}),
    ]
    ok = True
    for name, want, mutate, over in cases:
        PLACEMENT.clear(); PLACEMENT.update(saved); PLACEMENT.update(mutate)
        keep = {k: globals()[k] for k in over}
        globals().update(over)
        try:
            build(quiet=True)
            print("  NO BITE    %s  <-- gate is dead" % name)
            ok = False
        except (AssertionError, SystemExit) as exc:
            msg = str(exc).replace("\n", " ")
            if want in msg:
                print("  bites      %-38s %s" % (name, msg[:52]))
            else:
                print("  WRONG GATE %-38s wanted %s, got: %s" % (name, want, msg[:40]))
                ok = False
        finally:
            globals().update(keep)
    PLACEMENT.clear(); PLACEMENT.update(saved)
    for label, library, name in (
            ("XH", "Connector_JST", "JST_XH_B2B-XH-A_1x02_P2.50mm_Vertical"),
            ("VH", "Connector_JST", "JST_VH_B2P-VH_1x02_P3.96mm_Vertical"),
            ("IDC", "Connector_IDC", "IDC-Header_2x20_P2.54mm_Vertical"),
            ("expansion", "Connector_PinHeader_2.54mm", "PinHeader_2x03_P2.54mm_Vertical")):
        fixture = pcbnew.BOARD()
        fp = _load_fp(fixture, library, name, "J_TEST", 0, 0, 0)
        _check_connector_drills(fixture)
        pad = next(p for p in fp.Pads() if p.GetNumber() == "1")
        pad.SetDrillSize(pcbnew.VECTOR2I(FromMM(.9), FromMM(.9)))
        try:
            _check_connector_drills(fixture)
        except AssertionError as exc:
            assert "CONNECTOR_DRILL:" in str(exc)
            print(f"  bites      {label} finished hole undersized")
        else:
            print(f"  NO BITE    {label} finished hole undersized")
            ok = False
    return ok


def _route_screen_control(board, net):
    """One added control trace, preserving every pre-existing console route.

    The two vias cross the indicator trace below the ribbon. Coordinates are
    board-local; both existing copper layers retain a ground return beneath it.
    """
    paths = (
        (pcbnew.F_Cu, [(90.77, 53.43), (92.2, 53.43), (94.2, 55.43),
                      (94.2, 67.7), (93.3, 68.6)]),
        (pcbnew.F_Cu, [(66.75, 69.0), (66.75, 69.9), (70.05, 73.2), (76.0, 73.2)]),
        (pcbnew.B_Cu, [(93.3, 68.6), (88.7, 73.2), (76.0, 73.2)]),
    )
    for layer, points in paths:
        for start, end in zip(points, points[1:]):
            _track(board, net, layer, 0.6, start, end)
    for x, y in ((76.0, 73.2), (93.3, 68.6)):
        _via(board, net, x, y)


def build(quiet=False):
    comps, nets = parse_netlist(NETLIST)
    board = pcbnew.BOARD()

    ds = board.GetDesignSettings()
    ds.SetCopperLayerCount(2)
    ds.m_MinSilkTextHeight = FromMM(FAB_MIN_SILK_HEIGHT)
    ds.m_MinSilkTextThickness = FromMM(FAB_MIN_SILK_STROKE)
    ds.m_SilkClearance = FromMM(0.15)
    # The mask rule is ON, at the fab's own 0.25 mm. It was set to 0 -- i.e. off --
    # back when 0.1in headers produced ~100 "solder_mask_bridge" errors that drowned
    # out everything else. That is no longer true of this layout: re-enabled, DRC
    # comes back with zero. So the blind spot goes; a rule that currently passes is
    # worth more than one that was switched off for a board we no longer have.
    try:
        ds.m_SolderMaskMinWidth = FromMM(0.25)
    except Exception:
        pass

    netmap = {}
    for name in sorted(nets):
        ni = pcbnew.NETINFO_ITEM(board, name)
        board.Add(ni)
        netmap[name] = ni

    fps = {}
    for ref, (lib, name, _val) in sorted(comps.items()):
        if ref in PLACEMENT:
            x, y, rot = PLACEMENT[ref]
            fps[ref] = _load_fp(board, lib, name, ref, x, y, rot)

    for ref, (x, y, rot) in {**_debounce_caps(nets, fps), **CAP_AT}.items():
        lib, name, _v = comps[ref]
        fps[ref] = _load_fp(board, lib, name, ref, x, y, rot)

    for ref, (x, y, rot) in _input_protection(fps, nets).items():
        lib, name, _v = comps[ref]
        fps[ref] = _load_fp(board, lib, name, ref, x, y, rot, back=True)

    # everything else follows the netlist
    boxes = [_bbox_mm(fp) for fp in fps.values()]
    # The pinned label rows are geometry, not folklore: LABEL_ROW fixes fifteen
    # labels at two y coordinates before the spiral ever runs, so the spiral must
    # see those strips as occupied. Without this, a part auto-placed near the top
    # or bottom edge passes placement and fails five gates later at SILK -- one
    # full pipeline run per lesson, which is how the slot-geography comments in
    # PLACEMENT got written.
    for _y in sorted({y for y in LABEL_ROW.values()}):
        boxes.append((0.0, _y - SILK_H, BW, _y + SILK_H))
    net_of = {}
    for nname, nodes in nets.items():
        for r, _pad in nodes:
            net_of.setdefault(r, set()).add(nname)
    for ref, (lib, name, _val) in sorted(comps.items()):
        if ref in fps:
            continue
        fp = _load_fp(board, lib, name, ref, 0.0, 0.0, 0, by_centre=False)
        w, h = _fp_size_mm(fp)
        off = _centre(fp)                # origin -> extent-centre offset
        anchor = _best_anchor(ref, net_of, fps, nets)
        pos = _free_slot(anchor, w, h, boxes)
        if pos is None:
            raise SystemExit(f"PLACE: no free slot for {ref} near {anchor}")
        fp.SetPosition(P(pos[0] - off[0], pos[1] - off[1]))
        boxes.append(_bbox_mm(fp))
        fps[ref] = fp

    _check_connector_drills(board)

    # Placement geometry is judged HERE, the moment it exists -- a bad hand
    # coordinate must fail as PLACE, not surface later as a label with nowhere
    # to print (see _check_place's docstring).
    _check_place(fps)

    # This assembly-critical value implements the A2 UART-input workaround.
    fps["R18"].SetValue(comps["R18"][2])

    # attach nets to pads
    for name, nodes in nets.items():
        for ref, pad in nodes:
            if ref not in fps:
                continue
            for p in fps[ref].Pads():
                if p.GetNumber() == str(pad):
                    p.SetNet(netmap[name])

    _outline(board)
    _silk_art(board)

    # _silk() takes the text CENTRE, not its left edge -- the title was at x 6,
    # i.e. hanging 10 mm off the left of the board, and at y 86 on an 82 mm board.
    # It has never actually been printable. Gated below now.
    # Titles BEFORE the labels: _labels() treats whatever silk already exists as
    # occupied, so anything drawn after it is drawn on top of it.
    # No issue numbers. They were on the silk as "#747 #987" and are provenance
    # for whoever edits this file, not for whoever solders the board -- the
    # tracker is not something you can look up with a board in your hand, and
    # the numbers age worse than the board does. They live in this file's
    # docstring and in console_board_mount.json instead.
    # x 33, not 28: _silk() takes the text CENTRE, and the title has to clear
    # H4's pad at the left end of the bottom strip. Dropping the numbers only
    # shortens it inward from that centre, so the clearance can only improve;
    # the SILK gates below re-measure it as rendered either way.
    _silk(board, "SEGNO CONSOLE v3.2", 33.0, 95.5, 1.6)
    # No "MIDI IN: ISOLATED" legend (owner call, #1062). It said something true
    # about the circuit to nobody who needed it at the bench, and the bottom
    # strip reads better with the title alone.
    _labels(board, fps)
    _back_refs(fps)
    _pin_legend(board, fps)

    # Poured on BOTH layers, not just B.Cu. With one pour, B.Cu routing chopped the
    # plane into pieces and three islands were left with no path back to the main
    # body -- DRC reported them as unconnected, which they were. A second pour on
    # F.Cu gives every island a route home through the stitching grid that is
    # already there, and it is what the layout guidance asks for anyway: a
    # continuous low-impedance return directly beneath each signal.
    #
    # BEFORE _check(), not after. THERMALS reads board.Zones(), so with the pours
    # created afterwards it looped over an empty list and could not fail: the gate
    # that exists to catch "SMD pads tied solid into a plane" would have waved
    # through exactly that.
    _pour_gnd(board, netmap[POUR_NET], pcbnew.B_Cu)
    _pour_gnd(board, netmap[POUR_NET], pcbnew.F_Cu)
    _pill_power_bar(board, fps, netmap["+5V"])
    _pill_bar_blend(board, fps, netmap["+5V"])

    if quiet:
        global _QUIET
        _QUIET = True
        try:
            _check(fps, nets, board)
        finally:
            _QUIET = False
        return
    print("Layout assertions ...", end=" ")
    _check(fps, nets, board)
    print("ALL PASS")
    # No straight-line routing any more. It produced 37 crossings and 22 shorts:
    # pad-to-pad lines cannot dodge obstacles. The board is exported to Specctra
    # DSN and routed by Freerouting (see route_console_board.sh), per the repo's
    # pcb-layout skill. Placement quality is what makes that autoroute good --
    # "better placement in, cleaner autoroute out" -- which is why the ordering
    # and isolation gates above matter more now, not less.
    boxes = _drill_keepout(fps)
    # No GND via inside the pill bar: it would punch a hole in the copper the
    # pills' current runs through.
    boxes += [(x0 - VIA_KEEPOUT, y0 - VIA_KEEPOUT, x1 + VIA_KEEPOUT, y1 + VIA_KEEPOUT)
              for x0, y0, x1, y1 in _pill_bar_rects(fps)]
    boxes += console_ring_power.stitch_keepouts(ORIGIN)
    n_vias = _stitch_gnd(board, fps, nets, netmap, boxes)
    n_vias += _stitch_grid(board, netmap[POUR_NET], fps, boxes)
    _route_screen_control(board, netmap["PI_GPIO17"])
    console_ring_power.install(board)

    # NOT pcbnew.ZONE_FILLER here: in-process it segfaults with no wxApp. The
    # LED-strip generator hit the same wall and fills via kicad-cli instead --
    # `pcb drc --refill-zones --save-board` pours and checks in one pass.
    os.makedirs(OUT, exist_ok=True)
    board.Save(PLACED_PATH)
    # Purple mask, white silk. Written into the file because the bindings cannot
    # set a stackup; the route script's load/save carries it to the routed board.
    import board_stackup
    board_stackup.apply(PLACED_PATH)
    write_mount_json()
    write_bom()
    print(f"placed {len(fps)} footprints | {n_vias} GND vias | "
          "2 GND pours (filled by kicad-cli)")
    return board


def write_bom():
    """A parts list, in the CSV shape the retired V1 board's BOM already used.

    The board had gerbers and no BOM. You cannot buy a board from gerbers alone --
    somebody has to order the parts, and "read them off the netlist" is how a build
    ends up with the wrong capacitor voltage.

    Two groupings, because the netlist's "value" means different things by part:
      * PASSIVES and ICs are grouped by value AND footprint -- the same 100nF at two
        lead pitches is two different purchases, and the same footprint at two
        capacitances certainly is.
      * CONNECTORS are grouped by FOOTPRINT, with their roles in the comment. Their
        value is a role name (FSW_STOP, MIDI_IN), so grouping by it lists the same
        13 identical 2-pin JSTs as 13 separate things to buy.

    Mounting holes are not in it. They are holes.
    """
    comps, _nets = parse_netlist(NETLIST)
    parts, conns = {}, {}
    for ref, (_lib, fp, val) in comps.items():
        if "MountingHole" in fp:
            continue
        (conns if ref.startswith("J") else parts).setdefault(
            fp if ref.startswith("J") else (val, fp), []).append((ref, val))

    rows = []
    for (val, fp), items in parts.items():
        rows.append((val, [r for r, _v in items], fp))
    for fp, items in conns.items():
        roles = ", ".join(v for _r, v in sorted(items, key=lambda i: _ref_key(i[0])))
        exact = {"J2": "Wurth 61204021621", "J22": "Wurth 61300621121"}
        if len(items) == 1 and items[0][0] in exact:
            roles += "; " + exact[items[0][0]]
        rows.append((roles, [r for r, _v in items], fp))

    # Exact purchase numbers where a substitute breaks the circuit. The clamp is
    # chosen for its 1 uA leakage against the Pico's weak pull-up; a generic 5 V
    # TVS leaks up to 800 uA and holds the footswitch pressed (#1391).
    lcsc = {"PESD5V2S2UT": "C18441"}

    path = os.path.join(HERE, "fab", "segno_console_board_bom.csv")
    os.makedirs(os.path.dirname(path), exist_ok=True)
    with open(path, "w") as fh:
        fh.write("Comment,Designator,Footprint,LCSC,Qty,Type\n")
        for comment, refs, fp in sorted(rows, key=lambda r: (-len(r[1]), r[2])):
            refs = sorted(refs, key=_ref_key)
            fh.write('"%s","%s",%s,%s,%d,Component\n'
                     % (comment or "?", ",".join(refs), fp, lcsc.get(comment, ""),
                        len(refs)))
    return path
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
