tomassasovsky/segno-hardware/hardware/kicad/console_board.py

"""SKiDL generator for the Segno CONSOLE board v2 (issue #747).

The 10-pedal console's control board. Lies flat on the bottom plate beside the
Raspberry Pi 5 and links to it over a KEYED 2x20 ribbon -- a stock ~10 cm part:
both boards live under the 16" screen with the Pi ~30 mm away, and the five
rear-panel stations the board terminates sit directly above it (the cluster moved
with the boards). See board_mounts() and REAR_IO_U in segno_enclosure.py, which
own the geometry. Carries a **Pico 2 (RP2350)** module, the MIDI front end, and a
JST header for every pedal and every rear-panel connector.

Run (from hardware/kicad/):
    ./.venv/bin/python console_board.py            # netlist + gates
    ./.venv/bin/python console_board.py --selftest # prove the gates bite

Why this board exists
---------------------
The Pi 5's four USB-A ports are exactly consumed -- two touchscreens, two rear
panel couplers -- and a hub is ruled out, so the retired V1 pedal board could not
have one. Its only hardware UART was already the DIN-5 pair, so MIDI moves to the
Pi and the MCU gets a UART of its own. See
docs/brainstorm/2026-08-17-console-board-v2-brainstorm-doc.md.

An MCU still has to exist: rpi_ws281x drives the legacy PWM/PCM+DMA peripherals and
does NOT support Pi 5, whose I/O moved to RP1. The retired RP2040 LED driver already
offloaded WS2812 timing to an MCU for exactly that reason; firmware/console_board/
carries that job now (pedal_link.h is the wire format).

THE PICO DELETED THE LEVEL-SHIFTING PROBLEM
-------------------------------------------
The old plan (the 5 V AVR board of the retired pedal) needed a 1k8/3k3 divider and an AHCT gate on the
MCU link; the RP2350 is **3.3 V, the same as the Pi**, so the link needs no
level shifting in either direction. R17 is 10 k and R18 is 6.8 k in series,
limiting fault current while keeping the Pico UART receiver within the RP2350
A2 E9 source-impedance bound (see their comment block). segno_wiring.md section 3 carries
the harness-facing version of this story.

The 74AHCT125 is still here, but for the three places that genuinely cross 3.3 -> 5:
  * MIDI OUT   -- the Pi's 3.3 V TX cannot drive a 5 V MIDI current loop
  * ring data  -- WS2812 wants a 5 V logic high
  * indicator data -- same
MIDI IN needs no shifter at all: the H11L1 is a Schmitt LOGIC-output opto, so run
it from 3.3 V and it feeds the Pi directly.

Ref-designator blocks (allocated up front -- the retired V1 generator had to pin ref="C16" to
stop a late addition renumbering C1..C15 and invalidating a started layout):
    J1  Pico 2          J2  Pi ribbon      J3  power in     J4  MIDI OUT
    J5  MIDI IN         J6  ring/encoder   J7  (retired, #1062) J8  power button
    J24 pills: 5 V, data and GND on one JST VH, beside J3
    J25 screen-power control: Pi GPIO17 and GND, on a 2-pin JST XH
    J9  Pi power-button pads (through-lead)                 J10..J19 footswitches
    J20/J21 CTRL 1/2    U1  74AHCT125      U2  H11L1
    R14..R16 idle-state pull-downs (U1's inputs)            R17/R18 link series
    R23..R32 footswitch series (#1391)  D2..D6 footswitch clamps (#1391)
"""
import json
import os
import re
import sys
import tempfile

import netlist
from skidl import (
    Pin,
    Part, Net, generate_netlist, ERC, POWER, set_default_tool, KICAD8,
    lib_search_paths,
)

set_default_tool(KICAD8)

# SKiDL puts the active circuit in builtins rather than exporting it, and the
# POLARITY gate below wants EVERY part, not a list this file remembers to update.
from builtins import default_circuit          # noqa: E402  (set up by skidl)

_SYMBOL_DIRS = [
    os.environ.get("KICAD_SYMBOL_DIR", ""),
    r"C:\Program Files\KiCad\10.0\share\kicad\symbols",
    r"C:\Program Files\KiCad\9.0\share\kicad\symbols",
    "/Applications/KiCad/KiCad.app/Contents/SharedSupport/symbols",   # KiCad 8+ macOS
    "/Applications/KiCad.app/Contents/SharedSupport/symbols",         # older macOS layout
    "/usr/share/kicad/symbols",
]
for _d in _SYMBOL_DIRS:
    if _d and os.path.isdir(_d):
        lib_search_paths[KICAD8].append(_d)

HERE = os.path.dirname(os.path.abspath(__file__))
STATIONS_JSON = os.path.join(HERE, "..", "enclosure", "out", "rear_io_stations.json")

R_FP = "Resistor_THT:R_Axial_DIN0207_L6.3mm_D2.5mm_P10.16mm_Horizontal"
# 2.50 mm lead pitch, not 5.00. Commodity "104" discs and MLCCs ship on 2.5 mm
# spacing; the 5 mm land would have meant splaying the leads on all 16 of them, or
# hunting an unusual part. Changing the board is cheaper than changing the BOM.
# (C30 is the opposite case and keeps its 10 mm / 5 mm land -- order a 470uF at
# 25 V or 35 V, since the common 16 V part is 8 x 11.5 mm on 3.5 mm pitch and will
# not physically fit.)
C_FP = "Capacitor_THT:C_Disc_D5.0mm_W2.5mm_P2.50mm"
JST = "Connector_JST:JST_XH_B%dB-XH-A_1x%02d_P2.50mm_Vertical"


def R(value, fp=R_FP, **kw):
    return Part("Device", "R", value=value, footprint=fp, **kw)


def C(value, fp=C_FP, **kw):
    return Part("Device", "C", value=value, footprint=fp, **kw)


def CP(value, fp, **kw):
    """An ELECTROLYTIC. Polarised symbol, not just a polarised footprint.

    C30/C31 were built with Device:C -- the non-polarised symbol -- on CP_Radial
    footprints. The board was right (pad 1 is + on those footprints, and pin 1 went
    to +5V), but nothing DECLARED the part as polarised, so nothing could ever check
    it: reorder the two pins in a future edit and you get a 470uF electrolytic
    backwards across a 5 V rail, which vents at power-on and no gate here would have
    said a word. ring_board.py already used C_Polarized, so this was an oversight.
    """
    return Part("Device", "C_Polarized", value=value, footprint=fp, **kw)


# JST VH, 3.96 mm pitch, ~10 A per contact: the two connectors that carry the
# pills' full-white current (#1062). XH is ~3 A per contact.
JST_VH = "Connector_JST:JST_VH_B%dP-VH_1x%02d_P3.96mm_Vertical"


def jst_vh(n, ref, value):
    return Part("Connector_Generic", "Conn_01x%02d" % n,
                footprint=JST_VH % (n, n), ref=ref, value=value)


def jst(n, ref, value):
    return Part("Connector_Generic", "Conn_01x%02d" % n,
                footprint=JST % (n, n), ref=ref, value=value)


# ---- nets -------------------------------------------------------------------

gnd = Net("GND")
v5 = Net("+5V")            # logic: Pico VSYS + the AHCT125
# ONE 5 V rail. There used to be a second, "+5V_LED", on the theory that giving the
# WS2812s their own pair back to the supply kept their IR drop out of the logic
# rail. Both rails come off the same 8-36V->5V 10A buck, so it was never redundancy
# or headroom -- and the benefit it did have was half undone on this board anyway,
# because GND is a single pour: the feeds were separated and the returns were not.
# At full white the ten 8-LED pills draw 4.8 A and the 40-LED strip draws 2.4 A.
# The pills' share comes in on J3 and leaves on J24, two JST VH headers stacked at
# the left edge with their +5V pads joined by a few millimetres of copper. What
# reaches J6 uses a dedicated 1.7 mm supply with four parallel power vias, sized
# for 2.64 A including LED idle current and the ring controller. Console logic
# has its own branch.
#
# The ring board is unaffected. It declares its own single supply as Net("+5V_LED")
# locally (ring_board.py:46); two netlists joined by a cable do not have to agree on
# net NAMES, only on pin order -- which is what RING_CONTRACT gates, by reading
# ring_board.net and mapping the two names onto each other (see RING_ALIASES).
v3v3 = Net("+3V3")         # from the Pi ribbon -- the MIDI front end is the Pi's,
                           # so it runs on the Pi's rail and works whenever the Pi
                           # is up, regardless of the MCU
v3v3_pico = Net("+3V3_PICO")  # Pico pin 36: CTRL bias and AUX-domain UART idle
link_tx = Net("LINK_TX")   # Pico -> Pi   (3V3 both ends: no level shifting...)
link_rx = Net("LINK_RX")   # Pi   -> Pico (3V3 both ends)
link_tx_pi = Net("LINK_TX_PI")   # ...but series R17/R18: these are the
link_rx_pi = Net("LINK_RX_PI")   # two nets that cross power domains -- see below
pi_gpio17 = Net("PI_GPIO17")  # screen-power daughterboard enable, 3.3 V only
midi_tx = Net("MIDI_TX")   # Pi uart0 TX -> AHCT125 -> DIN OUT
midi_rx = Net("MIDI_RX")   # opto (3V3) -> Pi uart0 RX
midi_out_buf = Net("MIDI_OUT_BUF")
pwr_btn = Net("PWR_BTN")   # rear button -> the Pi's own PWR pads, NOT a GPIO
# The button's other contact, carried through to the Pi's other pad. NOT GND (#1062):
# see J9.
pwr_btn_ret = Net("PWR_BTN_RET")
swclk, swdio = Net("SWCLK"), Net("SWDIO")
ind_data, ind_buf, ind_out = Net("IND_DATA"), Net("IND_DATA_BUF"), Net("IND_DATA_OUT")
# #987 moved the encoder and the WS2812 timing onto the ring board, behind a XIAO
# RP2350. NO COPPER ON THIS BOARD CHANGED -- these are the same three GP13/14/15
# tracks to the same J6 pins, renamed to what they now carry. GP13 became the
# half-duplex link to that MCU; GP14/GP15 carry nothing and are named for it
# rather than left claiming to be an encoder that is no longer on the far end.
# The ring link is FULL DUPLEX (owner call): GP13 drives the ring, GP14 listens
# to it. Named by direction of travel, identically on both boards, so no alias
# table is needed and neither name is a lie from one end.
link_to_ring = Net("LINK_TO_RING")        # this board drives, the XIAO listens
link_to_console = Net("LINK_TO_CONSOLE")  # the XIAO drives, this board listens
ctrl1, ctrl2 = Net("CTRL1_TIP"), Net("CTRL2_TIP")

# ---- J1: Pico 2 (RP2350) ----------------------------------------------------
# EITHER WAY, on segno:RaspberryPi_Pico_SMD_or_THT_Debug (owner call, #1062):
# KiCad's SMD hand-solder footprint -- pads, silk, courtyard, 3D model -- with a
# through-hole added at every pin. Solder the module flat by its castellations,
# or socket it on 2.54 mm headers and pull it out later; the board does not care,
# and a socketed module can be lifted out to reach its own USB, which this board
# no longer leaves a corridor for.
#
# The three debug holes land on D1/D2/D3, which the plain (headerless) Pico 2
# carries as 0.1 in through-holes, so SWD stays on the board in both builds --
# KiCad's own THT footprint drops those pads entirely, and SWD is how the
# appliance flashes this board on every update. (The "H" variants ship a 1.0 mm
# JST-SH connector there instead and do not fit.)
# Pad numbers are the module's physical pins:
#   1 GP0  2 GP1  3 GND  4 GP2  5 GP3  6 GP4  7 GP5  8 GND  9 GP6  10 GP7
#  11 GP8 12 GP9 13 GND 14 GP10 15 GP11 16 GP12 17 GP13 18 GND 19 GP14 20 GP15
#  21 GP16 22 GP17 23 GND 24 GP18 25 GP19 26 GP20 27 GP21 28 GND 29 GP22 30 RUN
#  31 GP26 32 GP27 33 AGND 34 GP28 35 ADC_VREF 36 3V3_OUT 37 3V3_EN 38 GND
#  39 VSYS 40 VBUS
PICO_GND_PADS = (3, 8, 13, 18, 23, 28, 33, 38)
PICO = {  # GPIO number -> module pad
    0: 1, 1: 2, 2: 4, 3: 5, 4: 6, 5: 7, 6: 9, 7: 10, 8: 11, 9: 12,
    10: 14, 11: 15, 12: 16, 13: 17, 14: 19, 15: 20, 16: 21, 17: 22,
    18: 24, 19: 25, 20: 26, 21: 27, 22: 29, 26: 31, 27: 32, 28: 34,
}
ADC_GPIO = (26, 27, 28)          # the only ADC-capable pins on the module header

pico = Part("Connector_Generic", "Conn_01x40",
            footprint="segno:RaspberryPi_Pico_SMD_or_THT_Debug", ref="J1", value="Pico2")
# Conn_01x40 is the 40 ways. The footprint ALSO carries the three debug pads
# (D1/D2/D3 along the module's bottom edge), which no generic connector symbol
# has, so they are added to the part by hand -- otherwise SWD has nothing to
# attach to and silently falls back to needing a header.
pico.add_pins(Pin(num="D1", name="SWCLK", func=Pin.types.BIDIR),
              Pin(num="D2", name="GND", func=Pin.types.PASSIVE),
              Pin(num="D3", name="SWDIO", func=Pin.types.BIDIR))
for _p in PICO_GND_PADS:
    pico[_p] += gnd
pico[39] += v5                   # VSYS: 5 V in, onboard reg makes 3V3
pico[40].do_erc = False          # VBUS -- USB only, unused
pico[30].do_erc = False          # RUN  -- BOOTSEL/RUN not brought out
pico[35].do_erc = False          # ADC_VREF -- left on the module's own reference
pico[36] += v3v3_pico             # CTRL bias and ring UART use the Pico's supply
pico[37].do_erc = False          # 3V3_EN -- internal pull-up

# Spare GPIO, brought out to nothing on purpose. ERC would otherwise report each
# as an unconnected pin, and a wall of expected warnings is how a REAL one gets
# missed -- so the exemptions are named here rather than tolerated in the log.
# The retired V1 generator did the same for its unused AHCT gates and MIDI IN's DIN pin 2.
# No GPIO is left with nothing on it. Unused pins go to the expansion header J22
# rather than being quietly ERC-exempted into thin air -- an unpopulated header
# costs a footprint and nothing else, and it is the difference between "add a
# feature" and "respin the board". That is exactly what happened to GP20/GP21:
# v2 brought them out on J22, the CTRL jacks' rings turned out to need sensing
# (a BOSS FS-6 puts its second switch there), and the first console got two
# bench wires from the jack pins to those pads. v3 makes them traces -- see
# CTRLn_RING below -- and gives J22 the two pins the ring link freed (GP12,
# GP15) in their place; then GP19/GP22 left it again for the switched jacks'
# presence contacts. GP0/GP1, spare on v2, are v3's I2C to the PD trigger
# (J23): they are row A at the far end of the module, which is the end J3 and
# the power inlet are on anyway.
#
# GP5 is the one exception, and it is a routing call rather than an oversight.
# GP12 left J22 for SW_MODE (#1388, see the pin map below), and GP5, the pin MODE
# vacated, cannot follow it onto J22: no 0.6 mm track fits between two of the
# module's through-holes at 2.54 mm pitch, so pad 7 reaches J22 only by going
# round the module's LEFT end, through the J3/J24 power bar and the CTRL and
# presence lines beside it. Routed that way, ten Freerouting attempts left nets
# unconnected, and the one DRC-clean result had cut the +5V bar the ring supply
# starts from. GP12 made the same trip from pad 16 on v3 and only just fitted.
# Nothing needs a third expansion GPIO, so J22 pin 3 is left unconnected.
SPARE_GPIO = (5,)
# J22 sits beside U2, where it reaches row A (GP15, pad 20) and GP28 (pad 34,
# row B) alike.
EXPANSION_GPIO = (15, 28)
for _gp in SPARE_GPIO:
    pico[PICO[_gp]].do_erc = False

# ---- pin assignment ---------------------------------------------------------
GPIO = {
    # THE PIN MAP IS A FLOORPLAN. The module's pads 1..20 are one physical row and
    # 21..40 the other, so a GPIO number decides where on the board a connector can
    # physically sit. Each connector's signals are therefore kept inside ONE row and
    # adjacent, and the row is chosen to face the part it talks to:
    #
    #   row A, left  ..  centre ......................  right
    #   pads 1  2     4 ------------------- 16    17  19       20
    #   J23: PD I2C   the ten footswitches        J6: ring link  J22
    #                 (pad 7 in the run is GP5, unconnected: see SPARE_GPIO)
    #   row B, left  ..  centre ......................  right
    #   pads 40 39               32 31                 23   22 21
    #   VBUS VSYS <- J3          CTRL2/1                IND  LINK_RX/TX -> J2
    #
    # LINK is on GP16/17, not GP0/1: both are UART0 TX/RX pairs electrically, but
    # GP16/17 are pads 21/22 -- the end nearest the Pi ribbon J2, which is what the
    # link actually talks to. On GP0/1 (pads 1/2) it left the module at the far end
    # and crossed the whole board. Same for IND_DATA on GP18: it is one of the three
    # signals U1 buffers, and U1 sits off the module's right end.
    "LINK_TX": 16, "LINK_RX": 17,
    "SW_RECPLAY": 2, "SW_STOP": 3, "SW_UNDO": 4,
    "SW_TRACK1": 6, "SW_TRACK2": 7, "SW_TRACK3": 8, "SW_TRACK4": 9,
    "SW_CLEAR": 10, "SW_BANK": 11,
    # MODE is on GP12 (pad 16), not GP5 (pad 7), since #1388. The first v3
    # console's Pico 2 has a dead GP5 (it reads ~0 V against its own pull-up), so
    # that board was reworked: pad 7 isolated in the socket and jumpered to
    # pad 16, with the firmware reading MODE on GP12. This board puts the trace
    # where the jumper is, so a reworked v3 and this revision run the same
    # firmware. Pad 16 is still row A, but at the RIGHT end of the footswitch
    # run, so MODE's header J13 sits at the right end of the footswitch row
    # (FSW_SLOTS in console_board_pcb.py) and the fan-out stays uncrossed. The
    # designators keep FSW_ORDER below: J13 and C4 are MODE's, as on v3.
    "SW_MODE": 12,
    # The ring board generates its own WS2812 timing behind a XIAO RP2350 (#987),
    # so the ring cable is a two-wire link. v2 kept GP12 (ring data through the
    # AHCT125's gate B) and GP15 (a spare on J6 pin 8) fitted because that board
    # existed in copper; v3 is new copper, so both went to the expansion header
    # instead and J6 shrank to the four conductors the cable actually has.
    "LINK_TO_RING": 13, "LINK_TO_CONSOLE": 14,
    "IND_DATA": 18,
    "CTRL1_TIP": 26, "CTRL2_TIP": 27,
    # The rings, sensed: pads 26/27, row B, a few pads from the tips. GP20/21 were
    # the v2 expansion pins the bench wires went to, so a v2 board with the wires
    # and a v3 board with the traces present the SAME pins to the firmware.
    "CTRL1_RING": 20, "CTRL2_RING": 21,
    # I2C to the STUSB4500 PD trigger (J23): read the negotiated contract. GP0/1
    # are I2C0 SDA/SCL, row A's first two pads -- the end the power inlet is on.
    "PD_SDA": 0, "PD_SCL": 1,
    # Jack presence, from the switched jacks' ring-normal contacts (v3, Neutrik
    # NJ6FD-V): high while the jack is EMPTY, open once a plug is inserted.
    # On A2, a reliable low requires runtime #1082's E9 input-enable gating and
    # discharge interval; a continuously enabled input plus its weak pull-down
    # is insufficient. Pads 25/29, row B, by the tips.
    # These were J22 pins on v2, where they float and read "plugged": the same
    # firmware serves both boards without a revision flag.
    "CTRL1_PRESENT": 19, "CTRL2_PRESENT": 22,
}

# Which pads each UART instance can reach on RP2350. Moving LINK to a "spare-
# looking" GPIO is a one-character edit that silently costs the link its hardware
# UART, so the pairing is gated rather than trusted to the comment above.
UART_PINS = {0: ({0, 12, 16, 28}, {1, 13, 17, 29}),
             1: ({4, 8, 20, 24}, {5, 9, 21, 25})}
# Likewise for I2C: SDA and SCL must be one instance's pair, or the bus is two
# half-buses that never talk. RP2350 I2C0/I2C1 SDA/SCL by GPIO.
I2C_PINS = {0: ({0, 4, 8, 12, 16, 20, 28}, {1, 5, 9, 13, 17, 21, 29}),
            1: ({2, 6, 10, 14, 18, 22, 26}, {3, 7, 11, 15, 19, 23, 27})}
FSW_ORDER = ["RECPLAY", "STOP", "UNDO", "MODE", "TRACK1",
             "TRACK2", "TRACK3", "TRACK4", "CLEAR", "BANK"]

pico[PICO[GPIO["LINK_TX"]]] += link_tx
pico[PICO[GPIO["LINK_RX"]]] += link_rx
pico[PICO[GPIO["IND_DATA"]]] += ind_data
pico[PICO[GPIO["LINK_TO_RING"]]] += link_to_ring
pico[PICO[GPIO["LINK_TO_CONSOLE"]]] += link_to_console
pico[PICO[GPIO["CTRL1_TIP"]]] += ctrl1
pico[PICO[GPIO["CTRL2_TIP"]]] += ctrl2
ctrl1_ring = Net("CTRL1_RING")
ctrl2_ring = Net("CTRL2_RING")
pico[PICO[GPIO["CTRL1_RING"]]] += ctrl1_ring
pico[PICO[GPIO["CTRL2_RING"]]] += ctrl2_ring
pd_sda, pd_scl = Net("PD_SDA"), Net("PD_SCL")
pico[PICO[GPIO["PD_SDA"]]] += pd_sda
pico[PICO[GPIO["PD_SCL"]]] += pd_scl
ctrl1_present, ctrl2_present = Net("CTRL1_PRESENT"), Net("CTRL2_PRESENT")
pico[PICO[GPIO["CTRL1_PRESENT"]]] += ctrl1_present
pico[PICO[GPIO["CTRL2_PRESENT"]]] += ctrl2_present

# ---- J10..J19: footswitches -- clamp, 1k series, 100nF debounce, one JST each -
sw_nets = {}       # name -> the Pico side: GPIO, debounce cap, resistor
sw_ext = {}        # name -> the cable side: JST pin 1, clamp, resistor
fsw_jacks = {}     # name -> its JST, so the gates read the PART
# THE FIRMWARE OWNS HALF OF THIS CIRCUIT. There is no external pull-up: each
# footswitch is a bare contact to GND, and the idle-high level comes from the
# RP2350's INTERNAL pull-up. Forget to enable it and all ten inputs float with a
# capacitor on them, which reads as noise, not as "always released".
#
# THE CABLE IS PROTECTED (#1391). v3 ran JST pin 1 straight to the GPIO, and the
# first console lost GP5 that way (#1388): the pin sat near 0 V against its own
# pull-up after something arrived down the MODE cable -- ESD from a foot on the
# pedal, or a supply rail touching the line. Each input is now, from the cable in:
#
#   JST pin 1 --+-- 1k (R23..R32) --+-- GPIO
#               |                   |
#         clamp to GND         100nF to GND
#         (D2..D6, at the      (C1..C10, at the
#          connector)           Pico side)
#
# The clamp is a PESD5V2S2UT, two unidirectional TVS diodes with a common anode
# in SOT-23, so one part covers two neighbouring inputs (TVS_PAIRS below). It
# takes the ESD current at the connector and returns it to the cable's own GND
# pin; the IEC 61000-4-2 pulse it is rated for (level 4: 8 kV contact, 30 A
# peak) is far beyond the 4 kV HBM component rating of the RP2350's FT pins.
# Low capacitance is not a selection criterion here: the line already carries
# 100 nF. Leakage is, because the only thing holding the line high is a 32-86k
# pull-up -- see TVS_SPECS and the FSW_PROTECT gate.
#
# The cap sits AFTER the resistor, on the Pico side, for two reasons. The 1k and
# 100nF make a 100 us low-pass behind the clamp, so the clamp's residual (up to
# 20 V for ~100 ns) moves the pin by about 20 mV. And the switch no longer shorts
# the cap directly: the discharge goes through the 1k. With the cap on the cable
# side the pin would sit behind 1k and its own ~5 pF, which filters nothing.
#
# Timing, with RP2350 RPU 32-86k and VIL 0.8 V / VIH 2.0 V at IOVDD 3.3 V:
#   * PRESS: the cap discharges through the 1k, tau = 0.1 ms, below VIL in
#     0.14 ms. Held, the pin sits at 3.3 V x 1k / (1k + RPU) <= 0.10 V.
#   * RELEASE: the pull-up recharges the cap through RPU + 1k, tau 3.3-8.7 ms,
#     crossing VIH after 0.93 tau = 3.1-8.1 ms. The 1k adds about 2% to the
#     pull-up, so this is v3's release edge unchanged.
#   The firmware reports an edge once the pin has held for 8 ms (stable-edge
#   debounce), so presses report at ~8 ms and releases at ~11-16 ms, as on v3.
#   A2 erratum E9 needs a low-driving source of 8.2k or less; switch plus 1k is.
for _i, _name in enumerate(FSW_ORDER):
    n = Net("SW_" + _name)
    ext = Net("SW_" + _name + "_EXT")
    pico[PICO[GPIO["SW_" + _name]]] += n
    C("100nF")[1, 2] += n, gnd
    j = jst(2, "J%d" % (10 + _i), "FSW_" + _name)
    j[1] += ext
    j[2] += gnd
    sw_nets[_name] = n
    sw_ext[_name] = ext
    fsw_jacks[_name] = j

# EVERY RESISTOR IS PINNED to the designator it had when the board was first
# fabbed and documented (v2): the soldering guide, the placement table and the
# fitted boards all name parts by ref, and SKiDL numbers unpinned parts in
# declaration order, so deleting or inserting one would silently renumber every
# resistor after it. Gaps are fine; drift is not. PIN_REFS in _check() holds the
# ones whose identity has been stolen before.
# ---- U1: 74AHCT125 quad buffer -- the three real 3V3 -> 5V crossings ---------
buf = Part("74xx", "74AHCT125", value="74AHCT125N",
           footprint="Package_DIP:DIP-14_W7.62mm", ref="U1")
buf[14] += v5
buf[7] += gnd
C("100nF")[1, 2] += v5, gnd
# WHICH GATE carries which signal is a layout decision, not an arbitrary one: on a
# DIP-14 pins 1-7 are one side and 8-14 the other, so a gate's input pin decides
# which side of the package that signal has to arrive from. IND_DATA comes off the
# module (to U1's left) and MIDI_TX comes off the Pi ribbon (to its right), so
# they take gates whose inputs face the right way. Wired the other way round,
# IND_DATA had to travel around the package and was the one net on the board the
# autorouter could not finish.
#
# Gate B carried RING_DATA until #987 moved the WS2812 timing onto the ring
# board. v3 parks it like gate D: /OE high so the output floats, input tied low
# so a CMOS input never drifts. Its 330R series part (R1) and the 100k pull-down
# (R15) went with it; the designators stay retired so nothing else inherits them.
buf[1] += gnd; buf[2] += ind_data; buf[3] += ind_buf            # gate A: indicators
buf[4] += v5; buf[5] += gnd                                      # gate B: parked
buf[6].do_erc = False
buf[10] += gnd; buf[9] += midi_tx; buf[8] += midi_out_buf       # gate C: MIDI OUT
buf[13] += v5                                                    # gate D: unused,
buf[12] += gnd                                                   # /OE high, input low
buf[11].do_erc = False
R("330", ref="R2")[1, 2] += ind_buf, ind_out

# ---- J4/J5: DIN-5 MIDI, terminating on the PI's uart0 -----------------------
j_mout = jst(3, "J4", "MIDI_OUT")
R("220", ref="R3")[1, 2] += midi_out_buf, j_mout[1]      # DIN pin 5
R("220", ref="R4")[1, 2] += v5, j_mout[2]                # DIN pin 4
j_mout[3] += gnd                               # DIN pin 2 (shield) -- OUT only

j_min = jst(2, "J5", "MIDI_IN")
opto = Part("Isolator", "H11L1", footprint="Package_DIP:DIP-6_W7.62mm", ref="U2")
R("220", ref="R5")[1, 2] += j_min[1], opto[1]            # DIN pin 4
opto[2] += j_min[2]                            # DIN pin 5
# MIDI 1.0: the IN jack's pin 2 (shield) is NOT connected at the receiver, which is
# why J5 is a 2-pin header and not a 3-pin one -- the isolation is the point.
# ANTI-parallel with the opto's LED, and read that twice: KiCad's Device:D numbers
# pin 1 as K and pin 2 as A, so this line -- which looks like "same direction as the
# LED" -- is the correct reverse clamp. MIDI_CLAMP in _check() asserts it by PIN
# NAME so the next reader does not have to trust the numbering.
d_clamp = Part("Device", "D", value="1N4148",
               footprint="Diode_THT:D_DO-35_SOD27_P7.62mm_Horizontal", ref="D1")
d_clamp[1, 2] += opto[1], opto[2]
opto[6] += v3v3                                # 3V3, so its output feeds the Pi direct
opto[5] += gnd
C("100nF", ref="C20")[1, 2] += v3v3, gnd
R("10k", ref="R6")[1, 2] += v3v3, opto[4]
opto[4] += midi_rx

# ---- J20/J21: CTRL 1/2 -- one jack takes an expression pedal OR a switch -----
# tip -> ADC with a 10k pull-up; ring -> 3V3 THROUGH 1k. That 1k matters: a TS plug
# shorts ring to sleeve, so a hard 3V3 on the ring would be a dead short to GND
# every time someone plugs in a footswitch. With it, a pot reads mid-scale and a
# switch reads rail-to-rail, and firmware can tell them apart.
#
# The ring is ALSO sensed (v3). A two-switch pedal on one TRS plug -- a BOSS FS-6
# on its A&B jack -- puts its second switch between ring and sleeve, which the
# tip's ADC can never see: the tip has its own pull-up. So each ring goes to a
# GPIO through a series resistor, and reads high (~3 V, the 1k's far end) with an
# expression pedal or an open jack, and low when that switch closes. A TS plug
# holds it low for as long as it is in, which firmware treats as a switch that
# never moves. v2 boards get the same thing with a wire from each jack's ring
# pin to the J22 pads these GPIO used to be on.
#
# The jack is a Neutrik NJ6FD-V (v3), rear-mounted through a 12 mm aperture, with
# SWITCHING contacts. Its ring-normal contact (RN) is tied to the ring while the
# jack is empty and opens when a plug goes in, which gives the board a
# presence wire per jack: with the ring at 3V3 through its 1k, RN reads high
# only while empty. That is what makes plugging in and out clean -- an empty
# jack no longer reads as a pedal at full toe, and a plug on its way in is
# ignored until it is seated -- without guessing from the ADC. Four leads to
# the jack: tip, ring, sleeve, RN. Using RN leaves the ADC tip unloaded when
# empty; the presence input's pull-down no longer divides the tip's 10k bias.
_ring_sense = []
_presence = []
for _ref, _net, _ring, _present in (("J20", ctrl1, ctrl1_ring, ctrl1_present),
                                    ("J21", ctrl2, ctrl2_ring, ctrl2_present)):
    j = jst(4, _ref, "CTRL_TRS_SW")
    j[1] += _net                               # tip   = wiper / switch
    # ONE 1k PER JACK, not one shared between them. Shared, a TS plug in either
    # jack -- which is the normal way to use a footswitch, and the exact case the
    # resistor exists for -- shorts ring to sleeve and drags the OTHER jack's pot
    # top to ground, so an expression pedal there reads a constant. Two pedals also
    # loaded each other's full scale. Separate resistors, separate nets.
    # Bias the pedal from the Pico's own 3V3 output. GPIO26/27 are standard
    # analogue pads, unlike the RP2350's failsafe digital pins: when AUX is off,
    # Pi-sourced bias would feed their protection clamps. Sharing the ADC's rail
    # also makes expression readings independent of the Pi regulator's tolerance.
    _ref_net = Net(_ref + "_REF")
    R("1k", ref="R7" if _ref == "J20" else "R9")[1, 2] += v3v3_pico, _ref_net
    j[2] += _ref_net                           # ring  = pot top, current-limited
    j[3] += gnd                                # sleeve
    R("10k", ref="R8" if _ref == "J20" else "R10")[1, 2] += v3v3_pico, _net
    C("10nF")[1, 2] += _net, gnd               # anti-alias / debounce
    # The ring-sense and presence resistors are declared with the other PINNED
    # refs further down (R19..R22): a pinned ref declared here, ahead of
    # auto-numbered parts, collides with SKiDL's counter and gets renamed.
    _ring_sense.append((_ref_net, _ring))
    _rn = Net(_ref + "_RN")
    j[4] += _rn                                # ring-normal: closed while empty
    _presence.append((_rn, _present))

# ---- J6/J7: the ring-board link and the indicator chain ---------------------
# J6 is the console end of the ring board's link (#987): the ring board carries a
# XIAO RP2350 that owns the encoder and clocks its own WS2812s, so what crosses
# the ~600 mm of box is +5V, GND and a full-duplex UART pair. Four conductors.
#
# v2's J6 was the fabbed 8-way with four positions left empty, which made the
# cable asymmetric -- crimped 1:1 it put the LED rail on a Pico input. v3 is new
# copper, so J6 is a 4-way and the cable is 1:1 with ring_board.py's J1 by
# position. RING_PINMAP still exists because RING_CONTRACT gates the two
# netlists against each other through it; on v3 it is the identity, and the
# gate proves that it is.
#
# GND is the second pin, between +5V and the pair, on both ends: the LED return
# is a pulsed amp-scale current and should not run beside a link line.
RING_NET = os.path.join(HERE, "ring_board.net")
RING_ALIASES = {          # ring_board.py's name -> this board's name
    "+5V_LED": "+5V",     # that board still declares its own single supply locally
}
# ring_board.py J1 pin -> this board's J6 pin. Identity on v3; kept as a map so
# the contract check reads the same whichever end is edited.
RING_PINMAP = {1: 1, 2: 2, 3: 3, 4: 4}
j_ring = jst(4, "J6", "RING_LINK")
j_ring[1] += v5
j_ring[2] += gnd
# Both UART owners run from AUX, so their idle pull-ups use the Pico's 3V3.
# Pi soft-off or an absent ribbon must not pull their undriven link low.
# GP13/GP14 are fail-safe digital pads; the ring deliberately fits no second
# pull-up to its separate local rail. RING_LEVELS also rejects any ring-side
# part that would bias these link lines from the 5 V LED rail.
R("10k", ref="R11")[1, 2] += v3v3_pico, link_to_ring
R("10k", ref="R12")[1, 2] += v3v3_pico, link_to_console
j_ring[3] += link_to_ring
j_ring[4] += link_to_console

# No J7 since #1062: the pills' connector is J24, beside J3 (see there). J7 fed
# the pills 5 V through the board's 0.6 mm +5V track from J3 -- ~2 A of copper
# against 4.8 A of pills at full white.

# ---- J8: rear power button -- passed STRAIGHT through to the Pi's PWR pads ---
# Not via the MCU: a clean shutdown has to work when the MCU is wedged or
# mid-reflash, which is exactly when it is wanted. And not via a GPIO either --
# see the next block; on a Pi 5 no GPIO can do this job.
j_btn = jst(2, "J8", "PWR_BTN")
j_btn[1] += pwr_btn
j_btn[2] += pwr_btn_ret

# ...and passed straight through to the Pi 5's own power-button pads. On a Pi 5 an
# external button cannot be a GPIO: RP1 and the SoC are unpowered until the PMIC
# brings them up, so nothing on the 40-way can wake the machine. Raspberry Pi break
# the function out as two solder pads (J2, beside the RTC battery connector) and
# that is the only thing that works. This header is a 2-pin flying lead to them.
#
# A FLOATING PAIR, not a signal and GND (#1062). J8 and J9 are wired pin to pin
# and neither pin touches this board's ground, so the board is only a junction on
# a two-wire button lead. With pin 2 on GND, a lead soldered to the Pi's J2 pads
# the wrong way round held the button pad at ground forever -- the Pi reads that
# as a button that never lets go. Floating, the button shorts the two pads together
# whichever way the lead is fitted, exactly as a button wired straight to the Pi
# would; the Pi's own ground pad is still the reference. Nothing here reads the
# button, so ground bought nothing.
j_pi_btn = jst(2, "J9", "PI_PWR_PADS")
j_pi_btn[1] += pwr_btn
j_pi_btn[2] += pwr_btn_ret

# ---- SWD: straight onto the module's own debug pads, no connector -----------
# The THT footprint does not carry the debug pads, so v1 of this board broke SWD
# out to a 3-pin header (J9) and three flying wires. The SMD_HandSolder footprint
# DOES carry them -- its description is "surface-mount footprint with debug pads
# for hand soldering, supports Raspberry Pi Pico 2 (non-W)" -- as pads D1/D2/D3
# along the module's bottom edge. So the header, its wires and the space it took
# in the crowded right-hand column all go away.
#
# The trade: the module is now soldered down via its castellations rather than
# sitting on headers, so it is not swappable without a hot-air station. For a
# sealed console that is reflashed over SWD anyway, that is the right way round.
SWD_PADS = {"D1": swclk, "D2": gnd, "D3": swdio}
for _pad, _net in SWD_PADS.items():
    pico[_pad] += _net

# ---- J22: expansion -- the three GPIO that are otherwise doing nothing ------
# Deliberately unpopulated by default. GP28 is an ADC, so it can carry a third
# pedal input; GP15 is a plain digital pin. Nothing on the board depends on it.
# Pin 3 is unconnected since GP12 became SW_MODE (#1388; why GP5 does not take
# it is under SPARE_GPIO). The GPIO pins keep their v3 positions, so the header
# and its copper are otherwise unchanged; on a reworked v3 board pin 3 carries
# MODE, which is why it is not reused for anything else.
# v2's J22 carried GP19/GP20/GP21/GP22 instead: GP20/21 became the CTRL rings'
# sense lines and GP19/22 the jacks' presence lines, and a pin that is also a
# jack contact has no business on a header.
EXP_PINOUT = ["+3V3", "+5V", "NC", "GP15", "GP28", "GND"]
j_exp = Part("Connector_Generic", "Conn_02x03_Odd_Even",
             footprint="Connector_PinHeader_2.54mm:PinHeader_2x03_P2.54mm_Vertical",
             ref="J22", value="EXPANSION")
j_exp[1] += v3v3
j_exp[2] += v5
for _i, _label in enumerate(EXP_PINOUT[2:-1], start=3):
    if _label == "NC":
        j_exp[_i].do_erc = False
        continue
    n = Net("EXP_" + _label)
    pico[PICO[int(_label[2:])]] += n
    j_exp[_i] += n
j_exp[6] += gnd

# ---- J23: I2C to the PD trigger -- is the contract really 20 V / 5 A? --------
# The STUSB4500 on the SparkFun trigger board is I2C-readable: its RDO
# (0x91..0x94) says what current the source actually granted and sets
# capaMismatch when it was less than the PDO asked for, and 0x21 holds the
# negotiated voltage. The failure this catches is SILENT otherwise: a 65 W brick
# grants 20 V at 3.25 A, everything boots, and the console only browns out
# when 26 WS2812s go white under two lit screens. (A trigger that fails to
# negotiate at all leaves VBUS at 5 V, the bucks never start, and nothing
# powers up -- that case diagnoses itself.)
#
# Three wires, not four: GND, SDA, SCL. SparkFun schematic v10 feeds its external
# VDD net through D4 (BAT60A) from STUSB4500 VREG_2V7. This is the low-voltage
# regulator node, not the chip's VDD pin on VIN/VBUS. Leave external VDD/Qwiic
# VCC unconnected: the two 2.2k I2C pull-ups use that local low-voltage node.
# No pull-ups are added here. ~250 mm of
# unshielded run past two bucks: 100 kHz, twisted with the ground wire.
# Firmware reads it and reports it up the pedal link; until it does, the header
# is just a header.
j_pd = jst(3, "J23", "PD_I2C")
j_pd[1] += gnd
j_pd[2] += pd_sda
j_pd[3] += pd_scl

# ---- H1..H4: the mounting holes, which are a CIRCUIT, not just geometry ------
# They used to be bare NPTH -- no copper -- so the board floated inside an earthed
# metal chassis. That was never a decision; it was the default footprint. And the
# board does not float in practice anyway: two USB 3.0 panel couplers, two DIN-5
# chassis sockets and two D-series TRS jacks all bolt metal flanges through a metal
# panel, and the TRS sleeves ARE this board's GND. The choice is not whether the
# board touches the chassis, only whether it does so through a defined, short path
# or through whichever connector flange happens to have the best contact.
#
# So: ONE hard bond, at the corner nearest the rear-panel loom and diagonally away
# from the Pi ribbon. The other three holes get the same PLATED PAD and nothing
# else -- isolated copper, touching only their standoff.
#
# There are no components on those three. An earlier cut fitted each with a 10 nF
# 2 kV cap and a 1 M bleeder, DNF, so EMC testing could add an RF bond without a DC
# loop. The idea is sound and the parts were wrong: nothing fits those corners in
# through-hole, so they were SMD -- six surface-mount parts on a board that is
# hand-soldered through-hole on purpose, for a bond that may never be wanted. If it
# ever is, the pad is there and a leaded cap solders from it to the nearest ground
# via, which is a bench job on one board rather than a BOM line on every board.
CHASSIS_BOND_HOLE = "H1"
MOUNT_HOLES = ("H1", "H2", "H3", "H4")
MOUNT_FP = "MountingHole:MountingHole_3.2mm_M3_Pad"   # 6.4 mm pad, bare on BOTH
                                                      # faces: screw head above,
                                                      # standoff below
holes = {}          # ref -> the hole part, so the gate reads the PART, not a search
for _h in MOUNT_HOLES:
    _hole = Part("Mechanical", "MountingHole_Pad", ref=_h, footprint=MOUNT_FP,
                 value="M3 CHASSIS" if _h == CHASSIS_BOND_HOLE else "M3")
    holes[_h] = _hole
    if _h == CHASSIS_BOND_HOLE:
        _hole[1] += gnd
        continue
    # Deliberately connected to nothing. Named like the other exemptions on this
    # board rather than tolerated as a warning in the log.
    _iso = Net("CHASSIS_%s" % _h)
    _iso.do_erc = False          # isolated on purpose: a pad for a standoff, not a
    _hole[1] += _iso             # signal. A wall of expected warnings is how a real
    _hole[1].do_erc = False      # one gets missed -- see the SPARE_GPIO note above

# ---- J3: power in, 5 V from the external potted buck ------------------------
# JST VH, 10 A with 16 AWG: 7.2 A full-white LEDs plus controller current.
# It used to be a 4-way XH with pins doubled up, ~6 A, when the chain was 26 LEDs.
# No series Schottky: V1's guards a barrel jack a user can plug anything into;
# this is a keyed internal JST, and a diode would burn ~0.4 W of LED headroom.
j_pwr = jst_vh(2, "J3", "5V_IN")
j_pwr[1] += v5
j_pwr[2] += gnd

# ---- J24: the pills -- 5 V, data and GND on one header ----------------------
# JST VH stacked under J3 (#1062), so the pills' 4.8 A crosses a few millimetres of
# poured copper instead of the board, and the pill harness is one cable. +5V is
# pin 3 because pin 3 is the one beside J3's +5V pad: the bar between them stays
# a straight link, and data and GND are left free to route. (Pin 1 = +5V would
# put the bar round both of them and box the data pad in.) The 3-way plug cannot
# be confused with J3's 2-way, so the pin order differing from J3's is safe.
# The data line reaches here from U1 across the board, ~75 mm: an 800 kHz WS2812
# line driven through R2 at the buffer end, which is fine at that length.
# The harness from here is a 5 V bus with a tap to each pill: 4.8 A cannot run
# through the strips in series.
j_pill = jst_vh(3, "J24", "PILLS")
j_pill[1] += gnd
j_pill[2] += ind_out
j_pill[3] += v5
# The voltage AND the ESR grade are part of the VALUE because the value is what
# the BOM prints, and both are load-bearing at purchase time: a common 16 V 470uF
# is 8 x 11.5 mm on 3.5 mm pitch and does not fit this 10 mm / 5 mm land (25 V is
# the rating whose can matches -- see the C_FP note above), and a general-purpose
# 470uF/25V ships in the IDENTICAL can at ~0.5 ohm ESR -- which, against the
# WS2812 chain's amp-scale frame-edge steps, puts ~0.5-1 V of excursion on the
# shared 5 V rail the AHCT (VCC min 4.5 V) also lives on. Low-ESR is the spec,
# bounded so a buyer can check it. ring_board.py's C1 carries the same rule.
CP("470uF 25V low-ESR <=0.15R", "Capacitor_THT:CP_Radial_D10.0mm_P5.00mm",
   ref="C30")[1, 2] += v5, gnd
CP("100uF 16V", "Capacitor_THT:CP_Radial_D6.3mm_P2.50mm", ref="C31")[1, 2] += v5, gnd

# ---- R14..R18: the review-fix resistors (idle states + the power-domain seam)
# Declared HERE, after the last auto-numbered part, with pinned refs. Declaring
# them mid-file bumped SKiDL's counter past 16, the CTRL and encoder resistors
# renumbered themselves, and the pinned "R17" collided into an R17_1 -- exactly
# the renumbering the ref-block note at the top exists to prevent.
#
# R14..R16 are idle-state resistors for U1's inputs -- all three pull DOWN.
# CMOS inputs must never float while the package is powered, and each input has a
# state where its driver is gone. Uniform pull-downs make every such state a
# DETERMINISTIC low; the first cut pulled MIDI_TX up to +5V instead, and review
# proved that wrong twice over on the same net:
#   * A 5 V pull-up can exceed the unpowered RP1 pad's 3.63 V fail-safe ceiling
#     when the Pi is off and this board remains on BUCK_AUX.
#   * At every boot, RP1's default ~50k pull-down on GPIO14 divides against a
#     100k-to-5V to ~1.7 V -- mid-threshold on a hysteresis-free input, i.e. the
#     chatter the resistor was added to kill, in a window that used to be a clean
#     solid low. No resistor pair fixes this by level (the divider constraints
#     for high-at-soft-off and low-when-driven exclude each other).
# So MIDI_TX pulls DOWN, and the consequence is ACCEPTED and stated: in every
# undriven window (soft-off, boot, an image without the uart0 overlay) gate C
# drives the MIDI OUT loop low = a standing MIDI break, ~5-6 mA through an
# attached synth's opto -- harmless to any compliant receiver, byte-free, and
# deterministic. True no-current idle at soft-off would take a FET inverter
# qualifying gate C's /OE with 3V3-presence; take that only if a real device in
# the field objects to break.
#   * IND_DATA (and RING_DATA, until #987): the pull-down covers the states where
#     the module is absent or unprogrammed (bench bring-up, a bare board). During SWD reset
#     the RP2350 already holds its pads LOW itself -- PADS_BANK0 resets with the
#     pull-down enabled and the input isolated, so the lines never actually
#     float in reset; the external 100k is a same-direction backstop, not the
#     thing preventing a mid-flash light show. A low data line is the WS2812
#     latch state: the chain holds its last frame.
R("100k", ref="R14")[1, 2] += midi_tx, gnd
R("100k", ref="R16")[1, 2] += ind_data, gnd

# R17/R18 cross the Pi/AUX power domains. RP1 and the Pico's digital GP16/17
# are 3.3 V-failsafe when unpowered; do not assume a forward supply-clamp path
# or infer Pi-off from a supposed clamp-induced UART break. Series resistance
# still limits fault current and damps the short ribbon connection.
#
# R18 must be lower than R17: RP2350 A2 erratum E9 requires a low-driving source
# of 8.2 kOhm or less to overcome input-buffer sourcing leakage. Hardware UART
# RX keeps its input buffer enabled, so the sampled CTRL-presence workaround
# cannot repair this path. 6.8k at 1% is at most 6.868k, leaving 1.332k for the
# Pi output and interconnect. The documented Arduino-Pico UART setup does not
# enable a pull-up on GP17. R17 remains 10k because it drives the Pi receiver.
# https://datasheets.raspberrypi.com/rp2350/rp2350-datasheet.pdf (RP2350-E9)
# https://datasheets.raspberrypi.com/rp1/rp1-peripherals.pdf (3.1.3 Pads)
#
# Even an entire 3.63 V fault across R18 at its -1% limit gives only 0.539 mA;
# this is a resistor-current bound, not a published clamp-injection rating.
# At 115200 baud, 20-50 pF gives 0.14-0.34 us RC on RX and 0.2-0.5 us on TX,
# against an 8.7 us bit. A baud change needs a fresh timing assessment.
# SWCLK/SWDIO remain direct digital fail-safe pads; no series parts are added.
R("10k", ref="R17")[1, 2] += link_tx, link_tx_pi
R("6.8k", ref="R18")[1, 2] += link_rx_pi, link_rx

# CTRL ring sense (see J20/J21 above), through 4.7k. Not a bare trace: the ring
# is a panel jack, so a plug can expose it to transients. The ring bias now
# follows the Pico's own 3V3, and the resistor limits current into the sense pin. 4.7k against the RP2350's internal pull-up (32-86k,
# which firmware enables so an unwired v2 pin reads open) still divides a closed
# switch below 0.5 V including resistor tolerance, a clean low. Pinned: the soldering guide names them.
for _ref, (_ref_net, _ring) in zip(("R19", "R20"), _ring_sense):
    R("4.7k", ref=_ref)[1, 2] += _ref_net, _ring
# Presence, through the same 4.7k for the same reasons: the ring-normal contact
# is the jack's own metal, and while the jack is empty it is the ring node.
# When inserted, RN opens; runtime #1082 disables IE between short samples and
# discharges the pad at setup to handle A2 E9. The weak pull-down alone cannot
# guarantee low with the input buffer continuously enabled.
for _ref, (_rn, _present) in zip(("R21", "R22"), _presence):
    R("4.7k", ref=_ref)[1, 2] += _rn, _present

# Footswitch input protection (#1391; the circuit and its timing are under
# J10..J19 above). Pinned like every other resistor here, R23..R32 in FSW_ORDER,
# the order J10..J19 and C1..C10 already follow: J13, C4 and R26 are MODE's.
#
# SURFACE-MOUNT, on the back, and the only SMD parts on the board with D2..D6.
# The front has no room for twenty more parts at the 9.33 mm footswitch pitch;
# the back of the strip between each debounce cap and its header is empty, and
# that is exactly where "cap pin 1 -- 1k -- header pin 1" runs (placement in
# console_board_pcb.py). 1206 on hand-solder pads: the easiest SMD size to fit
# with an iron. It carries microamps in use and ~15 mA at worst in a fault.
FSW_SERIES = "1k"
FSW_SERIES_FP = "Resistor_SMD:R_1206_3216Metric_Pad1.30x1.75mm_HandSolder"
FSW_SERIES_REFS = {_n: "R%d" % (23 + _i) for _i, _n in enumerate(FSW_ORDER)}
fsw_series = {}
for _name in FSW_ORDER:
    fsw_series[_name] = R(FSW_SERIES, fp=FSW_SERIES_FP, ref=FSW_SERIES_REFS[_name])
    fsw_series[_name][1, 2] += sw_ext[_name], sw_nets[_name]

# The clamps. One dual part serves two inputs that are NEIGHBOURS ON THE BOARD,
# so they pair in Pico pad order, which is the header order the CROSSING gate in
# console_board_pcb.py enforces: REC+STOP, UNDO+TRK1, TRK2+TRK3, TRK4+CLR and
# BANK+MODE. Each sits on the bottom side between its two headers.
#
# The datasheet values the FSW_PROTECT gate reasons from, keyed by the part value
# the BOM prints. Nexperia PESD5V2S2UT (SOT-23, pin 1 K1, pin 2 K2, pin 3 common
# anode): VRWM 5.2 V, IRM 1 uA max at VRWM, V(CL) 20 V at 18 A (8/20 us), IEC
# 61000-4-2 level 4. Only parts that pass the gate belong here; the self-test
# brings its own leaky counter-example.
TVS_SPECS = {
    "PESD5V2S2UT": {"vrwm": 5.2, "irm": 1e-6, "vcl": 20.0},
}
FSW_TVS = "PESD5V2S2UT"
FSW_BY_PAD = sorted(FSW_ORDER, key=lambda _n: PICO[GPIO["SW_" + _n]])
TVS_PAIRS = list(zip(FSW_BY_PAD[0::2], FSW_BY_PAD[1::2]))
fsw_tvs = {}       # name -> the clamp part protecting it
for _k, (_a, _b) in enumerate(TVS_PAIRS):
    _d = Part("Device", "D_Dual_CommonAnode_KKA", value=FSW_TVS,
              footprint="Package_TO_SOT_SMD:SOT-23_Handsoldering",
              ref="D%d" % (2 + _k))
    _d[1] += sw_ext[_a]
    _d[2] += sw_ext[_b]
    _d[3] += gnd
    fsw_tvs[_a] = fsw_tvs[_b] = _d

# ---- J2: the Pi ribbon (2x20, SHROUDED and KEYED) ---------------------------
# Reversed, a 2x20 puts 5 V onto GND pins -- specify a shrouded header with a
# polarising notch and a keyed IDC socket. Cheapest mistake on the board to
# design out. Only 16 of the 40 ways carry anything -- 3V3 x2, GND x8 and six
# signals; the rest are the Pi's own
# pins and are left alone.
#   Pi pin 2,4  = 5V  -- DELIBERATELY NOT CONNECTED. Tying them to +5V puts the
#                        external buck in hard parallel with the Pi 5's own PMIC
#                        rail, with no ORing diode: whichever regulator sits higher
#                        back-feeds the other, bypassing the Pi's input protection.
#                        It also lands the whole WS2812 load on the Pi's 5 V header
#                        pin, which segno_console_shopping_list.md explicitly
#                        forbids. The Pi is powered from its own supply; this board
#                        is powered from J3. They share only GND and 3V3.
#                            1,17 = 3V3      6,9,14,20,25,30,34,39 = GND
#   Pi pin 8    = GPIO14 TXD (uart0)        10 = GPIO15 RXD (uart0)
#   Pi pin 24   = GPIO8  (uart3 TX)         21 = GPIO9    (uart3 RX)
#                        Firmware wants `dtoverlay=uart3-pi5` -- "Enable uart 3 on
#                        GPIOs 8-9. Pi 5 only." (raspberrypi/linux overlays README).
#                        NOT portable to a Pi 4, where GPIO8-9 is uart4. Mid-header
#                        on purpose; see PI_RESERVED.
#   Pi pin 5    = GPIO3  -- NOT the power button. GPIO3 wakes a Pi 4; on a Pi 5 the
#                           GPIO lives behind RP1 and power-on is the PMIC's job, so
#                           no GPIO can wake it. The Pi 5's button goes on the J2
#                           solder pads by the RTC connector -- hence J9 below.
#   Pi pin 18   = GPIO24 SWCLK              22 = GPIO25 SWDIO
# Physical pins that something ELSE on this Pi has already claimed. The console
# does not have a bare Pi: a GeeekPi N07 NVMe board lives under it, and it takes
# GPIO4 (pin 7) along with 5 V and grounds. Sharing a RAIL with it is fine -- rails
# are shared by definition -- so only SIGNAL pins are reserved here.
#
# The link UART sat on pin 7 until this was noticed, which would have been a board
# that assembles, passes every gate, and cannot talk to its own MCU.
# ...and the reading is POSITIONAL, so it could be counted from either end of the
# header. Taken from the near end it is pins 2/4/6 + 7/9; mirrored, it lands on
# 39/37/35 + 34/32. Both ends are therefore suspect until a meter says otherwise,
# which is why the link sits in the MIDDLE of the header now rather than at either
# end -- a choice that is right under both readings and costs nothing.
PI_RESERVED = {
    7: "GeeekPi N07 NVMe board (GPIO4), as observed from the near end",
    32: "possible N07 contact if the observation is counted from the far end",
    33: "possible N07 contact if the observation is counted from the far end",
}
# MIDI KEEPS GPIO14/15 (uart0, pins 8/10), by decision, even though they appear on
# the list of pins the NVMe module may want. There is nowhere else worth going: a
# Pi 5 has five hardware UART pairs, and once GPIO4/5, GPIO12/13 and GPIO14/15 are
# excluded the only ones left are GPIO8/9 -- which the link already has -- and
# GPIO0/1, which the HAT+ spec reserves for the ID EEPROM. Moving MIDI onto the
# Pico instead would work and was considered, but it reverses a settled decision
# (#747: MIDI terminates on the Pi's UART, because the Pi runs the looper).
#
# So the resolution is the module, not the board: if the N07 turns out to claim
# GPIO14/15 as well, swap the NVMe board for a PCIe-only one. That is a shopping
# decision on a part that is not yet committed, versus a respin of a board that is.
# Do not re-open this in review.
PI_HDR = {
    1: v3v3, 17: v3v3,
    6: gnd, 9: gnd, 14: gnd, 20: gnd, 25: gnd, 30: gnd, 34: gnd, 39: gnd,
    8: midi_tx, 10: midi_rx,
    11: pi_gpio17,  # GPIO17 enables the separate screen-power board
    # LINK sits MID-HEADER, on `dtoverlay=uart3-pi5` -- "Enable uart 3 on GPIOs 8-9.
    # Pi 5 only." Physical pins 24 and 21 are positions 11 and 12 of their rows, as
    # far from both ends as this header gets.
    #
    # It has moved twice. GPIO4/5 (uart2) was where the N07 was observed. GPIO12/13
    # (uart4) dodged that but sits at the FAR end -- and the observation was a count
    # of positions, which reads the same from either end, so the far end was no safer
    # than the near one. The middle is safe under both readings.
    #
    # GPIO8/9 are SPI0's CE0 and MISO. Nothing here uses SPI0: the screens are USB
    # and HDMI, the SSD is PCIe, and MIDI and the link are UARTs. If an SPI device
    # ever lands on this Pi, this is the pair it will want.
    24: link_rx_pi,  # GPIO8, uart3 TX -> R18 -> Pico RX  (3V3 -> 3V3, via 6.8 k)
    21: link_tx_pi,  # GPIO9, uart3 RX <- R17 <- Pico TX  (3V3 -> 3V3, via 10 k)
    18: swclk, 22: swdio,
}
j_pi = Part("Connector_Generic", "Conn_02x20_Odd_Even",
            footprint="Connector_IDC:IDC-Header_2x20_P2.54mm_Vertical",
            ref="J2", value="PI_RIBBON")
for _pin in range(1, 41):
    if _pin in PI_HDR:
        j_pi[_pin] += PI_HDR[_pin]
    else:
        j_pi[_pin].do_erc = False

# Control only: the daughterboard takes its power directly from BUCK_AUX.
# Its input series resistor and pull-down keep both screens off by default.
j_screen = jst(2, "J25", "SCREEN_ENABLE")
j_screen[1] += pi_gpio17
j_screen[2] += gnd

# ---- gates ------------------------------------------------------------------

STATION_HEADERS = {          # rear-panel station -> the header that terminates it
    "POWER": "J8", "MIDI_IN": "J5", "MIDI_OUT": "J4",
    "CTRL_1": "J20", "CTRL_2": "J21",
}
STATION_NOT_ON_BOARD = {     # ...and the ones that deliberately never touch it
    "PD_IN": "USB-C PD inlet (#754): one 20 V contract feeds the console and TWO "
             "bucks make 5 V at the load. J3 takes 5 V from BUCK_AUX",
    "FUSE": "in series with the 20 V input, upstream of everything here",
    "USB3_1": "passes through to a Pi USB port",
    "USB3_2": "passes through to a Pi USB port",
}


def _value_si(value, unit):
    """'1k' -> 1000.0, '100nF' -> 1e-07, '6.8k' -> 6800.0."""
    m = re.fullmatch(r"([0-9]+(?:\.[0-9]+)?)([pnumkM]?)" + unit + "?", str(value))
    assert m, f"VALUE: cannot read {value!r} as a {unit} value"
    scale = {"p": 1e-12, "n": 1e-9, "u": 1e-6, "m": 1e-3, "": 1.0, "k": 1e3, "M": 1e6}
    return float(m[1]) * scale[m[2]]


def _check(strict_stations=True):
    """Prove the pin budget and the connector set before any copper is laid."""
    used = {}
    for name, gp in GPIO.items():
        assert gp in PICO, f"PIN_MAP: {name} -> GP{gp} is not on the module header"
        assert gp not in used, f"PIN_MAP: GP{gp} is assigned to both {used[gp]} and {name}"
        used[gp] = name
    for gp in EXPANSION_GPIO:
        assert gp in PICO, f"PIN_MAP: expansion GP{gp} is not on the module header"
        assert gp not in used, (
            f"PIN_MAP: GP{gp} is on the expansion header AND used by {used[gp]} -- "
            "the header would fight the on-board function for the pin")
        used[gp] = "J22 expansion"
    # LINK must be a real hardware UART pair on ONE instance -- GP16 TX with GP29 RX
    # looks fine in a pin list and is two different UARTs.
    assert any(GPIO["LINK_TX"] in tx and GPIO["LINK_RX"] in rx
               for tx, rx in UART_PINS.values()), (
        f"LINK_UART: GP{GPIO['LINK_TX']}/GP{GPIO['LINK_RX']} is not a TX/RX pair on "
        f"one UART instance -- valid pairs are {UART_PINS}")

    # Check electrical limits, not just a remembered BOM value: increasing R18
    # revives A2 E9; reducing it too far loses the retained 1 mA fault bound.
    _rx_series = next((p for p in default_circuit.parts if p.ref == "R18"), None)
    assert _rx_series is not None, "LINK_RX_DRIVE: R18 is missing"
    _rx_ohms = _value_si(_rx_series.value, "R")
    assert _rx_ohms * 1.01 <= 8200, (
        "LINK_RX_DRIVE: R18 exceeds RP2350 A2 E9's 8.2 kOhm low-drive limit")
    assert _rx_ohms > 0 and 3.63 / (_rx_ohms * 0.99) <= 0.001, (
        "LINK_RX_DRIVE: R18 exceeds the retained 1 mA rail-difference fault bound")

    assert any(GPIO["PD_SDA"] in sda and GPIO["PD_SCL"] in scl
               for sda, scl in I2C_PINS.values()), (
        f"PD_I2C: GP{GPIO['PD_SDA']}/GP{GPIO['PD_SCL']} is not an SDA/SCL pair on "
        f"one I2C instance -- valid pairs are {I2C_PINS}")

    for name, gp in GPIO.items():
        # Only a TIP reads a voltage; a ring is a switch or nothing, and burning an
        # ADC pin on one would leave no third pedal input for J22.
        if name.startswith("CTRL") and name.endswith("_TIP"):
            assert gp in ADC_GPIO, (
                f"PIN_MAP: {name} needs an ADC pin so an expression pedal reads as a "
                f"voltage, but GP{gp} is not one of {ADC_GPIO}")
        else:
            assert gp not in ADC_GPIO, (
                f"PIN_MAP: {name} squats on ADC pin GP{gp}; only {len(ADC_GPIO)} exist "
                "and CTRL needs two")
    for gp in SPARE_GPIO:
        assert gp not in used, (
            f"PIN_MAP: GP{gp} is listed as spare but {used[gp]} uses it -- an ERC "
            "exemption on a live pin hides a real unconnected-pin warning")
    assert len(FSW_ORDER) == 10, f"PIN_MAP: {len(FSW_ORDER)} footswitches, expected 10"

    # ...and both ends of a connector's signal group must sit in the same pad row,
    # or the connector cannot be placed near all of them. Row A is pads 1..20.
    for group in (("LINK_TX", "LINK_RX"),
                  ("LINK_TO_RING", "LINK_TO_CONSOLE"),
                  ("PD_SDA", "PD_SCL"),
                  ("CTRL1_PRESENT", "CTRL2_PRESENT"),
                  tuple("SW_" + n for n in FSW_ORDER)):
        rows = {PICO[GPIO[n]] <= 20 for n in group if n in GPIO}
        assert len(rows) == 1, (
            f"PAD_ROW: {group} straddles both pad rows of the module "
            f"({ {n: PICO[GPIO[n]] for n in group if n in GPIO} }) -- one connector "
            "carries them all, so it would have to reach around the module")
    # J22 is allowed to straddle the rows since v3: it sits above the module's
    # middle, where row A's GP5/GP15 (pads 7/20) and row B's GP28 (pad 34) are
    # all within a hop, and HOP in console_board_pcb.py is the gate that proves
    # it. What is still refused is a pin at either far END of the module, which
    # no single header position can reach along with the rest.
    _along = [PICO[gp] if PICO[gp] <= 20 else 41 - PICO[gp] for gp in EXPANSION_GPIO]
    assert max(_along) - min(_along) <= 14, (
        f"PAD_ROW: J22's pins span {max(_along) - min(_along)} pad pitches along "
        f"the module ({ {gp: PICO[gp] for gp in EXPANSION_GPIO} }) -- one header "
        "cannot sit near all of them")

    # The two ends of the ring cable, compared against each other. This used to
    # assert a literal list against itself and never open ring_board.py at all,
    # while its message claimed it had -- so the day that board's encoder pull-ups
    # were deleted, nothing was watching the interface they sat on. The other end
    # is now READ.
    assert os.path.exists(RING_NET), (
        f"RING_CONTRACT: {RING_NET} is missing -- run ring_board.py; the other end "
        "of the ring cable is what J6 is checked against")
    # One parse serves both ring gates -- RING_CONTRACT and RING_LEVELS reason
    # from the same snapshot of the file, and pin_map()'s second parse goes away.
    # Pin keys are normalised (a future exporter writing "01" must not pass the
    # 1..8 guard and then KeyError three lines later), and a pin on two nets is
    # a broken netlist, said so instead of last-wins.
    _ring_comps, _ring_nets = netlist.parse_netlist(RING_NET)
    ring_j1 = {}
    for _n, _nodes in _ring_nets.items():
        for _r, _p in _nodes:
            if _r != "J1":
                continue
            assert str(_p).strip().isdigit(), (
                f"RING_CONTRACT: ring_board J1 pin {_p!r} is not numeric")
            _key = str(int(_p))
            assert _key not in ring_j1, (
                f"RING_CONTRACT: ring_board J1 pin {_key} appears on two nets "
                f"({ring_j1[_key]} and {_n}) -- the netlist is broken")
            ring_j1[_key] = _n
    # RING_PINMAP is the map between the two ends; this gate is what stops it
    # drifting from either netlist. Both directions are asserted: every ring pin
    # must appear in the map (a conductor added at the ring end with no console
    # pin to land on is a build error, not a silent extra), and every mapped J6
    # pin must be one this board actually has. On v3 the map is the identity and
    # the cable is symmetric; the gate is what makes that a checked fact.
    assert sorted(int(p) for p in ring_j1) == sorted(RING_PINMAP), (
        f"RING_CONTRACT: ring_board J1 has pins {sorted(int(p) for p in ring_j1)}, "
        f"but RING_PINMAP describes {sorted(RING_PINMAP)} -- the two ends of the "
        "cable disagree on how many conductors it has")
    for _r_pin, _c_pin in sorted(RING_PINMAP.items()):
        assert 1 <= _c_pin <= 4, (
            f"RING_CONTRACT: RING_PINMAP sends ring pin {_r_pin} to J6 pin "
            f"{_c_pin}, which is not one of J6's 4 ways")
        _want = ring_j1[str(_r_pin)]
        _want = RING_ALIASES.get(_want, _want)
        got = {n.name for n in j_ring[_c_pin].nets}
        assert _want in got, (
            f"RING_CONTRACT: ring_board J1 pin {_r_pin} carries {_want}, but the "
            f"J6 pin it maps to ({_c_pin}) carries {got} -- these are the two ends "
            "of one conductor, so a pin that means different things at each end "
            "puts the LED rail on a Pico GPIO")
    # Symmetric by construction: a cable crimped 1:1 by position must be right.
    # v2's asymmetric map is what put the LED rail one mis-crimp from a GPIO.
    assert all(_r == _c for _r, _c in RING_PINMAP.items()), (
        f"RING_CONTRACT: RING_PINMAP {RING_PINMAP} is not the identity -- the "
        "ring cable is 1:1 by position on v3; change both connectors, not the map")

    # ...and nothing on the ring board may pull an encoder line to its 5 V rail.
    # This is the RESISTIVE version of PICO_LEVELS, and it exists because no other
    # gate can see the shape: PICO_LEVELS and PI_LEVELS check nets that TOUCH 5 V
    # directly, and a pull-up bridges two nets through a part, keeping them
    # separate -- which is exactly the historical failure (ring_board's 10k to 5 V
    # on GP13/GP14, 1.4 V over the RP2350's 3.6 V absolute maximum). RING_CONTRACT
    # cannot see it either: adding a pull-up changes no pin's net, so the
    # positional map stays green. Hardenings from review, each closing a way the
    # gate could go quietly blind:
    #   * the rail is read off J1 pin 1 rather than named (a renamed rail cannot
    #     retire the check);
    #   * the watched pins are DERIVED from which J6 positions carry a Pico-input
    #     net, not hardcoded -- a coordinated cable re-pin (which RING_CONTRACT
    #     permits by design) moves the watch with it;
    #   * the rule needs NO classification: any TWO-PIN part bridging the rail
    #     to such a line delivers the rail's DC to a Pico input, whatever it
    #     calls itself -- resistor, 0R jumper, ferrite bead, capacitor. Judging
    #     by footprint lib or value string failed open on custom libs and
    #     suffixed values; a connected-pin count from the netlist cannot. J1
    #     and the encoder are exempt by arithmetic, not by name.
    #
    # #987 CHANGED WHAT IT WATCHES, not why. The encoder no longer crosses this
    # cable -- it is local to the ring board now, pulled up to that board's own
    # MCU's 3V3 -- so the original three lines are gone. What is left crossing
    # into a Pico input is the link pair, and it is exposed to exactly the same
    # mistake: one 10k to the ring board's 5 V rail "to make the link idle high"
    # would put 5 V on GP13. The pull-up that line actually runs on is on THIS
    # board (J6 pins 3/4, above), at the rail GP13 belongs to.
    _rail = ring_j1["1"]
    _rail_refs = {r for r, _p in _ring_nets.get(_rail, [])}
    _node_count = {}
    for _n, _nodes in _ring_nets.items():
        for _r, _p in _nodes:
            _node_count[_r] = _node_count.get(_r, 0) + 1
    # Every conductor whose console end lands on a bare Pico GPIO. Derived from
    # the console-side nets and RING_PINMAP so it tracks a re-pin; today that is
    # the link pair, but the set is computed, not assumed to stay a fixed size.
    _pico_input_nets = {"LINK_TO_RING", "LINK_TO_CONSOLE"}
    _watched = [_p for _p in ring_j1
                if {n.name for n in j_ring[RING_PINMAP[int(_p)]].nets}
                & _pico_input_nets]
    assert _watched, (
        "RING_LEVELS: no ring conductor lands on a bare Pico GPIO -- the "
        "derivation from the console-side nets has come apart, and this gate is "
        "now watching nothing while still reporting green")
    for _pin in _watched:
        _sig = ring_j1[_pin]
        for _ref, _pad in _ring_nets.get(_sig, []):
            assert not (_ref in _rail_refs and _node_count.get(_ref, 0) <= 2), (
                f"RING_LEVELS: {_ref} on ring_board bridges {_sig} (J1 pin {_pin}) "
                f"to {_rail} -- a two-pin part from the LED rail to a line that "
                "reaches a Pico input puts 5 V on a pin whose absolute maximum is "
                "3.6 V, and no direct-contact gate can see the path")

    assert len(EXP_PINOUT) == 6 \
        and EXP_PINOUT[:2] == ["+3V3", "+5V"] and EXP_PINOUT[-1] == "GND", (
            "EXPANSION: J22 must keep power on pins 1/2 and ground on its last pin "
            "-- the pinout is silkscreened and anything plugged in trusts it")
    for _gp in EXPANSION_GPIO:
        assert _gp not in GPIO.values(), (
            f"EXPANSION: GP{_gp} is on J22 AND wired to something on the board -- a "
            "header pin that is also a jack contact is a short waiting for a plug")
    _exp_labels = [_l for _l in EXP_PINOUT[2:-1] if _l != "NC"]
    assert _exp_labels == ["GP%d" % _gp for _gp in EXPANSION_GPIO], (
        f"EXPANSION: J22 carries {_exp_labels} but EXPANSION_GPIO is "
        f"{EXPANSION_GPIO}")
    for _i, _label in enumerate(EXP_PINOUT, start=1):
        _nets = {n.name for n in j_exp[_i].nets}
        if _label == "NC":
            assert not _nets, f"EXPANSION: J22 pin {_i} is labelled NC but is on {_nets}"
        elif _label.startswith("GP"):
            assert _nets == {"EXP_" + _label}, (
                f"EXPANSION: J22 pin {_i} is labelled {_label} but is on {_nets}")

    # MIDI IN's clamp diode, by pin NAME. Reversed, the 1N4148 sits in parallel
    # with the opto's LED in the same direction, and its ~0.7 V forward drop shunts
    # the LED's ~1.4 V: almost no current reaches the phototransistor and MIDI IN is
    # dead. Nothing else on the board would notice -- ERC sees two connected pins
    # either way, and DRC sees copper. The trap is that Device:D is numbered K=1,
    # A=2, so the correct wiring reads backwards in the source.
    _led_a = {n.name for n in opto[1].nets}      # LED anode, fed via R5 from DIN 4
    _led_k = {n.name for n in opto[2].nets}      # LED cathode -> DIN 5
    _clamp_k = {n.name for n in d_clamp["K"].nets}
    _clamp_a = {n.name for n in d_clamp["A"].nets}
    assert _clamp_k == _led_a, (
        f"MIDI_CLAMP: D1's cathode is on {_clamp_k}, expected the opto's LED anode "
        f"{_led_a} -- a clamp in PARALLEL with the LED shunts it and MIDI IN "
        "receives nothing")
    assert _clamp_a == _led_k, (
        f"MIDI_CLAMP: D1's anode is on {_clamp_a}, expected the opto's LED cathode "
        f"{_led_k}")

    # FSW_PROTECT (#1391): every footswitch reaches its GPIO only through a series
    # resistor, with the clamp on the cable side and the debounce cap on the Pico
    # side, and the parts' own numbers keep the input readable. Read off the nets,
    # not off the loop that built them: a header wired straight to its GPIO again
    # passes ERC and DRC alike, and is the board that lost GP5.
    _rpu_min, _rpu_max = 32e3, 86e3     # RP2350 RPU at IOVDD 3.3 V (datasheet 14.9.4)
    _vil, _vih = 0.8, 2.0               # same table, IOVDD 3.3 V
    _iovdd_min, _iovdd_max = 3.135, 3.63
    _esd_s = 100e-9                     # an IEC 61000-4-2 pulse is over in ~100 ns
    for _name in FSW_ORDER:
        _j = fsw_jacks[_name]
        _gpio = pico[PICO[GPIO["SW_" + _name]]].nets
        _ext = _j[1].nets
        assert len(_gpio) == 1 and len(_ext) == 1, (
            f"FSW_PROTECT: {_j.ref} pin 1 or its GPIO is on {len(_ext)}/{len(_gpio)} nets")
        _gpio, _ext = _gpio[0], _ext[0]
        _ext_parts = {p.part for p in _ext.get_pins()}
        _gpio_parts = {p.part for p in _gpio.get_pins()}
        assert pico not in _ext_parts and _j not in _gpio_parts, (
            f"FSW_PROTECT: {_j.ref} pin 1 reaches GP{GPIO['SW_' + _name]} with no "
            "series resistor -- the cable lands on the bare pin, which is how GP5 died")
        _series = [p for p in _ext_parts & _gpio_parts if len(p.pins) == 2]
        assert len(_series) == 1 and _series[0].name == "R", (
            f"FSW_PROTECT: {_name} has {[p.ref for p in _series]} between its header "
            "and its GPIO, expected exactly one resistor")
        _r = _series[0]
        _caps = [p for p in _ext_parts | _gpio_parts if p.name == "C"]
        assert [c for c in _caps if c in _gpio_parts and c not in _ext_parts] == _caps \
            and len(_caps) == 1, (
                f"FSW_PROTECT: {_name}'s debounce cap {[c.ref for c in _caps]} must be "
                "one capacitor on the Pico side of the resistor -- on the cable side "
                "the pin sits behind 1k and its own few pF, and nothing filters the "
                "clamp's residual")
        _c = _caps[0]
        assert {n.name for pin in _c.pins for n in pin.nets} == {_gpio.name, "GND"}, (
            f"FSW_PROTECT: {_c.ref} is not from {_gpio.name} to GND")
        _clamps = [pin.part for pin in _ext.get_pins() if pin.name == "K"]
        assert len(_clamps) == 1 and len(_ext_parts) == 3, (
            f"FSW_PROTECT: {_name}'s cable side carries {sorted(p.ref for p in _ext_parts)}"
            ", expected only its header, its resistor and one clamp cathode")
        _d = _clamps[0]
        assert {n.name for pin in _d.pins if pin.name == "A" for n in pin.nets} == {"GND"}, (
            f"FSW_PROTECT: {_d.ref}'s anode is not on GND -- a clamp fitted the other "
            "way round conducts at 0.7 V and holds the footswitch pressed")
        _spec = TVS_SPECS.get(str(_d.value))
        assert _spec is not None, (
            f"FSW_PROTECT: {_d.ref} is a {_d.value}, which TVS_SPECS has no datasheet "
            "values for, so nothing below can check it")
        _ohms, _farads = _value_si(_r.value, "R"), _value_si(_c.value, "F")
        assert _ohms * 1.01 <= 8200, (
            f"FSW_PROTECT: {_r.ref} is {_r.value}; with the switch it must drive the "
            "pin low through 8.2 kOhm or less (RP2350 A2 erratum E9)")
        _held = _iovdd_max * _ohms * 1.01 / (_ohms * 1.01 + _rpu_min)
        assert _held <= _vil / 2, (
            f"FSW_PROTECT: a held {_name} reads {_held:.2f} V through {_r.value} "
            f"against the minimum pull-up, over half of VIL ({_vil} V)")
        assert _ohms * _farads <= 1e-3, (
            f"FSW_PROTECT: {_r.value} x {_c.value} = {_ohms * _farads * 1e3:.1f} ms; "
            "the press must reach the pin well inside the 8 ms debounce")
        _residual = _spec["vcl"] * _esd_s / (_ohms * _farads)
        assert _residual <= 0.5, (
            f"FSW_PROTECT: {_r.value} x {_c.value} lets {_residual:.2f} V of the "
            f"clamp's {_spec['vcl']} V residual through to the pin")
        assert _spec["vrwm"] >= _iovdd_max, (
            f"FSW_PROTECT: {_d.value} stands off {_spec['vrwm']} V, under the "
            f"{_iovdd_max} V a released input can sit at")
        _released = _iovdd_min - _spec["irm"] * (_rpu_max + _ohms)
        assert _released >= _vih + 0.5, (
            f"FSW_PROTECT: {_d.value} leaks up to {_spec['irm'] * 1e6:.0f} uA; against "
            f"the weakest pull-up a released {_name} reads {_released:.2f} V, too "
            f"close to VIH ({_vih} V) or under it")

    # Read off the PART, not off the SWD_PADS literal two lines above it. Asserting
    # against the dict that made the connections is a tautology, and it passed with
    # SWCLK and SWDIO swapped -- which is the mistake that actually happens, and
    # which bricks flashing rather than announcing itself.
    assert pico.footprint.endswith("RaspberryPi_Pico_SMD_or_THT_Debug"), (
        f"SWD: J1 is on {pico.footprint}. Only the vendored SMD_or_THT_Debug "
        "footprint carries D1/D2/D3 in both build styles -- KiCad's own THT one "
        "drops them, and SWD would need a header and three flying wires again")
    for _pad, _want in (("D1", "SWCLK"), ("D2", "GND"), ("D3", "SWDIO")):
        got = {n.name for n in pico[_pad].nets}
        assert _want in got, (
            f"SWD: the module's {_pad} pad carries {got}, expected {_want} -- the "
            "debug pad order is the module's, not ours, and swapping SWCLK/SWDIO "
            "leaves a board that cannot be flashed")

    # EXACTLY ONE hard bond from board ground to the chassis. Two would close a
    # mains-frequency loop through the Pi ribbon, which is the thing this scheme
    # exists to avoid; none would leave the board floating inside an earthed metal
    # case, relying on whichever connector flange happens to touch best. The other
    # holes are isolated pads, wired to nothing at all.
    _bonded = [h for h, p in holes.items() if gnd in p[1].nets]
    assert _bonded == [CHASSIS_BOND_HOLE], (
        f"CHASSIS_BOND: {_bonded or 'no hole'} is hard-bonded to GND, expected "
        f"exactly [{CHASSIS_BOND_HOLE}] -- two DC bonds close a hum loop through "
        "the ribbon, and zero leaves the board floating in an earthed metal box")
    for _h, _p in holes.items():
        if _h == CHASSIS_BOND_HOLE:
            continue
        _touching = {q.part.ref for n in _p[1].nets for q in n.get_pins()
                     if q.part.ref != _h}
        assert not _touching, (
            f"CHASSIS_BOND: {_h} is wired to {_touching} -- the other three holes "
            "are isolated pads. A second path to ground, through anything, is the "
            "loop this scheme exists to prevent")

    # The power button must NOT be on the 40-way at all. This gate used to assert
    # the opposite -- "the button must land on Pi header pin 5 (GPIO3)... the only
    # pin that wakes the Pi from halt" -- which is true of a Pi 4 and false of a
    # Pi 5, where the GPIO is behind RP1 and neither it nor the SoC is powered until
    # the PMIC wakes them. A gate can enforce a wrong belief just as firmly as a
    # right one; this one did, for the whole design.
    assert 5 not in PI_HDR, (
        "PWR_BTN: Pi header pin 5 (GPIO3) cannot wake a Pi 5 -- the button belongs "
        "on the Pi's own J2 solder pads, brought out as J9")
    assert {n.name for n in j_pi_btn[1].nets} == {"PWR_BTN"}, (
        "PWR_BTN: J9 must carry the button through to the Pi's J2 pads")
    # ...as a floating pair: pin to pin with J8, and nothing else on either net.
    for _pin, _net in ((1, pwr_btn), (2, pwr_btn_ret)):
        _nodes = {(p.ref, str(pin.num)) for p in default_circuit.parts
                  for pin in p.pins if _net in pin.nets}
        assert _nodes == {("J8", str(_pin)), ("J9", str(_pin))}, (
            f"PWR_BTN: {_net.name} touches {sorted(_nodes)}, expected only J8 and J9 "
            f"pin {_pin} -- the button lead must stay a floating pair, or fitting it "
            "to the Pi's J2 pads the wrong way round holds the button down forever")

    # Every part with a POLARISED footprint must use a polarised symbol and sit the
    # right way round: pin 1 (+) on a positive rail, pin 2 (-) on ground. A reversed
    # electrolytic is the one assembly mistake on this board that fails loudly and
    # takes the rail with it, and DRC cannot see it -- copper is copper.
    for _p in default_circuit.parts:
        _fp = str(getattr(_p, "footprint", "") or "")
        if "CP_" not in _fp and "Polarized" not in _fp:
            continue
        assert "Polarized" in str(_p.name), (
            f"POLARITY: {_p.ref} has the polarised footprint {_fp.split(':')[-1]} but "
            f"the {_p.name} symbol -- nothing declares which end is positive, so "
            "nothing can check it")
        _plus = {n.name for n in _p[1].nets}
        _minus = {n.name for n in _p[2].nets}
        assert _plus & {"+5V", "+3V3"} and _minus == {"GND"}, (
            f"POLARITY: {_p.ref} has pin 1 (+) on {_plus} and pin 2 (-) on {_minus} "
            "-- an electrolytic backwards across a rail vents at power-on")

    # Nothing of ours may sit on a pin another board on this Pi has taken. Rails
    # are exempt: 3V3 and GND are shared by every HAT by definition, and sharing
    # them is the point.
    for _pin, _who in PI_RESERVED.items():
        _n = PI_HDR.get(_pin)
        assert _n is None or _n in (gnd, v3v3), (
            f"PI_RESERVED: Pi header pin {_pin} carries {_n.name}, but {_who} "
            "already uses it -- two drivers on one pin is a link that never comes up")

    # ADC bias must follow its owner's supply. The ring UART's idle bias must
    # also remain high while AUX is on and the independently powered Pi is off.
    # Prove the complete local island, with no link to the Pi rail.
    _ctrl_bias = {(p.part.ref, str(p.num)) for p in v3v3_pico.get_pins()}
    assert _ctrl_bias == {("J1", "36"), ("R7", "1"), ("R8", "1"),
                          ("R9", "1"), ("R10", "1"),
                          ("R11", "1"), ("R12", "1")}, (
        f"CTRL_SUPPLY: CTRL and UART bias must come only from Pico pin 36: {_ctrl_bias}")
    assert {n.name for n in pico[36].nets} == {"+3V3_PICO"}, (
        "CTRL_SUPPLY: Pico 3V3 must not be tied to the Pi 3V3 rail")

    # ...and the buck must not be paralleled with the Pi's own 5 V rail.
    assert {(p.part.ref, str(p.num)) for p in pi_gpio17.get_pins()} == {
        ("J2", "11"), ("J25", "1")
    }, "SCREEN_ENABLE: GPIO17 must connect only Pi physical pin 11 to J25 pin 1"
    assert {n.name for n in j_screen[2].nets} == {"GND"}, (
        "SCREEN_ENABLE: J25 pin 2 must be GND")
    for _pin in (2, 4):
        assert _pin not in PI_HDR, (
            f"PI_POWER: Pi header pin {_pin} is a 5 V SUPPLY pin. Connecting it ties "
            "the external buck to the Pi's PMIC rail with no ORing diode, and puts "
            "the WS2812 load on the Pi's 5 V pin -- which the shopping list forbids")

    # Nothing may drive the PICO over 3V3 either. There was no such gate: PI_LEVELS
    # guarded the Pi only, so the ring board's 5 V encoder pull-ups sat 1.4 V over
    # GP13/GP14's absolute maximum and every check on this board stayed green.
    for _pad, _name in ((PICO[GPIO[n]], n) for n in GPIO):
        for _n in pico[_pad].nets:
            assert v5 not in _n.nets, (
                f"PICO_LEVELS: {_name} (pad {_pad}) touches a 5 V rail -- RP2350 IO "
                "is 3.3 V and its absolute maximum is 3.6 V")

    # Nothing over 3V3 on any net the Pi touches -- midi_tx included: it is DRIVEN
    # by the Pi, and 5 V on it fights the RP1's own output driver just as surely as
    # it would overdrive an input. DIRECT contact only, deliberately: a resistor to
    # 5 V keeps the nets separate and passes here -- RING_LEVELS above walks the
    # ring netlist for that shape, and CONSOLE_LEVELS below walks this board's own.
    for n in (link_tx_pi, link_rx_pi, midi_tx, midi_rx, pwr_btn, pwr_btn_ret,
              swclk, swdio):
        assert v5 not in n.nets, (
            f"PI_LEVELS: {n.name} touches a 5 V rail -- Pi GPIO is not 5 V tolerant")

    # CONSOLE_LEVELS: the resistive version of the two gates above, on THIS
    # board's own parts. The ring board shipped the mistake once (10k pull-ups to
    # 5 V on Pico inputs) and nothing here would have caught the same move on the
    # console board itself: PI/PICO_LEVELS see only direct contact, RING_LEVELS
    # reads only the other board's netlist. Same classification-free rule as
    # RING_LEVELS: any TWO-PIN part bridging +5V to a protected net delivers 5 V
    # there, whatever its footprint claims -- and the pin-count arithmetic
    # exempts U1/the module/J22 (whose VCC-beside-signal pads are legitimate)
    # without naming them. No allowlist: since R14 pulls DOWN, no legitimate
    # two-pin part on this board bridges +5V to any of these nets.
    _protected = {n.name for n in (link_tx, link_rx, link_tx_pi, link_rx_pi,
                                   midi_tx, midi_rx, pwr_btn, pwr_btn_ret,
                                   swclk, swdio,
                                   ind_data, link_to_ring, link_to_console,
                                   pd_sda, pd_scl,
                                   ctrl1_present, ctrl2_present,
                                   ctrl1, ctrl2)}
    for _p in default_circuit.parts:
        if len(_p.pins) > 2:
            continue
        _touch = {n.name for _pin in _p.pins for n in _pin.nets}
        assert not ("+5V" in _touch and _touch & _protected), (
            f"CONSOLE_LEVELS: {_p.ref} bridges +5V to "
            f"{sorted(_touch & _protected)} -- a two-pin path to 5 V on a "
            "3.3 V-only pin passes every direct-contact gate and cooks the pin "
            "at leisure; the ring board already shipped this mistake once")

    # PIN_REFS: the pinned refs R14..R18 must have SURVIVED SKiDL's numbering.
    # Declaring a pinned ref after the counter has passed it does not error -- it
    # renames the part (R17 became R17_1 during this board's own build, and the
    # auto part that stole the name was a 10k on the wrong nets). A bare
    # existence check cannot catch that (the name exists, on the wrong part), so
    # this asserts identity: no suffixed strays, and each pinned ref carries the
    # value it was declared with.
    _strays = sorted(p.ref for p in default_circuit.parts
                     if re.match(r"(R1[4-8]|R19|R2[0-9]|R3[0-2]|D[1-6])_", p.ref))
    assert not _strays, (
        f"PIN_REFS: {_strays} exist -- a pinned ref collided with the auto "
        "counter and SKiDL renamed it; declare pinned parts after the last "
        "auto-numbered one")
    # Identity is value AND nets: the recorded usurper was itself a 10k, so a
    # value check alone cannot tell the stolen name from the real part -- the
    # nets can, always.
    for _ref, _want_val, _want_nets in (
            ("R14", "100k", {"MIDI_TX", "GND"}),
            ("R16", "100k", {"IND_DATA", "GND"}),
            ("R17", "10k", {"LINK_TX", "LINK_TX_PI"}),
            ("R18", "6.8k", {"LINK_RX_PI", "LINK_RX"}),
            ("R19", "4.7k", {"J20_REF", "CTRL1_RING"}),
            ("R20", "4.7k", {"J21_REF", "CTRL2_RING"}),
            ("R21", "4.7k", {"J20_RN", "CTRL1_PRESENT"}),
            ("R22", "4.7k", {"J21_RN", "CTRL2_PRESENT"}),
            *((FSW_SERIES_REFS[_n], FSW_SERIES, {"SW_%s_EXT" % _n, "SW_" + _n})
              for _n in FSW_ORDER if _n in FSW_SERIES_REFS),
            *(("D%d" % (2 + _k), FSW_TVS,
               {"SW_%s_EXT" % _a, "SW_%s_EXT" % _b, "GND"})
              for _k, (_a, _b) in enumerate(TVS_PAIRS))):
        _p = next((p for p in default_circuit.parts if p.ref == _ref), None)
        assert _p is not None and _p.value == _want_val, (
            f"PIN_REFS: {_ref} is "
            f"{'missing' if _p is None else 'a ' + str(_p.value)} -- the pinned "
            f"ref no longer names the {_want_val} part it was declared as")
        _got = {n.name for _pin in _p.pins for n in _pin.nets}
        assert _got == _want_nets, (
            f"PIN_REFS: {_ref} sits on {sorted(_got)}, declared for "
            f"{sorted(_want_nets)} -- the name survives on the wrong part")

    if strict_stations:
        assert os.path.exists(STATIONS_JSON), (
            f"REAR_IO_COVER: {STATIONS_JSON} is missing -- run segno_enclosure.py "
            "--report first; the board's connector set is checked against it")
        with open(STATIONS_JSON) as fh:
            declared = [s["ref"] for s in json.load(fh)["stations"]]
        for ref in declared:
            assert ref in STATION_HEADERS or ref in STATION_NOT_ON_BOARD, (
                f"REAR_IO_COVER: the panel declares {ref} but this board neither "
                "terminates it nor says why not")
        for ref in STATION_HEADERS:
            assert ref in declared, (
                f"REAR_IO_COVER: the board terminates {ref}, which the panel no "
                "longer has")
    return True


def report():
    lay = []
    for name, gp in sorted(GPIO.items(), key=lambda kv: kv[1]):
        lay.append("  GP%-3d pad %-3d %s" % (gp, PICO[gp], name))
    return ("Segno CONSOLE board v3.2 (#747, #987, #1388, #1391)\n"
            "Pico 2 (RP2350) on segno:RaspberryPi_Pico_SMD_or_THT_Debug\n"
            "        (surface-mount pads AND through-holes; solder it either way)\n"
            "\nPin map:\n" + "\n".join(lay) +
            "\n\nRails : +5V (logic AND WS2812; J3 in and J24 pill power on JST VH) | "
            "+3V3 (Pi: MIDI and expansion) | "
            "+3V3_PICO (Pico pin 36: CTRL bias and ring UART pull-ups)\n"
            "Link  : 3V3 <-> 3V3; R17 TX 10k / R18 RX 6.8k -- no level shifting,\n"
            "        RX satisfies A2 E9; both resistors limit fault current\n"
            "AHCT  : MIDI OUT and indicators (3V3->5V crossings)\n"
            "FSW   : J10..J19 -> clamp D2..D6 (%s) -> %s R23..R32 -> GPIO + 100nF\n"
            % (FSW_TVS, FSW_SERIES))


def _selftest():
    """Flip each gate and fail unless every one of them bites. New to this repo --
    see the plan. Returns before generate_netlist() so a self-test run can never
    overwrite the committed netlist with a deliberately broken one."""
    global RING_NET
    cases = []
    _tmp_nets = []          # mkstemp copies the ring controls write; unlinked
                            # in the harness's finally so runs don't accumulate

    def case(name, want, mutate):
        cases.append((name, want, mutate))

    def _dup_gpio():
        GPIO["SW_STOP"] = GPIO["SW_UNDO"]

    def _ctrl_off_adc():
        # SWAP rather than collide -- setting CTRL to an already-used pin trips the
        # duplicate check first and never reaches the ADC assertion, which would
        # leave that gate unproven.
        GPIO["CTRL1_TIP"], GPIO["SW_RECPLAY"] = GPIO["SW_RECPLAY"], GPIO["CTRL1_TIP"]

    def _ring_order():
        # The other board reorders ITS connector and this one does not follow. The
        # mutation therefore has to happen in ring_board.net -- a control that
        # edited a copy of the pinout held here would only prove that the copy
        # exists, which is exactly how this gate came to be dead.
        global RING_NET
        text = open(RING_NET).read()
        a, b = '(ref "J1")\n        (pin "2")', '(ref "J1")\n        (pin "3")'
        # A silent-miss replace here is a control that mutates NOTHING and then
        # reports NO BITE against a healthy gate -- fail loudly instead.
        assert a in text and b in text, (
            "ring_board.net's format changed under _ring_order -- fix the anchors")
        text = text.replace(a, "\0").replace(b, a).replace("\0", b)
        # mkstemp, not a fixed name: two concurrent --selftest runs (a real
        # pattern in this multi-worktree repo) must not race on one path.
        _fd, RING_NET = tempfile.mkstemp(suffix="-ring_board.selftest.net")
        with os.fdopen(_fd, "w") as fh:
            fh.write(text)
        _tmp_nets.append(RING_NET)

    def _ring_pullup():
        # The RESISTIVE failure: a pull-up re-added on the ring board from its 5 V
        # rail to the one line that still reaches a Pico input (RING_LINK). No pin's net changes, so RING_CONTRACT stays
        # green, and the two nets never touch, so PICO_LEVELS does too -- this is
        # the shape only RING_LEVELS can see. Mutates a COPY, like _ring_order: a
        # control that edited a pinout held here would only prove the copy exists.
        global RING_NET
        text = open(RING_NET).read()
        comp = ('    (comp\n      (ref "R99")\n      (value "10k")\n'
                '      (footprint "Resistor_THT:R_Axial_DIN0207_L6.3mm_D2.5mm'
                '_P10.16mm_Horizontal")\n'
                '      (libsource\n        (lib "Device")\n        (part "R"))\n'
                '      (tstamps "00000000-9999-0000-0000-000000000000"))\n')
        assert "  (components\n" in text
        text = text.replace("  (components\n", "  (components\n" + comp, 1)
        node = ('      (node\n        (ref "R99")\n        (pin "%s")\n'
                '        (pintype "PASSIVE"))\n')
        for _net, _pin in (("+5V_LED", "1"), ("LINK_TO_CONSOLE", "2")):
            _anchor = '(name "%s")\n      (class "Default")\n' % _net
            assert _anchor in text, (
                "ring_board.net's format or net names changed under _ring_pullup "
                "-- fix the control's anchors")
            text = text.replace(_anchor, _anchor + node % _pin, 1)
        _fd, RING_NET = tempfile.mkstemp(suffix="-ring_board.selftest2.net")
        with os.fdopen(_fd, "w") as fh:
            fh.write(text)
        _tmp_nets.append(RING_NET)

    def _swd_swap():
        # The one SWD mistake that gets made, and the reason the old gate was worth
        # nothing: a board that is electrically perfect and cannot be flashed.
        pico["D1"].disconnect(); pico["D3"].disconnect()
        pico["D1"] += swdio
        pico["D3"] += swclk

    def _second_bond():
        # The mistake this scheme exists to prevent: a second hole strapped to
        # ground "for a better connection", which closes a mains-frequency loop
        # through the ribbon and the Pi.
        holes["H3"][1].disconnect()
        holes["H3"][1] += gnd

    def _clamp_reversed():
        # The 1N4148 fitted the other way round: electrically parallel with the
        # opto's LED, which kills MIDI IN and looks perfectly fine everywhere else.
        d_clamp[1].disconnect(); d_clamp[2].disconnect()
        d_clamp[1] += opto[2]
        d_clamp[2] += opto[1]

    def _cap_backwards():
        # The 470uF reservoir fitted the other way round.
        c30 = next(p for p in default_circuit.parts if p.ref == "C30")
        c30[1].disconnect(); c30[2].disconnect()
        c30[1] += gnd
        c30[2] += v5

    def _reserved_pin():
        # The exact mistake this gate exists for: the link moved back onto a pin
        # the NVMe board underneath has already claimed.
        PI_HDR[7] = link_rx

    def _btn_pin():
        PI_HDR[5] = gnd

    def _btn_grounded():
        # The v3 board as first drawn: the button's return on GND.
        j_pi_btn[2].disconnect()
        j_pi_btn[2] += gnd

    def _fsw_count():
        FSW_ORDER.append("EXTRA")

    def _station():
        STATION_HEADERS["NOT_A_STATION"] = "J99"

    def _uart_split():
        # Swap LINK_TX with IND_DATA: GP18 is on no UART's TX set, and swapping
        # (not assigning) keeps every pin unique, so this reaches the UART gate
        # instead of the duplicate or expansion checks. No GPIO is spare on v3.
        GPIO["LINK_TX"], GPIO["IND_DATA"] = GPIO["IND_DATA"], GPIO["LINK_TX"]

    def _row_straddle():
        GPIO["LINK_TO_CONSOLE"], GPIO["IND_DATA"] = GPIO["IND_DATA"], GPIO["LINK_TO_CONSOLE"]

    def _exp_collide():
        GPIO["SW_STOP"] = EXPANSION_GPIO[0]

    def _ref_collision():
        # The renumbering failure PIN_REFS exists for, replayed literally: the
        # pinned NAME survives -- on the wrong part -- and the real part wears a
        # suffix. A bare existence check passes this; the identity check must not.
        _r17 = next(p for p in default_circuit.parts if p.ref == "R17")
        _r17.ref = "R17_1"

    def _console_pullup():
        # The ring board's shipped mistake, tried on THIS board: a pull-up from
        # the 5 V rail to a Pico line. Every direct-contact gate stays green.
        R("10k", ref="R99")[1, 2] += v5, link_to_console

    def _screen_wrong_gpio():
        j_pi[11].disconnect()
        j_pi[12] += pi_gpio17

    # Each control names the gate it must trip. A control that trips some OTHER
    # gate proves nothing about its own and reads as a pass -- console_board_pcb.py
    # gained this check after two of its controls silently did exactly that, and
    # this side was catching a bare AssertionError and never asking which one.
    def _ctrl_pi_bias():
        resistor = next(p for p in default_circuit.parts if p.ref == "R7")
        resistor[1].disconnect()
        resistor[1] += v3v3

    def _ctrl_supply_short():
        pico[36].disconnect()
        pico[36] += v3v3

    def _ring_pi_bias():
        resistor = next(p for p in default_circuit.parts if p.ref == "R11")
        resistor[1].disconnect()
        resistor[1] += v3v3

    def _rx_too_weak():
        next(p for p in default_circuit.parts if p.ref == "R18").value = "10k"

    def _rx_fault_current():
        next(p for p in default_circuit.parts if p.ref == "R18").value = "1k"

    # The five ways the footswitch protection comes apart, each on MODE: the
    # input that already lost a pin. The harness's finally block undoes each one.
    def _fsw_direct():
        # v3's wiring: the header straight onto the GPIO.
        fsw_jacks["MODE"][1].disconnect()
        fsw_jacks["MODE"][1] += sw_nets["MODE"]

    def _fsw_cap_cable_side():
        _c = next(p for p in default_circuit.parts if p.ref == "C4")
        _c[1].disconnect()
        _c[1] += sw_ext["MODE"]

    def _fsw_clamp_reversed():
        _d = fsw_tvs["MODE"]
        _d[2].disconnect(); _d[3].disconnect()
        _d[2] += gnd
        _d[3] += sw_ext["MODE"]

    def _fsw_series_weak():
        fsw_series["MODE"].value = "10k"

    def _fsw_leaky_clamp():
        # A general-purpose 5 V TVS: up to 800 uA at its stand-off voltage,
        # which holds a footswitch low against a 32-86k pull-up.
        TVS_SPECS["SMAJ5.0A"] = {"vrwm": 5.0, "irm": 800e-6, "vcl": 9.2}
        fsw_tvs["MODE"].value = "SMAJ5.0A"

    def _fsw_anode_off_ground():
        # Cathodes where they belong, common anode on a rail instead of GND.
        fsw_tvs["MODE"][3].disconnect()
        fsw_tvs["MODE"][3] += v5

    case("footswitch header wired straight to its GPIO", "FSW_PROTECT:", _fsw_direct)
    case("debounce cap on the cable side", "FSW_PROTECT:", _fsw_cap_cable_side)
    case("footswitch clamp fitted backwards", "FSW_PROTECT:", _fsw_clamp_reversed)
    case("footswitch series resistor past E9", "FSW_PROTECT:", _fsw_series_weak)
    case("leaky general-purpose TVS as the clamp", "FSW_PROTECT:", _fsw_leaky_clamp)
    case("footswitch clamp anode off GND", "anode is not on GND", _fsw_anode_off_ground)
    case("CTRL bias connected to Pi supply", "CTRL_SUPPLY:", _ctrl_pi_bias)
    case("ring UART bias connected to Pi supply", "CTRL_SUPPLY:", _ring_pi_bias)
    case("Pico output on wrong supply", "CTRL_SUPPLY:", _ctrl_supply_short)
    case("duplicate GPIO", "PIN_MAP:", _dup_gpio)
    case("expansion pin fighting an on-board function", "PIN_MAP:", _exp_collide)
    case("LINK on a pin with no UART", "LINK_UART:", _uart_split)
    case("UART RX exceeds A2 E9 source impedance", "LINK_RX_DRIVE:", _rx_too_weak)
    case("UART RX loses its fault-current limit", "LINK_RX_DRIVE:", _rx_fault_current)
    case("connector group straddling both pad rows", "PAD_ROW:", _row_straddle)
    case("CTRL off an ADC pin", "PIN_MAP:", _ctrl_off_adc)
    case("ring board reorders its connector", "RING_CONTRACT:", _ring_order)
    case("ring board pulls the link line to 5 V", "RING_LEVELS:", _ring_pullup)
    case("SWCLK and SWDIO swapped on the debug pads", "SWD:", _swd_swap)
    case("a second mounting hole strapped to GND", "CHASSIS_BOND:", _second_bond)
    case("MIDI IN clamp diode reversed", "MIDI_CLAMP:", _clamp_reversed)
    case("reservoir electrolytic fitted backwards", "POLARITY:", _cap_backwards)
    case("link on a pin the NVMe board owns", "PI_RESERVED:", _reserved_pin)
    case("power button off GPIO3", "PWR_BTN:", _btn_pin)
    case("power button lead returned to GND", "PWR_BTN:", _btn_grounded)
    case("wrong footswitch count", "PIN_MAP:", _fsw_count)
    case("board terminates a station the panel lacks", "REAR_IO_COVER:", _station)
    case("pinned ref stolen by the auto counter", "PIN_REFS:", _ref_collision)
    case("console board pulls a Pico line to 5 V", "CONSOLE_LEVELS:", _console_pullup)
    case("screen enable moved to wrong Pi pin", "SCREEN_ENABLE:", _screen_wrong_gpio)

    ok = True
    ring_net_saved = RING_NET
    for name, want, mutate in cases:
        saved = (dict(GPIO), dict(PI_HDR), list(FSW_ORDER), dict(STATION_HEADERS))
        try:
            # The fixture is not the gate: a control that dies while SETTING UP
            # its mutation must read as fixture breakage, not as harness noise --
            # and its failure must not skip the restores below.
            try:
                mutate()
            except Exception as exc:
                print("  FIXTURE    %-42s broke before its gate ran: %s"
                      % (name, str(exc).replace("\n", " ")[:48]))
                ok = False
                continue
            _check()
            print("  NO BITE    %s  <-- gate is dead" % name)
            ok = False
        except AssertionError as exc:
            msg = str(exc).replace("\n", " ")
            if want in msg:
                print("  bites      %-42s %s" % (name, msg[:56]))
            else:
                print("  WRONG GATE %-42s wanted %s, got: %s" % (name, want, msg[:40]))
                ok = False
        finally:
            GPIO.clear(); GPIO.update(saved[0])
            PI_HDR.clear(); PI_HDR.update(saved[1])
            FSW_ORDER[:] = saved[2]
            STATION_HEADERS.clear(); STATION_HEADERS.update(saved[3])
            RING_NET = ring_net_saved
            if mutate is _fsw_direct:
                fsw_jacks["MODE"][1].disconnect()
                fsw_jacks["MODE"][1] += sw_ext["MODE"]
            if mutate is _fsw_cap_cable_side:
                _c = next(p for p in default_circuit.parts if p.ref == "C4")
                _c[1].disconnect()
                _c[1] += sw_nets["MODE"]
            if mutate is _fsw_clamp_reversed:
                _d = fsw_tvs["MODE"]
                _d[2].disconnect(); _d[3].disconnect()
                _d[2] += sw_ext["MODE"]
                _d[3] += gnd
            if mutate is _fsw_series_weak:
                fsw_series["MODE"].value = FSW_SERIES
            if mutate is _fsw_leaky_clamp:
                fsw_tvs["MODE"].value = FSW_TVS
                TVS_SPECS.pop("SMAJ5.0A", None)
            if mutate is _fsw_anode_off_ground:
                fsw_tvs["MODE"][3].disconnect()
                fsw_tvs["MODE"][3] += gnd
            if mutate in (_rx_too_weak, _rx_fault_current):
                next(p for p in default_circuit.parts if p.ref == "R18").value = "6.8k"
            if mutate in (_ctrl_pi_bias, _ring_pi_bias):
                ref = "R7" if mutate is _ctrl_pi_bias else "R11"
                resistor = next(p for p in default_circuit.parts if p.ref == ref)
                resistor[1].disconnect()
                resistor[1] += v3v3_pico
            if mutate is _ctrl_supply_short:
                pico[36].disconnect()
                pico[36] += v3v3_pico
            if mutate is _second_bond:
                holes["H3"][1].disconnect()
                holes["H3"][1] += Net("CHASSIS_H3")
            if mutate is _btn_grounded:
                j_pi_btn[2].disconnect()
                j_pi_btn[2] += pwr_btn_ret
            if mutate is _screen_wrong_gpio:
                j_pi[12].disconnect()
                j_pi[11] += pi_gpio17
            if mutate is _cap_backwards:
                _c30 = next(p for p in default_circuit.parts if p.ref == "C30")
                _c30[1].disconnect(); _c30[2].disconnect()
                _c30[1, 2] += v5, gnd
            if mutate is _clamp_reversed:
                d_clamp[1].disconnect(); d_clamp[2].disconnect()
                d_clamp[1, 2] += opto[1], opto[2]
            if mutate is _swd_swap:
                pico["D1"].disconnect(); pico["D3"].disconnect()
                pico["D1"] += swclk
                pico["D3"] += swdio
            if mutate is _ref_collision:
                _r = next((p for p in default_circuit.parts
                           if p.ref == "R17_1"), None)
                if _r is not None:
                    _r.ref = "R17"
            if mutate is _console_pullup:
                _r99 = next((p for p in default_circuit.parts
                             if p.ref == "R99"), None)
                if _r99 is not None:
                    # The part cannot be deleted from the circuit; disconnected,
                    # it touches no nets and every gate ignores it. Netlist
                    # generation never runs under --selftest, so it cannot leak
                    # into an artifact either.
                    _r99[1].disconnect(); _r99[2].disconnect()
            for _f in _tmp_nets:
                try:
                    os.unlink(_f)
                except OSError:
                    pass
            _tmp_nets.clear()
    return ok


if "--selftest" in sys.argv:
    print("Negative controls:")
    sys.exit(0 if _selftest() else 1)

print(report())
print("Board assertions ...", end=" ")
_check()
print("ALL PASS")

for _n in (gnd, v5, v3v3, v3v3_pico):
    _n.drive = POWER

ERC()
generate_netlist()
