tomassasovsky/segno-hardware/hardware/kicad/ring_board.py

"""SKiDL generator for the Segno ring/encoder carrier.

The selected assembly uses a 35-LED external WS2812 strip, a Same Sky
ACZ11BR1E-20FD1-20C encoder and a Seeed XIAO RP2350 module. The 80 mm circular
carrier is two-layer, white mask / black silk and hand soldered. It snap-mounts;
the shaft location and M7 threaded-bushing mount are fixed by the enclosure.
J3/J4 remain mutually exclusive alternatives for 24/16-LED purchased modules.

The XIAO drives the LED data locally through a 5 V AHCT buffer and reads the
encoder through 10k / 10nF filters. Only its fourteen castellated side pads are
soldered; its rear pads stay isolated. USB faces the clear east board rim.

For the selected strip, the near-ring AUX split separately supplies strip power
and J1 pins 1/2. Only J1 pins 3/4 run to console J6 pins 3/4: 115200-baud
full-duplex push-pull SerialPIO UART. The console's existing 10k pull-ups set
idle levels, with none added here. See RING_ASSEMBLY.md and ../segno_wiring.md
for the exact 16 AWG trunk / short 22 AWG branches and common-ground bounds.
J2 pin 3 carries DIN; its power and DOUT pins are unused in that assembly.

The retained J1-to-J2 power path also supports the documented module variants.
ring_power.py checks the native rail, taps and return vias; ring_encoder.py
checks the exact encoder's physical fit. Generator assertions below protect
local voltage domains, diode polarity, idle data level and fixed references.
Unplug J1 before USB programming: D1 blocks USB-to-AUX backfeed but does not
isolate a USB host from live AUX. Runtime pin and direction contracts are in
RING_ENCODER.md and the separately maintained firmware PR #1082.
"""
import os
import sys

from skidl import (
    Part, Net, generate_netlist, ERC, POWER, set_default_tool, KICAD8,
    lib_search_paths,
)

set_default_tool(KICAD8)

from builtins import default_circuit          # noqa: E402  (set up by skidl)

_SYMBOL_DIRS = [
    os.environ.get("KICAD_SYMBOL_DIR", ""),
    r"C:\Program Files\KiCad\10.0\share\kicad\symbols",
    r"C:\Program Files\KiCad\9.0\share\kicad\symbols",
    "/Applications/KiCad/KiCad.app/Contents/SharedSupport/symbols",
    "/Applications/KiCad.app/Contents/SharedSupport/symbols",
    "/usr/share/kicad/symbols",
]
for _d in _SYMBOL_DIRS:
    if _d and os.path.isdir(_d):
        lib_search_paths[KICAD8].append(_d)

# ---- THT footprint helpers -------------------------------------------------

# EVERY ref on this board is PINNED, none are left to SKiDL's auto-counter. The
# counter numbers parts in declaration order, so inserting one part renumbers
# every later one -- which silently re-points a layout that is already placed and
# routed against the old numbering. It already bit once here: the auto-numbered
# netlist called the 470uF "C2" while the fabbed board calls it C1.
# console_board.py's ref-block note is the same rule; its PIN_REFS gate is the
# same guard as REFS below.
# Horizontal axials, lying flat. They were briefly vertical (P2.54) to survive
# the O68 disc, which could not fit four flat DIN0207 bodies within reach of the
# pins they serve. O80 has the room, and flat parts are easier to place by hand
# and read on the silkscreen -- so they went back to the usual footprint.
def R(value, ref):
    return Part("Device", "R", value=value, ref=ref,
                footprint="Resistor_THT:R_Axial_DIN0207_L6.3mm_D2.5mm_P10.16mm_Horizontal")


def C(value, ref, fp="Capacitor_THT:C_Disc_D5.0mm_W2.5mm_P5.00mm"):
    return Part("Device", "C", value=value, ref=ref, footprint=fp)


# ---- nets ------------------------------------------------------------------

gnd = Net("GND")
v5 = Net("+5V_LED")      # harness 5 V -- feeds the ring DIRECTLY (no diode drop)
v5_mcu = Net("+5V_MCU")  # same rail through D1, into the XIAO's VBUS
v3v3 = Net("+3V3")       # the XIAO's own 3V3_OUT -- encoder pull-ups only
# Two link conductors, named by which way the data travels rather than TX/RX --
# a "TX" is only a TX from one end, and this net crosses between two boards.
link_to_ring = Net("LINK_TO_RING")        # console GP13 drives, the XIAO listens
link_to_console = Net("LINK_TO_CONSOLE")  # the XIAO drives, console GP14 listens
ring_data_3v3 = Net("RING_DATA_3V3")  # XIAO -> level shifter
ring_data_5v = Net("RING_DATA_5V")    # level shifter -> series R
ring_data = Net("RING_DATA")     # -> module DIN
ring_dout = Net("RING_DOUT")     # module DOUT (spare; for chaining a 2nd ring)
encA = Net("ENC_A")      # LOCAL now -- these three never leave the board
encB = Net("ENC_B")
encSW = Net("ENC_SW")

# ---- 4-pin link to the console board ---------------------------------------
#   1 = +5V_LED   2 = GND   3 = LINK_TO_RING   4 = LINK_TO_CONSOLE
# 1:1 onto console board v3's J6 (a 4-way, same order); on a v2 console it lands
# on J6 pins 1, 3, 6 and 7. RING_PINMAP in console_board.py is the single copy
# of that mapping and the thing RING_CONTRACT checks.
# GND is deliberately the MIDDLE pin: the LED return is a pulsed amp-scale
# current and it should not run next to the one signal in the cable.
j1 = Part("Connector_Generic", "Conn_01x04",
          footprint="Connector_JST:JST_XH_B4B-XH-A_1x04_P2.50mm_Vertical", ref="J1")
j1[1] += v5
j1[2] += gnd
j1[3] += link_to_ring
j1[4] += link_to_console

# ---- U1: Seeed XIAO RP2350 --------------------------------------------------
# Modelled as the 30-pad module it is, exactly the way main_board.py modelled the
# Pro Micro: a Conn_01x30 over a vendored footprint, with the pad map stated
# here. The map is NOT guessed -- it is read from Seeed's own symbol library
# (Seeed_Studio_XIAO_Series.kicad_sym), the same source the footprint came from:
#
#   1..11 D0..D10   12 3V3_OUT  13 GND  14 VBUS
#
# ONLY the 14 castellated SIDE pads exist here. Seeed's footprint also carries 16
# underside pads; they are deleted from our copy (owner call). This board reflows
# the module by its edges, nothing under the body is ever soldered, and leaving
# unsolderable copper directly beneath a module invites bridges and intermittent
# contact. GND therefore reaches the module through pad 13 alone, which is the
# only GND on the side rows anyway -- and pad 13 has its own stitching via.
#
# WHY RP2350 AND NOT RP2040: the console board is a Pico 2. Same architecture
# means one pico-sdk platform target, one PIO dialect and one erratum list across
# the whole product -- which is what #983 collapsed the firmware to. The RP2040
# XIAO's one advantage, a dedicated VIN pad for external supply, is cancelled by
# D1 below (needed on either part).
#
# PIN CHOICE IS A FLOORPLAN, same rule as console_board.py's. Everything the
# CABLE touches (VBUS, GND, both link lines) is on pads 10-14, one end of one side, so
# J1's three wires land together instead of crossing the module. The encoder and
# the LED line take the opposite row, facing the parts they drive.
#
# No hardware-UART constraint applies to the link pair. The console end is
# pinned to GP13/GP14 by copper that already exists, and those two are not a
# hardware TX/RX pair on any free instance (GP13 is UART0 RX, but UART0 is the
# Pi link on GP16/17, and GP14 is on neither UART), so the console side is a PIO
# UART either way. The XIAO's D-number -> GP-number mapping therefore does not
# bind the netlist. The firmware needs that mapping; the board does not.
XIAO = Part("Connector_Generic", "Conn_01x14",
            footprint="segno:XIAO_RP2350_SMD", ref="U1", value="XIAO-RP2350")
XIAO[1] += ring_data_3v3   # D0  -> level shifter in
XIAO[2] += encA            # D1
XIAO[3] += encB            # D2
XIAO[4] += encSW           # D3
XIAO[10] += link_to_ring     # D9  -> J1 pin 3
XIAO[11] += link_to_console  # D10 -> J1 pin 4
XIAO[12] += v3v3           # 3V3_OUT -- encoder pull-up rail, nothing else
XIAO[13] += gnd
XIAO[14] += v5_mcu         # VBUS, fed through D1

# Spare pads, exempted BY NAME rather than tolerated in the ERC log -- a wall of
# expected warnings is how a real one gets missed (console_board.py's rule).
# SWDIO/SWDCLK/EN/BOOT (23/24/25/27) are deliberately among them: bench recovery
# is the module's own USB-C and its BOOT/RESET buttons, so bringing them out
# would be copper for a path nothing uses.
XIAO_SPARE = (5, 6, 7, 8, 9)               # D4..D8, the only unused side pads
for _p in XIAO_SPARE:
    XIAO[_p].do_erc = False

# ---- D1: series Schottky into the module's VBUS -----------------------------
# The XIAO's 5 V pad IS its USB VBUS rail. D1 stops USB power feeding the AUX
# harness, but does not stop live AUX feeding the programming USB host.
# Disconnect J1 before plugging in USB; remove USB before reconnecting J1.
# The diode costs roughly 0.35 V in the MCU feed. The WS2812 ring taps v5
# ahead of it, without this additional voltage drop.
d1 = Part("Device", "D_Schottky", value="1N5819",
          footprint="Diode_THT:D_DO-41_SOD81_P10.16mm_Horizontal", ref="D1")
d1["A"] += v5
d1["K"] += v5_mcu

# ---- U2: 74AHCT125 -- the 3V3 -> 5 V crossing the WS2812 needs ---------------
# WS2812B wants VIH >= 0.7 x VDD = 3.5 V on a 5 V rail; the RP2350 drives 3.3 V.
# That gap is why the console board carries an AHCT125, and the same part answers
# it here -- SAME part number as console_board.py's U1, so the BOM does not grow
# a second logic family. Dropping the LED rail with a diode instead was the
# alternative and is rejected: at 1.44 A it burns over a watt in a DO-201 and
# leaves ~0.3 V of margin, against a part already proven on the other board.
# Only gate A is used. The other three are parked the way console_board.py parks
# its spare gate: /OE high, input low, output ERC-exempt.
buf = Part("74xx", "74AHCT125", value="74AHCT125N",
           footprint="Package_DIP:DIP-14_W7.62mm", ref="U2")
buf[14] += v5
buf[7] += gnd
C("100nF", "C5")[1, 2] += v5, gnd
buf[1] += gnd; buf[2] += ring_data_3v3; buf[3] += ring_data_5v   # gate A: ring
buf[4] += v5; buf[5] += gnd; buf[6].do_erc = False               # gate B unused
buf[10] += v5; buf[9] += gnd; buf[8].do_erc = False              # gate C unused
buf[13] += v5; buf[12] += gnd; buf[11].do_erc = False            # gate D unused
R("330", "R1")[1, 2] += ring_data_5v, ring_data
# R5: the idle state of the buffer's INPUT, same part and reason as console_board.py's
# R16 on IND_DATA. Until the XIAO's firmware claims D0 -- power-up, its bootloader,
# a reflash, a crash -- nothing drives this line, a CMOS input left floating drifts,
# and the AHCT125 passes whatever it settles on to the ring as WS2812 data. The ring
# then latches random colours, up to full white on all 40 strip LEDs. 100 k is weak
# enough that the pin drives it without noticing (33 uA) and holds the input low.
R("100k", "R5")[1, 2] += ring_data_3v3, gnd

# ---- 4-pin header to the NeoPixel module (3 wires used: 5V/GND/DIN) ---------
#   1 = +5V_LED   2 = GND   3 = DIN (<- RING_DATA)   4 = DOUT (spare)
j2 = Part("Connector_Generic", "Conn_01x04",
          footprint="segno:WirePads_1x04",   # flat FRONT solder pads (wires to module)
          ref="J2", value="NEOPIXEL")
j2[1] += v5
j2[2] += gnd
j2[3] += ring_data
j2[4] += ring_dout

# 4 distributed THT pads directly under the RING 24's IN/+5V/GND/OUT solder
# points, so the module can be pin-mounted instead of flying-wired (parallel to
# J2 -- same nets, either method works).
#
# The coordinates are NOT eyeballed and not measured off a photo: they are lifted
# from Adafruit's own board file for the part -- github.com/adafruit/
# Adafruit-NeoPixel-Ring, "Adafruit NeoPixel Ring 24 B.brd" -- with Y negated for
# KiCad's downward Y. The signal per pad is read from that file's netlist too
# (JP1=IN via R1, JP2=OUT off LED24's DOUT, JP3=VDD, JP4=GND), because JP
# numbering is not a signal order and must not be assumed to carry across ring
# sizes. The same extraction reproduces the OLD ModuleMountPads_4's Ring 16 pads
# exactly, which is how the method was checked before trusting it here.
#
# That file also confirms the ring is O65.53 / O52.32 -- the fitted part.
j3 = Part("Connector_Generic", "Conn_01x04",
          footprint="segno:ModuleMountPads_Ring24", ref="J3", value="RINGPINS24")
j3[1] += ring_data   # DIN
j3[2] += v5          # +5V
j3[3] += gnd         # GND
j3[4] += ring_dout   # DOUT (spare; soldered for mechanical support)

# ---- J4: the RING 16 pad circle, kept as an alternative -------------------
# Owner call: leave the Ring 16's mounting pads on the board so that ring can be
# fitted instead without a respin. Same four signals, same JP order (the Ring 16
# descr reads In/+5V/GND/Out = JP1/JP3/JP4/JP2, which is J3's order too), just a
# smaller bolt circle: r=21.05 against the Ring 24's r=31.59.
#
# Both pad sets are live on the same nets. That is intentional and not a short:
# exactly one ring is ever fitted, and the unused circle simply sits empty. It
# also means the router wires both, so either choice is connected as-fabbed.
#
# The Ring 16's r=21.05 circle falls INSIDE a Ring 24's O52.3 bore, so the two
# never physically clash -- fitting the 24 leaves the 16's pads exposed in the
# bore, which is why they can coexist at all.
j4 = Part("Connector_Generic", "Conn_01x04",
          footprint="segno:ModuleMountPads_4", ref="J4", value="RINGPINS16")
j4[1] += ring_data   # In
j4[2] += v5          # +5V
j4[3] += gnd         # GND
j4[4] += ring_dout   # Out (unused electrically; soldered for rigidity)

# MOUNTING HEIGHT. The module is pin-mounted on a 2.54 mm pitch pin strip, and
# the strip's plastic insulator is what sets the gap: a standard 0.1 in body is
# 2.54 mm. Stack above this board's front face:
#     2.54  pin-strip spacer
#   + 1.57  ring PCB (Adafruit's own STEP)
#   + 1.60  WS2812 proud of it (module is 3.2 overall)
#   = 5.71  to the LED top face
# The 3D model carries that 2.54 offset so the render is not 2.54 mm optimistic,
# and the pins are modelled TRIMMED: KiCad's own PinHeader_1x01 leaves 4.54 mm of
# bare pin standing above the ring, which nobody assembles, so
# PinHeader_1x01_trimmed.wrl keeps the insulator at 2.54 and snips the pin 1.0 mm
# proud. RING1 retains both alternative module models and their pins, hidden
# for the selected external 40-pixel strip. Toggle a module and its four pins
# together only when inspecting that optional assembly.
# Same Sky ACZ11BR1E-20FD1-20C: manufacturer seating-to-shaft datum 6.5 mm,
# M7x0.75 bushing z=6.5..11.5, shaft tip z=26.5. The 5.71 mm alternative
# module stack clears the bushing base. See RING_ENCODER.md for fit and sourcing.

# bulk cap at the module power entry (24 LEDs, ~1.44 A all-white worst case; the
# comet only ever lights part of the ring, so the real draw is far lower) -- THT
# radial electrolytic.
# ESR grade in the VALUE because the value is what a BOM prints and the grade is
# load-bearing: a general-purpose 470uF in the same can runs ~0.5 ohm, and the
# ring's amp-scale frame edges x that ESR is real ripple on the LEDs' own VDD.
# Same rule as the console board's C30.
Part("Device", "C_Polarized", value="470uF 16V low-ESR <=0.15R", ref="C1",
     footprint="Capacitor_THT:CP_Radial_D8.0mm_P3.50mm")[1, 2] += v5, gnd

# ---- Same Sky ACZ11 rotary encoder (A,B,C common, S1,S2 switch) ------------
# Now a purely LOCAL circuit: 20 mm of trace to U1 instead of ~600 mm of harness.
enc = Part("Device", "RotaryEncoder_Switch",
           footprint="segno:RotaryEncoder_SameSky_ACZ11BR1E-20FD1-20C",
           value="ACZ11BR1E-20FD1-20C", ref="ENC1")
enc["A"] += encA
enc["B"] += encB
enc["C"] += gnd
enc["S1"] += encSW
enc["S2"] += gnd

# 10k to the XIAO's OWN 3V3_OUT, plus 10nF: nominal RC = 0.1 ms. The shorter
# release delay preserves the high-high detent when the knob is turned quickly.
# Same Sky illustrates 10nF in its optional two-resistor filter; this local
# one-resistor circuit uses firmware quadrature cancellation for contact bounce.
# Exact THT capacitor and tolerance calculation: RING_ENCODER.md.
# Runtime also enables internal pull-ups; they are in parallel with these
# external resistors, so the effective release RC is less than 0.1 ms.
R("10k", "R2")[1, 2] += v3v3, encA
R("10k", "R3")[1, 2] += v3v3, encB
R("10k", "R4")[1, 2] += v3v3, encSW
C("10nF", "C2")[1, 2] += encA, gnd
C("10nF", "C3")[1, 2] += encB, gnd
C("10nF", "C4")[1, 2] += encSW, gnd

# The push-pull SerialPIO UART has its idle pull-ups only on the console.
# Both controllers share AUX and the documented near-ring ground reference;
# selected-strip supply current bypasses the console-to-ring UART harness.

# ---- gates -----------------------------------------------------------------
# This board grew an MCU, so it inherits the obligation that came with the one on
# the console board. RING_LEVELS (in console_board.py) reads this netlist, but it
# only ever looks at conductors that CROSS THE CABLE -- by construction it cannot
# see a 5 V part landing on a pin that never leaves this PCB. That is the same
# blind spot CONSOLE_LEVELS was written to close on the other board, and the
# encoder lines moved into it the moment they became local. Hence XIAO_LEVELS.

# Which pads are 3.3 V logic and which are power. Taken from the same Seeed symbol
# the footprint's descr quotes, not inferred: a pad's tolerance is the whole
# question here, so guessing it would defeat the gate.
XIAO_LOGIC_PADS = frozenset(range(1, 12))        # D0..D10
XIAO_POWER_PADS = {12: "3V3_OUT", 13: "GND", 14: "VBUS"}
RAILS_5V = ("+5V_LED", "+5V_MCU")


def _check():
    # XIAO_PADS: the ERC exemptions must not cover a pad that is actually in use.
    # console_board.py's rule, for the same reason -- an exemption on a live pin
    # hides a real unconnected-pin warning, and this module has 20 exempt pads to
    # hide one behind.
    assert XIAO_LOGIC_PADS.isdisjoint(XIAO_POWER_PADS), (
        "XIAO_PADS: a pad is listed as both logic and power")
    assert set(XIAO_LOGIC_PADS) | set(XIAO_POWER_PADS) == set(range(1, 15)), (
        "XIAO_PADS: the logic/power split does not cover pads 1..14 -- the map "
        "has drifted from the footprint's 14 pads")
    _used = {p for p in range(1, 15) if XIAO[p].nets}
    assert _used.isdisjoint(XIAO_SPARE), (
        f"XIAO_PADS: {sorted(_used & set(XIAO_SPARE))} are ERC-exempt but wired -- "
        "an exemption on a live pad hides a real unconnected-pin warning")

    # XIAO_LEVELS: nothing may bridge a 5 V rail to a 3.3 V pad of the module.
    # Same classification-free rule as the console board's: any TWO-PIN part
    # delivers the rail's DC whatever it calls itself, and the pin-count
    # arithmetic exempts the module, the encoder and the AHCT125 without naming
    # them. D1 is NOT exempted by name either -- it passes because its far end is
    # VBUS (pad 14), a power pad, which is the only reason a 5 V part may touch
    # this module at all.
    _protected = set()
    for _pad in XIAO_LOGIC_PADS:
        _protected |= {n.name for n in XIAO[_pad].nets}
    for _p in default_circuit.parts:
        if len(_p.pins) > 2:
            continue
        _touch = {n.name for _pin in _p.pins for n in _pin.nets}
        assert not (_touch & set(RAILS_5V) and _touch & _protected), (
            f"XIAO_LEVELS: {_p.ref} bridges a 5 V rail to "
            f"{sorted(_touch & _protected)} -- the XIAO's logic pads are RP2350 "
            "pins with a 3.6 V absolute maximum, and this is the exact shape that "
            "shipped on this board once already (10k to 5 V on an encoder line)")

    # LINK_BARE: each link line carries the console's 10k pull-up and must meet nothing
    # else here. A second pull-up on THIS board's rail would halve it to 5k and
    # re-import the split-rail hazard; a series R would be the Pi link's problem
    # (cross-domain powering), which this cable does not have -- both boards come
    # up and go down on one supply through it.
    for _net, _want in (("LINK_TO_RING", {("J1", "3"), ("U1", "10")}),
                        ("LINK_TO_CONSOLE", {("J1", "4"), ("U1", "11")})):
        _nodes = {(p.ref, str(pin.num)) for p in default_circuit.parts
                  for pin in p.pins if _net in {n.name for n in pin.nets}}
        assert _nodes == _want, (
            f"LINK_BARE: {_net} touches {sorted(_nodes)}, expected exactly "
            f"{sorted(_want)} -- the pull-up these lines run on lives on the "
            "console board, at the rail its GP13/GP14 belong to")

    # POLARITY: two parts on this board are directional and fitting either one
    # backwards is silent at assembly. Same gate the console board runs on C30.
    _d1 = next(p for p in default_circuit.parts if p.ref == "D1")
    assert {n.name for n in _d1["A"].nets} == {"+5V_LED"}, (
        f"POLARITY: D1's anode is on {sorted(n.name for n in _d1['A'].nets)}, "
        "expected the harness rail -- reversed, the module never powers up")
    assert {n.name for n in _d1["K"].nets} == {"+5V_MCU"}, (
        f"POLARITY: D1's cathode is on {sorted(n.name for n in _d1['K'].nets)}, "
        "expected the module rail")
    _pol = [p for p in default_circuit.parts if p.name == "C_Polarized"]
    assert len(_pol) == 1, f"POLARITY: expected 1 electrolytic, found {len(_pol)}"
    assert {n.name for n in _pol[0][1].nets} & set(RAILS_5V), (
        f"POLARITY: the electrolytic's pin 1 (+) is on "
        f"{sorted(n.name for n in _pol[0][1].nets)}, not a 5 V rail")
    assert {n.name for n in _pol[0][2].nets} == {"GND"}, (
        f"POLARITY: the electrolytic's pin 2 (-) is on "
        f"{sorted(n.name for n in _pol[0][2].nets)}, expected GND")

    # RING_DATA_IDLE: the buffer input must have its pull-down to GND, so the ring
    # stays dark while the XIAO is not driving D0.
    _idle = [p for p in default_circuit.parts if len(p.pins) == 2
             and {n.name for pin in p.pins for n in pin.nets} == {"RING_DATA_3V3", "GND"}]
    assert _idle, (
        "RING_DATA_IDLE: nothing pulls RING_DATA_3V3 to GND -- while the XIAO is "
        "not driving D0 the AHCT125's input floats and the ring latches random "
        "colours (console_board.py's R16 is the same fix on IND_DATA)")

    # Preserve the encoder release bandwidth and keep filtering local to GND.
    # This catches restoring the old 100nF parts or wiring a filter across rails.
    for ref, signal in (("C2", "ENC_A"), ("C3", "ENC_B"), ("C4", "ENC_SW")):
        cap = next(p for p in default_circuit.parts if p.ref == ref)
        assert cap.value == "10nF", f"ENC_FILTER: {ref} exceeds selected release delay"
        assert {n.name for pin in cap.pins for n in pin.nets} == {signal, "GND"}, (
            f"ENC_FILTER: {ref} must filter {signal} to GND")

    # REFS runs LAST on purpose. It is the broadest assertion here, so ahead of
    # the others it fires first for every control that adds a part and masks the
    # gate that control exists to prove -- --selftest reported exactly that
    # ("WRONG GATE") the first time it sat at the top.
    # REFS: the exact set, so nothing here is auto-numbered. A part added without
    # a ref would be silently numbered by the counter and could take a designator
    # the fabbed board has already assigned to something else -- which is the
    # failure that made pinning them worth doing (the 470uF was C1 in copper and
    # C2 in the netlist). Parts with no connections are skipped: --selftest's
    # controls are disconnected rather than deleted, and they are not the design.
    REFS = {"C1", "C2", "C3", "C4", "C5", "D1", "ENC1",
            "J1", "J2", "J3", "J4", "R1", "R2", "R3", "R4", "R5", "U1", "U2"}
    _live = {p.ref for p in default_circuit.parts
             if any(pin.nets for pin in p.pins)}
    assert _live == REFS, (
        f"REFS: the board's parts are {sorted(_live)}, expected {sorted(REFS)} -- "
        f"missing {sorted(REFS - _live)}, unexpected {sorted(_live - REFS)}. Every "
        "ref on this board is pinned so the counter cannot renumber a placed "
        "layout; a part declared without ref= breaks that.")


def _selftest():
    """Each gate above, proved to bite. A gate nobody has seen fail is a gate that
    might already be dead -- which is precisely how RING_LEVELS on the other board
    spent months asserting a literal list against itself."""
    added = []

    def _pullup_5v():
        # The shipped mistake, replayed on the pads it can still reach.
        r = R("10k", "R99"); r[1, 2] += v5, encA; added.append(r)

    def _link_pullup():
        # Reasonable-looking and wrong: "make the link idle high locally".
        r = R("10k", "R98"); r[1, 2] += v3v3, link_to_console; added.append(r)

    def _diode_backwards():
        d = next(p for p in default_circuit.parts if p.ref == "D1")
        d["A"].disconnect(); d["K"].disconnect()
        d["A"] += v5_mcu; d["K"] += v5

    def _exempt_live_pad():
        XIAO[5] += encA          # a spare, ERC-exempt pad quietly wired

    def _no_idle_pulldown():
        r5 = next(p for p in default_circuit.parts if p.ref == "R5")
        r5[1].disconnect(); r5[2].disconnect()
        added.append(("R5", r5))

    def _unpinned_part():
        # A part added the easy way, without ref= -- the counter names it and the
        # name it picks may already be on the fabbed board.
        r = Part("Device", "R", value="10k",
                 footprint="Resistor_THT:R_Axial_DIN0207_L6.3mm_D2.5mm"
                           "_P10.16mm_Horizontal")
        r[1, 2] += v3v3, gnd
        added.append(r)

    def _slow_filter():
        next(p for p in default_circuit.parts if p.ref == "C2").value = "100nF"

    def _miswired_filter():
        cap = next(p for p in default_circuit.parts if p.ref == "C3")
        cap[2].disconnect(); cap[2] += encA

    def _undo():
        for r in added:
            if isinstance(r, tuple):     # a disconnected design part: put it back
                r[1][1] += ring_data_3v3; r[1][2] += gnd
                continue
            for pin in r.pins:
                pin.disconnect()
        added.clear()
        d = next((p for p in default_circuit.parts if p.ref == "D1"), None)
        if d is not None and {n.name for n in d["A"].nets} != {"+5V_LED"}:
            d["A"].disconnect(); d["K"].disconnect()
            d["A"] += v5; d["K"] += v5_mcu
        if XIAO[5].nets:
            XIAO[5].disconnect()
        next(p for p in default_circuit.parts if p.ref == "C2").value = "10nF"
        cap = next(p for p in default_circuit.parts if p.ref == "C3")
        cap[2].disconnect(); cap[2] += gnd

    cases = [
        ("ring board pulls a XIAO logic pad to 5 V", "XIAO_LEVELS:", _pullup_5v),
        ("a second pull-up added to the link",       "LINK_BARE:",   _link_pullup),
        ("series Schottky fitted backwards",         "POLARITY:",    _diode_backwards),
        ("an ERC-exempt pad quietly wired",          "XIAO_PADS:",   _exempt_live_pad),
        ("the LED buffer input left floating",       "RING_DATA_IDLE:", _no_idle_pulldown),
        ("a part declared without a pinned ref",      "REFS:",        _unpinned_part),
        ("old 100nF encoder filter restored",          "ENC_FILTER:",  _slow_filter),
        ("encoder filter tied to the other phase",    "ENC_FILTER:",  _miswired_filter),
    ]
    ok = True
    for name, want, mutate in cases:
        try:
            mutate()
            _check()
        except AssertionError as e:
            got = str(e).split("\n")[0]
            # A control that trips some OTHER gate proves nothing about its own and
            # would read as a pass -- console_board.py learned this the hard way,
            # so the expected prefix is checked, not merely "it raised".
            hit = got.startswith(want)
            print(f"  {'bites' if hit else 'WRONG GATE':<10} {name:<42} {got[:68]}")
            ok &= hit
        except Exception as e:                       # noqa: BLE001
            print(f"  {'ERROR':<10} {name:<42} {type(e).__name__}: {e}")
            ok = False
        else:
            print(f"  {'NO BITE':<10} {name:<42} (the gate is dead)")
            ok = False
        finally:
            _undo()
    # ...and the real design must still pass once every control is undone, or the
    # cleanup is what made the run green rather than the gates.
    _check()
    return ok


if "--selftest" in sys.argv:
    print("Negative controls:")
    sys.exit(0 if _selftest() else 1)

print("Board assertions ...", end=" ")
_check()
print("ALL PASS")

for _n in (gnd, v5, v5_mcu, v3v3):
    _n.drive = POWER

ERC()
generate_netlist()
