tomassasovsky/segno-hardware/(commit log)

2026-06-19 feat(hardware): standalone pedal PCB design + KiCad netlists (tomassasovsky/segno#50)
    * feat(hardware): standalone pedal PCB design + KiCad netlists (2 boards)
    Adds the hardware design for a standalone foot-pedal controller replacing the
    breadboard UNO:
    - docs: hardware/loopy_pedal_pcb_design.md — full design (architecture, power,
    schematic-by-subsystem connection tables, BOM, 2-board split, layout/routing
    guidance, KiCad workflow). Main board = ATmega328P + ATmega16U2 USB-MIDI (UNO
    R3 reference) + 9V->5V AP63203 buck + USB/buck OR-ing + 10 footswitch inputs
    (RC debounce) + 5-pin DIN MIDI in (opto) / out (buffered) + indicator LED
    strip. Ring board = 12-LED ring + EC11 encoder.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
    [loopy_pedal_main.kicad_pcb, loopy_pedal_main_bom.csv, loopy_pedal_main_bom_jlc.csv, loopy_pedal_ring.kicad_pcb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]
2026-06-26 feat(hardware): THT Loopy pedal main + ring boards, fab-ready
    Through-hole MIDI looper foot-pedal: two KiCad 10 boards generated from
    SKiDL + a scripted place/route pipeline, ready for JLCPCB bare-board fab.
    Main board (94x96mm):
    - Arduino Pro Micro (ATmega32U4) native USB-MIDI, buffered DIN MIDI OUT
    (74AHCT125), opto-isolated DIN MIDI IN (H11L1)
    - 9V centre-negative barrel -> reverse-protection Schottky + TVS -> buck
    (+5V_LED for the LED ring); Pro Micro powered via RAW (onboard reg -> VCC)
    - 10 footswitch headers, faceplate RESET (J20) + 6-pin ICSP (J21) recovery
    - Fully silk-labelled (functions + component values), 4x M3 GND-bonded holes
    Ring board (60mm round):
    - Hosts an off-the-s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
    [loopy_pedal_main.kicad_pcb, loopy_pedal_main_bom.csv, loopy_pedal_main_bom_jlc.csv, loopy_pedal_ring.kicad_pcb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]
2026-06-26 chore(hardware): regen ring netlist + add combined LCSC BOM
    - Regenerate ring_board.net to match the current module-hosting design
    (was a stale leftover describing the old SMD WS2812 ring).
    - Add fab/loopy_combined_bom_lcsc.csv: consolidated main+ring parts list
    for one pedal, LCSC part numbers filled in for the distinctive parts,
    ready for LCSC BOM upload (bare-board order, no PCBA).
    [loopy_combined_bom_lcsc.csv]
2026-06-26 docs(hardware): floor-console BOM + protection/power/thermal + 7" HDMI (tomassasovsky/segno#93)
    Part 8 paper deliverables (the doable-here half of the hardware part; the
    enclosure CAD, assembly, and on-hardware gates remain physical work):
    - hardware/loopy_console_shopping_list.md: Argentina-sourced console BOM —
    Pi 5 + active cooler, 16" touchscreen, 7" HDMI display, USB interface,
    footswitches, EC11 encoder, WS2812 ring + strip, RP2040 LED driver, GPIO
    protection passives, power.
    - hardware/console/README.md: 3.3V GPIO input-protection circuit (series-R +
    RC + optional clamp, active-low to GND), per-rail power budget, active-cooling
    requirement, and enclosure design intent.
    -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
2026-07-02 feat(hardware): VAMP floor-console enclosure CAD + generators (tomassasovsky/segno#99)
    Sheet-metal wedge enclosure for the standalone Pi console: parametric
    STEP/DXF/glTF generators and their exported quote package (DXF/STEP),
    a web glTF viewer, and reference renders. Dev-only tooling and assets;
    no app code.
    [_test_shell.stl, vamp_base.dxf, vamp_base.step, vamp_corner_bracket_rear.dxf, vamp_corner_bracket_rear.step, vamp_faceplate.dxf, vamp_platform_front.dxf, vamp_platform_front.step]
2026-07-02 feat: Tracks view rework + on-screen pedal simulator (tomassasovsky/segno#96)
    * refactor(pedal): mode enum, split rec-cursor vs play-set, fix mute != stop
    Rework PedalCubit's model per the corrected pedal behavior:
    - PedalMode moved into pedal_repository; PedalStateFrame.playMode:bool ->
    mode:PedalMode (codec still writes/reads bit 0 -- wire-compatible, the golden
    .syx fixtures are byte-identical). Drop the isPlayMode bool getter for
    switch(mode).
    - Split arming into two named PedalState concepts: selectedTrack (the Rec
    cursor) and playArmed (the Play set), promoting the old private _playSet the
    LEDs secretly depended on into state.
    - Play mode gains a derived transport (playing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
    [loopy_combined_bom_lcsc.csv, loopy_pedal_main.kicad_pcb, loopy_pedal_main_bom.csv, loopy_pedal_ring.kicad_pcb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]
2026-07-02 fix(hardware): restore pedal PCB / firmware / KiCad files (tomassasovsky/segno#101)
    PR tomassasovsky/segno#96 accidentally removed the pre-existing `hardware/kicad`,
    `hardware/firmware`, `hardware/console`, and pedal-PCB design docs while
    excluding the new enclosure assets from that branch. Restore them
    verbatim; they are unrelated baseline hardware and were never meant to
    change.
    [loopy_combined_bom_lcsc.csv, loopy_pedal_main.kicad_pcb, loopy_pedal_main_bom.csv, loopy_pedal_ring.kicad_pcb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]
2026-07-02 chore(ios): adopt Flutter Swift Package Manager integration (tomassasovsky/segno#95)
    Xcode project migration generated by the Flutter tooling:
    - Add the FlutterGeneratedPluginSwiftPackage local Swift package reference and
    wire it into the Runner target's frameworks + package dependencies.
    - development scheme: add the "prepare Flutter framework" pre-action and the
    ephemeral flutter_lldbinit, matching current flutter run/build.
    - Bump LastUpgradeCheck/LastUpgradeVersion 1430 -> 1510; enable GPU validation
    in the Runner scheme.
    - Drop the now-unused MinimumOSVersion key from AppFrameworkInfo.plist.
2026-07-02 feat(hardware): VAMP welded sheet-metal enclosure generator (tomassasovsky/segno#94)
    * feat(hardware): add standalone Raspberry Pi loopstation main board
    An oversized HAT that turns the loopy foot-pedal into a self-contained
    appliance: a Raspberry Pi 4/5 stacks on the board (40-pin GPIO socket on the
    underside) and runs the loopy audio engine itself; audio I/O via a USB audio
    interface. The board carries pedalboard power (9V->5V LM2596 buck), the 10
    footswitches, the EC11 encoder and the two WS2812 strips. No MIDI/USB-device
    silicon -- the Pi reads the footswitches directly over GPIO. Reuses the existing
    ring board unchanged (same 8-pin pinout).
    All through-hole / hand-solderable (TO-220 b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
    [loopy_pi_main.kicad_pcb, vamp_assembly.step, vamp_base.dxf, vamp_corner_bracket_rear.dxf, vamp_faceplate.dxf, vamp_faceplate.step, vamp_overlay.dxf, vamp_platform.step]
2026-07-03 feat(hardware): RC-20-style footswitch pad master + mould generator (tomassasovsky/segno#102)
    * feat(hardware): RC-20-style footswitch pad master + mould generator
    Parametric cadquery generator for casting replacement rubber foot-pedal
    pads. The pad form is traced from the RC-20 pad (outer base slab + three
    raised platforms with divider grooves) and fitted to the existing
    85.9x62.8 mm pedals with a 2 mm safety margin; height and layout are
    parametric.
    Emits the print-ready master, a printable pour box for the silicone
    mould, and a test negative, plus STEP/STL/SVG. README documents the full
    FDM-master -> silicone-mould -> cast-pad workflow and material picks.
    * chore(spell): allowlist cast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
    [rc20_pad.step, rc20_pad.stl, rc20_pad_mould.step, rc20_pad_mould.stl, rc20_pad_pourbox.step, rc20_pad_pourbox.stl]
2026-07-11 feat(pedal): 32U4 firmware + THT main-board bring-up (on-board buck, encoder, LED gate + watchdog) (tomassasovsky/segno#149)
    * feat(pedal): 32U4 firmware bring-up + master-gain ring volume meter
    Complete the ATmega32U4 (Pro Micro) THT-board firmware from a bring-up
    skeleton to a full thin client, and thread the engine master gain through
    to the pedal so the ring doubles as a volume meter.
    Firmware (hardware/firmware/loopy_pedal_32u4):
    - Port the protocol + LED rendering from the UNO build to the two-strip
    topology: 16-LED NeoPixel ring (D15) + 7-LED indicator (D16), driven from
    loopy's SysEx state frames over USB-MIDI and DIN. Boot self-test sweep.
    - Replace the naive encoder edge-read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
    [loopy_pedal_main.kicad_pcb, loopy_pedal_ring.kicad_pcb]
2026-07-13 feat(pedal): gamma-correct the LED output on all three firmwares (tomassasovsky/segno#158)
    * feat(pedal): gamma-correct the LED output on all three firmwares
    The WS2812 strips were driven with raw linear 8-bit RGB, so brightness
    ramps read top-heavy — the ring's rotating hump and the volume-meter fade
    crowded their dim steps while the bright end barely moved.
    Apply perceptual gamma (~2.8) at output:
    * FastLED sketches (loopy_pedal, loopy_pedal_32u4): a PROGMEM gamma-2.8
    LUT + showGamma(), which corrects the logical frame into a SEPARATE
    display buffer before FastLED.show(). The separate buffer matters — the
    frozen-playhead ring holds its last frame without redrawing, so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
2026-07-14 docs(pedal): correct 32U4 ring "playhead" docs drift to match firmware (tomassasovsky/segno#206)
    The 32U4 pedal port's renderRing() is byte-for-byte the same fixed-cadence
    sweep (kRingMsPerRev=700, independent of loop_length_micros) already fixed
    in the old firmware by PR tomassasovsky/segno#176. This sibling port, added afterward, had the
    same claim ("loop-position playhead") in 8 places across the .ino and its
    README. Corrects all 8, and documents g_lastLoopTopMs as currently unused,
    reserved for a possible future loop-synced rendering mode.
2026-07-16 feat(firmware): gate LED gamma correction behind a compile-time flag (tomassasovsky/segno#216)
    Put the perceptual WS2812 gamma correction behind LED_GAMMA_CORRECTION,
    defaulting to 0 (off) across all three firmwares (loopy_pedal_32u4,
    loopy_pedal, led_driver). It's an #ifndef-guarded #define, overridable via
    -D LED_GAMMA_CORRECTION=1 or an inline edit, matching the LED_POWER_SENSE
    idiom.
    When off, showGamma() copies logical frames straight through to the output
    buffers FastLED clocks out, and the gamma LUT + gamma8() are compiled out to
    save PROGMEM. The two mirrored pedal kGamma8 tables stay byte-for-byte
    identical. led_driver's strip.gamma32() calls now return raw colors when off.
    Closes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
2026-07-18 fix(enclosure): add corner bend-relief at platform fold-line crossings (tomassasovsky/segno#235)
    * fix(enclosure): add corner bend-relief at platform fold-line crossings
    The platform flats' leg folds (y0/y1) cross the side-wing folds (x0/x1)
    with the outline vertex exactly on each intersection, so both
    bend-allowance bands overlap there and the corner tears when folded
    (Fusion 360 refuses the wing folds outright). Cut the same r=3 relief
    circles the base already uses at its corners (rrel = T+1) at the 4
    crossings in dxf_platform(), and regenerate the two platform DXFs.
    Closes tomassasovsky/segno#234
    * fix(enclosure): cap platform corner relief to clear the flange folds
    Code review caught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
    [vamp_platform_front.dxf, vamp_platform_mid.dxf]
2026-07-22 fix(enclosure): correct VAMP flat patterns per fab-flats audit (tomassasovsky/segno#238)
    * fix(enclosure): correct VAMP flat patterns per fab-flats audit
    - Exact per-flap development deduction dev_deduct() = (RI+T)*tan(a/2)-BA/2
    (1.911 at 90 deg) replacing the T+K*T over-deduction that left every
    wall ~1mm short of nominal.
    - Rear wall drawn one sheet (T) shorter so the transition flange outer
    face seats one sheet below the lid skin; lap and flange no longer
    coplanar-collide.
    - Lap shortened by KNUCKLE_CLEAR=8.5 to clear the hinge knuckle bulge.
    - Full-width lid blank (LID_W = W-0.2 = 849.8) with both bend lines full
    width; content emitted at LID_OX so apertures stay on the schedu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
    [vamp_assembly.step, vamp_base.dxf, vamp_corner_bracket_rear.dxf, vamp_faceplate.dxf, vamp_faceplate.step, vamp_overlay.dxf, vamp_platform.step, vamp_platform_front.dxf]
2026-07-22 feat(hardware): per-pedal SMD LED strips + faceplate diffuser slots (tomassasovsky/segno#240)
    width; content emitted at LID_OX so apertures stay on the s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
    [loopy_led_strip-B_Cu.gbl, loopy_led_strip-B_Mask.gbs, loopy_led_strip-B_Silkscreen.gbo, loopy_led_strip-Edge_Cuts.gm1, loopy_led_strip-F_Cu.gtl, loopy_led_strip-F_Mask.gts, loopy_led_strip-F_Paste.gtp, loopy_led_strip-F_Silkscreen.gto]
2026-07-22 feat(enclosure): shift main-board mounts 25mm for USB-C clearance (tomassasovsky/segno#242)
    width; content emitted at LID_OX so apertures stay on the sch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
    [vamp_assembly.step, vamp_base.dxf, vamp_corner_bracket_rear.dxf, vamp_faceplate.dxf, vamp_faceplate.step, vamp_led_diffuser.step, vamp_overlay.dxf, vamp_platform.step]
2026-07-22 feat(enclosure): 3D-printed pedal platforms + manufacturing package (tomassasovsky/segno#244)
    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
    [asp1_pad.step, asp1_pad.stl, asp1_pad_mould.step, asp1_pad_mould.stl, asp1_pad_pourbox.step, asp1_pad_pourbox.stl, rc20_pad.step, rc20_pad_mould.step]
2026-07-22 fix(enclosure): 16in screen aperture → 342.5×193.0 + populated CAD export (tomassasovsky/segno#252)
    width; content emitted at LID_OX so apertures stay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
    [VAMP_console_populated.f3d, vamp_assembly.step, vamp_base.dxf, vamp_corner_bracket_rear.dxf, vamp_faceplate.dxf, vamp_faceplate.step, vamp_led_diffuser.step, vamp_overlay.dxf]
2026-07-22 chore: drop Raspberry Pi GPIO backend and scrub live references (tomassasovsky/segno#258)
    * docs: mark Raspberry Pi GPIO backend as dropped
    * chore: scrub GPIO references from live code and docs
    * chore: remove the dropped Pi GPIO controls stack
    Deletes the Pi-main PCB sources (never-ordered Pi HAT), its visualization
    assembly, gerbers, design doc, and the GPIO-specific console plans (gpio_client
    footswitches, GPIO rotary encoder). Scrubs GPIO-controls content from the
    living console docs; the console itself stays, with controls via the USB-MIDI
    loopy_pedal_main board. Physical pin references (LED-driver UART on GPIO14/15,
    gpio-shutdown power button) are intentionally kept.
    * chore: fix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
    [loopy_pi_main.kicad_pcb]
2026-07-24 feat(enclosure): base-anchored posts to prop the faceplate (soft-1050 dent margin) (tomassasovsky/segno#294)
    * feat(enclosure): base-anchored posts to prop the faceplate (soft-1050 dent margin)
    The shop's STD aluminium is soft 1050 (~105 vs 193 MPa for 5052). The faceplate's
    perimeter folds already stiffen its edges, but the interior in front of the 16in
    aperture dents at only ~11 kg. Two vertical posts rise from the base floor to bear
    on that zone via felt caps: load runs faceplate -> post -> base -> floor. The posts
    anchor to the BASE only (M4 feet, clear of the intake vent), so the lid still lifts
    off and nothing shows on the visible top face.
    - new dxf_post / build_post_step (Z-fold, x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
    [vamp_base.dxf, vamp_post.dxf, vamp_post.step]
2026-07-25 fix(window): auto-hide the idle cursor on Linux console/kiosk too (tomassasovsky/segno#312)
    - new dxf_post / build_post_step (Z-fold, x2)
    - 4 M4 foot ho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
    [vamp_assembly.step, vamp_base.dxf, vamp_corner_bracket_rear.dxf, vamp_faceplate.dxf, vamp_faceplate.step, vamp_led_diffuser.step, vamp_overlay.dxf, vamp_platform_front.step]
2026-07-29 feat(enclosure): fit VAMP console to Cherub WTB-006 pedals (tomassasovsky/segno#361)
    * feat(enclosure): fit VAMP console to Cherub WTB-006 pedals
    Replace the provisional Artesia ASP-1 envelope (75x100x25, base-screw
    mount) with the caliper-measured Cherub WTB-006 (76.35x109.87, 29.3mm
    tall incl. 2.2mm anti-slip pads, side through-screws, wedge profile):
    - Pedal slots 78x103 -> 79.35x112.87; row-1 pedal centres FROZEN at the
    built layout (69..777, pitch 101.143) so screens, LED slots, LED-strip
    PCBs and the Fusion doc do not shift.
    - SCREEN_TOP_V frozen at 371; FRONT_GAP now derived (55.1) and asserted
    >= 40, so the deeper slots do not grow the console envelope.
    - Support posts POST_V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
    [vamp_assembly.step, vamp_base.dxf, vamp_corner_bracket_rear.dxf, vamp_faceplate.dxf, vamp_faceplate.step, vamp_led_diffuser.step, vamp_mini_console_lid.step, vamp_mini_console_lid.stl]
2026-07-29 docs: correct stale Pi-side LED client references (tomassasovsky/segno#364)
    The Pi-side LED client (packages/led_client + lib/led LedCubit) landed
    with the RP2040 firmware in tomassasovsky/segno#89 but was removed as unused in tomassasovsky/segno#98. The
    firmware README still linked both paths as if current, and the console
    hardware README claimed the status LEDs are driven over UART "as
    before". Mark the Pi side as removed (recoverable from 94699e89 or to
    be rewritten against the wire format at console-integration time) and
    keep the firmware README as the driver + wire-format spec.
2026-07-30 feat(pedal): protocol v3 wire — 2-bit mode field, mode indicator, version discovery (tomassasovsky/segno#399)
    * feat(pedal): protocol v3 wire — 2-bit mode field, mode indicator, version discovery
    Implements FX system v3 part 5a (docs/plan/2026-07-28-feat-fx-system-v3-part-5a-plan.md).
    - Codec v3: 2-bit interaction mode (PedalMode.fx) in existing payload bits —
    no wire growth; reserved fourth value rejected; PedalTrackLed.blue reserved
    for 5b's chain-state projection.
    - B10 downgrade projection at codec level: fx encodes as play at v1/v2,
    every other byte identical to the v3 twin.
    - R6 never-encode-above-negotiated: encode default pinned at v2;
    PedalRepository resolves targetP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
2026-08-04 feat: rebrand Loopy to Segno (tomassasovsky/segno#497)
    * feat: rebrand Loopy to Segno across app, engine, and appliance
    Rename packages, bundle IDs, icons, deploy/firmware paths, and USB/enclosure
    identity to Segno so the product no longer collides with Loopy/Loopy Pro.
    * fix(ci): drop review markdown from spell-check and allow Segno plan words
    Ephemeral code-review notes were failing cspell on **/*.md; keep the rebrand
    plan and dictionary entries instead.
    * fix(ci): keep code-review notes out of the tree
    Spell-check gates **/*.md; local review scratch stays gitignored.
    [Segno_console_populated.f3d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]
2026-08-04 feat(enclosure): LED pills on every pedal + flush-at-rim seating (tomassasovsky/segno#368)
    * feat(enclosure): LED pills on every pedal + flush-at-rim seating
    Port tomassasovsky/segno#366 and tomassasovsky/segno#373 onto the Segno-named generator after the rebrand:
    pill indicators above all ten pedals with CLEAR/BANK label-top alignment,
    and pedestal heights that put the case top flush with the slot upper rim.
    * chore: nudge CI after retarget to master
    [segno_assembly.step, segno_base.dxf, segno_corner_bracket_rear.dxf, segno_faceplate.dxf, segno_faceplate.step, segno_led_diffuser.step, segno_mini_console_lid.step, segno_mini_console_tray.step]
2026-08-04 feat(enclosure): paint-quote drawing pack for powder coaters (tomassasovsky/segno#397)
    Add a supplier-facing Spanish quote sheet with painted area by part and
    masking rings for PEM threads and the earth-stud bonding land. Derived
    from the generated DXFs so the m2 total cannot drift from the model.
    [segno_base.dxf, segno_corner_bracket_rear.dxf, segno_faceplate.dxf, segno_overlay.dxf, segno_post.dxf, segno_rear_panel_nopi.dxf, segno_rear_panel_pi.dxf, segno_ring_disc.dxf]
2026-08-07 fix(enclosure): the mini tray printed on 2.5% of its footprint (tomassasovsky/segno#545)
    * fix(enclosure): the mini tray printed on 2.5% of its footprint
    It warped at the sides because it was never really on the bed. Four printed
    14 x 14 feet were the lowest geometry, so a 199 x 156 mm part gripped over
    784 mm2 and the whole floor started as a 30,100 mm2 layer 2 mm up in the air.
    Every mm of contraction pulled on four pads, and the free edges - 40 to 91 mm
    from the nearest anchored column - curled.
    The feet bought nothing: the screw heads already recess above the floor plane,
    so they never touched the table anyway. They are gone, rubber feet locate in
    shallow recesses instead, and the floo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
    [segno_mini_console_assembly.step, segno_mini_console_lid.step, segno_mini_console_lid.stl, segno_mini_console_tray.step, segno_mini_console_tray.stl]
2026-08-16 fix(engine): the x86 include path and the macOS forwarders CI needs (tomassasovsky/segno#720)
    Two independent breaks on master, both invisible on an arm64 dev machine:
    - x86 hosts pull rnnoise's vec_avx.h, whose x86/x86cpu.h includes
    "common.h" relative to src/x86/ and misses the header one level up.
    Upstream builds with src/ on the include path; now so do the CMake
    target and the native test runner. Broke native-tests, native-tests-asan
    and build-linux from tomassasovsky/segno#699 onward — the ARM dev path never reaches it.
    - The macOS SPM and CocoaPods forwarder sets never gained engine_cond.c
    (tomassasovsky/segno#700), restore_declip.c or restore_halfband.c (tomassasovsky/se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
    [segno_pedal_base_gauge.dxf]
2026-08-18 feat(enclosure): fit-test jig for the pedal's base screw holes (tomassasovsky/segno#717)
    * feat(enclosure): fit-test jig for the pedal's base screw holes
    The WTB-006's underside carries four M3-ish holes we want to bolt the pedal
    down through, retiring the pedestal's provisional gravity+pocket retention.
    The holes sit under the anti-slip pad, so both rows are dimensioned off the
    side screw axis -- the only datum findable without pulling the pad.
    Before those numbers get cut into the real pedestal decks as insert bores,
    prove them on a throwaway print: a plate carrying only the four locating pins
    and the two side columns that capture the horizontal screw bosses (the same
    SKIRT_BOSS_CH_* cha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
    [segno_assembly.step, segno_base.dxf, segno_corner_bracket_rear.dxf, segno_faceplate.dxf, segno_faceplate.step, segno_led_diffuser.step, segno_mini_console_assembly.step, segno_mini_console_lid.step]
2026-08-18 feat(hardware): console_board.py — the console board v2 netlist, gated (tomassasovsky/segno#749)
    * feat(hardware): console_board.py — the v2 netlist, gated
    Part 3 of tomassasovsky/segno#747. 49 components, 39 nets, ZERO ERC errors and zero warnings.
    Six negative controls, each biting its own gate.
    THE PICO DELETED THE LEVEL-SHIFTING PROBLEM. segno_wiring.md section 2b
    specifies a 1k8/3k3 divider plus an AHCT gate on the MCU link. That was
    written for a Pro Micro at 5 V against a Pi that is not 5 V tolerant. The
    RP2350 is 3.3 V, the SAME as the Pi, so the link is a direct wire both ways
    -- no divider, no buffer, nothing to get wrong. Choosing the Pico dissolved
    the problem rather than s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
    [console.placed.kicad_pcb, segno_assembly.step, segno_base.dxf, segno_console_board.kicad_pcb, segno_console_board.step, segno_console_board_bom.csv, segno_corner_bracket_rear.dxf, segno_faceplate.dxf]
2026-08-18 fix(hardware): console board v2 review follow-ups -- idle states, gate gaps, doc drift (tomassasovsky/segno#756)
    * fix(hardware): the gates learn the resistive failure, and _check() stops repeating itself
    Review follow-ups on the v2 board (tomassasovsky/segno#747), the checking half:
    RING_LEVELS is new. PICO_LEVELS and PI_LEVELS check nets that TOUCH 5 V
    directly -- but the failure that motivated them (ring_board's 10k pull-ups to
    its 5 V rail, 1.4 V over the RP2350's absolute maximum) bridges two nets
    through a resistor, which keeps them separate and both gates green. And
    RING_CONTRACT cannot see it either: a re-added pull-up changes no pin's net,
    so the positional map stays clean. The ne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
    [console.placed.kicad_pcb, segno_combined_bom_lcsc.csv, segno_console_board.kicad_pcb, segno_console_board.step, segno_console_board_bom.csv, segno_pedal_ring.kicad_pcb]
2026-08-18 feat(enclosure): the rear I/O panel comes off again, centred on the 16in screen (tomassasovsky/segno#757)
    * feat(enclosure): the rear I/O panel comes off again, centred on the 16in screen
    Re-land of c2f9ab06 (reverted with the Fusion CAD-flat experiment, not on its
    merits), adapted to everything that landed since: the PD-era station list
    (PD_IN's D punch supersedes the 9 V barrel), the two-buck BUCK_SPLIT gates,
    and the review-loop's grounding-doc edits -- the stud list now carries BOTH
    the panel's single-bolt bond rule and the 20 V PD / buck-shell items, and the
    bench audit checks the panel's masked bolt alongside the buck shells.
    Original design, unchanged: the wall gets a window and a b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
    [segno_assembly.step, segno_base.dxf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]
2026-08-18 docs(enclosure): faceplate anchor + lid-stack move rule in FUSION_MODELS (tomassasovsky/segno#759)
    * docs(enclosure): faceplate anchor + lid-stack move rule in FUSION_MODELS
    The Fusion docs' lid stack sat 2mm rearward (old base frame) and the
    populated base had lost its +0.2 z. Both fixed in the cloud docs; this
    records the canonical faceplate transform, the lid-stack-moves-together
    rule, and the known ~0.9mm lip kiss-fit residual (missing bend deduction
    in dxf_faceplate, not a placement bug).
    * chore: add hardware doc terms to the cspell dictionary
    Aluminio/bboxes (FUSION_MODELS), Gbps/STUSB/PMIC/UPERFECT/unbonded
    (wiring + shopping docs) landed with the console-board stack while the
    spe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
2026-08-20 fix(enclosure): lid development fixes -- pedal apertures, front wall knuckle, lid seat (tomassasovsky/segno#760) (tomassasovsky/segno#761)
    * fix(enclosure): pedal apertures get the lid development offset (tomassasovsky/segno#760)
    The platform stack converts lid-v to plan as v*cos(SLOPE), but the
    developed lid's content v=0 lands at plan -(DEV90+T)+DD_LIP*cos, not 0
    (rear-seam solver, tomassasovsky/segno#237). Raw-v apertures therefore cut ~2.6mm forward
    of the pedals the floor actually places, and the pedal rear edge fouls
    the slot. PEDAL_AP_DEV carries the correction on the 10 slot cuts only;
    labels, LED pills, screens and the whole platform stack keep the frozen
    approved layout. Outputs r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
    [screen7_module_measured.step, segno_assembly.step, segno_base.dxf, segno_corner_bracket_rear.dxf, segno_faceplate.dxf, segno_faceplate.step, segno_led_diffuser.step, segno_mini_console_assembly.step]
2026-08-20 chore(enclosure): make the verifiers check the real metal (tomassasovsky/segno#767) (tomassasovsky/segno#771)
    Items 1-4 of the 2026-08-19 review sweep -- the verifier-integrity debt the
    owner wants closed BEFORE the metal order. All four are the same disease: a
    verifier checking a frozen copy instead of the geometry it is meant to police.
    No fab dimension changes except POST_H, and that moves 0.026 mm.
    1. _fold_from_dxf: the ring stack (lid_ring / lid_ringmetal / lid_knob) was
    placed at PEDAL_ROW2_V, but faceplate_holes() cuts RING/ENCODER at ENC_V --
    the encoder deliberately does NOT follow CLEAR/BANK rearward. The fold
    render and the collision audit were checking the ring 35.5 mm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
    [segno_assembly.step, segno_base.dxf, segno_corner_bracket_rear.dxf, segno_faceplate.dxf, segno_faceplate.step, segno_led_diffuser.step, segno_mini_console_assembly.step, segno_mini_console_lid.step]
2026-08-21 fix(enclosure): the fold audit's 28 collisions were two verifier bugs (tomassasovsky/segno#767) (tomassasovsky/segno#772)
    The revived fold audit (tomassasovsky/segno#771) reported 28 ERRORs nobody had ever seen. None
    of them is real interference -- the metal is fine. Both causes were in the
    verifier itself:
    1. The pedal stand-in was built in WORLD axes but placed in the PEDESTAL
    frame, missing the 90-degree spin the ring and sled under it get. So
    PEDAL_D (109.87) lay across u, where the pedals are pitched 101.14 apart:
    ten placeholders each 8.73 too wide, overlapping their neighbours and
    ploughing into their own tub walls. That is the whole pedal<->pedal
    (16591 mm^3 x9) and r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
    [segno_assembly.step, segno_base.dxf, segno_corner_bracket_rear.dxf, segno_faceplate.dxf, segno_faceplate.step, segno_led_diffuser.step, segno_mini_console_assembly.step, segno_mini_console_lid.step]
2026-08-21 fix(console): mute mode wears green everywhere (tomassasovsky/segno#714)
    * fix(console): mute mode wears green everywhere
    The mode named `play` in the issue is today's `InteractionMode.mute`
    (renamed after the Sheeran manual; `fromToken` still accepts the legacy
    `'play'`). On screen it read as the theme's near-white primary on every
    surface that shows it, which says nothing about what a track press does.
    Mute now wears the design system's `success` green (#30A46C dark /
    #6EE7B7 high-contrast) — the same green the pen draws PLAY state words
    in, and the same one the mute-mode track LEDs and meters already use, so
    the mode word and the tracks it describes finally agree.
    Four surfaces moved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
2026-08-21 feat(hardware): Cherub silent switch platform, exported from Fusion (tomassasovsky/segno#729) (tomassasovsky/segno#769)
    The part is hand-authored in the Fusion document 'Cherub WTB-006 silent
    switch platform'; this commits its STEP + STL exports (66.85 x 57.38 x
    10.60 mm) as the deliverable, with a README pinning the source of truth and
    the re-export recipe.
    Supersedes the abandoned CadQuery generator (PR tomassasovsky/segno#764, closed): its default
    PIN_CLEARANCE built a 12.1 mm box whose stem overshot the pedal interior by
    ~3 mm so the lid could not close, and the clearance question was never
    settled. The Fusion part solves it at 10.60 mm. Refs tomassasovsky/segno#729 -- the issue stays
    o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
    [switch_platform.step, switch_platform.stl]
2026-08-21 fix(enclosure): the drawings hid 127 vent louvres and called the steel post aluminium (tomassasovsky/segno#775) (tomassasovsky/segno#777)
    The tomassasovsky/segno#775 DFM sweep found six RED items, and all six live in the document path,
    not the geometry engine. `_check()` gates the geometry hard; nothing gated the
    drawings or the vendor packages at all.
    - R1 `dxf_to_pdf` forced only `CUT` black, so `VENT` (ACI 7) rendered white on a
    white sheet: 127 louvres, 18 425 mm2, ~5.6 m of cut path invisible on every
    PDF ever generated. `_force_pdf_layer_colours()` now blackens every declared
    through-cut layer and asserts that no geometry layer is left at ACI 7.
    Measured at 300 dpi in the DXF'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
    [segno_assembly.step, segno_base.dxf, segno_corner_bracket_rear.dxf, segno_faceplate.dxf, segno_faceplate.step, segno_led_diffuser.step, segno_mini_console_assembly.step, segno_mini_console_lid.step]
2026-08-21 feat(enclosure): the drawings speak Spanish, and every sheet states its tolerances (tomassasovsky/segno#780)
    The parts are fabricated in Argentina. Every instruction on the drawing package
    was English, and a fold direction read off a flat pattern is exactly the kind of
    sentence a shop cannot afford to half-understand. All of it is now Spanish, and
    every sheet-metal sheet carries a general tolerance block it never had.
    Translated (everything a fabricator reads and acts on):
    - per-part NOTE strings on all seven flat patterns, plus the small in-drawing
    labels (buck bricks, Pi risers, support-post feet);
    - the layer legend, the bend-table heading, its column headers, every fold-line
    name an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
    [segno_assembly.step, segno_base.dxf, segno_corner_bracket_rear.dxf, segno_faceplate.dxf, segno_faceplate.step, segno_led_diffuser.step, segno_mini_console_assembly.step, segno_mini_console_lid.step]
2026-08-21 fix(enclosure): front-lip fit spec, in Spanish on the lid drawing (tomassasovsky/segno#775) (tomassasovsky/segno#781)
    The lid's front lip is drawn landing FLAT against the front wall -- measured
    lid-to-base minimum distance 0.0000 mm. Both are outside faces and everything
    is coated (no masking), so as drawn the joint is ~0.16 mm of interference
    before any tolerance, on the one seam that cannot be reworked after finishing.
    Fixed as a FIT, not a dimension. Moving it in geometry was tried and reverted:
    _cfy sets the flange LENGTH, not its standoff (raising it pushes the lip tip
    below the base floor). Real standoff would mean shifting the floor's front bend
    line -- re-basing every feature on th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
    [segno_assembly.step, segno_base.dxf, segno_corner_bracket_rear.dxf, segno_faceplate.dxf, segno_faceplate.step, segno_led_diffuser.step, segno_mini_console_assembly.step, segno_mini_console_lid.step]
2026-08-21 chore(hardware): archive the gerbers the console board was actually built from (tomassasovsky/segno#775) (tomassasovsky/segno#782)
    The console board v2 was sent to fab on 2026-08-18 using a gerber set that
    carries the silkscreen artwork. That art lives only as source on the unmerged
    tomassasovsky/segno#758 branch, and that branch never produced gerbers -- so the files that
    actually became physical boards existed NOWHERE in this repo. Nothing here
    could answer 'what is on the boards in my hand', and a reorder would have
    silently shipped a different (art-less) board.
    Archived byte-for-byte as sent, MD5 6cdc396eb4935da1697c3c0e71a23171, with a
    README recording how it relates to the repo. Verif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
2026-08-21 feat(hardware): pin the SKiDL toolchain for the console board generators (tomassasovsky/segno#747) (tomassasovsky/segno#783)
    Rebase of tomassasovsky/segno#748 onto master (it had drifted into conflict; only the cspell
    dictionary actually clashed, resolved by unioning both word lists -- 818
    words, JSON re-validated, no duplicates).
    Pure toolchain, nothing electrical:
    - hardware/kicad/requirements.txt pinning skidl==2.3.0. It was installed
    NOWHERE in the repo; the committed .net files were generated ad hoc, so a
    clean checkout could not reproduce them.
    - hardware/kicad/.gitignore gains .venv/ and __pycache__/ -- it covered *.erc
    and fab intermediates but not virtualenvs, so the first co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
2026-08-21 feat(hardware): the console board wears its own score -- silkscreen art (tomassasovsky/segno#784)
    Replaces tomassasovsky/segno#758, rebased onto master and with the gerbers regenerated so the
    repo can actually rebuild the boards that were already manufactured.
    The console board's silkscreen becomes a composition, generated from the
    project's own faces (Bravura's segno mark, SMuFL U+E047; JetBrains Mono).
    Front: the segno mark over the wordmark, in the clear pocket left of the 5V
    header. Back: a five-line staff with repeat dots running the full width,
    broken around the pads; a 32 mm segno centrepiece with the pad keep-outs
    boolean-carved out of the glyph (+0.8 mm clearance) so the mark flow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
    [segno_console_board-B_Cu.gbr, segno_console_board-B_Mask.gbr, segno_console_board-B_Paste.gbr, segno_console_board-B_Silkscreen.gbr, segno_console_board-Edge_Cuts.gbr, segno_console_board-F_Cu.gbr, segno_console_board-F_Mask.gbr, segno_console_board-F_Paste.gbr]
2026-08-21 docs(hardware): correct the fab record -- master's mask gerbers were stale, not differently exported (tomassasovsky/segno#785) (tomassasovsky/segno#786)
    The archive README claimed the manufactured mask differed from the repo's
    because of a KiCad export option. That was wrong, and tomassasovsky/segno#784 proved it:
    re-exporting the repo's OWN unmodified board reproduces the manufactured
    G36/G37 region form byte-for-byte. Master's committed mask gerbers were simply
    stale, left in the older aperture-flash form. Opening count and position never
    differed (239 front, 196 back).
    Also updated the reorder guidance. It said a regeneration might not reproduce
    the art because the composer places it by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
2026-08-26 feat(hardware): ring 24 window + knob, symbol transport legends, LEDs only where they mean something (tomassasovsky/segno#792)
    * feat(hardware): ring 24 window + knob, symbol transport legends, LEDs only where they mean something (tomassasovsky/segno#791)
    Three owner-requested faceplate changes.
    RING 24. The owner's ring is the 24-pixel one (O65.5/O52.3/3.2), not the Ring 16
    the generator was cut for: RING_OD 46->67, RING_ID 31->51.5, and the ring
    diffuser's hardcoded back-plate radii re-derived so the CA-glue land survives at
    4.0 mm. The wider window left a bare gap inside the lit annulus, so the approved
    O50x13 knob becomes a generated part -- reproduced from the approved STEP's
    measured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
    [segno_assembly.step, segno_base.dxf, segno_base.step, segno_corner_bracket_rear.dxf, segno_corner_bracket_rear.step, segno_encoder_knob.step, segno_encoder_knob.stl, segno_faceplate.dxf]
2026-08-26 chore(enclosure): make out/ match the artifact policy (tomassasovsky/segno#236) (tomassasovsky/segno#856)
    Untrack the scratch renders (out/_*), 3D viewer bundles, per-quote vendor
    zips, and out/quote_pkg/ (110 files, ~64 MB) — kept on disk, regenerated on
    demand by segno_enclosure.py / build_quote_packages(). The canonical per-part
    DXF/PDF/STEP/STL outputs plus rear_io_stations.json and the encoder-knob
    reference model stay tracked (71 files, ~15 MB).
    Rewrite hardware/enclosure/.gitignore in segno-era names: drop the seven dead
    vamp_* rules, add class rules (out/*.png/svg/glb/gltf/bin/zip, the viewer
    HTML, out/quote_pkg/) and a policy comment block, so tracked-set and ignore
    rules now par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
    [_test_shell.stl, segno_base.dxf, segno_corner_bracket_rear.dxf, segno_faceplate.dxf, segno_platform_front.dxf, segno_platform_mid.dxf, segno_rear_panel_pi.dxf, segno_ring_disc.dxf]
2026-08-27 chore(enclosure): dedup RESEAT_CAL + FRONT_SCREW_Z, purge stale design.md rows (tomassasovsky/segno#866)
    Slice 1 of the tomassasovsky/segno#767 generator-debt batch (items 13, 8, 5), landing before the
    tomassasovsky/segno#762 caliper batch. All three changes are zero geometry delta by construction
    and proven so by a same-environment before/after generator diff (25/25 STL
    byte-identical, 8/8 DXF entity-identical, 29/29 STEP DATA-section identical).
    - Item 5 (RESEAT_CAL): the 0.443 reseat recal was pasted at RING_FLOOR and
    FACE_SEAT. Named once as RESEAT_CAL and substituted at both. Kept a frozen
    literal (= round(2*tan(SLOPE_ANGLE), 3)) so the platform heights stay
    bit-for-bit what is a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
2026-08-27 feat(pedal): breathe the idle LED ring in standby (tomassasovsky/segno#872)
    * feat(pedal): breathe the idle LED ring in standby
    Take master's ring — the colored activity sweep (rec red / overdub amber /
    play green) that fades to dark — and add a standby breathe: with no activity
    and no loop, the ring pulses green instead of the dim idle-glow sweep, so it
    reads as alive at rest. Any activity, freeze, or goodbye is untouched.
    Both firmware sketches (UNO + 32u4) and the on-screen twin breathe with the
    same eased 2400 ms cycle. Tests that pumpAndSettle the plate move to bounded
    pumps, since the breathe never settles.
    Closes tomassasovsky/segno#871
    * fix(pedal): address code-review on the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
2026-08-29 fix(hardware): the pedal name tiles are trapezoids, because the pad is (tomassasovsky/segno#923)
    * fix(hardware): the pedal name tiles are trapezoids, because the pad is (tomassasovsky/segno#922)
    54.45 was a transcribed constant. It entered tomassasovsky/segno#795 as a given -- "the WTB-006's
    top pad has a 54.55 x 20 window" -- and nothing ever derived it. The rule the
    owner actually gave is 5 mm of pad each side, ALWAYS, and the WTB-006 is a wedge
    IN PLAN as well as in height. A constant width can therefore only be right at one
    station along the tile's length, and is wrong at both of its ends.
    That is not cosmetic. The fit is a 0.05/side press into compliant rubber -- a
    clearance chosen i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
    [segno_pedal_tile_BANK.step, segno_pedal_tile_BANK.stl, segno_pedal_tile_CLEAR.step, segno_pedal_tile_CLEAR.stl, segno_pedal_tile_MODE.step, segno_pedal_tile_MODE.stl, segno_pedal_tile_REC_PLAY.step, segno_pedal_tile_REC_PLAY.stl]
2026-08-30 feat(hardware): 2-ply engraved-plastic vector pack for pedal name tiles (tomassasovsky/segno#949)
    Give the laser shop a CUT/ENGRAVE nest from the same trapezoid and glyphs as the FDM tiles, so a cut plate can be quoted without mixing it into sheet metal or overlay.
    [segno_pedal_tile_BANK.dxf, segno_pedal_tile_CLEAR.dxf, segno_pedal_tile_MODE.dxf, segno_pedal_tile_REC_PLAY.dxf, segno_pedal_tile_STOP.dxf, segno_pedal_tile_TRACK1.dxf, segno_pedal_tile_TRACK2.dxf, segno_pedal_tile_TRACK3.dxf]
2026-09-04 feat(hardware): temporary snap-on diffuser for the NeoPixel Ring 16 (tomassasovsky/segno#936)
    * feat(hardware): temporary snap-on diffuser for the NeoPixel Ring 16
    Clips onto the ring module itself -- no faceplate, no standoffs, no glue --
    and leaves the centre open for the EC11 encoder's bush, nut and knob. Three
    cantilever fingers hook the PCB underside, clocked into the gaps between the
    ring's four back-side solder pads (79/124/214/304 deg, read out of
    ModuleMountPads_4, which was extracted from Adafruit's own board file).
    Distinct from the console ring window, which is a faceplate cut over a
    Ring 24 (tomassasovsky/segno#791/#794); the two do not interchange.
    _check_clearances() probes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
    [segno_ring16_diffuser.step, segno_ring16_diffuser.stl, segno_ring16_diffuser_skirt.step, segno_ring16_diffuser_skirt.stl]
2026-09-04 feat(hardware): ten LED pills, row 2 on the 16in line, and the sheet-metal package proven against Fusion (tomassasovsky/segno#928)
    Closes tomassasovsky/segno#927
    Closes tomassasovsky/segno#930
    Closes tomassasovsky/segno#796
    Ten LED pills on every pedal on a 144/m strip in a snap-in diffuser; CLEAR/BANK on the 16in aperture's front edge; LED_GAP 16; POST_PW derived; corner-bracket rivets developed for the fold; stadium slots without zero-length vertices; 1050 aluminium on every sheet; steel post flat developed; process and M4 notes on the base sheet; ring diffuser open over the LED circle. Both Fusion docs rebuilt and every fastener hole proven coaxial (tomassasovsky/segno#992). Review findi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
    [segno_assembly.step, segno_base.dxf, segno_corner_bracket_rear.dxf, segno_encoder_knob.step, segno_faceplate.dxf, segno_faceplate.step, segno_led_diffuser.step, segno_led_diffuser.stl]
2026-09-04 feat(hardware): CTRL jacks are Neutrik NJ6FD-V, and the pre-order re-review fixes (tomassasovsky/segno#994)
    Closes tomassasovsky/segno#993
    CTRL jacks: Neutrik NJ6FD-V through a O12 hole; rear panel 1.5 mm 1050. Re-review fixes: corner-bracket rivets RI higher (bracket floats on the bend's inside radius), O3.3 rivet holes, post flat developed from outer lengths with the bolts 5 mm in from the foot edges, ring diffuser plate 1.2 mm with the disc lip attached, 1050 on every shop-facing string, readable shop notes on every sheet. Both Fusion docs rebuilt; every fastener hole coaxial; two independent reviews with all findings closed.
    [segno_assembly.step, segno_base.dxf, segno_corner_bracket_rear.dxf, segno_encoder_knob.step, segno_faceplate.dxf, segno_faceplate.step, segno_led_diffuser.step, segno_mini_console_assembly.step]
2026-09-04 fix(hardware): the drawings printed the part too small and the bend lines solid
    Three legibility defects on the sheets that go to the shop. No cutting geometry
    changes: every CUT / BEND / VENT / ENGRAVE / SILK entity is byte-identical, and
    the only moved entity in the whole package is one NOTE-layer dimension bracket
    on the tile nest.
    Notes squeezed the part off its own drawing. Each was ONE model-space TEXT
    entity, model-space text has real width, and the sheets are auto-fitted to
    everything in model space -- so the note, not the part, set the page scale. The
    post's note measured 2909 mm beside an 83 mm part and the part rendered at 3% of
    the page with no readable dimension. _note() now wr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
    [segno_base.dxf, segno_corner_bracket_rear.dxf, segno_faceplate.dxf, segno_overlay.dxf, segno_pedal_tile_BANK.dxf, segno_pedal_tile_CLEAR.dxf, segno_pedal_tile_MODE.dxf, segno_pedal_tile_REC_PLAY.dxf]
2026-09-04 fix(hardware): a code review found two of these drawings still unusable
    Follow-up to the same issue. Both defects reach the shop.
    The paint-quote masking pages lost the end of their red instruction, mid-word.
    `paint_quote_pdf` writes its footer with a fixed point size, but `_draw_dxf`
    finalises through the ezdxf backend, which resizes the figure to the data
    aspect. Wrapping the notes narrowed those pages from 1152 pt to 577, and
    matplotlib neither wraps nor clips overflowing fig.text -- it just stops
    drawing, silently. The CUERPO page read "...los agujeros piloto d", losing "e
    la transición se roscan M3 después de pintar": the one instruction that page
    exists to give, on the only body we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
    [segno_base.dxf, segno_corner_bracket_rear.dxf, segno_faceplate.dxf, segno_overlay.dxf, segno_pedal_tile_BANK.dxf, segno_pedal_tile_CLEAR.dxf, segno_pedal_tile_MODE.dxf, segno_pedal_tile_REC_PLAY.dxf]
2026-09-04 fix(hardware): close the gaps the re-review found in the drawing guards
    The re-review confirmed both shop-reaching defects fixed and nothing new broken.
    What it found instead were holes in the new guards themselves, which matter
    because these guards are the only thing standing between a future edit and
    another unusable sheet.
    `_run_length` answered 0.0 for anything it did not recognise, and both the
    fixer and the verifier skipped on that. A MASK ellipse or a BEND spline would
    therefore be scaled by nobody, checked by nobody, and print as a solid closed
    contour with every assertion green -- exactly the failure this work exists to
    prevent, one entity type sideways. It now measures POLYLINE, E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
    [segno_base.dxf, segno_corner_bracket_rear.dxf, segno_faceplate.dxf, segno_overlay.dxf, segno_pedal_tile_BANK.dxf, segno_pedal_tile_CLEAR.dxf, segno_pedal_tile_MODE.dxf, segno_pedal_tile_REC_PLAY.dxf]
2026-09-04 fix(hardware): the guards had holes, including one I had told myself was closed
    Round 3 confirmed nothing in commit 3 reaches the shop. What it found were four
    more ways past the guards, and one number I got wrong and then repeated.
    _verify_note_block_fits measured the note with a per-character advance estimate
    instead of measuring it. That read every sheet at 0.78-0.83 of its part and I
    reported that as headroom. Measured with `extents` -- the same call that decides
    the sheet scale -- the real figures are 0.88 to 1.15, the rear panel and all ten
    single tiles already ship notes WIDER than their part, and the 1.05 ceiling was
    about 1.5x looser than it claimed. A 70-character token on the bra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
    [segno_base.dxf, segno_corner_bracket_rear.dxf, segno_faceplate.dxf, segno_overlay.dxf, segno_pedal_tile_BANK.dxf, segno_pedal_tile_CLEAR.dxf, segno_pedal_tile_MODE.dxf, segno_pedal_tile_REC_PLAY.dxf]
2026-09-04 fix(hardware): two of the last commit's fixes did not work, and one was a no-op
    Round 4 confirmed nothing in commit 4 reaches the shop and every printed
    measurement got better or stayed identical. It also caught two claimed fixes
    that were not fixes.
    The ltscale-zero guard was a NO-OP. `float(ls) if ls else 1.0` is the same
    expression as `float(ls or 1.0)`; I rewrote the spelling and claimed a fix
    without testing it, which is precisely how the thing I was fixing shipped in the
    first place. Truth-tabled: identical for 0.0, 1.0, 0.5 and None. It now asserts
    `> 0` instead of substituting 1.0. Verified through a real file round-trip, not
    by poking an attribute: ezdxf's setter clamps 0 to 1.0, s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
    [segno_base.dxf, segno_corner_bracket_rear.dxf, segno_faceplate.dxf, segno_overlay.dxf, segno_pedal_tile_BANK.dxf, segno_pedal_tile_CLEAR.dxf, segno_pedal_tile_MODE.dxf, segno_pedal_tile_REC_PLAY.dxf]
2026-09-04 fix(hardware): the coater never got the rear panel, and three sheets printed at 1.1 mm
    Round 5 was a whole-package go/no-go. It found one functional defect in the
    coater package and one legibility regression from this branch's first commit.
    segno_rear_panel was in no part of the paint package: no row in the parts table,
    no masking page. Its own drawing carries the only instruction that matters for
    it -- the O12 PANEL_BOND land stays bare, on the face that meets the body, or
    the chassis loses its earth -- and the coater never received that page. They
    would have painted over the land, and the area quote was 4% short as well. It
    now has a BOM row and its own masking page, and _verify_paint_bom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
    [segno_base.dxf, segno_corner_bracket_rear.dxf, segno_faceplate.dxf, segno_overlay.dxf, segno_pedal_tile_BANK.dxf, segno_pedal_tile_CLEAR.dxf, segno_pedal_tile_MODE.dxf, segno_pedal_tile_REC_PLAY.dxf]
2026-09-04 fix(hardware): the rest of the round-5 findings, and one left for the owner
    Follow-up to the same round. Everything here is pre-existing rather than from
    this branch, but round 5 was the whole-package go/no-go, so it is the right time.
    The NO CORTAR callouts were a fixed 4.5 mm of model text. That is fine on the
    400 mm rear panel and prints 0.82 mm on the 1040 mm base -- the smallest text on
    that sheet, on the one annotation whose entire job is to stop somebody drilling
    the earth land. Sized to the part now, like the notes: 6.1 mm on the base, and
    the smallest text on that sheet is 2.50 mm.
    Paint quote note 7 read "La tapa figura con su tamaño en DESARROLLO (850 x 407 x
    2)". 850 x 407 is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
    [segno_base.dxf, segno_corner_bracket_rear.dxf, segno_faceplate.dxf, segno_overlay.dxf, segno_pedal_tile_BANK.dxf, segno_pedal_tile_CLEAR.dxf, segno_pedal_tile_MODE.dxf, segno_pedal_tile_REC_PLAY.dxf]
2026-09-05 fix(hardware): the drawings printed the part too small and the bend lines solid (tomassasovsky/segno#1002)
    Keep parts readable on shop sheets, preserve visible bend and mask patterns, wrap file notes, and separate tile dimensions and captions. Complete the rear-panel coating instructions and fail requested PDF rendering before packaging.
    Integrated the corrected tray dependency from tomassasovsky/segno#1005. Protected fabrication geometry is unchanged across 19 DXFs. All 19 PDFs / 22 pages were visually inspected, 44 focused CAD/PDF checks passed, all five independent reviews are clean, and all 20 checks passed on 72f3c24b.
    Closes tomassasovsky/segno#1001
    [segno_base.dxf, segno_corner_bracket_rear.dxf, segno_faceplate.dxf, segno_overlay.dxf, segno_pedal_tile_BANK.dxf, segno_pedal_tile_CLEAR.dxf, segno_pedal_tile_MODE.dxf, segno_pedal_tile_REC_PLAY.dxf]
2026-09-10 chore(hardware): snapshot the in-flight sheet-metal release work
    Everything since 69b51d04 lived only as uncommitted working-tree changes: the
    1.2 mm rear panel, Ø6.5 corner reliefs and edge trims, the nine front shims,
    the USB four-flat profile, the straight Ø8.50 encoder bore, the split
    CLEAR/BANK platform mounting, the closed stadium cable openings, the thicker
    collar walls, the eleven extra floor supports, the formed-STEP exporter, the
    test suite under hardware/enclosure/tests and the review records under
    docs/reviews.
    Committed as-found so none of it can be lost before the load-rating fixes land
    on top. The regenerable per-quote bundles under out/ are deliberately left
    untracked, per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
    [segno_assembly.step, segno_base.dxf, segno_base.step, segno_base_flat.dxf, segno_buck_envelope.step, segno_buck_reference.step, segno_corner_bracket_rear.dxf, segno_corner_bracket_rear.step]
2026-09-10 docs(hardware): rated-load analysis says the base plate cannot take a stomp
    Refs tomassasovsky/segno#1019
2026-09-10 fix(hardware): carry the stomp to the floor, and prop the whole lid band
    Three fixes for the rated-load finding.
    The floor. A stomp ran pedal -> sled -> collar -> 4x M3 -> the 2.0 mm base
    plate -> whichever rubber foot was nearest, and the feet sit in the gaps
    BETWEEN pedals: 353 MPa and 23 mm of travel at 1 kN, first yield near 360 N.
    Every pedestal's four chassis screws already come up through the floor from
    below, so pedestal_foot_xy() now puts a foot on each of them and the load
    goes straight to the ground -- 89 MPa, 1.4 mm, first yield near 1425 N, and
    86 MPa with any one of the four not touching. No new bores: test_pedestal_feet
    reads a freshly generated segno_base.dxf back and proves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
2026-09-10 feat(hardware): a printed prop for the one mid-field ligament that has room
    The seven band posts leave two deep ligaments bare. Only one can be propped:
    on the left the 7in tower's right leg ends at u 213.6 and the CLEAR pedestal
    starts at 226.9, and 13.3 mm is not a column, so that one is recorded as a
    residual at 11 kg rather than fixed.
    segno_lid_prop is printed, not folded steel -- it is a pure compression member,
    so PETG is an order of magnitude stiffer than it needs to be and it costs a
    print instead of a shop part number. It splits the 31.5 mm lane between BANK's
    pedestal and the 16in MODULE BODY, which is wider than its aperture; _check()
    gates both walls of that lane, the pad again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
    [segno_base.dxf, segno_buck_envelope.step, segno_buck_reference.step, segno_corner_bracket_rear.dxf, segno_corner_bracket_rear_mirrored.dxf, segno_encoder_knob.step, segno_faceplate.dxf, segno_led_diffuser.step]
2026-09-10 docs(hardware): record what tomassasovsky/segno#1019 changes in the two Fusion documents
    Feet go 15 -> 60, posts 2 -> 7 with the last two nudged 0.29/0.43 mm, and the
    printed prop needs a real +90 deg rotation rather than an axis swap or Fusion
    takes the mirror silently.
    Two traps are written down because both cost real time here:
    addExistingComponent applies its matrix relative to the source component's own
    placement, and the VENT sketch has to follow the feet -- the generator drops any
    slot under a foot, so spreading the posts removed 21 of them, and leaving them
    lets the new bores break into open slots.
    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
2026-09-10 chore(hardware): sync both Fusion models and regenerate the package
    The generator refuses to build the assembly STEP while the native formed export
    disagrees with the cut file, so this is what closes tomassasovsky/segno#1019 rather than decorating
    it. Both base components gained the twelve new M4 bores and had four moved, the
    21 vent slots the generator now drops under the new feet were deleted, feet went
    15 -> 60, posts 2 -> 7 with their felts, and the printed prop was placed.
    Two things cost real time and are written into FUSION_MODELS.md so they do not
    again. Deleting sketch curves with the timeline marker at the end recomputes the
    whole model once per curve: 25 minutes for one document,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
    [segno_assembly.step, segno_base.dxf, segno_base.step, segno_base_flat.dxf, segno_buck_envelope.step, segno_buck_reference.step, segno_corner_bracket_rear.dxf, segno_corner_bracket_rear.step]
2026-09-10 feat(hardware): five printed floor rails replace the sixty rubber feet
    The feet carried the load correctly and looked like a rash: sixty parts on the
    underside, none lining up with anything, sixty heights to keep coplanar. Five
    continuous rails do it better on every count -- 52 MPa against 89 at a 1 kN
    stomp, 0.23 mm against 1.39, first yield 2465 N against 1428, and four times the
    rubber on the floor. Every rail lies on a screw row the floor already had, so
    they add no bore; the other fourteen foot bores went with the feet.
    Each rail is printed PETG carrying a 25.4 x 3.2 self-adhesive SOLID neoprene
    strip in a channel 0.2 mm under size, so the walls hold the strip and the
    adhesive is not i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
2026-09-10 fix(hardware): the rear rail's screws were inside the buck converters
    Locking the floor rails into the Fusion documents turned up two defects that
    every gate and every plan view had passed.
    The rear rail is the only one that adds bores, and a bore is cheap under the
    floor and expensive above it: the head stands up inside the console. The two
    buck converters are 22 mm bricks bolted flat to the floor across u 340..480, a
    segment boundary falls at u 423, and every segment of a rail is the same printed
    part -- so an offset ruled out in one segment is ruled out in all four. An even
    45 mm inset put four of the eight heads inside a brick. The anchors move to 65
    and 111 mm from each segment's near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
    [segno_assembly.step, segno_base.dxf, segno_base.step, segno_base_flat.dxf, segno_buck_envelope.step, segno_buck_reference.step, segno_corner_bracket_rear.dxf, segno_corner_bracket_rear.step]
2026-09-10 fix(hardware): put the real rail segments in Fusion, not five envelope bars
    The populated document carried five plain bars as an interference placeholder,
    so the thing the owner actually approved -- four identical segments per rail with
    rounded ends and a visible joint gap -- was nowhere in the CAD. It now carries
    the real geometry: 28 bodies, the 14 printed PETG segments with their stadium
    ends, channel and buried counterbores, plus the 14 neoprene strips.
    Built from TemporaryBRepManager primitives in ONE non-parametric base feature
    rather than 14 STEP imports or a sketch-and-extrude per body: one timeline entry
    and one recompute, where the placeholder cost 31 entries for a tenth of the
    ge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
2026-09-10 feat(hardware): three floor rows, square ends, and no vents in the floor
    Owner calls, in the order they came: rows only and fewer of them, joints closed,
    square ends, and delete the bottom intake field.
    THREE ROWS. The two front rails ride the pedestals' own chassis screws and the
    rear rides its anchors, so the rails add eight bores and no more. There is no
    fourth row because the middle of the plate is occupied at v = 181.28, 205, 206.22,
    229.25, 236, 246.10 and 252.75, and the two surviving lanes are about 5 mm wide.
    What it costs is stated rather than hidden: CLEAR and BANK span 228 mm and the
    plate deflects 3.28 mm at a 1 kN stomp, against 96 MPa of stress. A Boss RC-600's
    top panel meas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
    [segno_assembly.step, segno_base.dxf, segno_base.step, segno_base_flat.dxf, segno_buck_envelope.step, segno_buck_reference.step, segno_corner_bracket_rear.dxf, segno_corner_bracket_rear.step]
2026-09-10 feat(hardware): one full-width beam replaces the seven lid support posts
    Seven 30 mm pads cover 211 mm of an 850 mm panel. The nonlinear shell model
    behind tomassasovsky/segno#1019 rates the band between them at 47 kg of point load and the band
    over one at 232 kg, so spreading the posts moved the failure rather than
    removing it. One folded steel beam wall to wall makes the pad continuous and
    the weakest point on the band becomes 475 kg.
    Same C section, same 1.6 mm cold-rolled steel, same fourteen M4 into the floor
    at the same stations. What is new:
    - the fixing holes are SLOTTED in depth. Fourteen bolts concentrate in-plane
    restraint the bottom plate used to spread, and at a 1 kN stomp t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
    [segno_assembly.step, segno_base.dxf, segno_base.step, segno_base_flat.dxf, segno_beam.dxf, segno_beam.step, segno_beam_felt.step, segno_corner_bracket_rear.step]
2026-09-10 test(hardware): gate the corner rivets the audit of the beam work re-checked
    Ten rivets are drilled twice, from two different developments: the base from
    its own bend lines, the bracket from its. Nothing but the pair of relations in
    dxf_base makes them meet, and an audit in tomassasovsky/segno#992 once found every one of them
    2.0 mm off along the wall and 1.9 mm low.
    Measured in the assembled Fusion model: all ten coaxial to 0.011 mm with the
    heights exact, and every one a complete through-hole. The 0.011 is the 0.01 mm
    of clearance the bracket is placed with, not a hole position.
    Three things had no gate and now do:
    - the two hands share ONE flat and only the outline is mirrored, so the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
2026-09-10 fix(hardware): widen the corner bracket leg so its rivets clear the 2x rule
    The bracket leg carries two clearances at once: CORNER_RO holds the rivet off
    its own bend and CORNER_LEG - CORNER_RO holds it off the leg's free edge. At a
    12 mm leg with the offset at 8 the free edge was 4.0 mm, 1.25 x the rivet
    diameter, against a 2 x rule of thumb, and only 2.35 mm of metal beyond the
    hole for a blind rivet's set head to bear on. It was on the list the shop was
    asked to qualify rather than something the drawing had settled.
    CORNER_LEG 12 -> 15 makes it 7.0 mm (2.19 D) and leaves the bend side at 8.0
    (2.50 D). CORNER_RO does not move, so every rivet hole in the BASE stays exactly
    where it was: th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
    [segno_assembly.step, segno_base.step, segno_base_flat.dxf, segno_corner_bracket_rear.dxf, segno_corner_bracket_rear.step, segno_corner_bracket_rear_flat.dxf, segno_corner_bracket_rear_mirrored.dxf, segno_corner_bracket_rear_mirrored.step]
2026-09-10 docs(hardware): say why the support beam's steel grade is left open
    The drawing calls for 1.6 mm cold-rolled steel and names no grade. That was
    implicit; this makes it a decision with a number behind it.
    The beam's worst case is its end overhang: 108.9 mm of C section past the
    outermost bolt, wall tie ignored, and a 1 kN stomp on the very tip reads
    78 MPa. On the outermost pedal centreline, which is where a stomp can land, it
    is 29 MPa. The softest cold-rolled mild steel a shop stocks yields around 140,
    so every one of them carries it, and E is 210 GPa across the range so the
    choice does not move a deflection either. Bearing and short-range compression
    are under 7 MPa and the web is nowhere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
2026-09-10 chore(hardware): one filament for every printed part, and ship the ones nobody was sending
    Owner call: every printed part is BLACK PETG at >=40% infill. ASA is no longer
    offered as an alternative on the structural prints, so a reprint of any part
    matches the rest. Three parts are exceptions and all three are optical rather
    than a second material preference: the ten pedal-LED diffusers and the encoder
    ring diffuser are white translucent because they are the lenses the LEDs shine
    through, and the ten pedal tiles are a black body with white lettering printed
    in one filament change, because an all-black tile has no legend.
    Two gaps this turned up.
    The printed parts table had no row for the 7in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
2026-09-11 feat(pedal): protocol v4 unreserves the mode field's fourth value
    A fourth interaction mode cannot ride v3. The mode field has had two bits
    since v3 and the fourth value has been reserved-and-rejected by both decoders
    ever since, so a custom-mode frame sent at v3 would not render wrong, it would
    be refused whole and blank the pedal. That rejection is the entire reason this
    version exists.
    So v4 is the smallest version that ever shipped here: version byte 0x04, the
    same 17-byte payload for a third time, and value 3 meaning custom from v4 on
    and nothing below it. Encoding custom below v4 writes it as mute, the
    inert-safe degrade FX already takes below v3, so an un-reflashed pedal shows
    the wr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
2026-09-11 feat(pedal): v4 carries a colour per footswitch, and the decoder stops trusting the wire about length
    The zero-growth call rejected exactly these bytes, as bytes for feedback no
    hardware could show. That was true of the six single LEDs the v2 faceplate had
    when it was made, and stopped being true under tomassasovsky/segno#930: the pills are ten 8-LED
    colour segments now, one per footswitch, which is the hardware the accepted
    design assumes when it asks for colour on all ten. The reasoning survived; the
    premise did not.
    Widening v4 rather than spending a v5 because nothing has been flashed with
    v4 — it is unmerged, and no Pico 2 firmware exists — so the version is still
    being written. Co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
2026-09-12 feat(pedal): the ten indicators take the performer's colours, and state stops being the hue
    The accepted LED contract splits one indicator into two questions. Function
    state decides whether it is lit; the performer's palette decides what colour it
    comes up in. Both sides of the wire answered the second question for themselves
    until now: a track LED read green for playing and red for recording, and the
    MODE LED said which mode it was in by its hue.
    Protocol v4 already carries a colour per footswitch. This is what picks them
    and what renders them.
    The palette is eight built-in hues plus any number the performer mixes, each
    with a name and a number that outlives an edit. A custom colour is a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
2026-09-12 feat(pedal): the CTRL jacks reach the same interpreter the footswitches do
    The jacks had a screen and no dispatch: what a performer assigned to an
    external switch did nothing, because nothing carried a jack's contact into the
    app.
    The console board reads those jacks alongside the ten footswitches and the
    encoder, so an external switch arrives the way a footswitch does: a Note on the
    same link, at numbers that follow the plate's. A build that predates them
    decodes nothing rather than mistaking one for a footswitch, and the numbers are
    a wire contract with firmware that does not exist yet, so both protocol copies
    carry them and the C suite pins them.
    One event for both edges rather than the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
2026-09-12 feat(pedal): an expression pedal's wire numbers, travel and value dispatch
    The third piece of part 4f. An expression pedal is a potentiometer the
    console board reads on the same CTRL jack a switch uses, so its position
    reaches segno on the link the ten footswitches and the encoder already
    share: an absolute Control Change, one number per jack, carrying the RAW
    reading. Both protocol copies hold the numbers and the C contract suite
    pins them, because they are a contract with firmware that does not exist
    yet.
    7 bits, one message. The inbound half of this link is 3-byte MIDI only --
    segno's native capture drops SysEx -- so a higher-resolution position
    would need the MIDI 14-bit MSB/LSB pair an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
2026-09-12 feat(control): the expression half of External pedals
    The screen an expression pedal needs, and the type picker finally offers
    it. Four bodies of one page, because the accepted design draws the
    pickers and the calibration as whole views rather than panels: the lists
    behind them are as long as the rig is. Back steps through them, so the
    page keeps one draft and one Save.
    Two different things are drawn beside the pedal, which is the point of
    the pair. The meter shows the raw reading whether or not the pedal has
    been taught anything, so a performer can see the jack is alive. The
    number shows the position within the taught travel, and shows nothing
    until there is a travel to measure against --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
2026-09-14 docs(hardware): hand off the tomassasovsky/segno#1019 enclosure work, and keep the model it rests on
    HANDOFF_1019.md records the 2026-09-09/10 session for the next agent: where the
    design, tests, shop documents, native exports and both Fusion documents live,
    what changed commit by commit, the owner decisions not to reopen, what was and
    was not re-verified, the open items and the traps that bit.
    Writing it turned up three things the handoff could not honestly point at.
    The nonlinear FE model behind every number in the research doc existed only in
    a session scratch directory under /private/tmp, which a reboot clears. It is now
    _stomp_fea_nl.py, _stomp_fea_cases.py, _stomp_fea_beam.py and _st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
2026-09-15 feat(console): replace USB pedal with UART console link (tomassasovsky/segno#984)
    Replace the standalone USB-MIDI pedal with the Pico 2 UART console link. Require compatible live HELLO messages and safely drain native readers during recovery and disposal. Restore real native fuzzer coverage and fail CI when its helper cannot build.
    Closes tomassasovsky/segno#983.
    [asp1_pad.step, asp1_pad.stl, asp1_pad_mould.step, asp1_pad_mould.stl, asp1_pad_pourbox.step, asp1_pad_pourbox.stl, rc20_pad.step, rc20_pad.stl]
2026-09-15 feat(console): make CTRL pedals bindable controls (tomassasovsky/segno#986)
    Make both console CTRL jacks assignable through the controller pipeline, with expression calibration and independent tip/ring switches. Hold expression values while unplug detection is pending, release disconnected source-held controls, and make calibration persistence ordered and retryable.
    Closes tomassasovsky/segno#985.
2026-09-15 feat(appliance): ship and update matching console firmware (tomassasovsky/segno#990)
    Ship matching console firmware and boot-partition payload with appliance updates. Flash mismatched board firmware at boot, order boot-file production before copying, and anchor future release tags to the workflow source commit. Retain v3 hardware sources with their unfinished firmware and validation requirements documented.
    Closes tomassasovsky/segno#989.
    [console.placed.kicad_pcb, segno_console_board.kicad_pcb, segno_console_board_bom.csv, segno_pedal_ring.kicad_pcb]
2026-09-17 feat(hardware): console board 5 V path for full-white LEDs, and pre-order review fixes (tomassasovsky/segno#1062)
    Console board v3:
    - J3 (5 V in) becomes a 2-pin JST VH; the pills move to one 3-pin JST VH J24
    (GND, DATA, +5V) whose +5V pad is bridged to J3's by a poured bar on both
    layers; J7 is retired. PILL_POWER gates the topology.
    - VH 3D models generated by vh_models.py.
    - Per-pin legends on the back silkscreen for J3 and J24, which read in
    opposite orders; PIN_LEGEND gates them.
    - Committed gerbers and STEP brought up to date with the routed board.
    Ring board:
    - R5 100k holds the AHCT125 input low while the XIAO is not driving it, so
    the ring cannot latch random colours at pow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
    [console.placed.kicad_pcb, segno_combined_bom_lcsc.csv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]
2026-09-17 fix(hardware): the power button lead is a floating pair, not signal and GND (tomassasovsky/segno#1062)
    J8 and J9 were wired PWR_BTN + GND. Nothing on the board reads the button,
    and a lead fitted to the Pi 5's J2 pads the wrong way round held the button
    pad at ground, which the Pi reads as a button held down. They are now wired
    pin to pin (PWR_BTN, PWR_BTN_RET) with neither touching GND, so the lead
    works either way round. PWR_BTN gates the floating pair; rerouted, DRC clean.
    [console.placed.kicad_pcb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]
2026-09-17 feat(hardware): welded corners replace the riveted rear brackets (tomassasovsky/segno#1025)
    Snapshot of the welded revision as it stood uncommitted in the
    loving-darwin-6ad6c2 worktree on 2026-09-15. It matches the Fusion
    documents: base 945.0496 cm3 and lid 403.1127 cm3 in both the populated
    document (v394) and the manifest.
    [segno_assembly.step, segno_base.dxf, segno_base.step, segno_base_flat.dxf, segno_beam.dxf, segno_corner_bracket_rear.dxf, segno_corner_bracket_rear.step, segno_corner_bracket_rear_flat.dxf]
2026-09-17 feat(hardware): spot-welded rear corner tabs and a lid-seat flange on the side walls (tomassasovsky/segno#1067)
    Each side wall turns an 18 mm tab inward onto the rear wall's inner face,
    spot welded at 20, 42 and 64 mm; the front corners keep the fusion weld.
    Each side wall also turns a 15 mm return flange inward along its sloped
    top, so the lid rests on a strip instead of a 2 mm edge. The flange's top
    face is the old edge line, so the lid does not move. The beam's pad now
    stops 1.5 mm short of the flanges and its web drops beside them.
    The bend table carries short and inclined folds as explicit segments.
    Flat patterns only: the native formed base still has to be refolded in
    both Fusion doc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
    [segno_base.dxf, segno_beam.dxf]
2026-09-17 feat(hardware): native formed base with the tomassasovsky/segno#1067 tabs and flanges, from a Fusion clone
    The base was rebuilt with nine folds in a copy of the populated document
    ("VAMP console (populated) - 1067 tabs + seat flanges"); the original stays
    at version 394. The beam and its felt were swapped for the notched STEPs.
    The formed export and manifest now come from that clone, and all 140
    enclosure tests pass.
    [segno_assembly.step, segno_base.step, segno_base_flat.dxf, segno_beam.step, segno_beam_felt.step]
2026-09-17 feat(hardware): hairline slit reliefs instead of round notches, flanges run to the ridge (tomassasovsky/segno#1067)
    Every lid-seat flange and rear tab end is relieved by a 0.20 mm straight
    cut, and each flange's rear slit lands on the ridge closure, so the short
    edge and facet at the crease are gone. Base rebuilt in the Fusion clone
    and re-exported; all 140 enclosure tests pass.
    [segno_assembly.step, segno_base.dxf, segno_base.step, segno_base_flat.dxf]
2026-09-17 feat(hardware): clean rear corner: full-width rear wall laps whole-edge side tabs (tomassasovsky/segno#1067)
    The side wall, rear wall and rear shoulder now meet without cuts, steps or
    loose pieces. The rear wall runs the full outer width and covers the
    corners; each side wall's whole rear edge folds in as the spot-welded tab,
    and its top follows the inside of the rear wall and shoulder 0.15 mm away
    through the bend and across the tab. The lid-seat flange runs to the
    lid's rear bend. The rear corners no longer take fusion welds.
    Base rebuilt in the Fusion clone and re-exported; all 140 enclosure
    tests pass.
    [segno_assembly.step, segno_base.dxf, segno_base.step, segno_base_flat.dxf]
2026-09-17 fix(hardware): close the peak joint between the transition flange and the lid-seat flange (tomassasovsky/segno#1067)
    The transition flange stopped 2 mm down its facet, and the side wall filled
    the widening gap to the lid-seat flange with a hooked wedge. The flange now
    runs to 0.1 mm below the lid's lap-bend tangent, where its bottom tip corner
    meets the seat flange's end in a crease under the lid bend, and the wall top
    simply follows the flange underside. The nine lap screw stations keep their
    original solve. Base rebuilt in the Fusion clone and re-exported; all 141
    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
    [segno_assembly.step, segno_base.dxf, segno_base.step, segno_base_flat.dxf]
2026-09-17 feat(hardware): lid-seat flanges run from the side walls' front edges (tomassasovsky/segno#1067)
    The flanges started 10 mm back with a slit, behind an R3 cove kept for an
    older lid lip position. The lid's front bend now ends 1.1 mm ahead of the
    walls, so each flange starts where its bend line meets the wall's free
    front edge, with no relief and no cove. Base rebuilt in the Fusion clone
    and re-exported; all 141 enclosure tests pass. The faceplate is unchanged.
    [segno_assembly.step, segno_base.dxf, segno_base.step, segno_base_flat.dxf]
2026-09-17 feat(hardware): faceplate runs 2 mm past each side skin (tomassasovsky/segno#1067)
    The lid blank grows from 849.8 to 853.8 mm so its edge caps the side
    walls and their lid-seat flanges. The rear wall and its shoulder keep the
    base's 849.8 mm outer width (BASE_OUTER_W, now separate from LID_W). Lid
    content moves 2 mm inside the wider blank and the lid is placed 2 mm
    further out, so every hole, slot and seat stays where it was. Faceplate
    rebuilt in the Fusion clone and re-exported; all 142 enclosure tests pass.
    [segno_assembly.step, segno_faceplate.dxf, segno_faceplate.step, segno_faceplate_flat.dxf]
2026-09-17 fix(hardware): drop the MIDI IN legend from the console silkscreen (tomassasovsky/segno#1062)
    Owner call: the bottom strip reads better with the title alone. Removed in the
    generator rather than by hand, so it does not come back on the next run; the
    board was re-placed, re-routed and re-exported with it gone. DRC 0 violations,
    0 unconnected, fab checks pass.
    [console.placed.kicad_pcb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]
2026-09-17 test(hardware): script the DIN MIDI bench test for the U1 swap (tomassasovsky/segno#1068)
    * test(hardware): script the DIN MIDI bench test for the U1 swap (tomassasovsky/segno#1007)
    The September 4 session's procedure, runnable: three exact 16-byte sequences
    per direction at 31250 8N1, byte-for-byte compare, UART error counters, and
    the settings restored afterwards. --preflight reports state without touching
    anything, --loopback proves the script's own UART path, and --self-test checks
    the logic anywhere. The pedal link's UART is refused by name.
    hardware/bench/README.md is the runbook for fitting the SN74AHCT125N. It also
    records what the panel already tells us: the ring and the pills run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
    [midi_din_test.py]
2026-09-17 feat(hardware): power headers up 8 mm, and a Pico footprint that takes either build (tomassasovsky/segno#1062)
    Owner calls:
    - J3 and J24 move 8 mm up, into what was the USB corridor. USB_CLEAR goes with
    them: the module can be socketed and lifted out, so the corridor bought
    nothing it could still promise.
    - The Pico footprint is vendored as SMD hand-solder pads (and KiCad's own 3D
    model) PLUS a through-hole at every pin, so the module solders flat or sits
    on headers. The three debug holes land on D1/D2/D3, so SWD stays on the board
    either way; the Pico W antenna keep-out is dropped, since it sits exactly over
    those pads and this is the non-W part.
    - The front mark moves into the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
    [console.placed.kicad_pcb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]
2026-09-18 feat(hardware): close the screen mounts, mirror the 15.6in stand, add shims
    The owner's review of the printed screen mounts found three problems: too many
    openings, 15.6in halves that were not mirror images, and no adjustment for
    tolerances (tomassasovsky/segno#1070).
    7in tower: the deck is closed. The vendor STEP shows every connector leaves one
    short edge and nothing on the module's back reaches the deck plane, so the
    146 x 96 window only ever existed to let the deck print without support. Four
    internal ribs with 45 degree gable ceilings do that job now. The two side cable
    windows are gone, and so is the front ring-board notch: the current Ring24 board
    clears the closed deck by about 3.3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
    [segno_base.dxf, segno_screen16_shim_0p2.step, segno_screen16_shim_0p2.stl, segno_screen16_shim_0p4.step, segno_screen16_shim_0p4.stl, segno_screen16_shim_0p8.step, segno_screen16_shim_0p8.stl, segno_screen16_shim_1p6.step]
2026-09-18 docs(hardware): record the tomassasovsky/segno#1070 screen mounts as placed in the tomassasovsky/segno#1067 clone
2026-09-18 feat(hardware): seat the 7in screen on M3 5x5 heat-set inserts
    The tab bosses had O4.0 x 5.0 pockets sized for no particular insert. The
    owner's inserts are M3 5x5, the same part as the pedal sleds and the 15.6in
    splice, so the pockets become the sleds' O4.5 x 6.0 pilot, with O3.4 clearance
    below. The bosses grow from O9 to O10.5 to keep 3.0 mm of wall. The vendor STEP
    shows nothing of the module within 6 mm of a tab axis on the boss side, and the
    connector notch still clears the rear boss. Swapped into the tomassasovsky/segno#1067 clone; the
    only contact with the module is the boss tops on the tabs (tomassasovsky/segno#1070).
    [segno_screen7_tower.step, segno_screen7_tower.stl]
2026-09-18 feat(hardware): fix the 15.6in monitor to its stands and adjust the platform
    The monitor floated +-2.5 on O9.3 holes, but an O12 washer cannot cover a O9.3
    hole with the screw at the end of that travel, and a panel held at two points
    is the wrong place to adjust. The owner's call: fix the screen and move the
    platform. The holes are now M4 clearance (O4.8, ISO 273 coarse, enough for the
    75 mm pitch across two printed halves and the splice), taking M4x16 with DIN 125
    washers. The spliced pair adjusts on its +-1.25 floor float holes. Swapped into
    the tomassasovsky/segno#1067 clone: no interference (tomassasovsky/segno#1070).
    [segno_screen16_stand_L.step, segno_screen16_stand_L.stl, segno_screen16_stand_R.step, segno_screen16_stand_R.stl]
2026-09-18 feat(hardware): purple solder mask on both boards (tomassasovsky/segno#1062)
    The boards are ordered purple with white silk. Neither board had a stackup, so
    KiCad drew them green in the 3D viewer, the renders and the STEP models. The
    bindings cannot set a stackup, so board_stackup.py writes the block into the
    file; console_board_pcb.py applies it to every placed board, and the route
    scripts' load/save carries it through.
    Only the gerber job files change (they now record the mask and silk colour);
    every copper, mask, silk and drill layer is byte-identical apart from headers.
    DRC 0 violations, 0 unconnected on both boards.
    [console.placed.kicad_pcb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]
2026-09-19 feat(hardware): front logo under PWR BTN at near full size, J24 down 1 mm (tomassasovsky/segno#1062)
    Owner call. The patch under the PWR BTN header holds the mark at ~96% of its
    drawn size, against 58% in the corner below J24 it came from. J24 drops 1.0 mm,
    so the two VH plugs clear by 2.1 mm instead of 1.1 (JST's VHR-2N and VHR-3N
    are exactly as long as their headers). 1.5 mm was tried and PIN_LEGEND refused
    it: the back DATA legend landed on R21's pad.
    Back art recomposed against the moved pads; re-routed. DRC 0 violations,
    0 unconnected; fab checks pass; purple stackup carried through.
    [console.placed.kicad_pcb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]
2026-09-19 feat(console): comet ring, brightness 128 and a truer yellow (tomassasovsky/segno#1064) (tomassasovsky/segno#1065)
    Picked on the unit by flashing test builds and comparing them:
    - the ring's symmetric hump becomes a comet whose tail trails 3/4 of a turn,
    stays bright most of the way and fades to a 30% floor
    - LED_BRIGHTNESS 64 -> 128
    - yellow 255,255,0 -> 255,235,0; equal red and green read lime
    - scaled() keeps a mixed colour's hue as it dims (gamma per factor, rounded)
    - FW_MINOR 5 -> 6 so the image reflashes boards on 1.5
2026-09-19 feat(hardware): fit tests for the 7in deck and the 15.6in VESA screws
    Two quick jigs for the tomassasovsky/segno#1070 interfaces before the full prints.
    screen7_deck_fit_test: the tower's deck, flattened, with its real bosses,
    M3 5x5 insert pilots and connector notch. It checks insert setting, tab
    landing, module-back clearance and the real cables.
    screen16_vesa_fit_test: 10 mm of stand deck with the fixed M4 holes at 75 mm
    and a lip S16_BLOCK_PROUD above the bosses. It checks the pitch, M4x16
    engagement and the block/flat-back step the tower pads are built to.
    Tests tie both jigs to the parts they stand in for; both are jigs, kept out
    of the print package.
    [segno_screen16_vesa_fit_test.step, segno_screen16_vesa_fit_test.stl, segno_screen7_deck_fit_test.step, segno_screen7_deck_fit_test.stl]
2026-09-19 feat(hardware): whole-fit test for the 15.6in stands
    The VESA bar only checked the screws and a strip of the block step. The
    monitor is carried by both bosses, both tower pads and the splice, so the
    whole-fit test is the real stand halves cut off under their deck: every contact
    the monitor will meet, printed flat, joined by the real splice. Derived from
    the stand STEPs, and a test confirms each half is exactly the stand above its
    deck and that both boss and pad touch the monitor on each side (tomassasovsky/segno#1070).
    [segno_screen16_deck_fit_test_L.step, segno_screen16_deck_fit_test_L.stl, segno_screen16_deck_fit_test_R.step, segno_screen16_deck_fit_test_R.stl]
2026-09-19 feat(hardware): cut the 15.6in whole-fit test down to its contacts
    The whole-fit halves were 201 cm3 of mostly solid slab. They keep only what
    the fit depends on, cut from the stand: the pad, the VESA column, the splice
    insert columns, and a 10 mm open ladder holding them in place. 94 cm3 each,
    still flat and support-free, same contacts (tomassasovsky/segno#1070).
    [segno_screen16_deck_fit_test_L.step, segno_screen16_deck_fit_test_L.stl, segno_screen16_deck_fit_test_R.step, segno_screen16_deck_fit_test_R.stl]
2026-09-20 feat(hardware): size both 5 V rails for full white, not for a brightness cap
    The ring at full white is 24 x 60 mA = 1.44 A. Nothing carried it badly, but
    the two tracks in the path were the thinnest numbers on either board and the
    argument for leaving them there rested on firmware that does not exist.
    Ring board +5V_LED was 0.55 mm: 1.55 A at a 10 C rise (IPC-2221, 1 oz
    external), 7% over the load. Console board +5V was 0.60 mm carrying the ring
    plus logic, ~1.6 A against 1.65 A -- 3%.
    Raising the netclass width does not widen either board. It poses Freerouting a
    different problem and it returns a different route; that is what the old "0.55
    is a CEILING, 0.65 and 0.80 each leave a clearanc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
    [console_board_pcb.py, ring_board.py]
2026-09-22 fix(hardware): complete full-power PCB routing and exports
    [segno_console_board-B_Cu.gbr, segno_console_board-B_Mask.gbr, segno_console_board-B_Paste.gbr, segno_console_board-B_Silkscreen.gbr, segno_console_board-Edge_Cuts.gbr, segno_console_board-F_Cu.gbr, segno_console_board-F_Mask.gbr, segno_console_board-F_Paste.gbr]
2026-09-22 feat(hardware): add through-hole and factory screen power boards
    [bom.csv, console.placed.kicad_pcb, external_bom.csv, screen1_power.kicad_sch, screen1_touch.kicad_sch, screen2_power.kicad_sch, screen2_touch.kicad_sch, screen_power_factory.kicad_pcb]
2026-09-22 refactor(hardware): simplify and compact screen power boards
    [bom.csv, external_bom.csv, screen1_power.kicad_sch, screen1_touch.kicad_sch, screen2_power.kicad_sch, screen2_touch.kicad_sch, screen_power_factory.kicad_pcb, screen_power_factory.kicad_sch]
2026-09-22 fix(hardware): measure pads as their real shapes, and stop the width gate halting a fine board
    Two faults, both mine, found when route_console_board.sh came back reporting
    0.247 mm of allowed width on every attempt and then refused to ship gerbers.
    **The width gate was wrong to be a gate.** MIN_RAIL_TRACK_W put +5V's floor at
    0.70 mm, the width widen_power.py AIMS for. When a re-route comes back with no
    clearance headroom the widening correctly does nothing, the rail stays at the
    0.60 mm it was routed at, and --check-routed then failed the fab step over
    copper that is fine. A stop with no action behind it is worse than no check.
    The floor is now 0.60 for both rails, which is the real promis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
    [console_board_pcb.py]
2026-09-25 feat(hardware): publish screen switching and board refinements
    Add the hand-soldered two-layer screen-power board, aligned console connectors, ADC supply isolation, white ring carrier and reviewed manufacturing ZIPs. Integrate GPIO17 ownership with Weston startup and shutdown; retain assembled-system validation as the hardware gate.
    [CP_Radial_D5.0mm_P2.00mm.step, CP_Radial_D6.3mm_P2.50mm.step, C_Rect_L7.2mm_W2.5mm_P5.00mm_FKS2_FKP2_MKS2_MKP2.step, D_DO-35_SOD27_P7.62mm_Horizontal.step, D_DO-41_SOD81_P10.16mm_Horizontal.step, Fuse_Littelfuse_251_P12.70mm.step, JST_VH_B2P-VH_1x02_P3.96mm_Vertical.step, JST_XH_B2B-XH-A_1x02_P2.50mm_Vertical.step]
2026-09-25 feat(hardware): add supported pill housings and eight-LED simulator
    [pill_top_mount_assembly_front.step, pill_top_mount_assembly_mid.step, pill_top_mount_base.step, pill_top_mount_base.stl, pill_top_mount_cover.step, pill_top_mount_cover.stl, pill_top_mount_fit_sample_base.step, pill_top_mount_fit_sample_base.stl]
2026-09-25 fix(hardware): support full-white 40-pixel ring power
    [segno_console_board-B_Cu.gbr, segno_console_board-B_Mask.gbr, segno_console_board-B_Paste.gbr, segno_console_board-B_Silkscreen.gbr, segno_console_board-Edge_Cuts.gbr, segno_console_board-F_Cu.gbr, segno_console_board-F_Mask.gbr, segno_console_board-F_Paste.gbr]
2026-09-25 fix(hardware): correct screen relay contacts and strengthen power routing
    Replace withdrawn Revision I with checked Revision J fabrication files. Correct USB relay commons, reinforce the shared power paths, and verify relay states and a fuse-barrel-independent via path. Record the requested Claude review and independent follow-up checks.
    [screen1_power.kicad_sch, screen1_touch.kicad_sch, screen2_power.kicad_sch, screen2_touch.kicad_sch, screen_power_hand.kicad_pcb, screen_power_hand.kicad_sch, screen_power_hand.placed.kicad_pcb, shared_power.kicad_sch]
2026-09-25 fix(hardware): finish screen power routing and assembly package
    Finish the power-width transitions, correct capacitor models and mated-plug clearance, and align the wiring and aggregate power budget. Publish verified Revision K manufacturing files. Record completed local engineering reviews and incomplete Claude/OpenCode reviews caused by provider usage limits.
    [CP_Radial_D5.0mm_P2.00mm.step, CP_Radial_D6.3mm_P2.50mm.step, C_Rect_L7.2mm_W2.5mm_P5.00mm_FKS2_FKP2_MKS2_MKP2.step, Panasonic_EEUFR1A151.step, Panasonic_EEUFR1A221.step, WIMA_MKS2C031001A00KSSD.step, external_bom.csv, screen1_power.kicad_sch]
2026-09-25 docs(hardware): record Claude cloud screen board review
2026-09-25 fix(hardware): specify screen input protection and correct R8 model
    Specify the screen-only inline fuse and holder, include their supply-drop boundary, and replace the generic bleeder preview with a PR01 envelope. Refresh independent review and fabrication evidence while retaining the verified Revision K Gerber bytes.
    [Vishay_PR01_P10.16mm.step, external_bom.csv, screen_power_hand.kicad_pcb]
2026-09-26 fix(hardware): strengthen screen gate drive and finish PCB copper
    [DIP-4_W7.62mm.step, DIP-8_W7.62mm.step, Panasonic_ECEA1EN100U.step, bom.csv, console.placed.kicad_pcb, gate_drive.kicad_sch, screen1_power.kicad_sch, screen1_touch.kicad_sch]
2026-09-26 fix(hardware): finish uniform rounded AUX input routing
    [screen_power_hand.kicad_pcb, screen_power_hand.placed.kicad_pcb]
2026-09-26 fix(hardware): finish rounded routing across all three boards
    [console.placed.kicad_pcb, screen_power_hand.kicad_pcb, screen_power_hand.placed.kicad_pcb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]
2026-09-26 fix(hardware): align screen power ICs with clear courtyards
    [screen_power_hand.kicad_pcb, screen_power_hand.placed.kicad_pcb]
2026-09-26 fix(hardware): finish production artwork and ring power wiring
    [console.placed.kicad_pcb, screen_power_hand.kicad_pcb, screen_power_hand.placed.kicad_pcb, segno_combined_bom_lcsc.csv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]
2026-09-26 fix(hardware): correct USB relay power source and assess revised routing
    Prepare Revision M schematic, low-current host sensing and shield drain pads. Keep screen manufacturing on hold pending the revised native layout and complete release validation.
    [bom.csv, external_bom.csv, gate_drive.kicad_sch, screen1_power.kicad_sch, screen1_touch.kicad_sch, screen2_power.kicad_sch, screen2_touch.kicad_sch, screen_power_hand.kicad_sch]
2026-09-26 fix(hardware): finish revision M USB routing and manufacturing package
    [screen_power_hand.kicad_pcb, screen_power_hand.placed.kicad_pcb]
2026-09-26 fix(hardware): close final PCB production review findings
    [console.placed.kicad_pcb, segno_combined_bom_lcsc.csv, segno_console_board.kicad_pcb, segno_console_board_bom.csv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]
2026-09-26 chore(hardware): preserve reviewed KiCad placement settings
2026-09-27 fix(hardware): close Claude PCB review findings
    [bom.csv, console.placed.kicad_pcb, screen_power_hand.kicad_pcb, screen_power_hand.kicad_sch, screen_power_hand.placed.kicad_pcb, segno_combined_bom_lcsc.csv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]
2026-09-27 docs(hardware): complete final Claude board reviews
2026-09-28 feat(hardware): lower screen power cost and finish copper contours
    [C_Disc_D7.5mm_W4.4mm_P5.00mm.step, DIP-4_W7.62mm.step, DIP-8_W7.62mm.step, D_DO-15_P10.16mm_Horizontal.step, D_DO-35_SOD27_P7.62mm_Horizontal.step, Fuse_Bel_0697H_P5.08mm.step, Fuse_Littelfuse_251_P12.70mm.step, Fuseholder_Schurter_OGN_0031.8201.step]
2026-09-28 docs(hardware): complete adversarial PCB review and release fabrication files
2026-09-28 feat(hardware): carry USB shields through removable XH5 plugs
    [JST_XH_B4B-XH-A_1x04_P2.50mm_Vertical.step, JST_XH_B5B-XH-A_1x05_P2.50mm_Vertical.step, bom.csv, external_bom.csv, relay_drive.kicad_sch, screen1_power.kicad_sch, screen1_touch.kicad_sch, screen2_power.kicad_sch]
2026-09-28 fix(hardware): smooth screen power ground at H1
    [relay_drive.kicad_sch, screen1_power.kicad_sch, screen1_touch.kicad_sch, screen2_power.kicad_sch, screen2_touch.kicad_sch, screen_power_hand.kicad_pcb, screen_power_hand.kicad_sch, screen_power_hand.placed.kicad_pcb]
2026-09-29 feat(hardware): back to the tomassasovsky/segno#1025 base: no lid-seat flanges, four welded corners (tomassasovsky/segno#1067)
    The lid-seat flanges could not be formed along the front third of each side
    wall: bent before the wall, a flange sits over the wall's bend punch, with
    8.6 mm of clear height at the front edge. Stopping it partway would show along
    the wall top, and the tomassasovsky/segno#1019 stomp rating predates it. The spot-welded rear tabs
    go too: the welder has no resistance spot welder, so the owner took the rear
    corners back to the fusion-welded joint the front corners use.
    The base generator is the tomassasovsky/segno#1025 base again (its handoff is byte for byte the
    Septemb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
    [segno_assembly.step, segno_base.dxf, segno_base.step, segno_base_flat.dxf, segno_beam.dxf, segno_beam.step, segno_beam_felt.step]
2026-09-29 feat(hardware): seven beam screws, tapered lid, rear I/O cut into the wall (tomassasovsky/segno#1088)
    Three owner changes to the console base, lid and beam:
    - The support beam bolts to the floor with one M4 at the centre of each
    interior pedal gap, seven instead of fourteen. The tomassasovsky/segno#1019 floor model puts
    the slotted case at 139 MPa (util 1.46) against 135 with fourteen. The model
    had to merge mesh lines closer than 0.01 mm: each new screw lands within a
    micron of the floor-rail joint at the same gap, and the sliver element left
    the stiffness matrix singular.
    - The lid keeps its 2 mm overhang along the slope, then narrows over the last
    40 mm before the rear bend,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
    [segno_assembly.step, segno_base.dxf, segno_base.step, segno_base_flat.dxf, segno_beam.dxf, segno_beam.step, segno_faceplate.dxf, segno_faceplate.step]
2026-09-30 feat(hardware): power group behind CLEAR/BANK, dedicated rear rail prints, v3 boards (tomassasovsky/segno#1088)
    - Screen-power board (tomassasovsky/segno#1072), both bucks and the SparkFun STUSB4500 PD board sit
    behind the CLEAR/BANK pedals at the owner's placement; generator gates for
    plan clearance, rail lane, anchor heads, connector band and screen ceiling.
    - Rear rail segments 2 and 3 become their own prints: pockets for the buck
    bolt heads (M4 button heads from below) and segment 2's anchors moved ahead
    of BUCK_AUX. The other segments stay one part.
    - Earth stud centred between the vent block and PD_IN.
    - CTRL jacks described correctly: NJ6FD-V in the MEIRIYFA D-flange plate.
    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
    [segno_assembly.step, segno_base.dxf, segno_base.step, segno_base_flat.dxf, segno_floor_rail_rear_2.step, segno_floor_rail_rear_2.stl, segno_floor_rail_rear_3.step, segno_floor_rail_rear_3.stl]
2026-09-30 feat(hardware): 7in tower notch for the strip ring's lowered carrier (tomassasovsky/segno#1075)
    The 34-LED console strip ring (hardware/strip_ring/console_ring.py, tomassasovsky/segno#1088
    branch) hangs the Ø80 v3 ring carrier 7 mm deeper than the Ring24 stack, into
    the deck's front edge and the front wall top. A cylinder about the encoder axis
    (carrier r + 1.5) removes that and nothing else: a 44 x 6 mm bite out of the
    deck's front edge under the module's bottom bezel. The tab bosses are gated
    clear and the closed-deck test now names this notch alongside the connector
    notch.
    [segno_screen7_tower.step, segno_screen7_tower.stl]
2026-09-30 feat(hardware): 34-LED strip ring for the console (tomassasovsky/segno#1075)
    Console variant of the standalone strip ring (PR tomassasovsky/segno#1083, left untouched): the
    faceplate replaces the printed top cover, the cup's roof is glued to the
    faceplate underside, and there is no sleeve or bottom. 34 LEDs because at 40
    the strip's back passes the 7in module's edge (42.9 from the axis); the cup's
    outer wall is r 40.3. The v3 carrier sits one light lift (7 mm) deeper with its
    Ring24 unfitted and the strip on J2. Placed in the Fusion clone with the tomassasovsky/segno#1070
    tower's new notch (FUSION_MODELS.md).
    [console_ring_assembly.step, console_ring_centre_cap.step, console_ring_centre_cap.stl, console_ring_cup.step, console_ring_cup.stl, console_ring_diffuser.step, console_ring_diffuser.stl, console_ring_encoder_retainer.step]
2026-09-30 docs(hardware): manufacturing package matches the printed parts (tomassasovsky/segno#1088)
    The owner has printed the mirrored 15.6in stands, the closed-deck 7in tower, the
    2.4 mm-wall collars, the solid CLEAR/BANK collars and the tall eight-LED pills
    (tomassasovsky/segno#1074). The pill row now names that set (fit-checked at all ten stations in
    the Fusion clone), the tower row names the strip-ring notch and the reprint it
    needs, and the console strip ring is listed as the Ring24 alternative.
2026-09-30 docs(hardware): release review for the integrated enclosure revision (tomassasovsky/segno#1088)
    Evidence (154 tests, formed base parity, clone interference incl. the tall pills
    and the mirrored stand holes) and the owner's open items before cutting:
    Dinacut acceptance, the tomassasovsky/segno#1019 load assessment, the post-weld driller, the PD
    coupler diagonal, the ring choice and the screen-power USB lead length.
2026-09-30 fix(hardware): code-review findings on the integrated enclosure (tomassasovsky/segno#1088)
    - rail_pockets() returns each bolt's own (u, v); the rail STEP pockets and the
    bores-under-rail whitelist no longer assume both bucks share BUCK_PI's row.
    - One encoder_axis_world() feeds both the ring-disc placement and the 7in
    tower's carrier notch; the tower's origin anchor is found by geometry
    (front-most centre flange hole), not by list position.
    - The console print package no longer ships segno_led_diffuser: the console's
    pills are the tall tomassasovsky/segno#1074 set, and the old diffuser is the mini's part.
    - The CTRL comment no longer asserts ring-normal: the v3 netlist says
    tip-nor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
2026-09-30 docs: spell-check the enclosure line's docs
    The enclosure line never ran CI spell-check before tomassasovsky/segno#1089. Its technical and
    supplier-draft (Spanish) vocabulary goes into the project word list, following
    the existing convention, and the two forbidden spellings become 'plain text'
    and 'front end'.
2026-09-30 feat(hardware): pre-cut fit coupons for the rear wall and the console ring (tomassasovsky/segno#1090)
    - segno_rear_wall_fit_test_L/R: the rear connector cutouts at the wall's 2.0 mm,
    in two bed-sized halves, top face = the wall's outside (marked), so every
    purchased connector -- above all the PD coupler's screw diagonal -- is
    dry-fitted before the metal is cut.
    - console_ring_bench_faceplate: the faceplate's Ø67 window in a 2 mm plate on
    legs, so the 34-LED console ring is judged at its real optics before the
    Ring24/strip choice. The console ring STLs now export in print orientation.
    [console_ring_assembly.step, console_ring_bench_faceplate.step, console_ring_bench_faceplate.stl, console_ring_centre_cap.step, console_ring_centre_cap.stl, console_ring_cup.step, console_ring_cup.stl, console_ring_diffuser.step]
2026-09-30 docs(hardware): pre-cut decision package, CTRL contact settled, refreshed shop drafts (tomassasovsky/segno#1090)
2026-09-30 feat(hardware): unbolted beam ears and laser-piloted front stations drilled before welding (tomassasovsky/segno#1090)
    Owner calls 2026-09-30: no M4 through the side walls (the beam's ears stay as
    locators), and Dinacut drills every deferred hole after folding and before
    welding from a Ø1.0 laser pilot. Native Fusion re-export still pending, so the
    generated package is not regenerated in this commit.
2026-09-30 feat(hardware): sync Fusion and the shop package for unbolted ears and front pilots (tomassasovsky/segno#1090)
    Clone edits: base wall-tie circles removed from CUT (+66.476 mm3), nine
    Ø1.0 lid pilots added to CUT (volume unchanged, concentric with the drills),
    beam ear slots deleted (+75.261 mm3, matches segno_beam.step). Formed base
    and lid re-exported; the exporter counts only drawn drill circles. Full
    generator and 154 enclosure tests pass.
    [segno_assembly.step, segno_base.dxf, segno_base.step, segno_base_flat.dxf, segno_beam.dxf, segno_beam.step, segno_faceplate.dxf, segno_faceplate.step]
2026-09-30 fix(hardware): PD coupler M3 pair on the CTRL plates' diagonal (tomassasovsky/segno#1090)
    The owner checked the QIANRENON coupler against the rear-wall cut and its
    fixing pair was on the opposite diagonal. All three D flanges (PD_IN, CTRL_1,
    CTRL_2) now share D_TRS_DIAG. Fusion clone base CUT moved to match (volume
    unchanged), formed base re-exported, package and fit coupon regenerated;
    154 enclosure tests pass.
    [segno_assembly.step, segno_base.dxf, segno_base.step, segno_base_flat.dxf, segno_faceplate.step, segno_faceplate_flat.dxf, segno_rear_wall_fit_test_L.step, segno_rear_wall_fit_test_L.stl]
2026-09-30 feat(hardware): ring and knob 14.16 mm down the lid, printed 7in tower kept (tomassasovsky/segno#1090)
    Owner drag-canvas placement (v 217.5, same u), set at ENC_V 215.0 so the
    strip ring's Ø80 carrier clears the closed-deck tower already printed with
    1.5 mm of air; the tower notch becomes a clearance gate and the tower is
    again identical to fb6acf88's. Fusion clone: lid ring hole moved, ring stack
    translated, tower body swapped back; interference unchanged except the moved
    parts' intended glue faces. 154 enclosure tests pass.
    [segno_assembly.step, segno_base.step, segno_base_flat.dxf, segno_faceplate.dxf, segno_faceplate.step, segno_faceplate_flat.dxf, segno_screen7_tower.step, segno_screen7_tower.stl]
2026-09-30 docs(hardware): 34 LEDs is the owner's pick now that 40 would fit (tomassasovsky/segno#1090)
    With the ring at ENC_V 215.0 the 7in module is 57.0 mm from the axis, so the
    old '40 does not fit' reason no longer holds. 34 stays: its LEDs sit 3 mm from
    the lens (40 would be 9.6), for a sharper comet head and ~1.7x the brightness
    at the same drive in the light model.
2026-09-30 feat(hardware): snap arms on the console ring cup hold the ring carrier (tomassasovsky/segno#1090)
    The v3 carrier has no screw holes and is meant to snap-mount. Three arms off
    the cup's roof, outside the strip wall at 30/150/270 deg (clear of the strip
    seam), click a 45-degree lead-in catch 1.0 mm under the Ø80 board edge with
    0.3 mm play, so the EC11 nut still sets the height. Gates: arms inside the
    7in tower clearance (r 41.5), catch clear of the underside parts (r 37.4).
    Fusion clone cup swapped; no interference.
    [console_ring_assembly.step, console_ring_cup.step, console_ring_cup.stl]
2026-09-30 docs(hardware): rear-wall coupons fit every connector; tomassasovsky/segno#1019 proof test waived (tomassasovsky/segno#1090)
2026-09-30 feat(hardware): aluminium centre disc glued on the strip ring's cap (tomassasovsky/segno#1090)
    Owner call: keep segno_ring_disc so the ring's centre matches the lid's
    coating. The disc is now Ø51.0 (coated max 51.40 in the Ø51.70 lens bore)
    with two Ø8.0 access holes over the cap's M3 screws; the printed centre cap
    sits one disc thickness lower. Fusion clone disc and cap swapped and the disc
    shown; only the glue face touches. 154 enclosure + 6 ring tests pass.
    [console_ring_assembly.step, console_ring_centre_cap.step, console_ring_centre_cap.stl, segno_assembly.step, segno_ring_disc.dxf, segno_ring_disc.step]
2026-09-30 fix(hardware): design every fit for the shop's stated ±0.20, drawings ask for nothing tighter (tomassasovsky/segno#1090)
    Dinacut holds ±0.20 on laser size and position; tighter costs far more. The
    tolerance block and every callout now state ±0.20, and the design carries the
    margin: fuse Ø12.30 -> 12.50 and MIDI Ø15.50 -> 15.70 so they pass their parts
    at -0.20 with full coating; the D-flange bores Ø24.40 -> 24.20 so the web to
    their M3 pair stays 1.20 mm with both holes at +0.20 (worst coated 23.80 still
    clears the 23.6 barrels). New gates check each rear opening at worst case.
    Fusion base CUT updated (+18.41 mm3, exact), formed parts re-exported.
    [segno_assembly.step, segno_base.dxf, segno_base.step, segno_base_flat.dxf, segno_faceplate.dxf, segno_faceplate.step, segno_faceplate_flat.dxf, segno_rear_wall_fit_test_L.step]
2026-10-01 feat(hardware): support beam without wall ears, square ends 3 mm off the walls (tomassasovsky/segno#1090)
    The ears carried no load (the stomp goes pad -> web -> 7 floor bolts), the
    bolts already locate the beam, and their 0.5 mm wall gap could close under
    the shop's ±0.20 / ±0.50 plus both coatings. The beam is now a plain two-fold
    C, 839.8 mm, a flat laser length with ~3 mm a side; a gate keeps >1 mm at
    worst case. The FE drops the wall end-supports: slotted 112 MPa / 3.09 mm
    (util 1.17), was 139 / 2.98 with the ears. Fusion beam and felt swapped and
    moved to u 3.1; no interference. 154 enclosure tests pass.
    [segno_assembly.step, segno_beam.dxf, segno_beam.step, segno_beam_felt.step]
2026-10-01 feat(hardware): beam bolts on all nine front screw stations (tomassasovsky/segno#1090)
    Owner call: the beam takes the lid's nine front screw stations, so beam, base
    floor and lid share one row. Two outboard M4 added (u 18.43 / 827.57), the
    beam's LED-feed windows moved to u 36 / 810 to clear them. FE, beam ends free:
    slotted 114 MPa / 3.08 mm (util 1.20). Fusion base CUT (-66.48 mm3, exact)
    and beam body updated, formed parts re-exported. 154 enclosure tests pass.
    [segno_assembly.step, segno_base.dxf, segno_base.step, segno_base__aluminio-1100-H14-de-2.0-mm__qty1.dxf, segno_base__aluminio-1100-H14-de-2.0-mm__qty1.step, segno_base_flat.dxf, segno_beam.dxf, segno_beam.step]
2026-10-01 chore(hardware): untrack a stale extracted package copy under out/ (tomassasovsky/segno#1090)
    [segno_base__aluminio-1100-H14-de-2.0-mm__qty1.dxf, segno_base__aluminio-1100-H14-de-2.0-mm__qty1.step, segno_beam__acero-laminado-en-frio-de-1.6-mm__qty1.dxf, segno_beam__acero-laminado-en-frio-de-1.6-mm__qty1.step, segno_faceplate__aluminio-1100-H14-de-2.0-mm__qty1.dxf, segno_faceplate__aluminio-1100-H14-de-2.0-mm__qty1.step, segno_ring_disc__aluminio-1100-H14-de-2.0-mm__qty1.dxf, segno_ring_dis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]
2026-10-02 feat(hardware): transfer-cut vinyl decals for the logo and the rear connector labels (tomassasovsky/segno#1090)
    hardware/decals/decals.py builds both from the design: the lid logo from the
    Fusion clone's segno_logo outlines (reference/segno_logo_lid.json, lid
    coordinates), and one rear strip of labels above the connectors plus the
    protective-earth symbol, placed from rear_io_layout() and laid out as seen
    from behind. Gates: every stroke and gap >= 0.6 mm for plotter cutting and
    weeding; no label within 2 mm of a hole, vent or flange. Outputs DXF/SVG/PDF
    at 1:1, a cut sheet for the vinyl shop and 1:1 placement templates.
    [segno_decal_logo.dxf, segno_decal_rear.dxf, segno_decals_cut_sheet.dxf]
2026-10-02 fix(hardware): decal templates draw the pill slots and pedal openings as cut (tomassasovsky/segno#1090)
    The logo placement template drew the pill slots as plain rectangles. The
    lid's metal allowance (60.4 x 6.4 R3.2 pill, Ø67.4 ring) moves into
    faceplate_metal_cuts(), used by both dxf_faceplate (output unchanged) and the
    decal templates, which now show stadium slots and only the real edges of the
    CLEAR/BANK openings.
    [segno_decal_logo.dxf, segno_decal_rear.dxf, segno_decals_cut_sheet.dxf]
2026-10-02 chore(hardware): simplify the decal logo outlines to 5 um (tomassasovsky/segno#1090)
    The Fusion export samples the logo far finer than any plotter resolves;
    simplifying to 0.005 mm (max deviation 0.005) halves the points and the files.
    [segno_decal_logo.dxf, segno_decal_rear.dxf, segno_decals_cut_sheet.dxf]
2026-10-02 feat(hardware): compact cut-sheet PDF for emailing the decals (tomassasovsky/segno#1090)
    [segno_decal_logo.dxf, segno_decal_rear.dxf, segno_decals_cut_sheet.dxf]
2026-10-02 fix(hardware): decals keep true curves from the type, not faceted outlines (tomassasovsky/segno#1090)
    The logo came from Fusion's sampled outlines and the labels from flattened
    glyphs, so the files were polylines. Now every outline is the type's own
    Bezier curves end to end: pathops removes overlaps (the segno slash crosses
    its S) without flattening; SVG and PDF carry curves, the DXF splines. The
    logo is the brand glyph SVG and Apple Chancery, each part placed on its
    Fusion segno_logo body: box centres match exactly, outlines within 0.04 mm
    for the glyph (s and n differ by up to 0.56 mm where Fusion's fitted letters
    bulge). Cut checks run on a 0.05 mm flattened copy; the earth symbol's bars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
    [segno_decal_logo.dxf, segno_decal_rear.dxf, segno_decals_cut_sheet.dxf]
2026-10-08 fix(hardware): conventional bending, front holes drilled through the seated lid (tomassasovsky/segno#1090)
    Dinacut quotes the job at more than twice July's price when the drawings
    ask for ±0.5 across a fold (precision forming). Their conventional press
    brake is ±0.7 (quote 4470, US$171 vs 4462, US$375).
    - Tolerance block: dimensions across a fold ±0.7 (plegado convencional).
    - Front lid screws: separately drilled holes can miss by 1.2-2 mm with
    three conventional folds in the stack, so Dinacut drills the pair
    together before welding: body clamped square, lid seated, Ø2.5 through
    the lid's Ø1.0 pilots into the wall, lid opened to Ø4.5. The body's
    front wall loses its nine laser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
    [segno_base.dxf, segno_base.step, segno_base_flat.dxf, segno_faceplate.dxf, segno_faceplate.step, segno_faceplate_flat.dxf]
2026-10-14 chore(appliance): remove what only the GTK and Pi OS paths used
    - segno-prof loses gsources and the GLib main-context reader; the
    recorder loses its GLib columns, samples the first io.flutter.ui
    thread, and sets aside a day file an earlier build started with other
    columns.
    - The Raspberry Pi OS kiosk kit goes (labwc, wlr-randr pinning,
    install/start scripts, the overlayfs notes, boot-integrity-check), and
    so does migrate-data.sh, the one-time /data re-layout.
    - seatd stays installed (libseat ships in the same package) but is not
    enabled: both views run with no_seat.
    - RUNNING_ON_LINUX.md goes; RUNNING_ON_RPI.md, APPLIANCE_INTEGRATION.md,
    HARDWARE_VALIDATION.md, PROGRESS.md and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
2026-10-14 fix(appliance): review fixes for the GTK cleanup
    - The recorder samples the io.flutter.ui thread with the lowest tid, not
    the first in text order (1003 sorts before 987), counts SCHED_RR as
    real-time, notes that the engine's unnamed native threads count as UI,
    and never overwrites a day file it set aside.
    - segno-prof's pointer-authentication comment no longer says the Pi 5
    signs return addresses.
    - The tomassasovsky/segno#1330 row goes with the PR that closes it; the touch-ctl docs list
    try and restore; the shopping list asks for an NVMe drive; the Yocto
    README names the Pi 4 hostname older images used.
2026-10-16 docs(hardware): V3 solder order and numbered images for all three boards
    Adds hardware/v3_soldering: a step-by-step solder order for the console v3,
    ring carrier and screen-power Rev P boards, one numbered image per board
    face with every part outlined in its step colour, its value, pin 1 and
    polarity marks, and KiCad 3D renders for reference. tools/build.sh
    regenerates the images from the KiCad files.
    Refs tomassasovsky/segno#1072
2026-10-16 feat(hardware): relief pockets free the console ring's snap arms
    Each snap arm hung 0.12 mm outside the cup wall for 13 of its 16 mm. That is
    far below the 0.3-0.5 mm an FDM print keeps open, so the arm would print
    fused to the wall and only the stub below it could bend. A pocket in the
    wall's outer face behind each arm now opens that gap to 0.6 mm from the roof
    to the wall's foot, leaving 1.12 mm of wall behind the strip. The cup loses
    129 mm3 and gains nothing; the arms, catches and board fit are unchanged.
    The printed 7in tower needs no notch: fully flexed, the arms stay 18.2 mm
    from it (they sit at 30/150/270 deg; the tower's nearest bearing is 90 deg).
    A test measures the flex envelope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
    [console_ring_assembly.step, console_ring_cup.step, console_ring_cup.stl]
2026-10-16 refactor(hardware): share the snap arm's radius and catch depth
    The flex envelope and the arm now read one CLIP_R_IN / CLIP_Z_BOT, so the
    tower test cannot drift from the real arm. MANUFACTURING gives the pocket's
    0.48 mm depth and the 0.6 mm gap it opens. Geometry unchanged.
    Refs tomassasovsky/segno#1075
2026-10-16 fix(hardware): size the console ring's encoder stack for the fitted ACZ11
    The ring carrier hangs from its encoder's shoulder. The model assumed a generic
    EC11 with the shoulder 4.585 mm above the board; the assembled carrier's
    Same Sky ACZ11 measures 6.39 mm (datasheet 6.5), with a 5.0 mm bushing and the
    shaft tip 26.5 mm above the board. Keeping the board, strip, catches and tower
    clearance where they were:
    - encoder spacer 3.5 -> 1.695 mm, from the measured shoulder to the seat top;
    0.2 mm of thread stays past a maximum 2.1 mm nut;
    - diffuser seat hole r 9.25 -> 9.9: the taller body's corners (r 9.32, +0.3
    drawing tolerance) would otherwise reach it;
    - knob pushed on to 1.0 mm above t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
    [console_ring_assembly.step, console_ring_diffuser.step, console_ring_diffuser.stl, console_ring_encoder_spacer.step, console_ring_encoder_spacer.stl]
2026-10-17 fix(hardware): print the console ring's snap arms as separate flat clips
    The arms molded on the cup stood up on the bed with their layers across the
    direction they bend, and on the first print they snapped along a layer line
    coming off the bed. They are now three separate clips, each one revolved
    profile with two flat end faces; a clip prints lying on one of them, 6.1 mm
    tall, so its layers run along the arm and bending stays inside each layer.
    Each clip's head slides radially into a slot through the cup's roof and wall
    top. The slot floor, 0.4 mm above the strip's edge, carries the board; the
    faceplate closes the slot's top (the head stops 0.1 mm short of it); a drop of
    glue keeps the clip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
    [console_ring_assembly.step, console_ring_carrier_clip.step, console_ring_carrier_clip.stl, console_ring_cup.step, console_ring_cup.stl]
2026-10-17 fix(hardware): one-piece snap arms strong enough to print on the cup
    The owner rejected separate clips; the arms go back on the cup. They print
    standing up, with their layers across the way they bend, and the first print's
    1.0 x 6 mm arms snapped along a layer line coming off the bed. The arms are now
    8 mm wide and taper from 1.8 mm at the root to 1.0 mm at the catch, about four
    times the root bending strength, with a 0.4 mm chamfer in the root's inside
    corner. The catch reaches 0.6 mm under the board instead of 1.0, so a full flex
    strains the root 0.45 % (the old arm: 0.68 %); clip_root_strain() computes it
    for the taper and check() caps it at 0.6 %.
    The arms now reach r 42.2, past the r 4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
    [console_ring_assembly.step, console_ring_carrier_clip.step, console_ring_carrier_clip.stl, console_ring_cup.step, console_ring_cup.stl]
2026-10-17 docs(hardware): the 15.6in screen's USB-C leads need a real ground wire
    On the first assembled console a donor cable that returned ground only
    through its shield made the 15.6in screen unstable. The J102 touch tail and
    the J103 power lead now require an insulated ground conductor, checked with a
    meter before cutting; shield-only donors stay allowed for the Pi host tails,
    whose VBUS carries only the presence current.
    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
    [external_bom.csv]
2026-10-17 fix(hardware): PD trigger requests the source's full current at 20 V (tomassasovsky/segno#1351)
    Set REQ_SRC_CURRENT in the STUSB4500 programming sketch. A 20 V / 4.7 A
    brick missed the 5 A PDO, matched the 3 A one and contracted only 3 A
    (60 W against a ~59 W worst case), read on the bench unit 2026-10-17.
    [stusb4500_pdo.ino]
2026-10-17 feat(console): provision the PD trigger and report its contract, with a power-cycle prompt (tomassasovsky/segno#1353)
    * feat(console): provision the PD trigger and report its contract, with a power-cycle prompt (tomassasovsky/segno#1352)
    Console firmware 2.3 writes the console profile into the STUSB4500's NVM
    at boot when it differs (REQ_SRC_CURRENT, 20 V PDOs at 3 and 5 A) and
    reports the live contract in a new PD_STATUS message after every hello
    (pedal-link protocol 12). The app shows the contract on the Controller
    page, raises a banner while a power cycle would raise it, adds an unplug
    line to Safe to switch off, and warns once per boot about a charger
    under 90 W.
    * chore(hardware): dro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
2026-10-20 docs(hardware): the console ring is the 35-LED strip ring (tomassasovsky/segno#1376)
    The owner settled the ring on 2026-10-19 (tomassasovsky/segno#1075): the 35-LED strip
    actually fitted, matching the ring firmware's RING_N. MANUFACTURING.md
    still called the strip ring a pending alternative, listed a 40-LED strip
    as the selected assembly and a 34-LED cup. The cup itself is resized in
    tomassasovsky/segno#1344.
2026-10-21 fix(hardware): move the console MODE footswitch to GP12 (tomassasovsky/segno#1388)
    Console board v3.1 routes SW_MODE to GP12 (Pico pad 16), where the
    reworked v3 board already has it and where the firmware reads it. The
    MODE header J13 takes the rightmost footswitch slot so the fan-out stays
    in pad order and uncrossed; designators, values and the BOM are
    unchanged. GP5 is left unconnected and J22 pin 3 becomes NC: the only
    path from pad 7 to J22 runs round the module's left end through the
    J3/J24 power bar, and no routing attempt with it came back clean.
    The board is re-placed and fully re-routed with route_console_board.sh,
    which now also refuses a DRC-clean attempt that fails the routed-b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
    [console.placed.kicad_pcb, segno_console_board.kicad_pcb, segno_console_board.step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]
2026-10-21 fix(hardware): protect the console footswitch inputs (tomassasovsky/segno#1391)
    Console board v3.2 puts a clamp and a series resistor between every
    footswitch header and its Pico GPIO. On v3 each header's pin 1 ran
    straight to the pin, and the first console lost GP5 that way (tomassasovsky/segno#1388).
    From the cable in: a PESD5V2S2UT clamp to GND at the connector (D2-D6,
    one dual part per two neighbouring inputs), a 1k 1206 resistor
    (R23-R32), then the existing 100 nF cap on the Pico side, where the
    1k and 100 nF filter the clamp's residual to about 20 mV at the pin.
    Press and release timing against the 32-86k internal pull-up is
    unchanged, and the 8 ms debounce stays. A new FSW_PROTECT ga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
    [console.placed.kicad_pcb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]
2026-10-21 fix(hardware): tighten the footswitch protection gates (tomassasovsky/segno#1391)
    Debounce caps follow the placed header like the protection parts, the
    protection placer refuses an odd header count by name, the leaky-TVS
    fixture lives in the self-test instead of the spec table, a new
    control proves the clamp-anode check bites, and R18's value check uses
    the shared value parser. Geometry and netlist are unchanged.
    [console_board.py, console_board_pcb.py]
2026-10-23 docs(hardware): a 35-LED strip fits the console ring cup as drawn (tomassasovsky/segno#1075)
2026-10-23 docs: reconcile hardware and engine docs with the code (tomassasovsky/segno#1414)
    * docs: reconcile hardware and engine docs with the code
    - Ring LED count: 35, per the owner's 2026-10-19 decision on tomassasovsky/segno#1075, in the
    shopping list, ring assembly guide, ring diffuser notes, enclosure design,
    kicad README, ring_board.py docstring and the combined BOM. The power
    budget stays sized for 40 and now says so. The ring cup CAD, FUSION_MODELS
    and MANUFACTURING's ring rows belong to PR tomassasovsky/segno#1344.
    - Console board v3 and Raspberry Pi 5 in the enclosure docstring and design
    notes (they still said v2 and Pi 4/5).
    - APPLIANCE_INTEGRATION: a dated note that the v3 fi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
    [segno_combined_bom_lcsc.csv]
2026-10-27 build: generate the cadquery outputs in CI instead of tracking them
    The enclosure, strip ring, pill housing, decal and ring diffuser outputs
    are rebuilt by hardware/build.sh. CI runs it on macOS (the decals use
    macOS system fonts), runs the hardware tests, uploads the outputs as the
    hardware-outputs artifact, and attaches them to a release on fab-* tags.
    The KiCad boards, Gerbers, fab archives and Fusion exports stay tracked:
    they need KiCad, Freerouting or Fusion 360 to rebuild.
    The decals and the silkscreen extractor read files from the app
    repository; copies of the Segno glyph and JetBrains Mono now live next to
    them. Links that pointed into the app repository now use its URLs.
    [console_ring_assembly.step, console_ring_bench_faceplate.step, console_ring_bench_faceplate.stl, console_ring_centre_cap.step, console_ring_centre_cap.stl, console_ring_cup.step, console_ring_cup.stl, console_ring_diffuser.step]
2026-10-27 docs(console): move the grounding and bonding scheme here from the app repository
    It was docs/design/console-grounding-and-bonding.md in tomassasovsky/segno.
    It describes the console board's chassis bond, so it belongs with the
    hardware that references it.
2026-10-27 chore: carry over the KiCad ignore rules from the app repository
2026-10-28 chore: license the hardware design under CERN-OHL-S-2.0
    The owner chose the CERN Open Hardware Licence v2, Strongly Reciprocal,
    for this repository after the split from tomassasovsky/segno. LICENSE now
    holds the official text from ohwr.org.
    The licence covers the design sources, including the generator scripts.
    The Arduino sketch and the DIN MIDI bench script are software and stay
    GPL-3.0-or-later (text moved to LICENSES/GPL-3.0.txt). KiCad, Seeed and
    Adafruit material, the JetBrains Mono font and two seller drawings keep
    their own terms; THIRD_PARTY.md lists each file. The README records that
    history before this commit was published under GPL-3.0-or-later.
2026-11-03 docs(hardware): wire an ambient light sensor to J22
    A TEPT5600 phototransistor from J22's +3V3 into a 2.2 kOhm load and 100 nF
    at the J22 end of a keyed lead, read on GP28. Covers the resistor choice
    against the unknown gain after sanding, where it saturates, how to measure
    and swap it, the calibration in the app, and the parts.
    Refs tomassasovsky/segno#1564
2026-11-03 feat(hardware): ambient light sensor window and sleeve in the lid (tomassasovsky/segno#1564)
    A Vishay TEPT5600 with its dome sanded off flat sits flush in a 5.55 mm
    window at spot A (u 321.857, v 385.0), midway between CLEAR and BANK on
    the logo's centre line. The window is sized like every other functional
    opening: the largest body (5.15) passes the smallest painted hole.
    A black PETG sleeve bonded to the lid underside carries the flange,
    hides the body from the light inside the console and holds the lead
    with a cable tie. It prints bond face down without supports and ships
    in the 3D-print package.
    The Fusion clone carries the window and the sleeve (version 31); the
    formed faceplate is re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
    [segno_faceplate.step, segno_faceplate_flat.dxf]
2026-11-03 docs(hardware): the ALS load resistor can sit at either end of the lead (tomassasovsky/segno#1564)
2026-11-03 fix(hardware): ALS window keeps the 0.20 fit, seat sized for the shortest sensor (tomassasovsky/segno#1564)
    Review fixes:
    - Window O5.55 -> O5.75: the smallest painted hole now clears the largest
    TEPT5600 body by the same 0.20 fit as every other functional opening,
    which is also the room the epoxy ring needs.
    - Seat 2.89 -> 2.70, sized for the shortest sanded sensor in the thickest
    painted lid, so face-down assembly always sets the face flush and the
    epoxy line under the sleeve takes up the rest (0.05-0.5 mm).
    - The tie slot runs along the lead (1.6 x 3.0), so a 2.5 mm tie wraps
    the lead instead of twisting.
    - A generator test keeps the sleeve above the power group and inside the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
    [segno_faceplate.step, segno_faceplate_flat.dxf]
2026-11-03 fix(hardware): ALS sleeve bores and face-down bonding that the parts can actually do (tomassasovsky/segno#1564)
    Review round 2:
    - Face down, the sleeve sits on the lid and the flange floats 0-0.45 mm
    above its seat, so the flange beds in epoxy there; the notes, the
    constants (ALS_GLUE is the 0.05 line, ALS_FLANGE_GAP the bedded gap)
    and the Fusion placement now say so.
    - Epoxy stays off the body during face-down bonding, an M5 nut keeps
    the face on the film, and the window ring is filled from the top with
    the face masked.
    - Bores 5.45/6.3 clear an FDM hole printing 0.2 under size; ream if not.
    - Accept a sanded sensor only at 4.95 mm or more from face to flange.
    - Leads cut to 6 mm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
2026-11-03 docs(hardware): sensor lead review fixes
    A 100 ohm resistor in the lead's +3V3 wire guards the Pi's rail against a
    short to the faceplate. The top of the range is 3500 counts, since the
    collector runs from the Pi's 3V3 and the ADC from the Pico's. Corrects the
    bin A row, the reverse-wiring warning, the keying (glue the blocked cavity,
    seat fully), the measure-and-swap steps and example, the calibration steps
    (firmware 2.7, Automatic, the 2x rule), the dark brightness wording, and lists
    the full E12 swap set.
    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
