tomassasovsky/segno-hardware/(notices)

Notices in the files:
hardware/kicad/screen_power/models/C_Disc_D7.5mm_W4.4mm_P5.00mm.step:
Copyright (C) 2017, kicad StepUp
This program is free software: you can redistribute it and/or modify
it under the terms of the GNU General Public License as published by
the Free Software Foundation, either version 3 of the License, or
any later version.
itself might be covered by the GNU General Public License.
hardware/kicad/screen_power/models/JST_XH_B2B-XH-A_1x02_P2.50mm_Vertical.step:
Copyright (C) 2019, Rene Poeschl
This work is licensed under the [Creative Commons CC-BY-SA 4.0 License](https://creativecommons.org/licenses/by-sa/4.0/legalcode),
with the following exception:
To the extent that the creation of electronic designs that use 'Licensed Material' can be considered to be 'Adapted Material',
You are free to use the library data in your own projects without the obligation to share your project files under this or any other license agreement.
parts and their libraries:
XIAO_Module.step is therefore vendored from github.com/Tircown/ERCF-easy-brd (Kicad/ercf-easy-brd.pretty/packages3d/Seeeduino Xiao.step), which is GPL-3.0 and so compatible with this repo.
